acevedocrisologopablo48-lgtm/planta-briquetadora/README.md

# PLANTA BRIQUETADORA · R17

Configurador industrial SESUVECA. R17 incorpora refuerzos geométricos, despieces, BOM conciliada, transmisiones auxiliares, dosificación de diseño y esquema eléctrico funcional.

Emisión desarrollada para revisión de taller. No hay aprobación resistente, eléctrica o de fabricación emitida. Los componentes OEM se conservan; la alternativa15HP/i25 no sustituye la prensa original45kW/8rpm.

Base de diseño:15t/h de carbón seco; agua3–5% y aglomerante2–4%. Son consignas adoptadas, no capacidad comprobada.

Los borradores y revisiones R4–R16 se conservan. Descargas de referencia en r17/: BOM_R17.csv, DOSSIER_R17.pdf, TALLER_R17.dxf y UNIFILAR_R17.svg.

Los datos de usuario se guardan en el navegador; descargarJSON sirve como respaldo.
