acevedocrisologopablo48-lgtm/planta-briquetadora/r32/PLANTA_R32.pdf

## SESUVECA / PLANTA BRIQUETADORA

### DISPOSICION Y ALTURAS

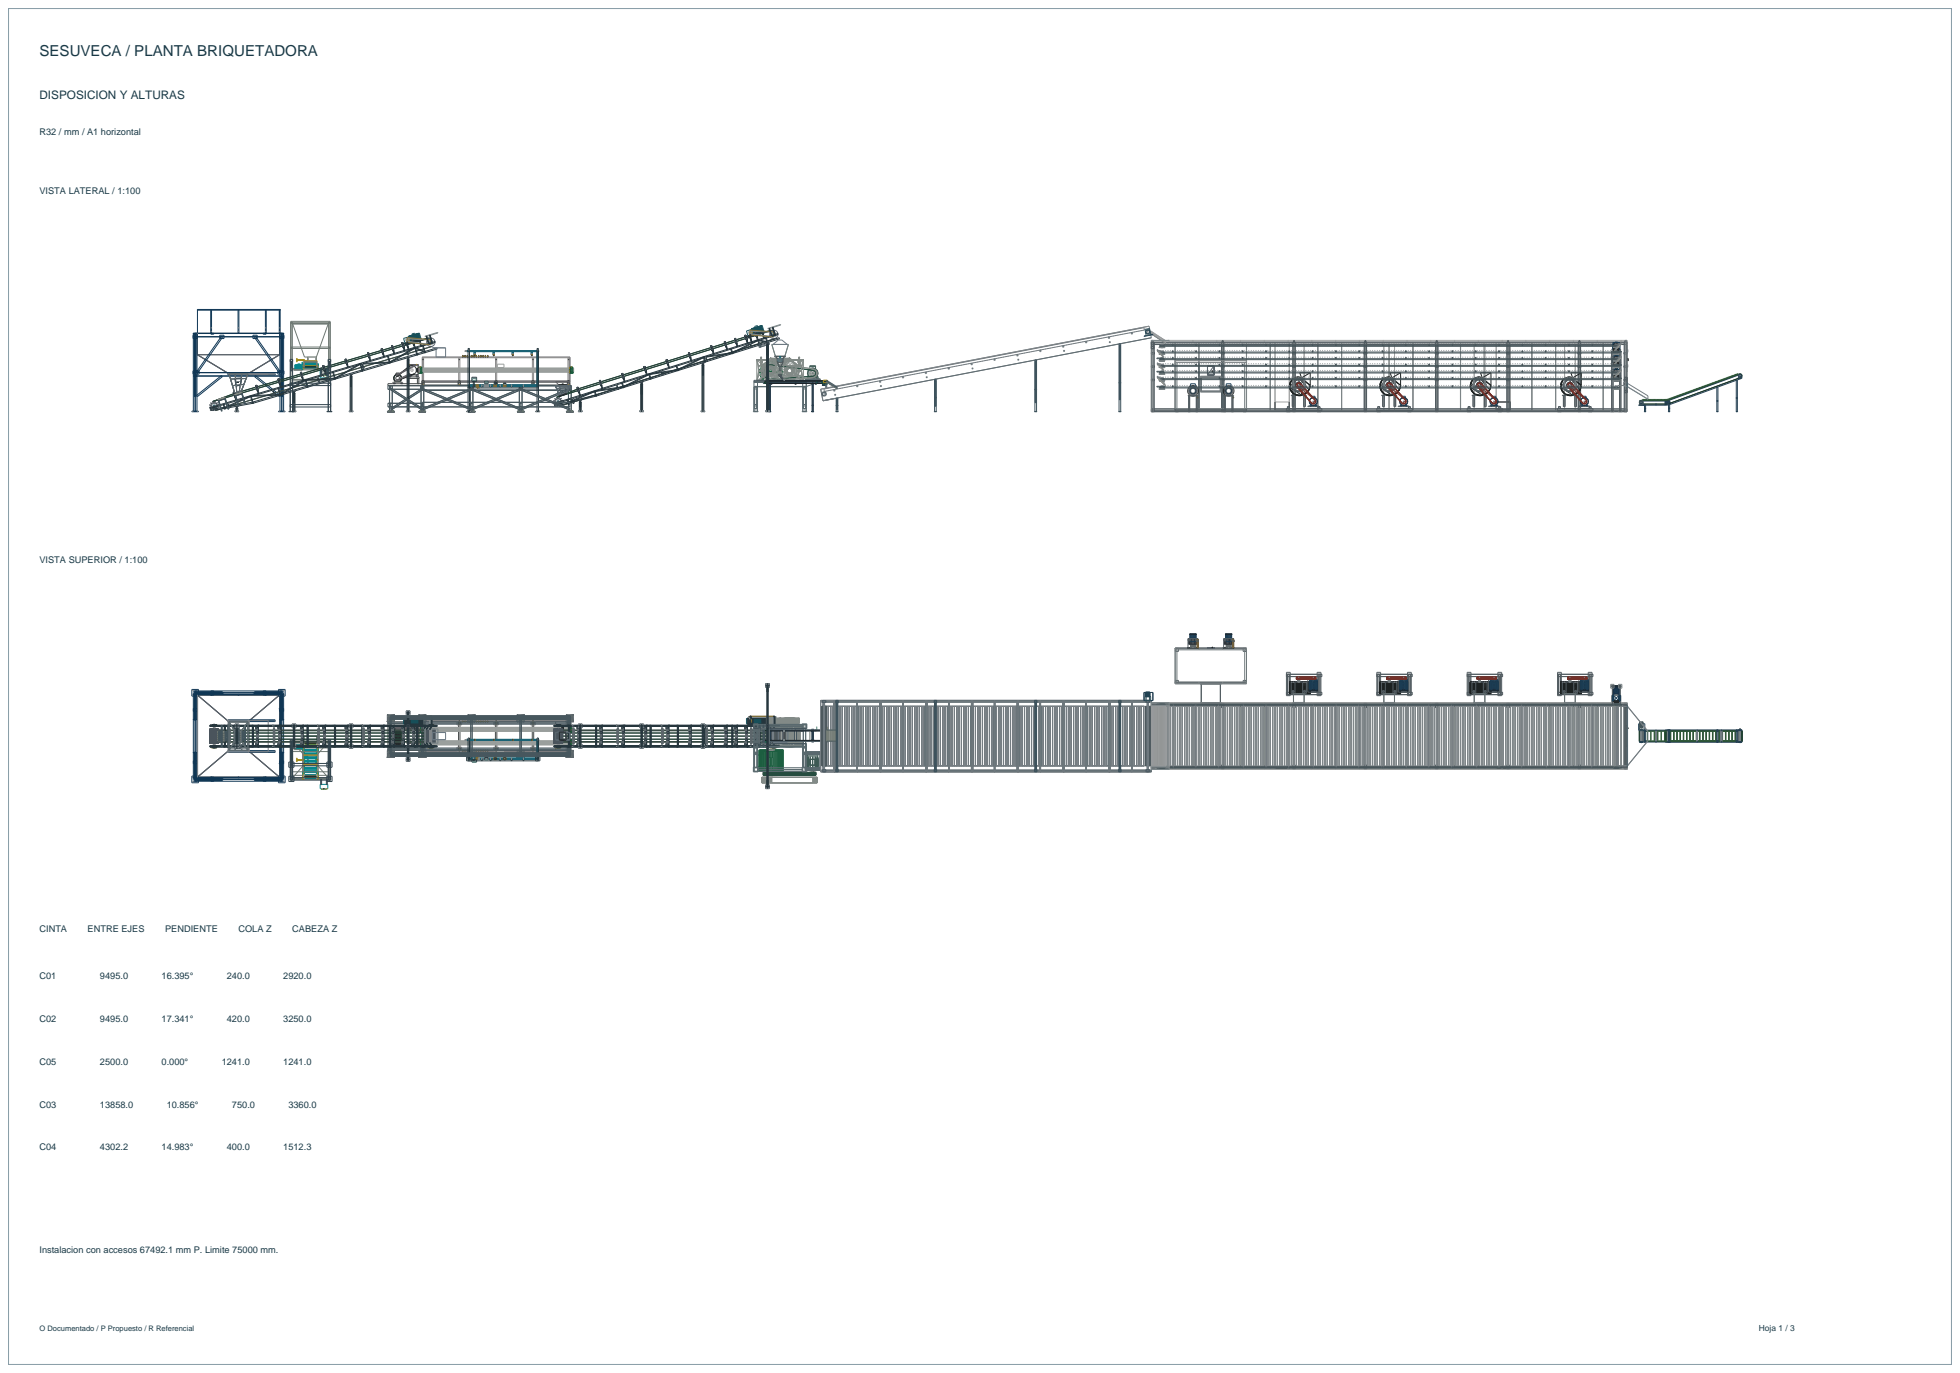
[picture p1: page 1]

Instalacion con accesos 67492.1 mm P. Limite 75000 mm.

### TRANSFERENCIAS DE MATERIAL

R32 / mm / A1 horizontal

ENTRADA DE MEZCLADORA / 1:35 | COLECTORA C05 / C03 / 1:10

C01-mix / origen +2685.0 / receptor +2300.0 / desnivel 385.0 mm P

mix-C02 / origen +1085.0 / receptor +691.2 / desnivel 393.8 mm P

C02-briq / origen +3015.0 / receptor +2830.0 / desnivel 185.0 mm P

C05-C03 / origen +1267.5 / receptor +957.3 / desnivel 310.2 mm P

C03-dry / origen +3368.7 / receptor +2850.0 / desnivel 518.7 mm P

dry-C04 / origen +529.0 / receptor +481.0 / desnivel 48.0 mm P

C05-C03 / captura a 14.5 mm del desprendimiento / labio 12.0 mm sobre banda P.

### APOYOS VERTICALES

R32 / mm / A1 horizontal

C01 / APOYO TRANSVERSAL / 1:20 | C02 / APOYO TRANSVERSAL / 1:20
C03 / APOYO TRANSVERSAL / 1:20 | C04 / APOYO TRANSVERSAL / 1:20

Columnas paralelas a Z global. Placas apoyadas en Z=0. Cuatro caballetes arriostrados en C03.
