acevedocrisologopablo48-lgtm/planta-briquetadora/r30/PLANTA_R30.pdf

SESUVECA | PLANTA BRIQUETADORA

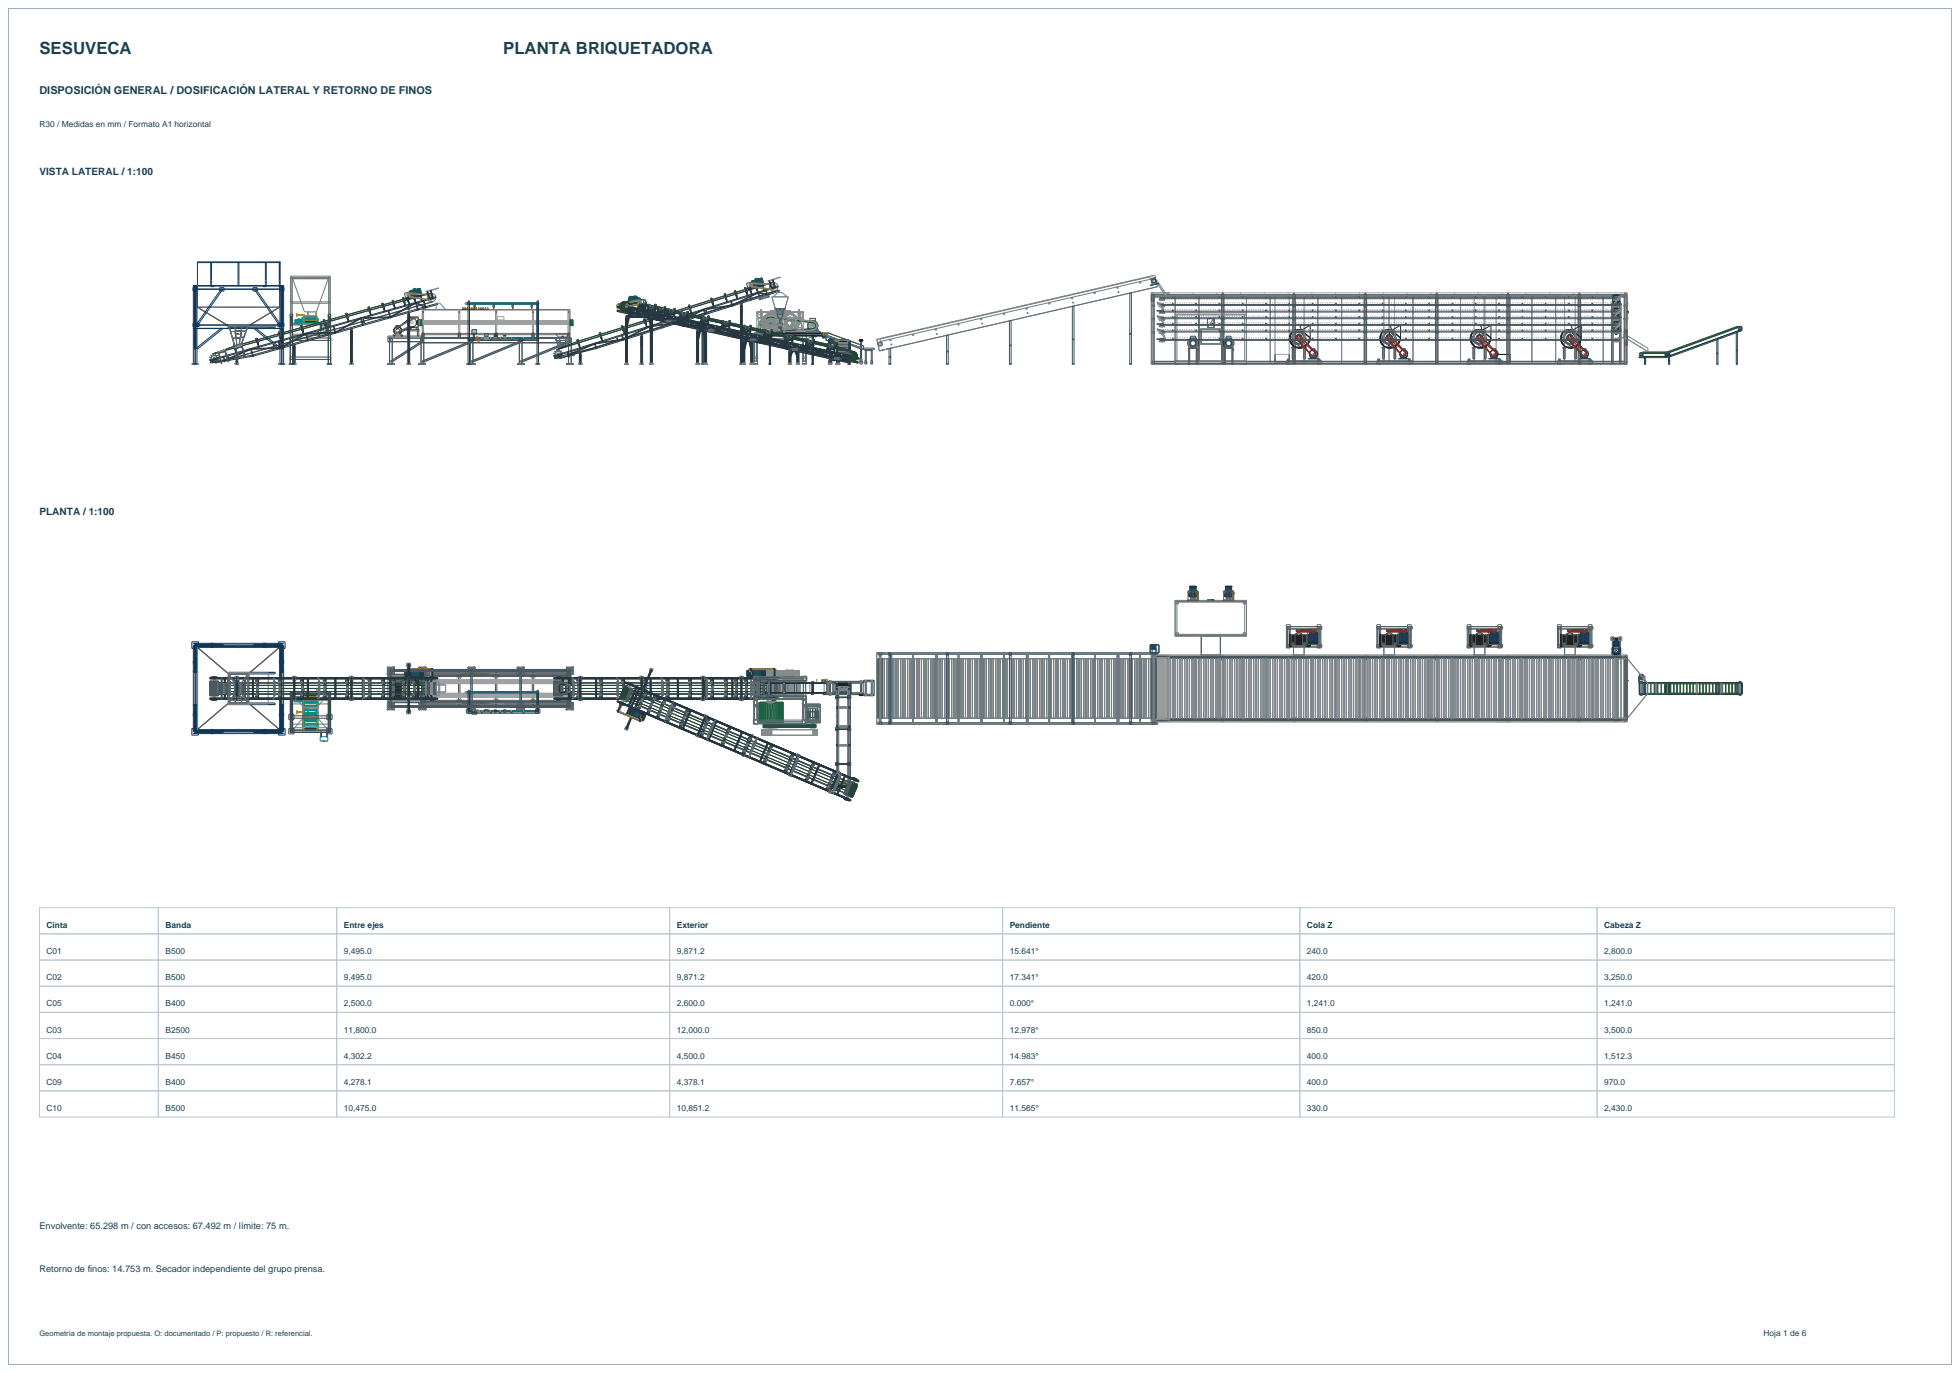
[picture p9: page 1]

DISPOSICIÓN GENERAL / DOSIFICACIÓN LATERAL Y RETORNO DE FINOS

R30 / Medidas en mm / Formato A1 horizontal

Envolvente: 65.298 m / con accesos: 67.492 m / límite: 75 m.

Retorno de finos: 14.753 m. Secador independiente del grupo prensa.

### TOLVA ABIERTA Y DOSIFICADOR LATERAL / DESCARGA DIRECTA

R30 / Medidas en mm / Formato A1 horizontal

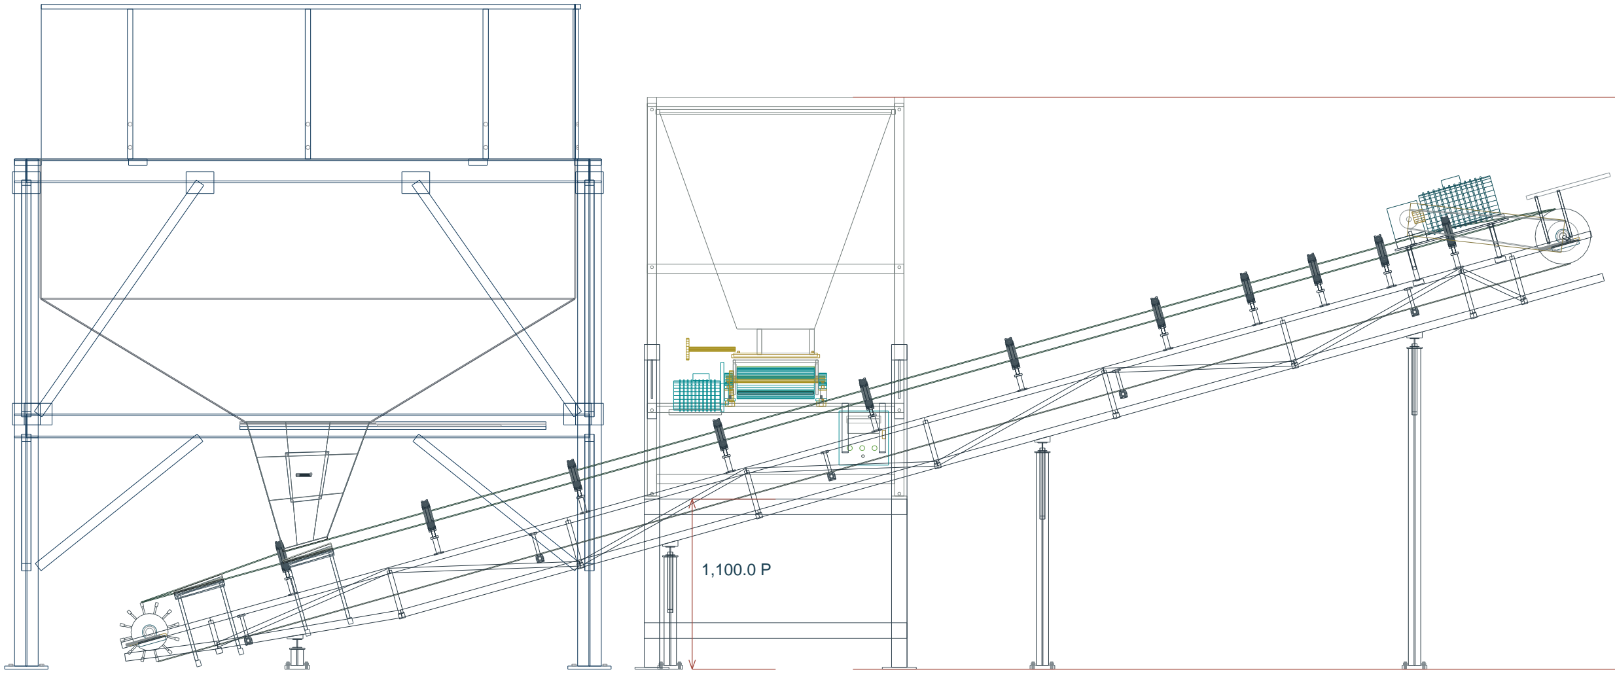
[picture p10: figure]

Geometría de montaje propuesta. O: documentado / P: propuesto / R: referencial. | Hoja 2 de 6

ALZADO LONGITUDINAL / 1:30

3,700.0 P

ALZADO TRANSVERSAL / 1:20

3450 O

Dosificador: X = 5,100.0 / Y = -1,000.0 / giro 180°.
Bancada lateral con ménsulas y cartelas. Los apoyos delanteros inferiores se adaptan para liberar C01.
Se conservan tolva, banda, accionamiento y células de pesaje. Tablero completo reubicado hacia el exterior. Salida propia: +1,775.0 / superficie C01: +1,576.4 / desnivel: 198.6 mm.
Descarga transversal directa. No se añade otra cinta ni una transición rígida entre equipos.

Tolva: boca 3450 x 3450 mm; salida y estructura de R26 conservadas.
Apertura superior de 1000 mm en el lado -X, contrario al avance de C01.
Remate de borde abierto: +3300 mm. Las otras tres paredes superiores llegan a +4300 mm. Retirar panel, rigidizadores y tornillería asociados únicamente al lado abierto.
Mantener acceso exterior al tablero y a la regulación del dosificador.

### PANEL RANURADO DESMONTABLE / CAPTACIÓN BAJO EL BAJANTE

R30 / Medidas en mm / Formato A1 horizontal


Geometría de montaje propuesta. O: documentado / P: propuesto / R: referencial. | Hoja 3 de 6

VISTA NORMAL AL PANEL / 1:2

BAJANTE Y CAPTACIÓN / LATERAL / 1:5

1. Panel de acero inoxidable 304, espesor 6 mm.
2. 96 ranuras longitudinales de 5 x 150 mm; extremos R2,5.
3. 24 columnas, separación libre de 10 mm; cuatro tramos con puentes de 30 mm.
4. Márgenes: 25 mm laterales y 55 mm en los extremos.
5. Bordes desbarbados y superficie enrasada. Fijación desmontable fuera del paso de producto.

El panel ocupa los tramos 250 a 1050 mm del bajante, medidos sobre el plano de 20°. La nariz curva y los tramos lisos de entrada y salida permanecen.
Captación abierta bajo las ranuras: retirar chapa y revestimiento ciegos en esa zona. Salida inferior: 300 x 200 mm, a +540 mm. Acople desmontable hacia C09.
Panel pasivo, sin vibrador. Abertura propuesta; no implica separación completa garantizada.

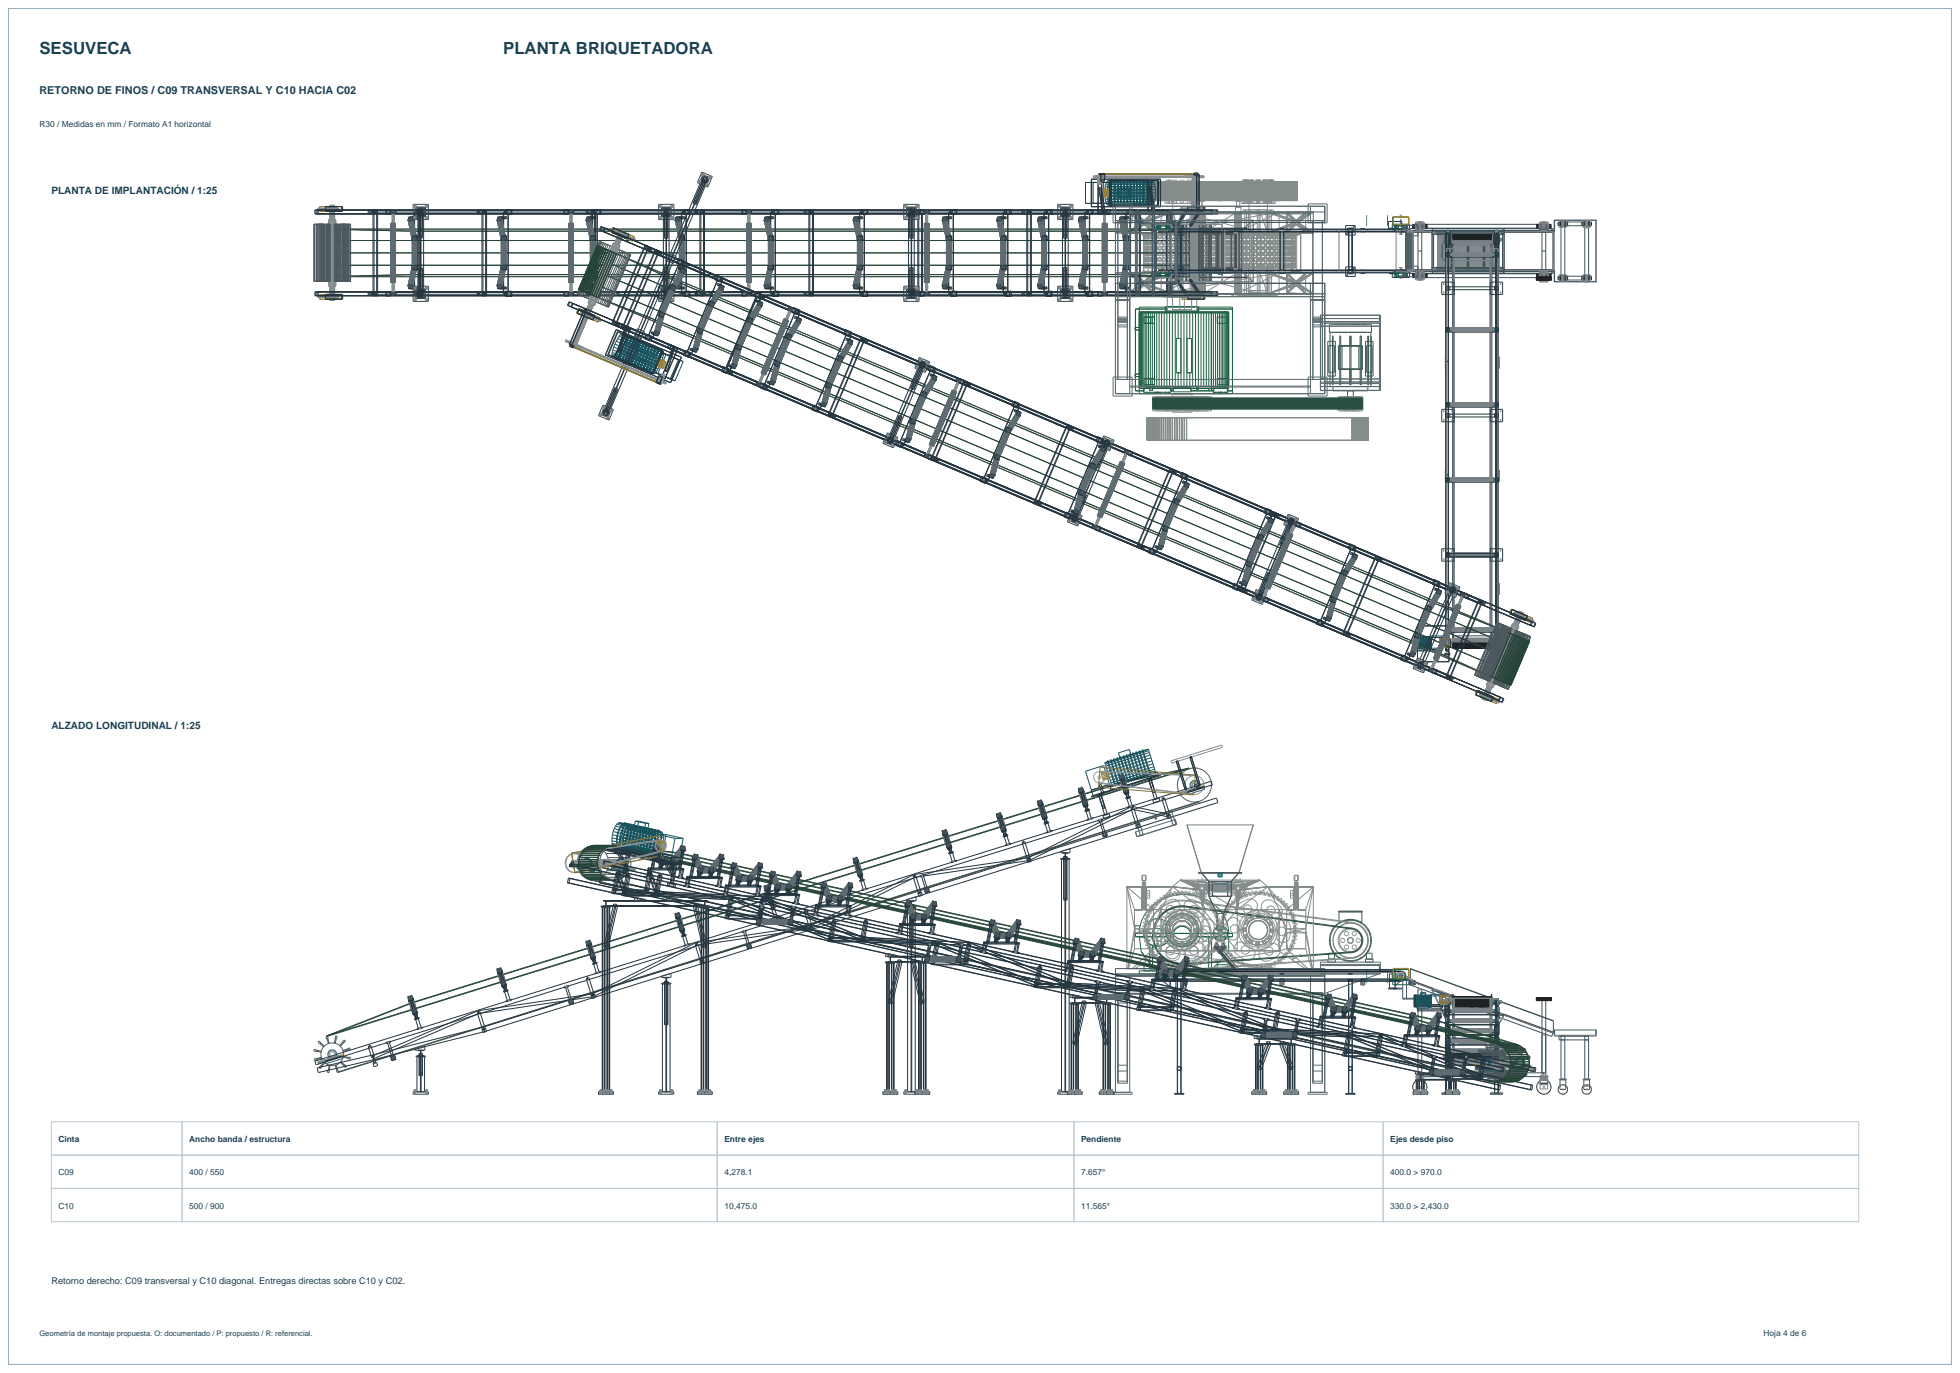
[picture p11: page 4]

RETORNO DE FINOS / C09 TRANSVERSAL Y C10 HACIA C02

R30 / Medidas en mm / Formato A1 horizontal

Retorno derecho: C09 transversal y C10 diagonal. Entregas directas sobre C10 y C02.

### TRANSFERENCIAS Y OPERACIÓN / REFERENCIAS DE MONTAJE

R30 / Medidas en mm / Formato A1 horizontal

Geometría de montaje propuesta. O: documentado / P: propuesto / R: referencial. | Hoja 5 de 6
Encuentro | Referencia geométrica
Salida dosificador / C01 | 1,775.0 > 1,576.4 / descenso 198.6 mm
Captación / C09 | 70.4 mm de descenso
C09 / C10 | 404.8 mm de descenso
C10 / C02 | 1,111.4 mm de descenso
Bajante | 20° / recorrido 1600 mm / panel 800 x 400 x 6 mm
C01 y C02 | 9495 mm entre ejes, longitudes conservadas

RECETA SOBRE CARBÓN NUEVO

Carbón de referencia: 15.000 t/h. Aglomerante: 450.0 kg/h. Agua: 10.0 L/min.

Los finos recuperados vuelven a C02 sin dosificación automática adicional de agua ni aglomerante.

ARRANQUE DEL RETORNO

Con C02 disponible: arrancar C10 y después C09. Una parada del retorno bloquea la alimentación que genera nuevos finos.

La simulación muestra una fracción ilustrativa de finos cruzando las ranuras y regresando a la prensa. No representa un rendimiento de separación ni una capacidad de producción medida.

Se conservan las alternativas anteriores; los valores de esta carpeta corresponden a la geometría R30.

### SECADOR / TRANSPORTADORES PROPIOS

R30 / Medidas en mm / Formato A1 horizontal

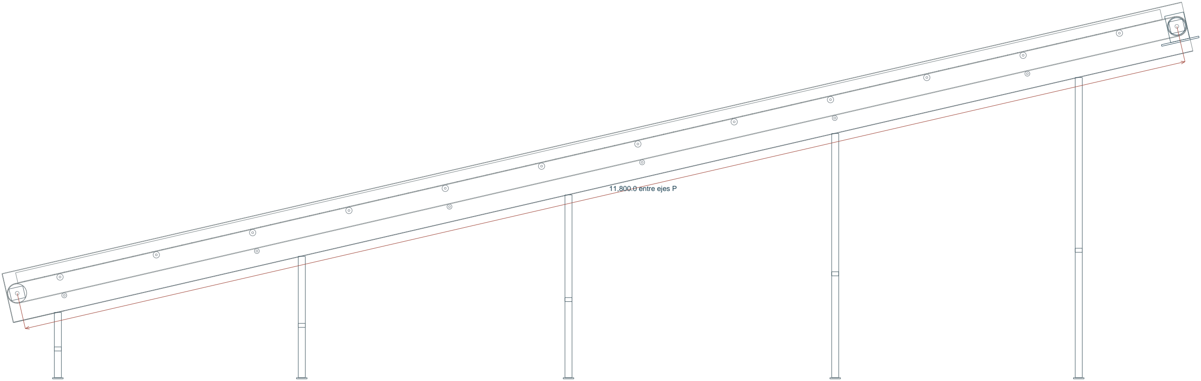
[picture p12: figure]
11,800.0 entre ejes P
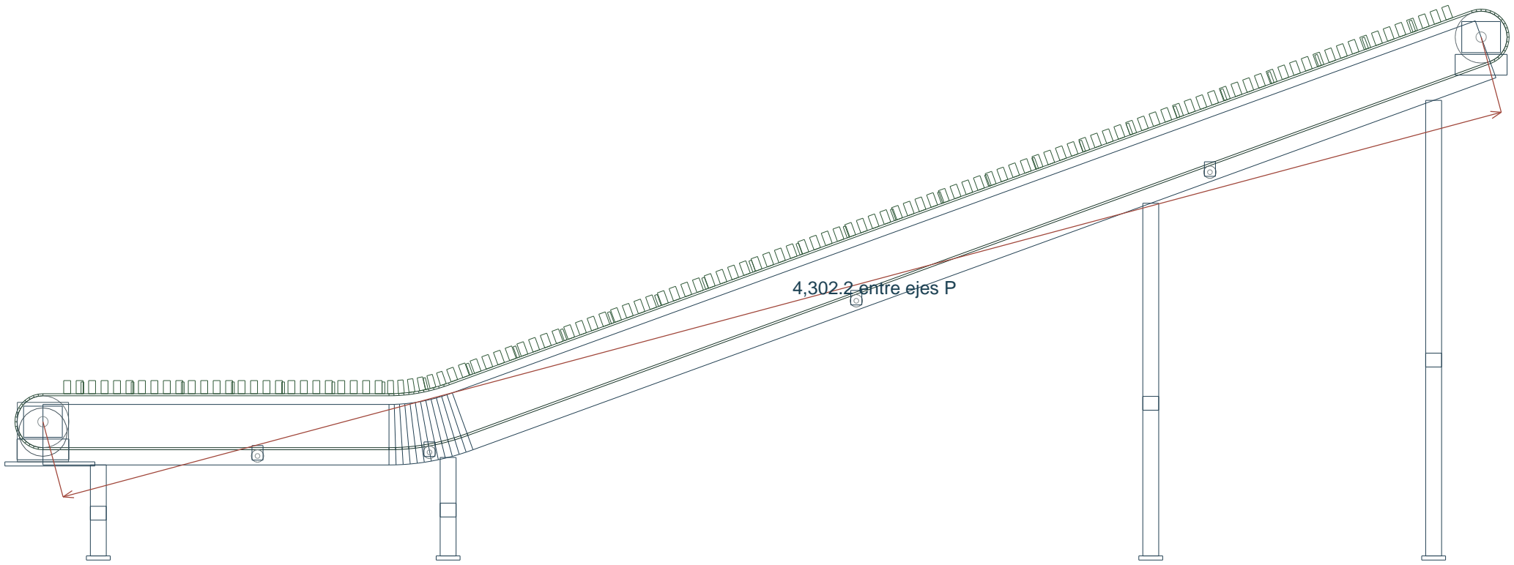
[picture p13: figure]
4,302.2 entre ejes P

Geometría de montaje propuesta. O: documentado / P: propuesto / R: referencial. | Hoja 6 de 6

### C03 · CARGA DE MALLA INOXIDABLE / ALZADO 1:20

Envolvente nominal de ficha: 12 000 × 3 000 × 500 mm. Malla útil de 2 500 mm.

### C04 · DESCARGA LONGITUDINAL / ALZADO 1:15

Envolvente nominal de ficha: 4 500 × 500 × 400 mm.

Desarrollo entre ejes: 4,350.0 mm. Banda útil: 450 mm.

Recepción horizontal y tramo inclinado a 20.0° P.

Caída del labio a la banda: 48.0 mm. Holgura a perfiles: 6.0 mm P.

Canal convergente para la salida del secador. Abertura de paso por comprobar.
