acevedocrisologopablo48-lgtm/planta-briquetadora/r29/PLANTA_R29.pdf

SESUVECA | PLANTA BRIQUETADORA

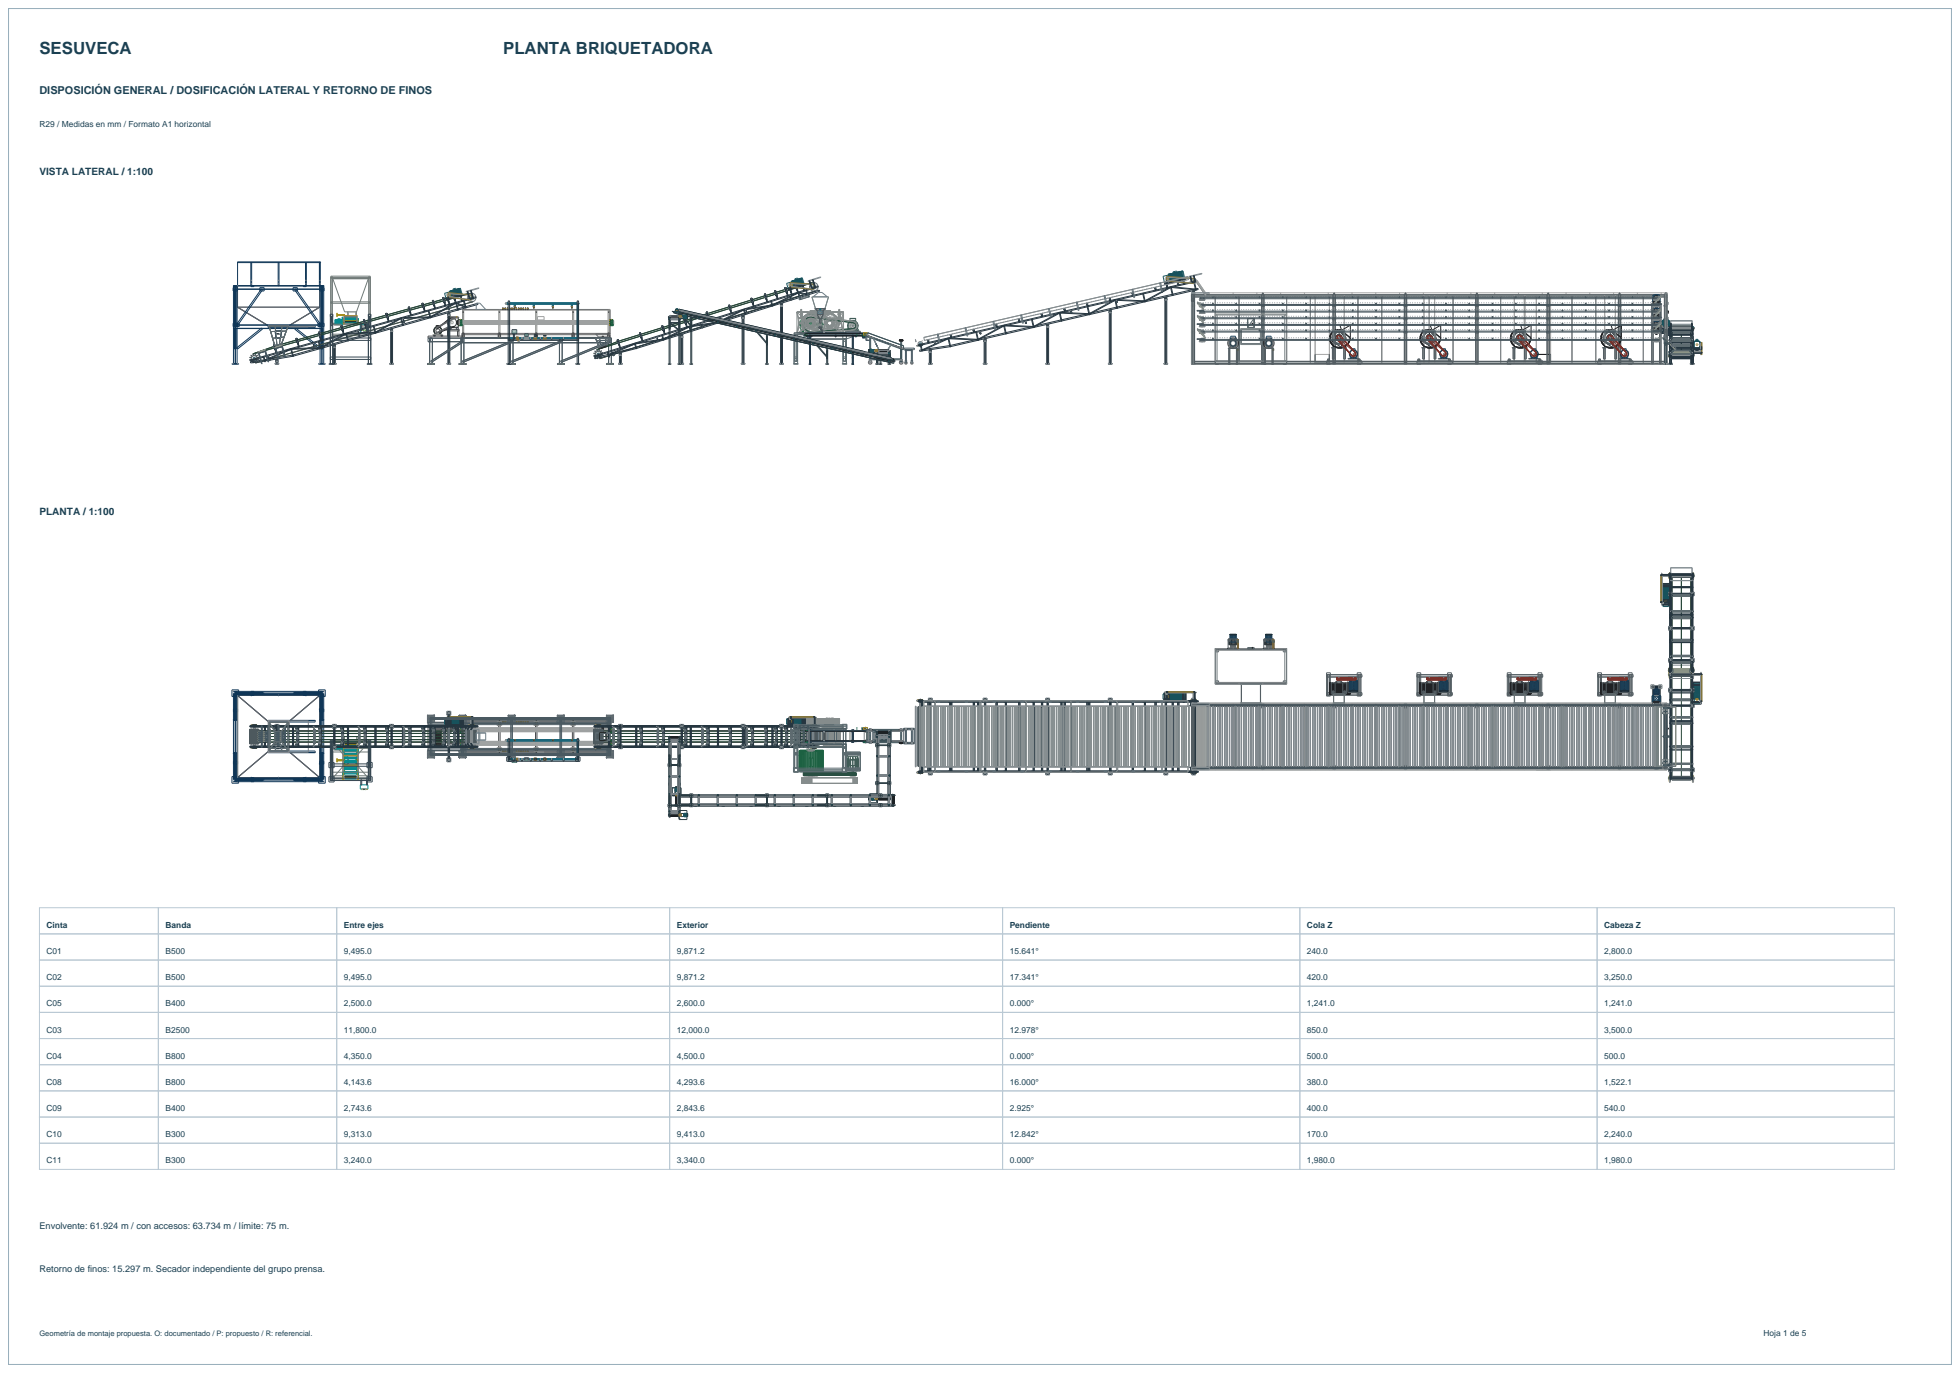
[picture p14: page 1]

DISPOSICIÓN GENERAL / DOSIFICACIÓN LATERAL Y RETORNO DE FINOS

R29 / Medidas en mm / Formato A1 horizontal

Envolvente: 61.924 m / con accesos: 63.734 m / límite: 75 m.

Retorno de finos: 15.297 m. Secador independiente del grupo prensa.

### TOLVA ABIERTA Y DOSIFICADOR LATERAL / DESCARGA DIRECTA

R29 / Medidas en mm / Formato A1 horizontal

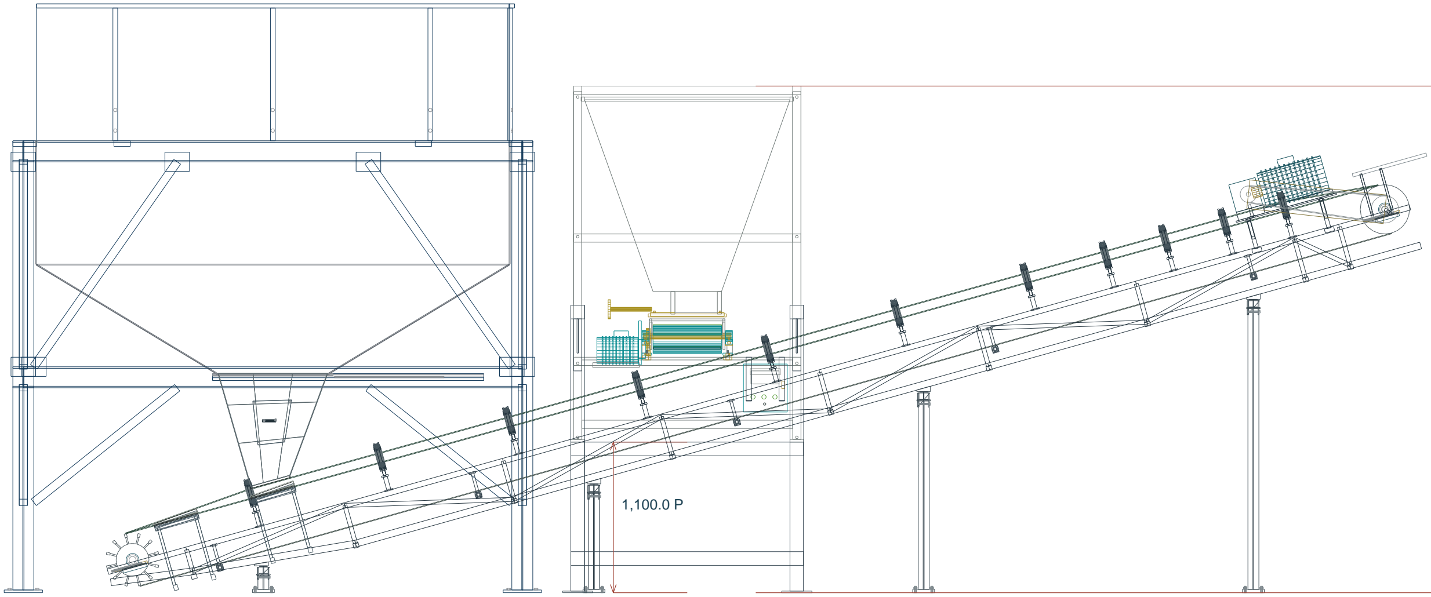
[picture p15: figure]

Geometría de montaje propuesta. O: documentado / P: propuesto / R: referencial. | Hoja 2 de 5

ALZADO LONGITUDINAL / 1:30

3,700.0 P

ALZADO TRANSVERSAL / 1:20

3450 O

Dosificador: X = 5,100.0 / Y = -1,000.0 / giro 180°.
Bancada lateral con ménsulas y cartelas. Los apoyos delanteros inferiores se adaptan para liberar C01.
Se conservan tolva, banda, accionamiento y células de pesaje. Tablero completo reubicado hacia el exterior. Salida propia: +1,775.0 / superficie C01: +1,576.4 / desnivel: 198.6 mm.
Descarga transversal directa. No se añade otra cinta ni una transición rígida entre equipos.

Tolva: boca 3450 x 3450 mm; salida y estructura de R26 conservadas.
Apertura superior de 1000 mm en el lado -X, contrario al avance de C01.
Remate de borde abierto: +3300 mm. Las otras tres paredes superiores llegan a +4300 mm. Retirar panel, rigidizadores y tornillería asociados únicamente al lado abierto.
Mantener acceso exterior al tablero y a la regulación del dosificador.

### PANEL RANURADO DESMONTABLE / CAPTACIÓN BAJO EL BAJANTE

R29 / Medidas en mm / Formato A1 horizontal


Geometría de montaje propuesta. O: documentado / P: propuesto / R: referencial. | Hoja 3 de 5

VISTA NORMAL AL PANEL / 1:2

BAJANTE Y CAPTACIÓN / LATERAL / 1:5

1. Panel de acero inoxidable 304, espesor 6 mm.
2. 96 ranuras longitudinales de 5 x 150 mm; extremos R2,5.
3. 24 columnas, separación libre de 10 mm; cuatro tramos con puentes de 30 mm.
4. Márgenes: 25 mm laterales y 55 mm en los extremos.
5. Bordes desbarbados y superficie enrasada. Fijación desmontable fuera del paso de producto.

El panel ocupa los tramos 250 a 1050 mm del bajante, medidos sobre el plano de 20°. La nariz curva y los tramos lisos de entrada y salida permanecen.
Captación abierta bajo las ranuras: retirar chapa y revestimiento ciegos en esa zona. Salida inferior: 300 x 200 mm, a +540 mm. Acople desmontable hacia C09.
Panel pasivo, sin vibrador. Abertura propuesta; no implica separación completa garantizada.

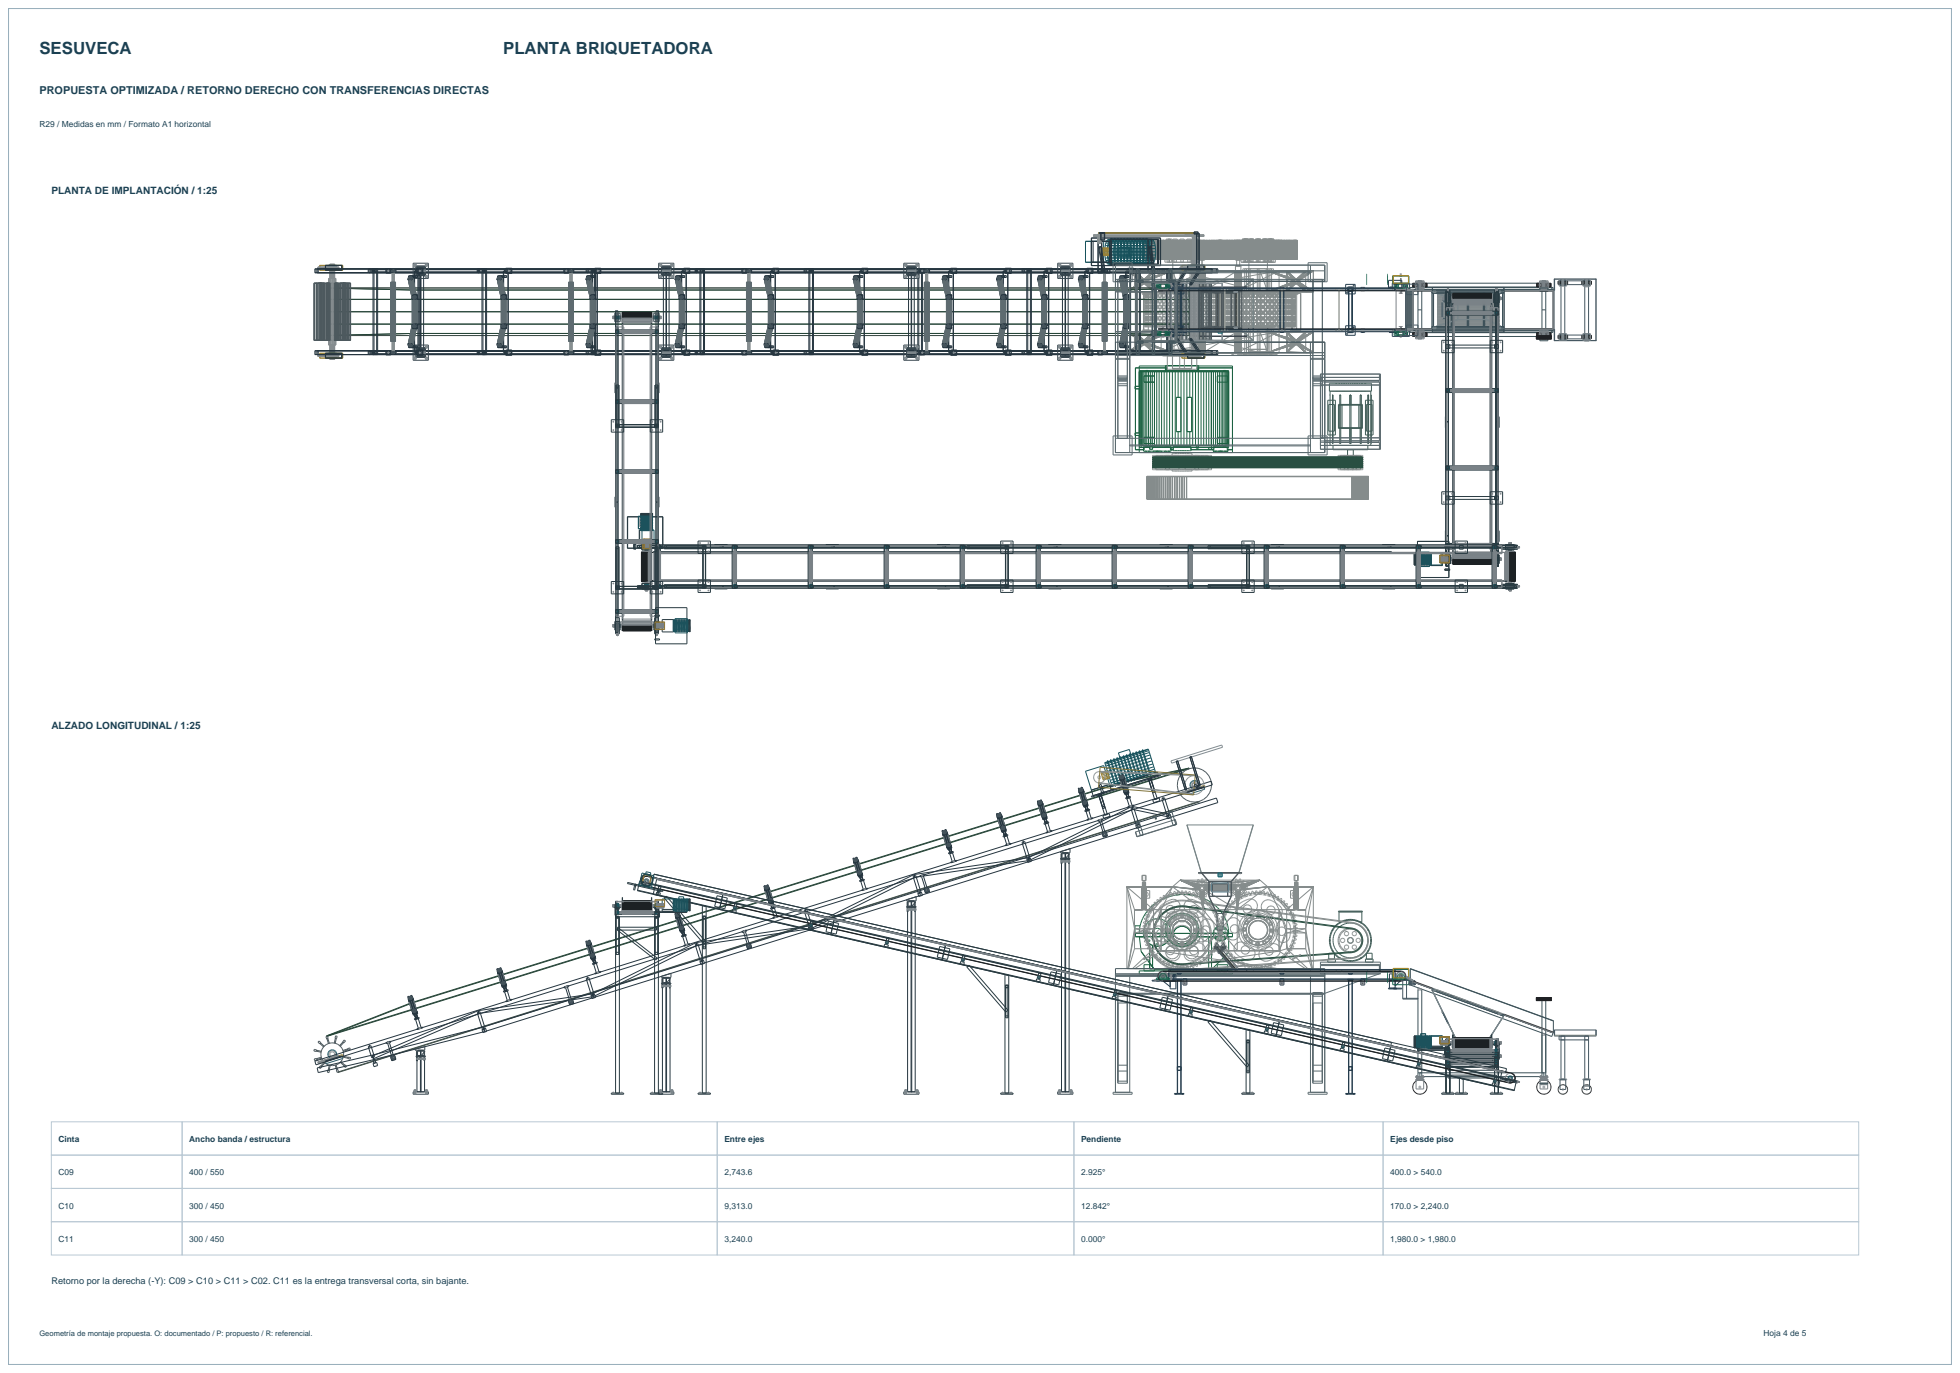
[picture p16: page 4]

PROPUESTA OPTIMIZADA / RETORNO DERECHO CON TRANSFERENCIAS DIRECTAS

R29 / Medidas en mm / Formato A1 horizontal

Retorno por la derecha (-Y): C09 > C10 > C11 > C02. C11 es la entrega transversal corta, sin bajante.

### TRANSFERENCIAS Y OPERACIÓN / REFERENCIAS DE MONTAJE

R29 / Medidas en mm / Formato A1 horizontal

Geometría de montaje propuesta. O: documentado / P: propuesto / R: referencial. | Hoja 5 de 5
Encuentro | Referencia geométrica
Salida dosificador / C01 | 1,775.0 > 1,576.4 / descenso 198.6 mm
Captación / C09 | 80.8 mm de descenso
C09 / C10 | 253.3 mm de descenso
C10 / C11 | 243.0 mm / directa
C11 / C02 | 380.5 mm / directa
Bajante | 20° / recorrido 1600 mm / panel 800 x 400 x 6 mm
C01 y C02 | 9495 mm entre ejes, longitudes conservadas

RECETA SOBRE CARBÓN NUEVO

Carbón de referencia: 15.000 t/h. Aglomerante: 450.0 kg/h. Agua: 10.0 L/min.

Los finos recuperados vuelven a C02 sin dosificación automática adicional de agua ni aglomerante.

ARRANQUE DEL RETORNO

Con C02 disponible: C11 > C10 > C09. Si el retorno se detiene, se bloquea la alimentación nueva.

La simulación muestra una fracción ilustrativa de finos cruzando las ranuras y regresando a la prensa. No representa un rendimiento de separación ni una capacidad de producción medida.

Se conservan las alternativas anteriores; los valores de esta carpeta corresponden a la geometría R29.
