acevedocrisologopablo48-lgtm/planta-briquetadora/r27/PLANTA_R27.pdf

SESUVECA | PLANTA BRIQUETADORA

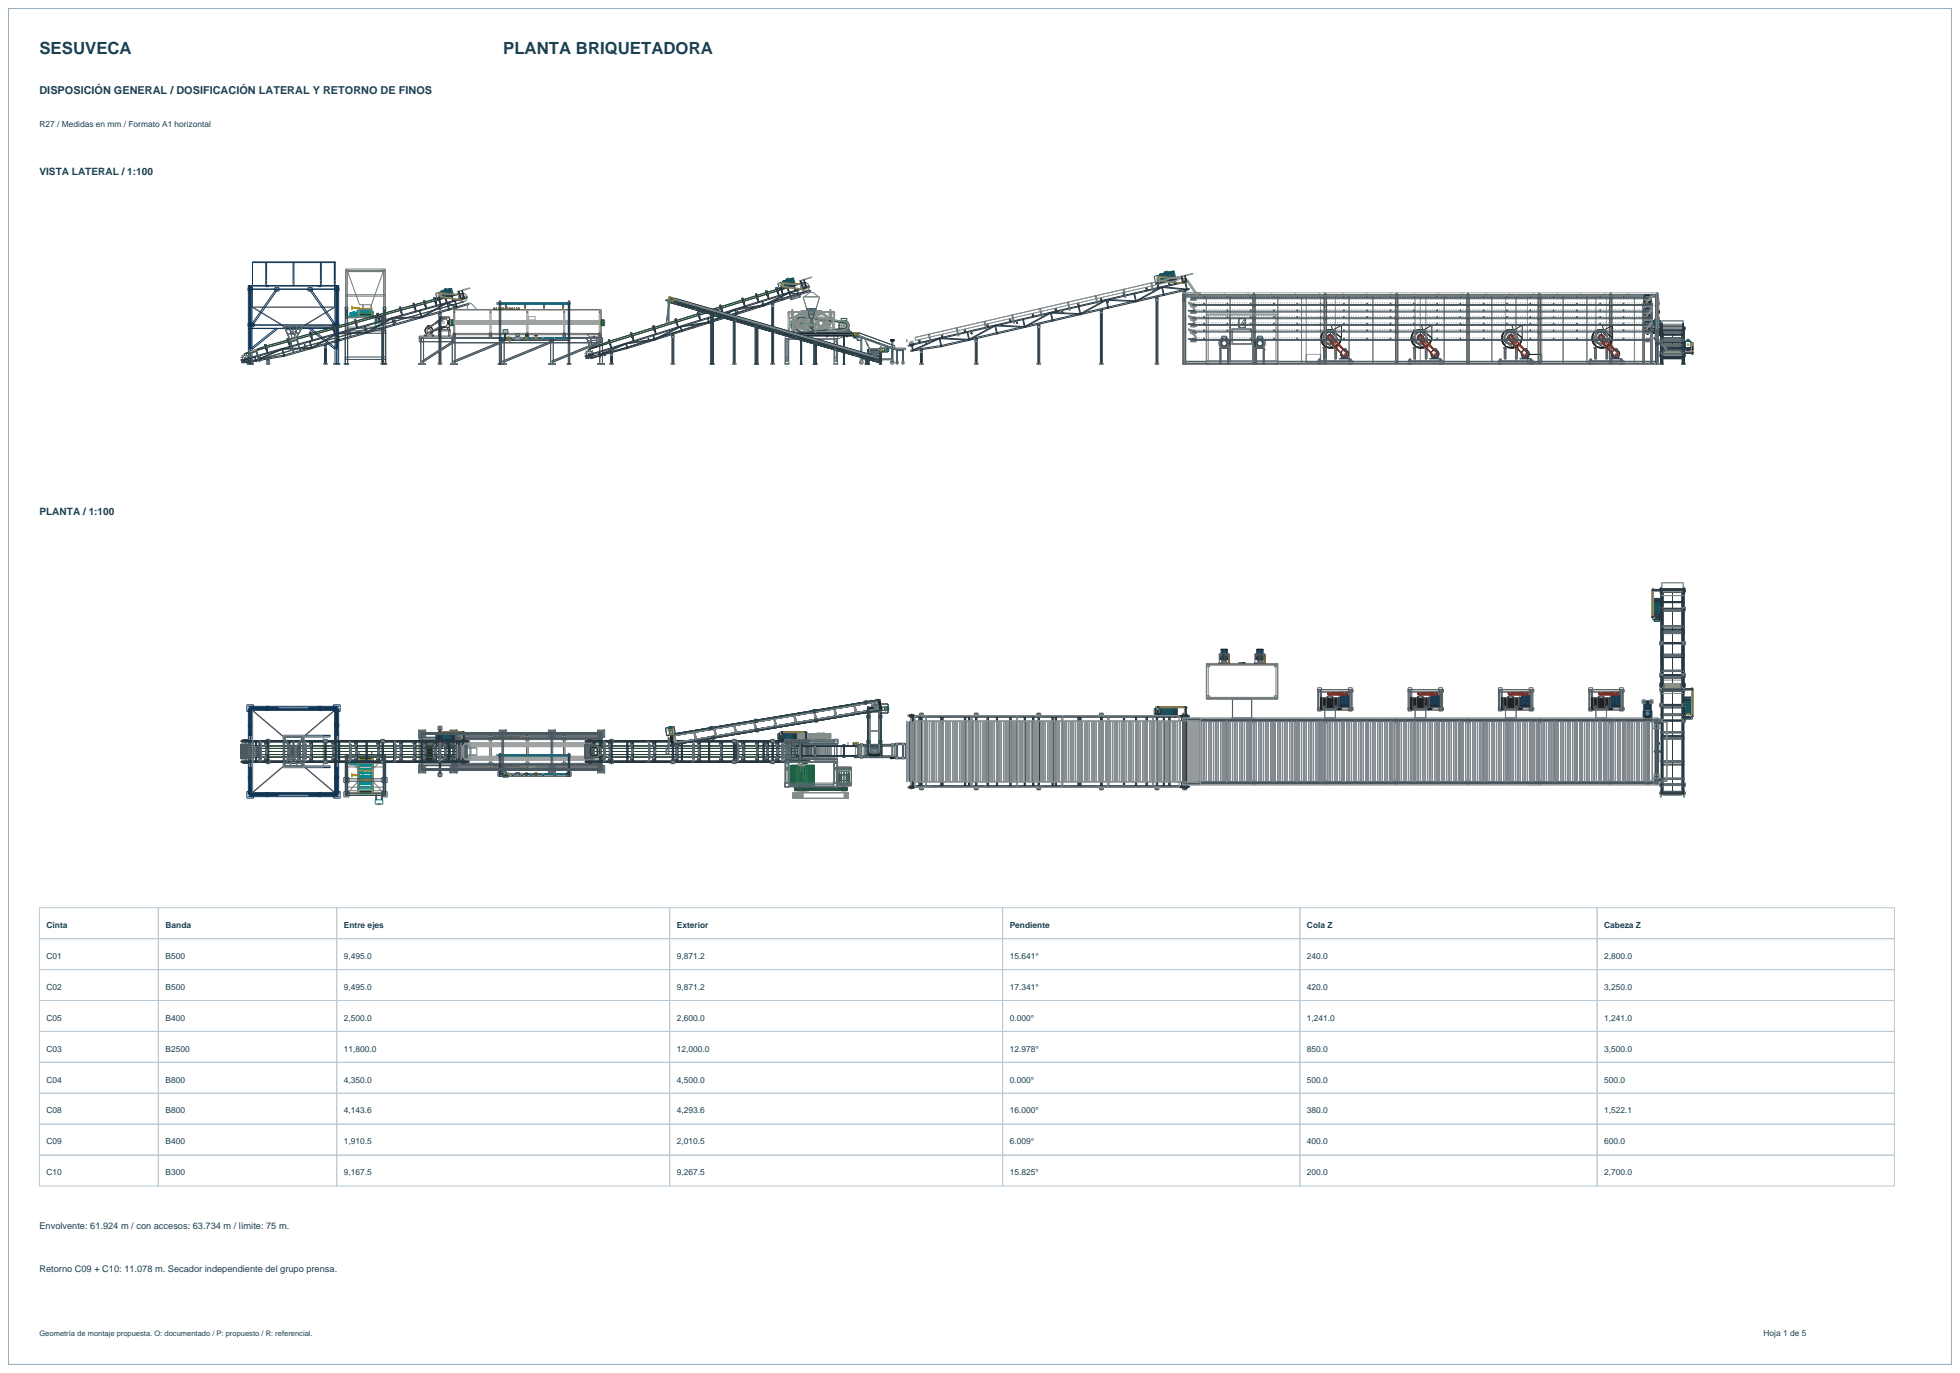
[picture p20: page 1]

DISPOSICIÓN GENERAL / DOSIFICACIÓN LATERAL Y RETORNO DE FINOS

R27 / Medidas en mm / Formato A1 horizontal

Envolvente: 61.924 m / con accesos: 63.734 m / límite: 75 m.

Retorno C09 + C10: 11.078 m. Secador independiente del grupo prensa.

### TOLVA ABIERTA Y DOSIFICADOR LATERAL / DESCARGA DIRECTA

R27 / Medidas en mm / Formato A1 horizontal

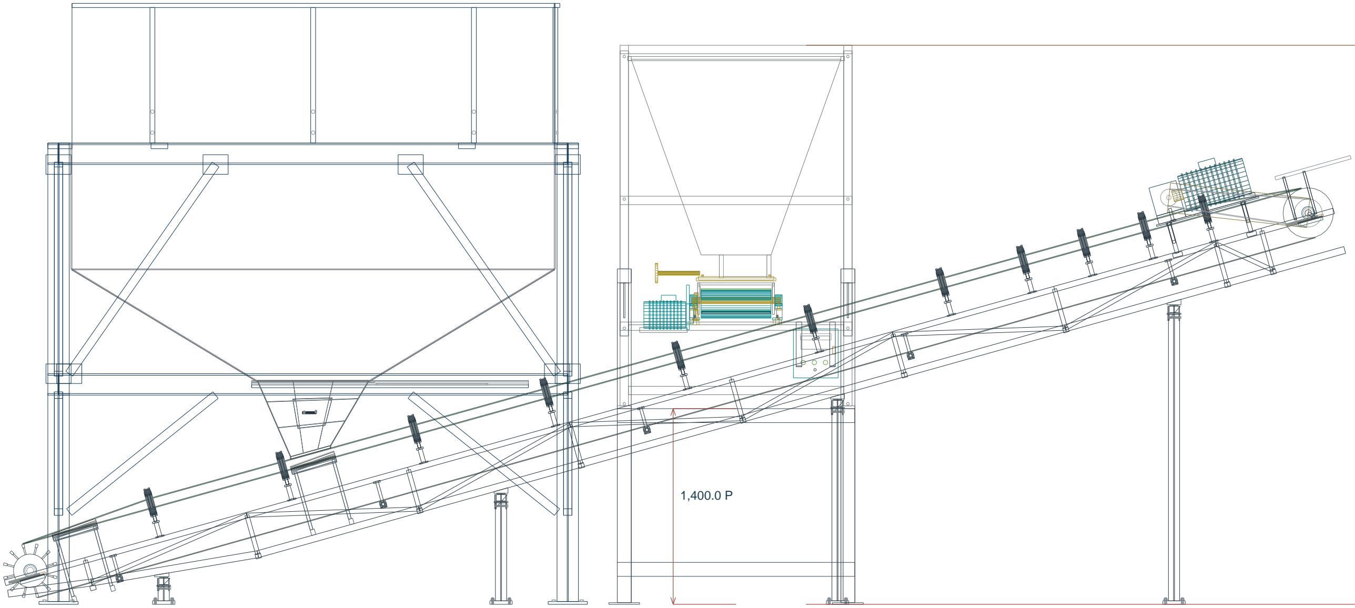
[picture p21: figure]

Geometría de montaje propuesta. O: documentado / P: propuesto / R: referencial. | Hoja 2 de 5

ALZADO LONGITUDINAL / 1:25

4,000.0 P

ALZADO TRANSVERSAL / 1:20

3450 O

Dosificador: X = 6,100.0 / Y = -1,000.0 / giro 180°.
Bancada lateral con ménsulas y cartelas. Los apoyos delanteros inferiores se adaptan para liberar C01.
Se conservan tolva, banda, accionamiento y células de pesaje. Tablero completo reubicado hacia el exterior. Salida propia: +2,075.0 / superficie C01: +1,854.5 / desnivel: 220.5 mm.
Descarga transversal directa. No se añade otra cinta ni una transición rígida entre equipos.

Tolva: boca 3450 x 3450 mm; salida y estructura de R26 conservadas.
Apertura superior de 1000 mm en el lado -X, contrario al avance de C01.
Remate de borde abierto: +3300 mm. Las otras tres paredes superiores llegan a +4300 mm. Retirar panel, rigidizadores y tornillería asociados únicamente al lado abierto.
Mantener acceso exterior al tablero y a la regulación del dosificador.

### PANEL RANURADO DESMONTABLE / CAPTACIÓN BAJO EL BAJANTE

R27 / Medidas en mm / Formato A1 horizontal


Geometría de montaje propuesta. O: documentado / P: propuesto / R: referencial. | Hoja 3 de 5

VISTA NORMAL AL PANEL / 1:2

BAJANTE Y CAPTACIÓN / LATERAL / 1:5

1. Panel de acero inoxidable 304, espesor 6 mm.
2. 96 ranuras longitudinales de 5 x 150 mm; extremos R2,5.
3. 24 columnas, separación libre de 10 mm; cuatro tramos con puentes de 30 mm.
4. Márgenes: 25 mm laterales y 55 mm en los extremos.
5. Bordes desbarbados y superficie enrasada. Fijación desmontable fuera del paso de producto.

El panel ocupa los tramos 250 a 1050 mm del bajante, medidos sobre el plano de 20°. La nariz curva y los tramos lisos de entrada y salida permanecen.
Captación abierta bajo las ranuras: retirar chapa y revestimiento ciegos en esa zona. Salida inferior: 300 x 200 mm, a +540 mm. Acople desmontable hacia C09.
Panel pasivo, sin vibrador. Abertura propuesta; no implica separación completa garantizada.

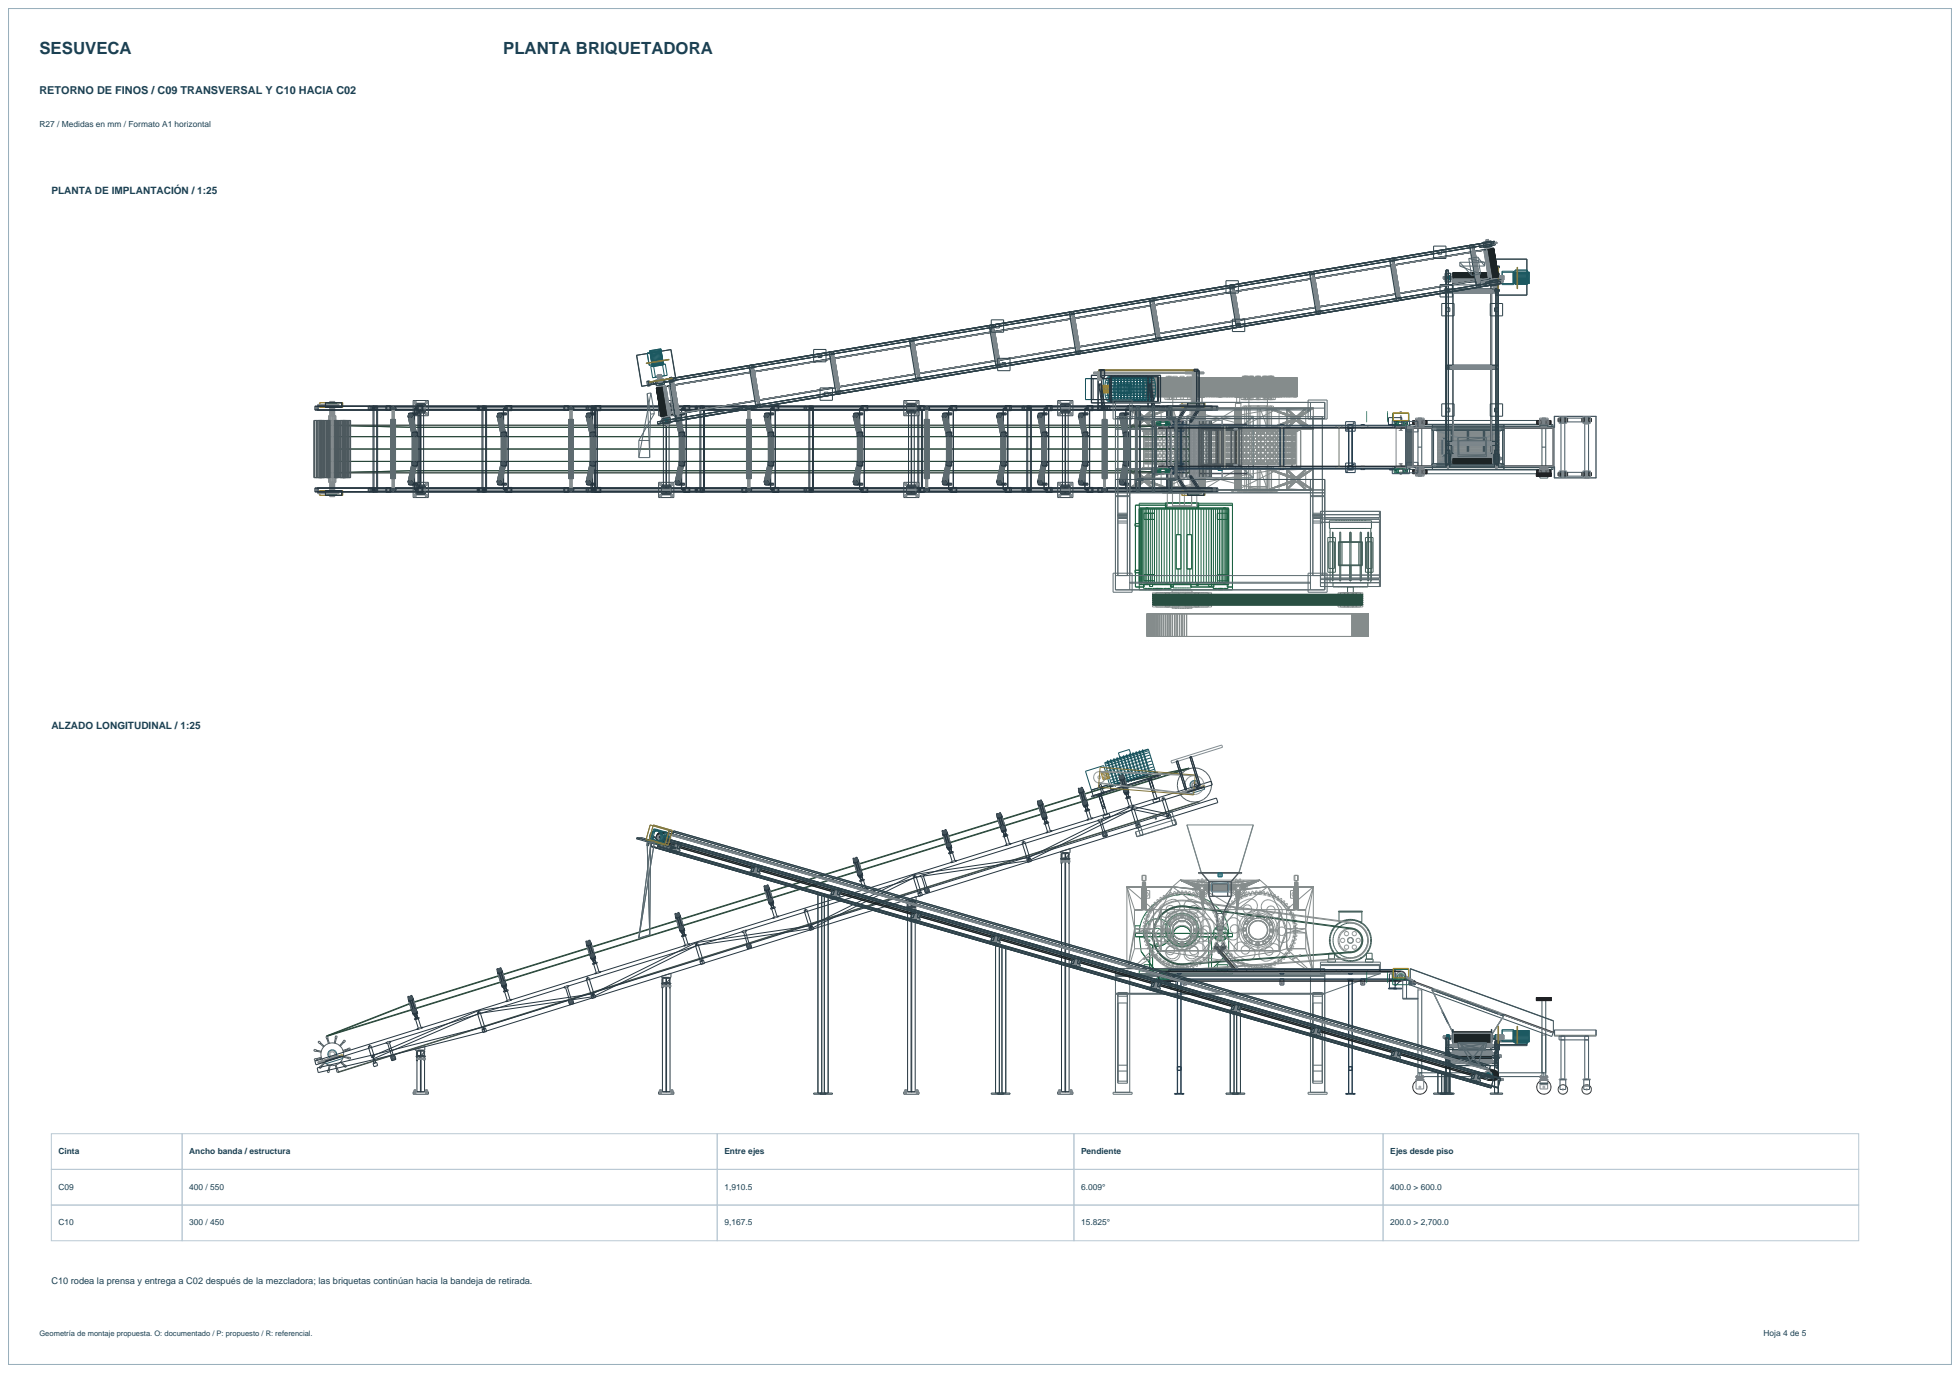
[picture p22: page 4]

RETORNO DE FINOS / C09 TRANSVERSAL Y C10 HACIA C02

R27 / Medidas en mm / Formato A1 horizontal

C10 rodea la prensa y entrega a C02 después de la mezcladora; las briquetas continúan hacia la bandeja de retirada.

### TRANSFERENCIAS Y OPERACIÓN / REFERENCIAS DE MONTAJE

R27 / Medidas en mm / Formato A1 horizontal

Geometría de montaje propuesta. O: documentado / P: propuesto / R: referencial. | Hoja 5 de 5
Encuentro | Referencia geométrica
Salida dosificador / C01 | 2,075.0 > 1,854.5 / descenso 220.5 mm
Captación / C09 | 74.7 mm de descenso
C09 / C10 | 325.6 mm de descenso
C10 / C02 | 1,087.5 mm de descenso
Bajante | 20° / recorrido 1600 mm / panel 800 x 400 x 6 mm
C01 y C02 | 9495 mm entre ejes, longitudes conservadas

RECETA SOBRE CARBÓN NUEVO

Carbón de referencia: 15.000 t/h. Aglomerante: 450.0 kg/h. Agua: 10.0 L/min.

Los finos recuperados vuelven a C02 sin dosificación automática adicional de agua ni aglomerante.

ARRANQUE DEL RETORNO

Con C02 disponible: arrancar C10 y después C09. Una parada del retorno bloquea la alimentación que genera nuevos finos.

La simulación muestra una fracción ilustrativa de finos cruzando las ranuras y regresando a la prensa. No representa un rendimiento de separación ni una capacidad de producción medida.

Se conserva R26 como alternativa independiente; los valores de esta carpeta corresponden a la geometría R27.
