acevedocrisologopablo48-lgtm/planta-briquetadora/r26/PLANTA_R26.pdf

SESUVECA | PLANTA BRIQUETADORA

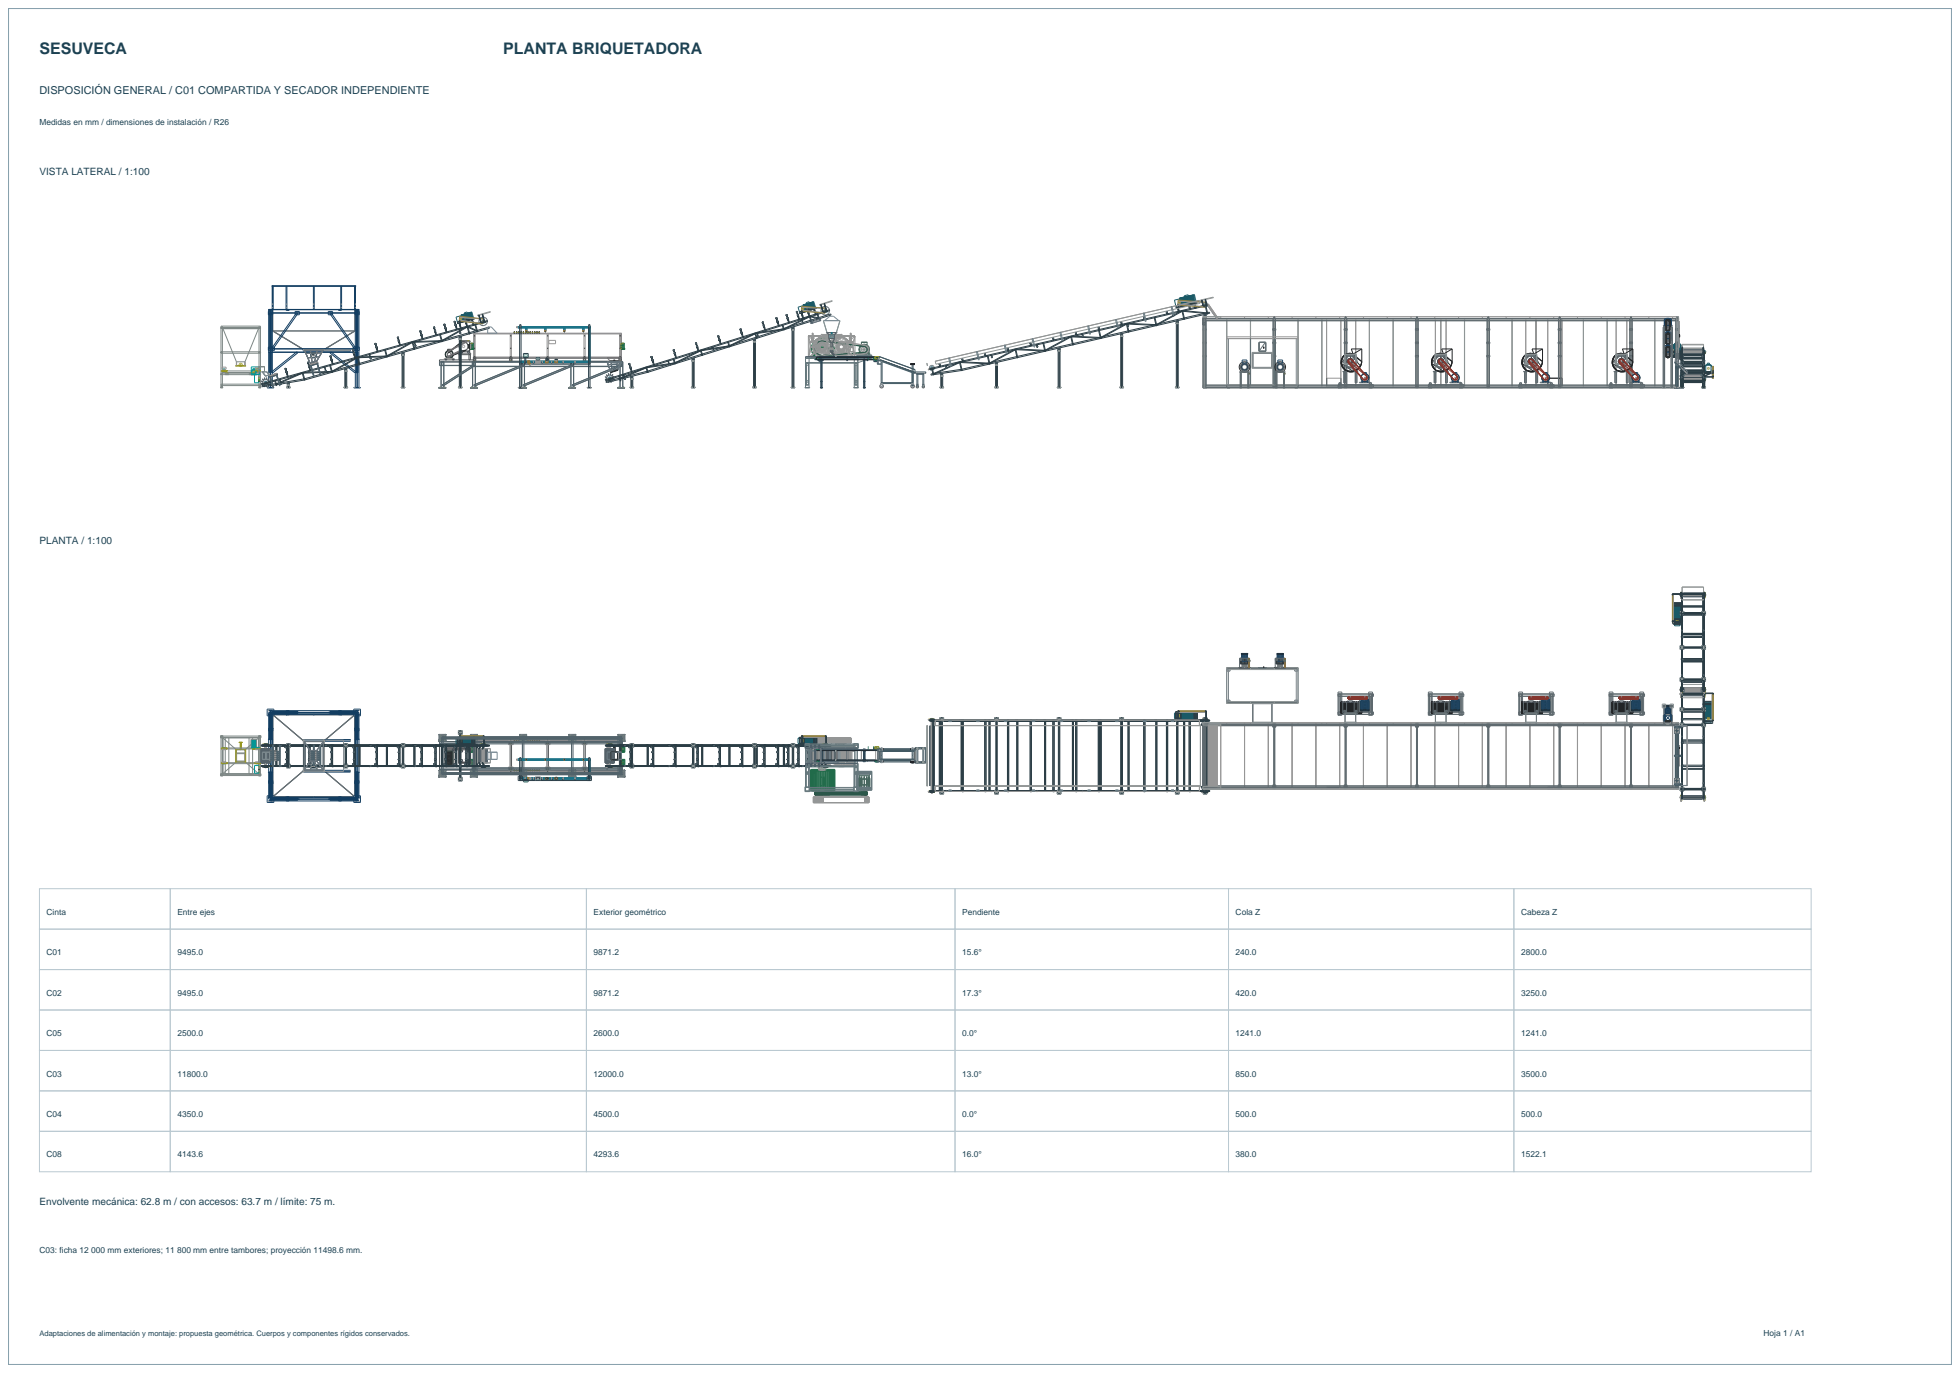
[picture p23: page 1]

DISPOSICIÓN GENERAL / C01 COMPARTIDA Y SECADOR INDEPENDIENTE

Medidas en mm / dimensiones de instalación / R26

Envolvente mecánica: 62.8 m / con accesos: 63.7 m / límite: 75 m.

C03: ficha 12 000 mm exteriores; 11 800 mm entre tambores; proyección 11498.6 mm.

CONJUNTOS MODIFICADOS / ALTURAS DESDE EL PISO

Medidas en mm / dimensiones de instalación / R26

Adaptaciones de alimentación y montaje: propuesta geométrica. Cuerpos y componentes rígidos conservados. | Hoja 2 / A1

BRIQUETADORA Y COLECTORA / LATERAL / 1:20

2330

2830

2500

COLECTORA PLANA / PLANTA / 1:10

B400

Tambores Ø100 / banda plana de 3 mm.

Superficie de carga: 1294.0 mm.

Labio de recepción: 1302.0 mm / separación: 8 mm.

Sólidos del conjunto de taller; soportes independientes.

MEZCLADORA / FRENTE / 1:20

Mezcladora: cuerpo 6200 × 1300 × 1200 mm.

Bancada mezcladora: 1100 mm; entrada directa.

Se retiran la tolva añadida y sus apoyos.

Dosificador: bancada 0 mm / altura total 2600 mm.

Aglomerante sobre C01 antes del carbón.

Agua conectada al cuerpo de mezcla.

BAJANTE MÓVIL / SECADOR INDEPENDIENTE

Medidas en mm / dimensiones de instalación / R26

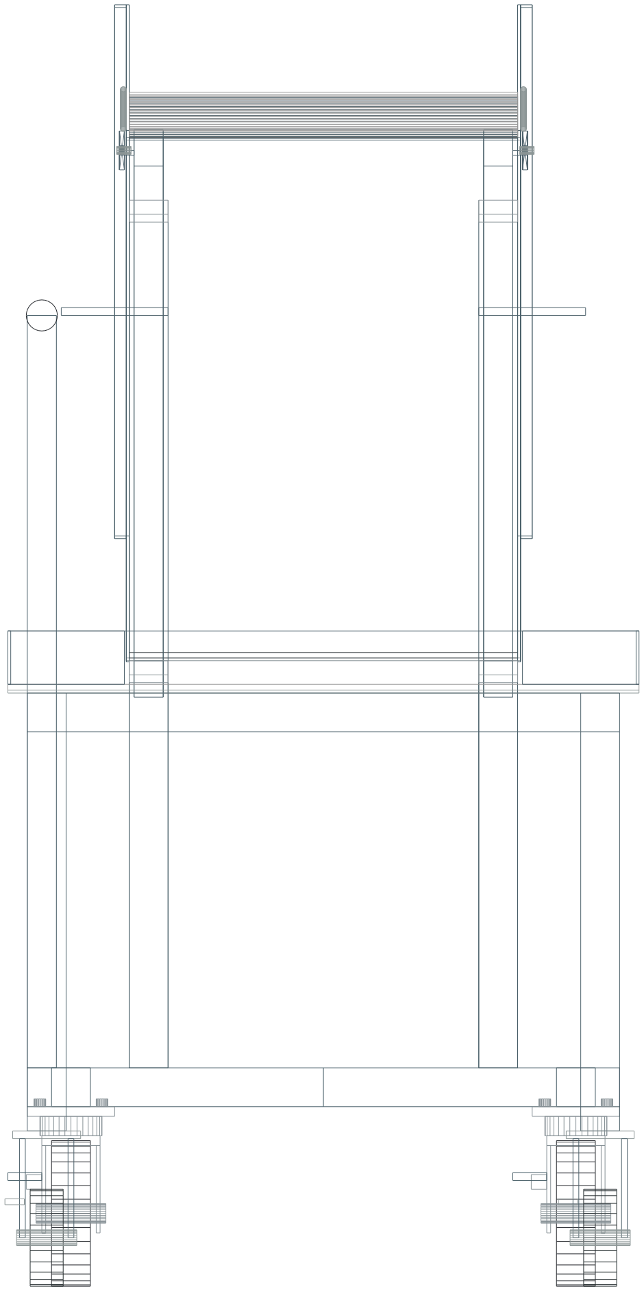
[picture p24: figure]
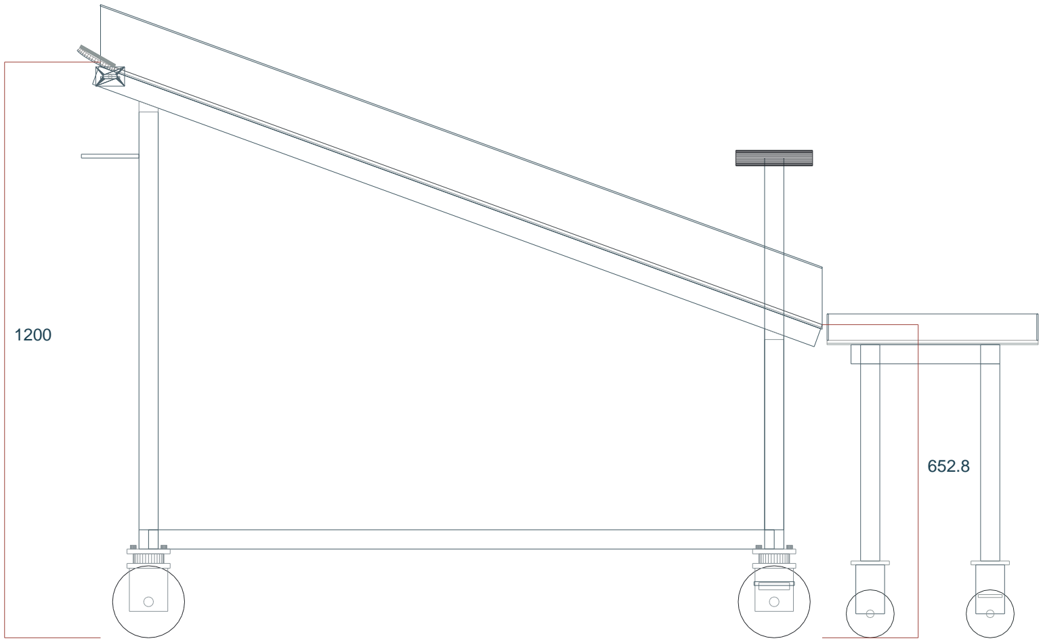
[picture p25: figure]

Adaptaciones de alimentación y montaje: propuesta geométrica. Cuerpos y componentes rígidos conservados. | Hoja 3 / A1

LATERAL / 1:10

FRENTE / 1:5

Canal útil:400 mm / longitud1600 mm / plano20 grados.

Chapa 3 mm + revestimiento UHMW 6 mm.

Cuatro ruedas de 150 mm; dos con freno.

El conjunto se retira o desplaza independientemente.

No existe unión directa entre C05 y el alimentador del secador.

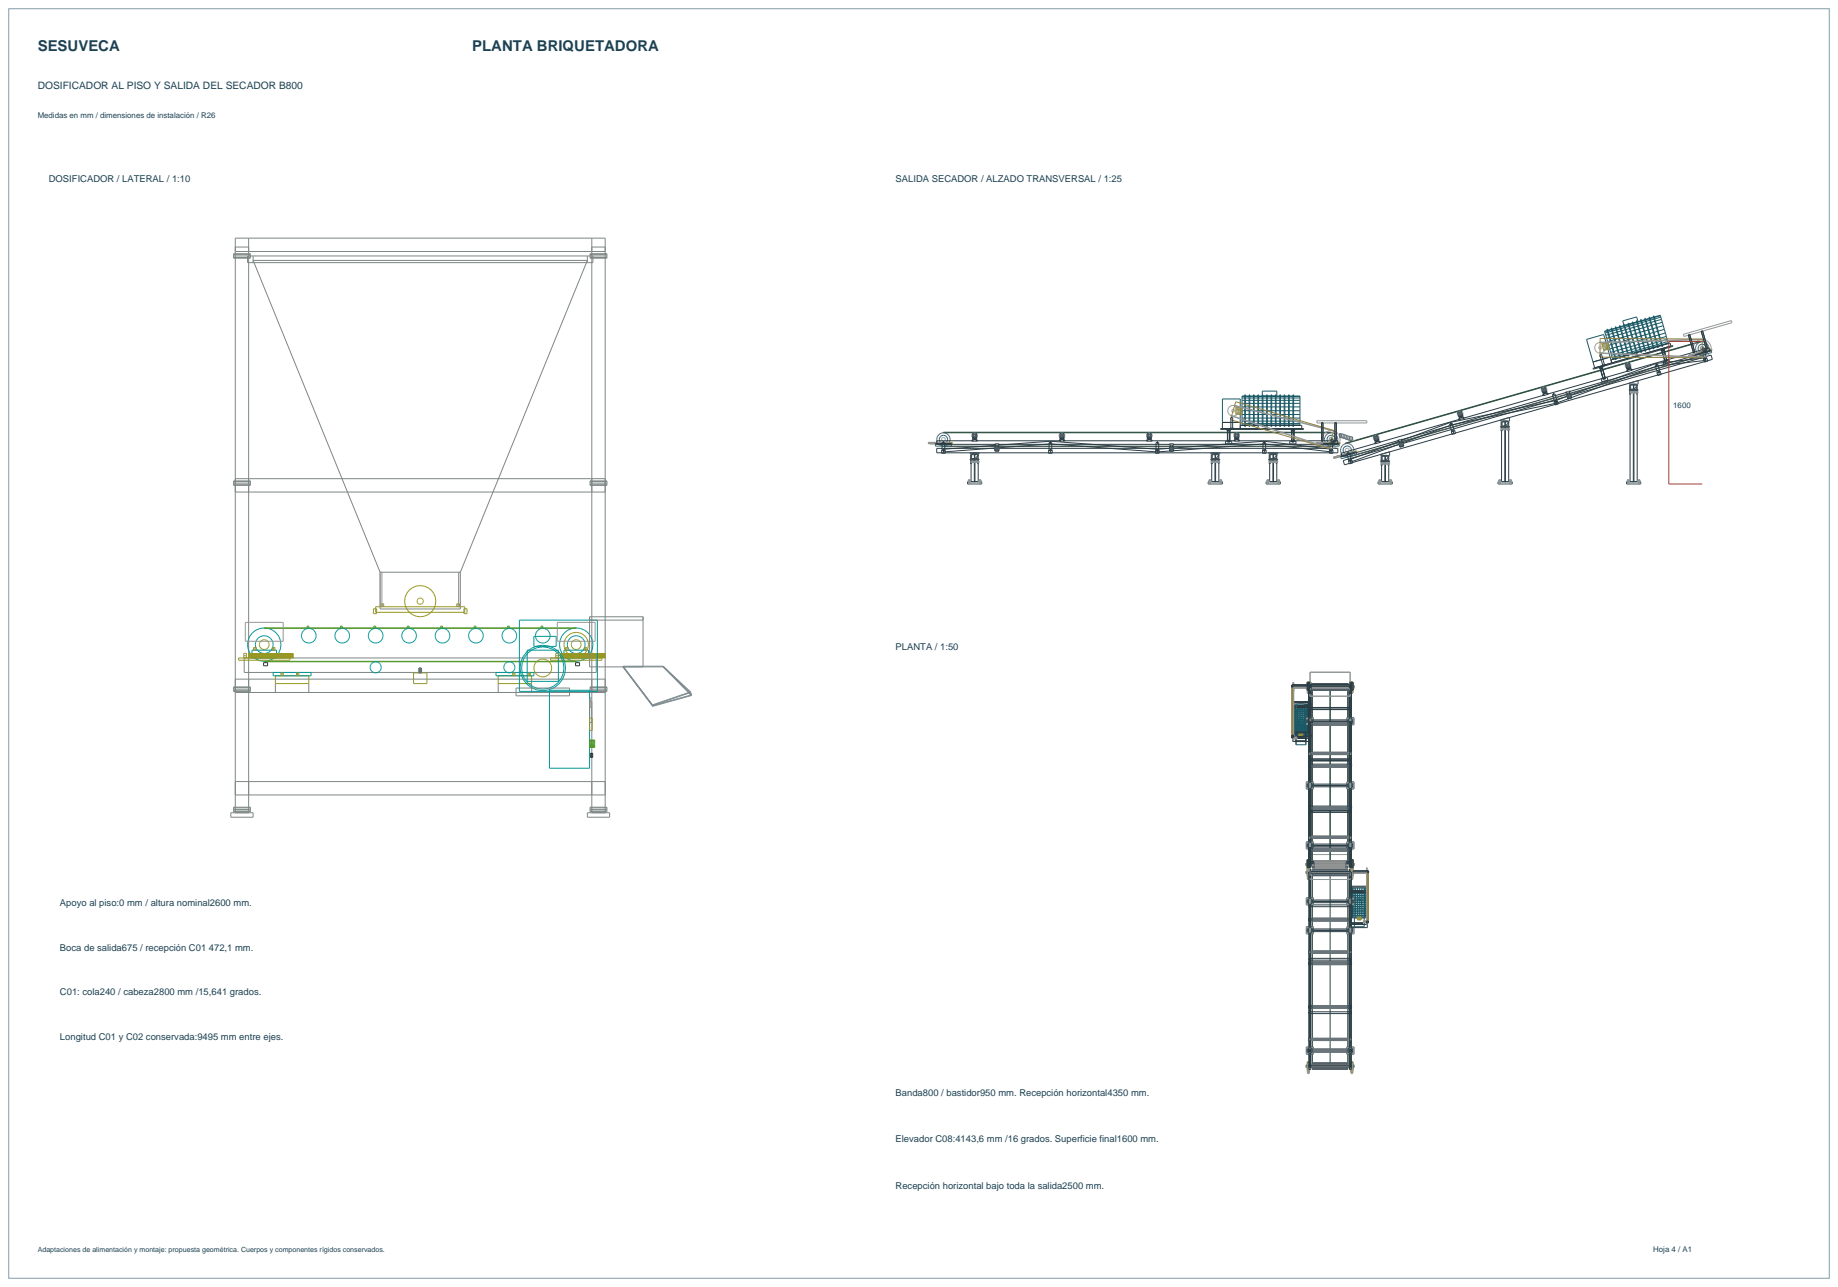
[picture p26: page 4]

DOSIFICADOR AL PISO Y SALIDA DEL SECADOR B800

Medidas en mm / dimensiones de instalación / R26

SALIDA SECADOR / ALZADO TRANSVERSAL / 1:25

Apoyo al piso:0 mm / altura nominal2600 mm.

Boca de salida675 / recepción C01 472,1 mm.

Longitud C01 y C02 conservada:9495 mm entre ejes.

Elevador C08:4143,6 mm /16 grados. Superficie final1600 mm.

Recepción horizontal bajo toda la salida2500 mm.

RECEPCIÓN PRÓXIMA Y OPERACIÓN COORDINADA / PROPUESTA INDEPENDIENTE

Medidas en mm / dimensiones de instalación / R26

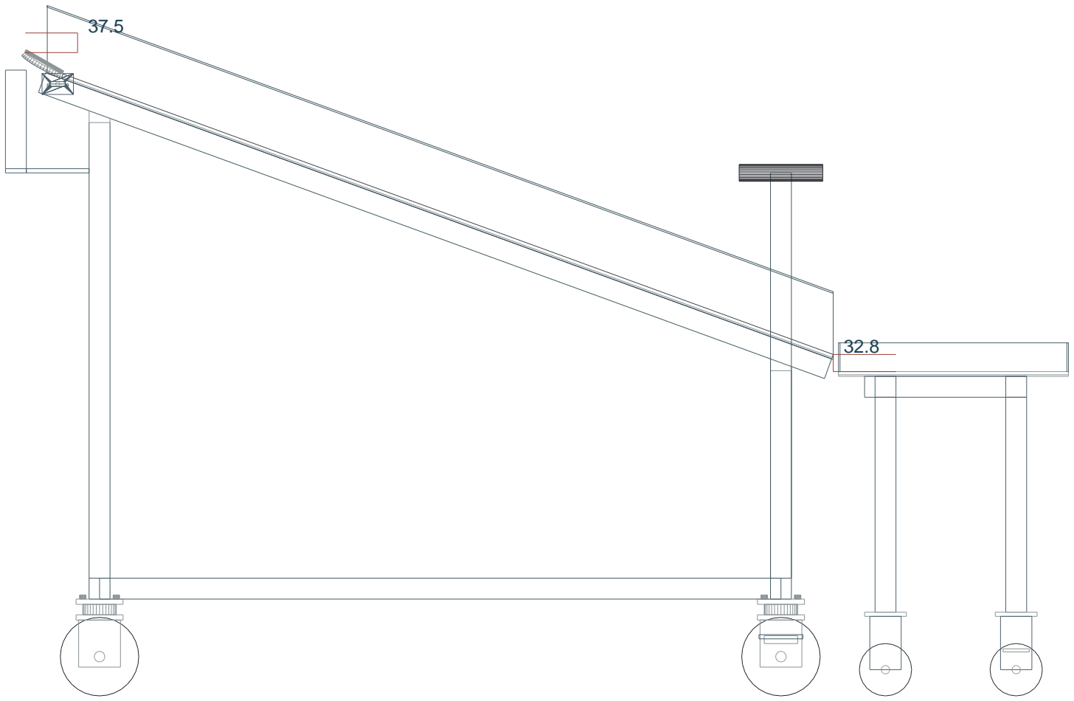
[picture p27: figure]

Adaptaciones de alimentación y montaje: propuesta geométrica. Cuerpos y componentes rígidos conservados. | Hoja 5 / A1

CARRO, NARIZ Y BANDEJA / LATERAL / 1:10

Nariz curva UHMW6 / acero3; ranuras20 mm y topes.

Bajante1600 mm a20 grados. Retirada en bandeja440 x650.

Superficie de bandeja620 mm / paredes55 mm / ruedas100.

La bandeja requiere retirada continua; no es un almacén.

El secador conserva su independencia de la prensa.

RECETA Y TEMPORIZACIÓN / P

Referencia carbón seco

15.000 t/h

Referencia limitada por retirada

15.000 t/h

Aglomerante

450.000 kg/h

Agua proporcional

10.000 L/min

Mezcla fresca calculada

267.500 kg/min

Retirada disponible

Sin definir

C01: separación puntos de carga

2018.002 mm

Adelanto de aglomerante respecto al carbón

4.036 s

Carbón desde carga hasta cabeza C01

14.675 s

Arranque prensa | C05 > prensa > C02 > mezcladora > C01; aglomerante antes de carbón; agua al llegar carbón
Arranque secador independiente | C08 > C04 > secador con permiso térmico > C03
Enclavamientos propuestos | Sin carbón: cerrar aditivos/agua. Nivel alto: parar alimentación. Sin retirada: detener grupo prensa.
Alcance | Consignas y temporización geométrica propuestas; no control de hardware, cálculo de capacidad ni validación de receta.

REGISTROS, LIMPIEZA Y BASTIDOR COMÚN DE AGUA

Medidas en mm / dimensiones de instalación / R26

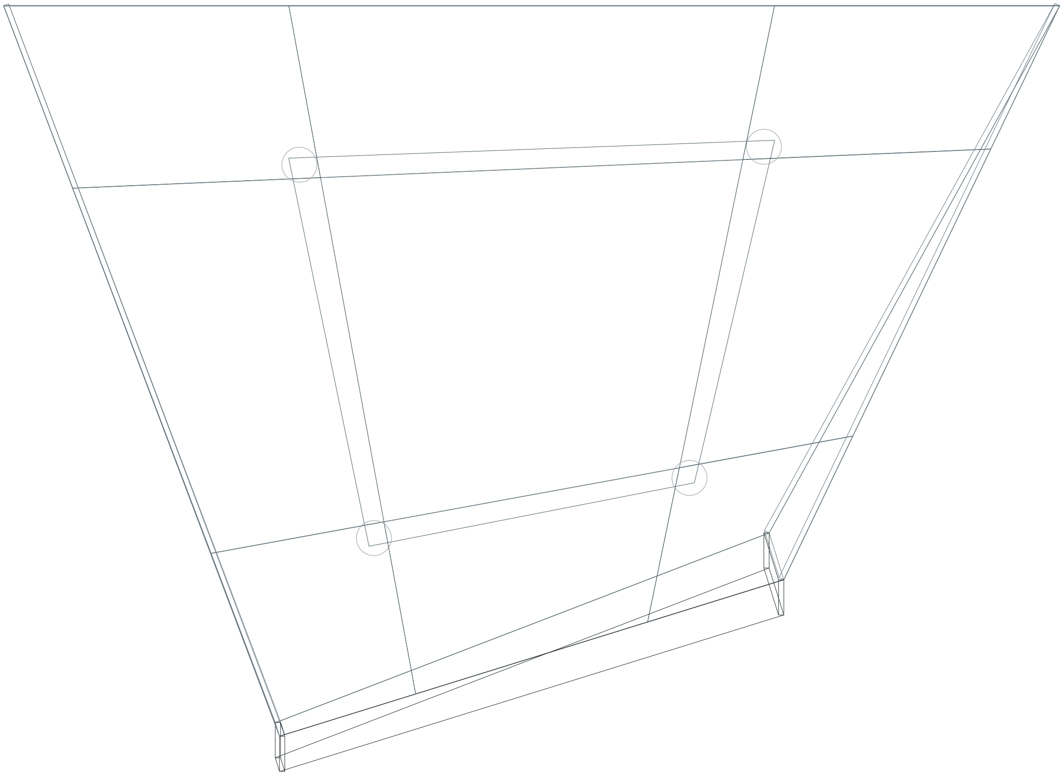
[picture p28: figure]

Adaptaciones de alimentación y montaje: propuesta geométrica. Cuerpos y componentes rígidos conservados. | Hoja 6 / A1
CAMPANA / REGISTRO / LATERAL / 1:5 | MEZCLADORA A C02 / LATERAL / 1:2

Registro lateral desmontable / luz media 205.8 × 216.3 mm P

Pared mínima51.1 grados: criterio60 no alcanzado con caras fijas.

LIMPIADOR Y BANDEJA C02 / PLANTA / 1:5

Limpiador450 mm / bandeja desmontable440 x620 x50.

AGUA / LATERAL / 1:25

Un bastidor común / dos apoyos al piso; instrumentos conservados.
