acevedocrisologopablo48-lgtm/planta-briquetadora/r24/PLANTA_R24.pdf

SESUVECA | PLANTA BRIQUETADORA

## DISPOSICIÓN GENERAL / C01 COMPARTIDA Y SECADOR INDEPENDIENTE

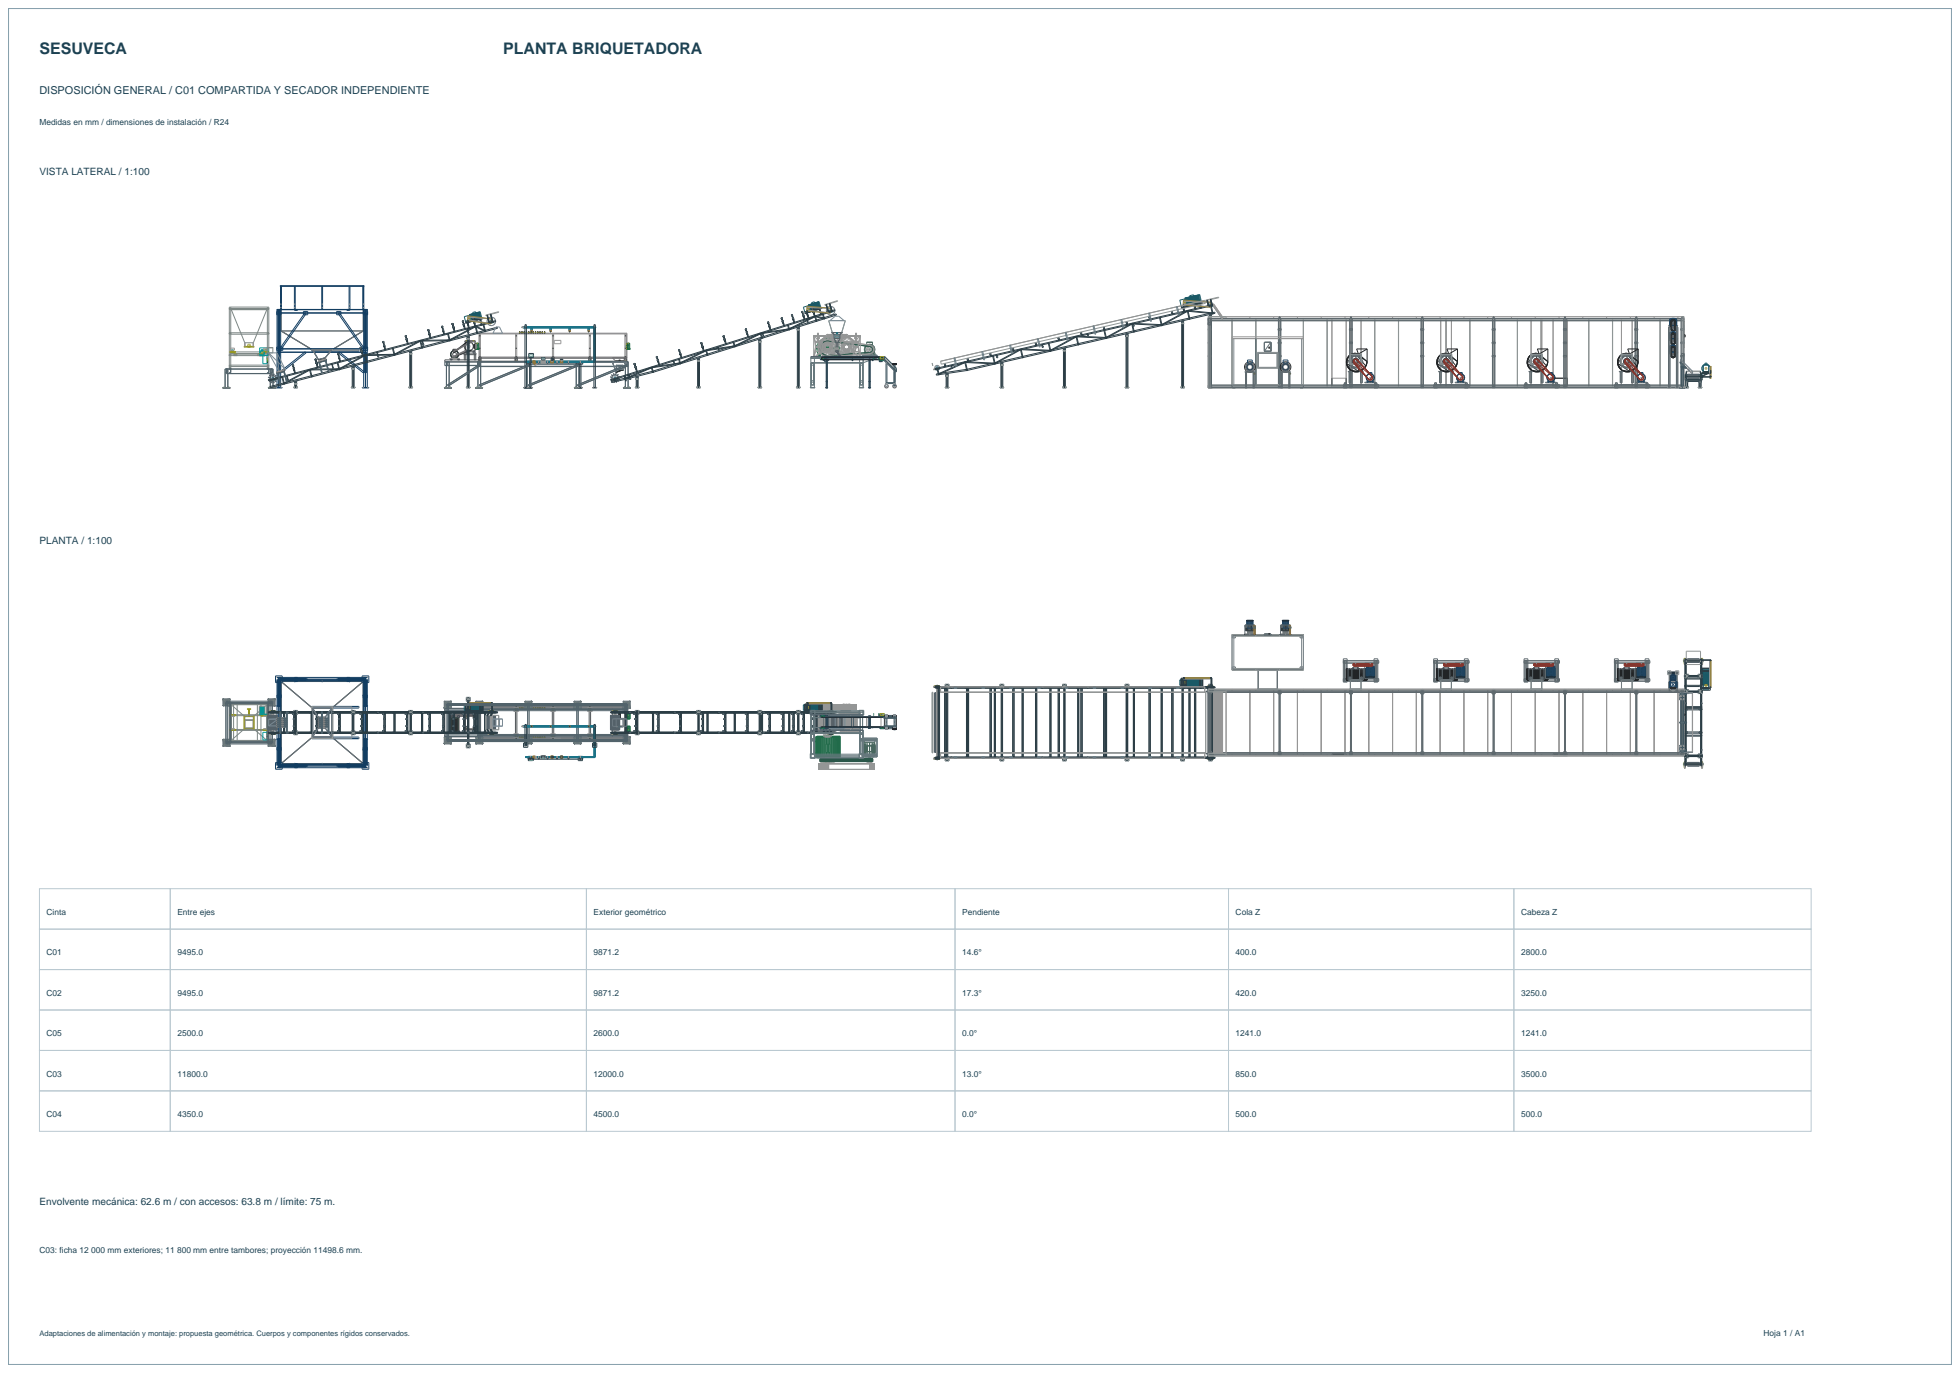
[picture p29: page 1]

Medidas en mm / dimensiones de instalación / R24

Envolvente mecánica: 62.6 m / con accesos: 63.8 m / límite: 75 m.

C03: ficha 12 000 mm exteriores; 11 800 mm entre tambores; proyección 11498.6 mm.

## CONJUNTOS MODIFICADOS / ALTURAS DESDE EL PISO

Medidas en mm / dimensiones de instalación / R24

Adaptaciones de alimentación y montaje: propuesta geométrica. Cuerpos y componentes rígidos conservados. | Hoja 2 / A1

### BRIQUETADORA Y COLECTORA / LATERAL / 1:20

2330

2830

2500

### COLECTORA PLANA / PLANTA / 1:10

B400

Tambores Ø100 / banda plana de 3 mm.

Superficie de carga: 1294.0 mm.

Labio de recepción: 1302.0 mm / separación: 8 mm.

Sólidos del conjunto de taller; soportes independientes.

### MEZCLADORA / FRENTE / 1:20

Mezcladora: cuerpo 6200 × 1300 × 1200 mm.

Bancada mezcladora: 1100 mm; entrada directa.

Se retiran la tolva añadida y sus apoyos.

Dosificador: bancada 800 mm / altura total 3400 mm.

Aglomerante sobre C01 antes del carbón.

Agua conectada al cuerpo de mezcla.

## BAJANTE MÓVIL / SECADOR INDEPENDIENTE

Medidas en mm / dimensiones de instalación / R24

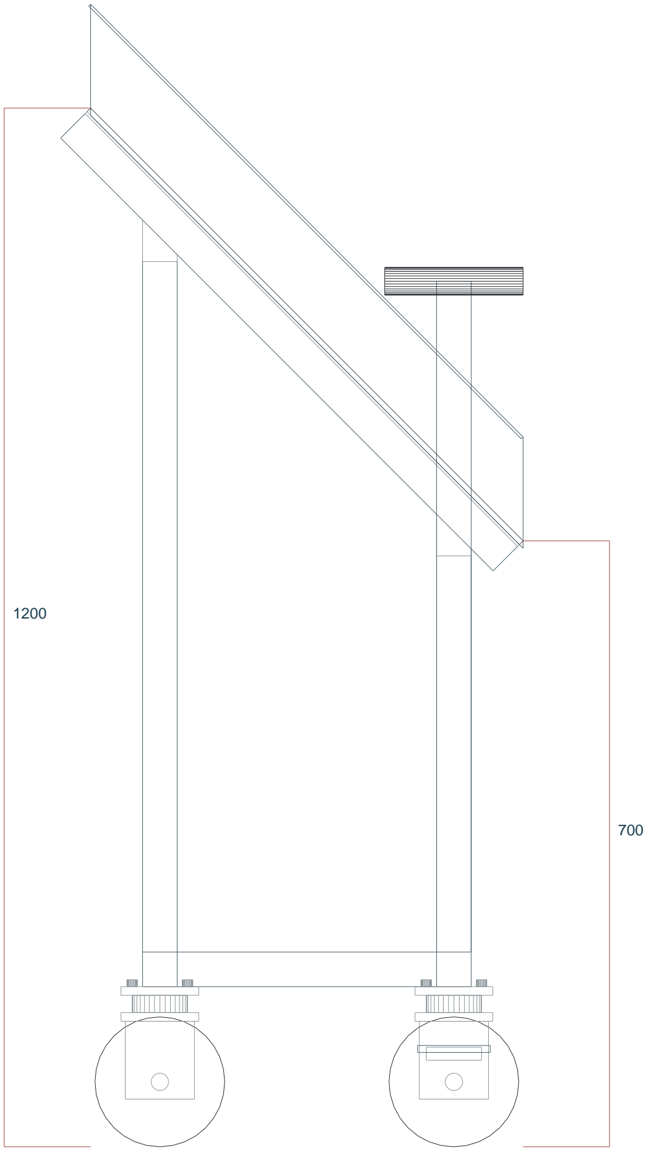
[picture p30: figure]
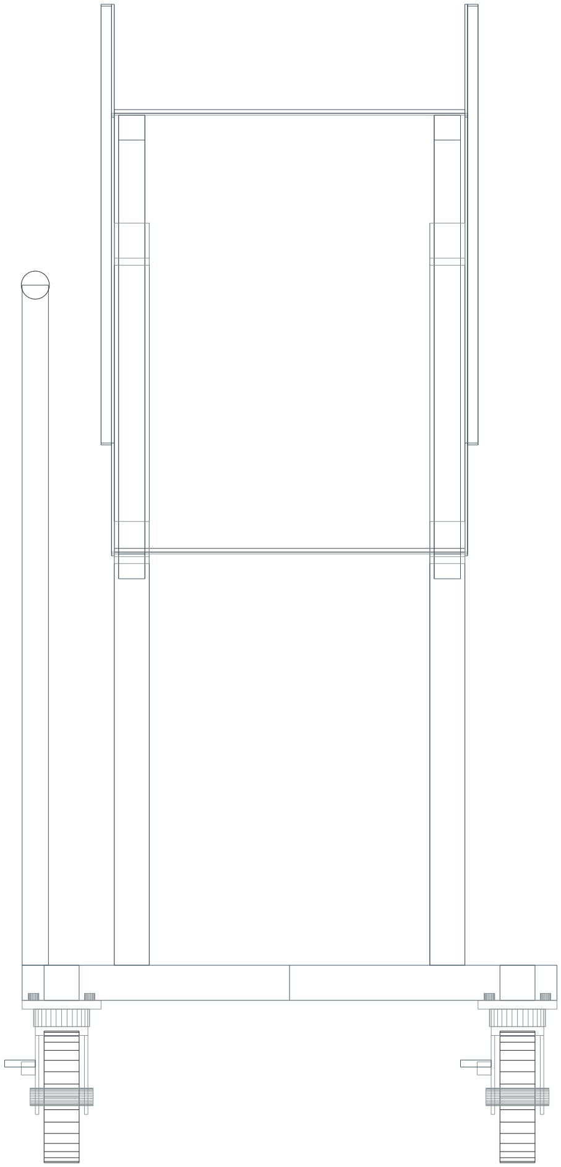
[picture p31: figure]

Adaptaciones de alimentación y montaje: propuesta geométrica. Cuerpos y componentes rígidos conservados. | Hoja 3 / A1

### LATERAL / 1:5

### FRENTE / 1:5

Canal útil: 400 mm / plano de deslizamiento: 45 grados.

Chapa 3 mm + revestimiento UHMW 6 mm.

Cuatro ruedas de 150 mm; dos con freno.

El conjunto se retira o desplaza independientemente.

No existe unión directa entre C05 y el alimentador del secador.
