acevedocrisologopablo48-lgtm/planta-briquetadora/r22/DOSSIER_R22.pdf

# PLANTA BRIQUETADORA / R22

## 01 / BASE ORIGINAL Y ADAPTACIÓN LOCAL PARA C05

Milímetros. O: original documentado / P: adaptación propuesta / R: interpretación. Alturas desde NPT.

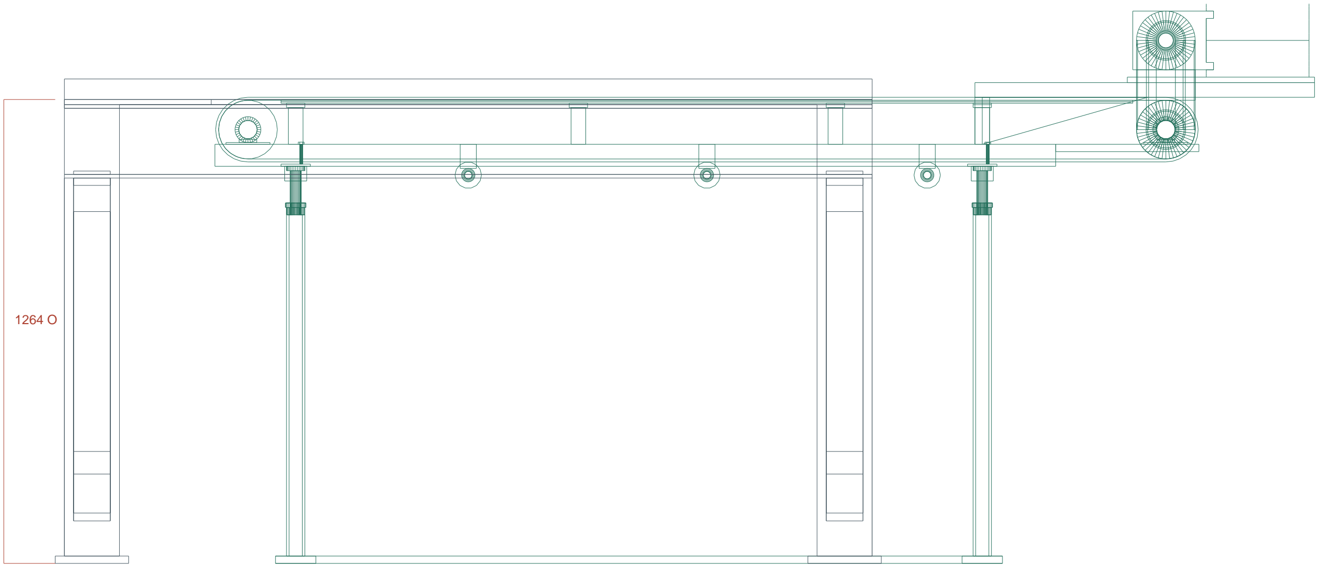
[picture p32: figure]

Base y recepción: definición geométrica. La adaptación local no constituye comprobación de resistencia. | Hoja 1
BASE ORIGINAL R03 / LATERAL / 1:10 | BASE ADAPTADA Y C05 / LATERAL / 1:10

### PASO DE C05 / FRONTAL / 1:10

640 P

### COTAS Y CAMBIOS LOCALES

Envolvente original conservada: 2250 × 2020 × 1264 mm O.

Cuatro pies y montantes originales; arriostres conservados.

Ventana P: X400..2250 / Y175..815 / Z1000..1350 locales.

Paso de 640 mm para cassette de 600 mm: 20 mm por lado.

Dos asientos P de 2200 × 110 × 56 mm: Z1264..1320.

C05: eje1182 / banda1270 / 2500 mm entre ejes.

Chute: salida1278 / holgura a banda8 mm P.

Se conserva el rebaje local inferior del cuerpo de56 mm P.

# PLANTA BRIQUETADORA / R22

## 02 / CONJUNTO Y RECEPCIÓN DE PRENSA

Milímetros. O: original documentado / P: adaptación propuesta / R: interpretación. Alturas desde NPT.

Base y recepción: definición geométrica. La adaptación local no constituye comprobación de resistencia. | Hoja 2

### PLANTA COMPLETA / LATERAL / 1:100

PRENSA Y C05 / LATERAL / 1:10 | PRENSA Y C05 / FRONTAL / 1:10

Envolvente 59.977 m / con accesos 62.239 m / límite75 m.

R21 permanece disponible. Posiciones de equipos, rodillos, transmisión, alturas de C05 y demás cintas conservadas.
