acevedocrisologopablo48-lgtm/planta-briquetadora/r18/DOSSIER_R18.pdf

# PLANTA BRIQUETADORA / CONFIGURADOR 3D

## R18 / RECORRIDO Y TRANSFERENCIAS / DISPOSICION 1:100

PLANTA BRIQUETADORA · R18 | 2026-10-19 | A1 horizontal - milímetros
O: documentado P: propuesto R: referencial / pendiente de fabricante. Geometría de implantación; no apta para fabricación sin validación. | Hoja 1

LATERAL / NPT +0

C01 9495.0 P | C02 9495.0 P

C05 2500.0 P

C03 9840.0 P

tolva 3450.0 O

2700.0 O

Montaje tolva 4300.0 R

dosificador 1700.0 O

2600.0 O

mezcladora 6200.0 O
1200.0 O

briquetadora 2200.0 O

2300.0 O
secador 20000.0 O

3000.0 O

Eje final 58117.1 P

SUPERIOR

TRANSPORTADORES / ENTRE EJES Y ALTURAS DESDE NPT

ID | Servicio | Entre ejes mm | Pendiente | Cola Z | Cabeza Z | Banda mm
C01 | Carbon / mezcladora | 9495.0 | 18.67° | 450.0 | 3490.1 | 500.0 P
C02 | Mezcla / prensa | 9495.0 | 16.99° | 420.0 | 3195.1 | 500.0 P
C05 | Colectora briquetas | 2500.0 | 0.00° | 1182.0 | 1182.0 | 500.0 P
C03 | Elevacion / repartidor | 9840.0 | 15.62° | 850.0 | 3500.0 | 500.0 P
C04 | Salida secador | 4350.0 | 0.00° | 500.0 | 500.0 | 500.0 R

Envolvente mecanica 58855.1 mm / con accesos 61117.1 mm / reserva 72000.0 / limite 75000.0 mm. Fajas principales: 35680.0 mm entre ejes.

Criterios adoptados para geometria P: carbon fino humedo 0,85 t/m3; reposo 45-50 grados; paredes de chutes de carbon minimo 60 grados. Los cuerpos documentados se conservan; nuevos mecanismos, bancadas y conexiones son propuestas P.

R18 / 1 de 19

## R18 / TOLVA DE CARBÓN / VISTAS 1:25

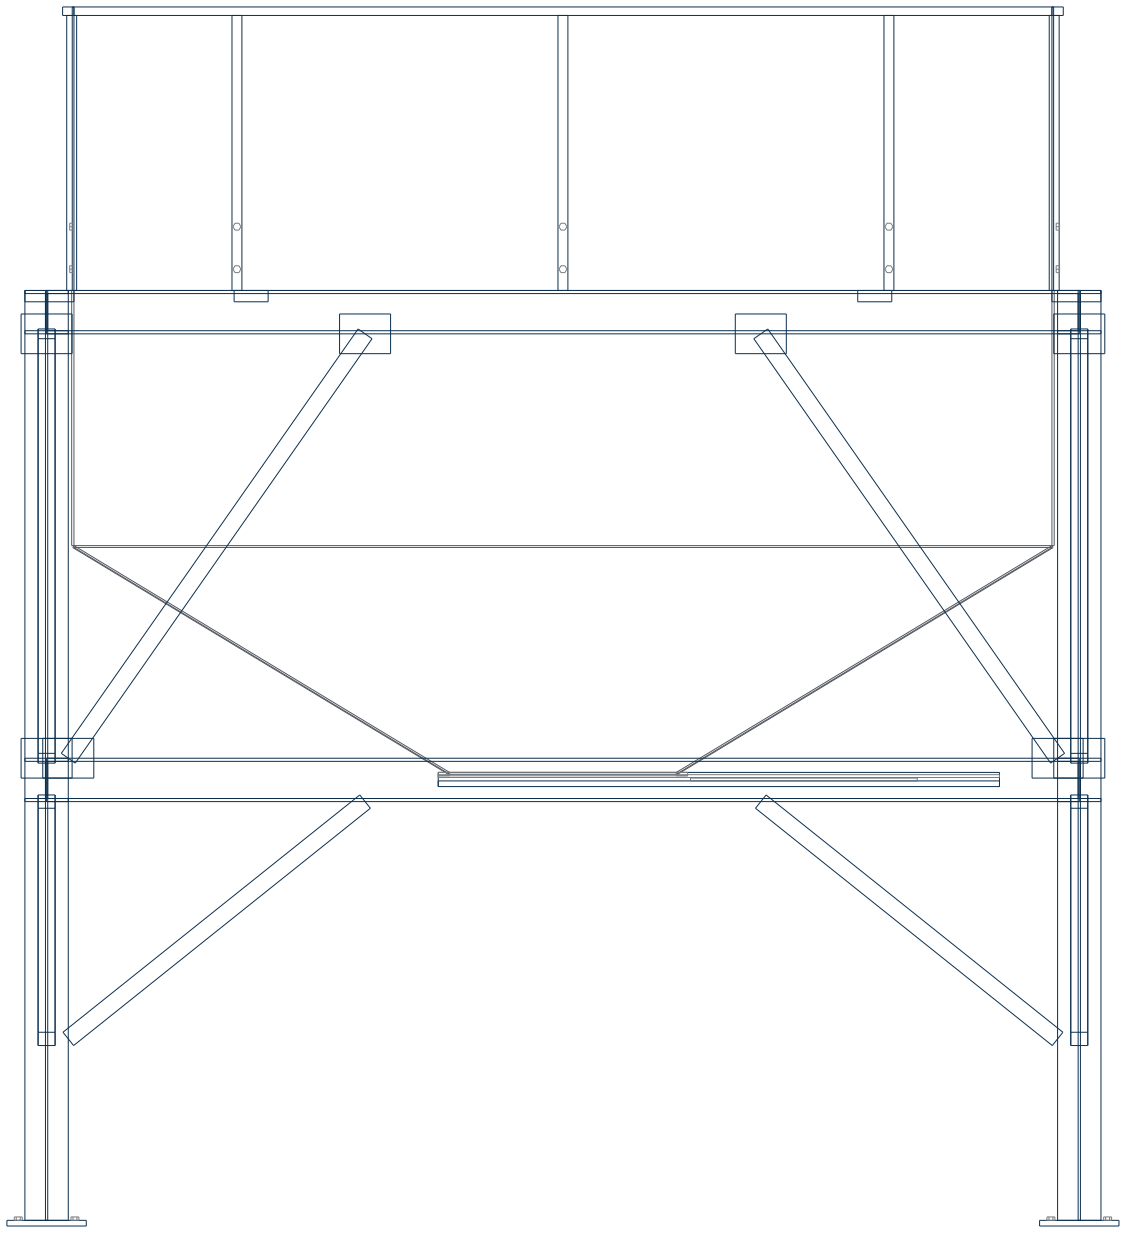
[picture p33: figure]
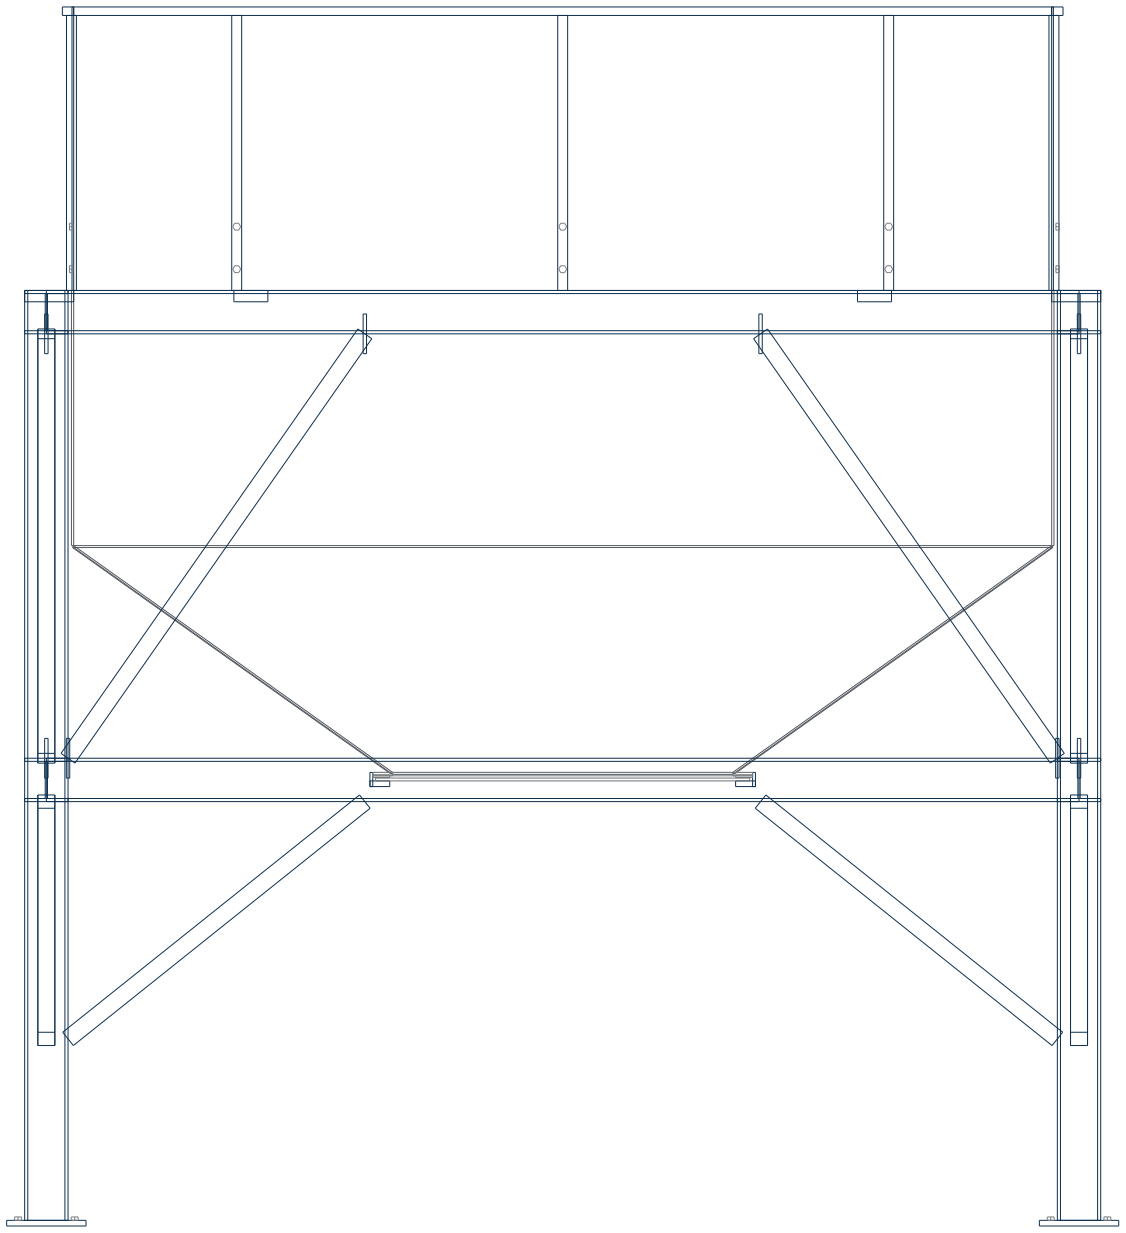
[picture p34: figure]
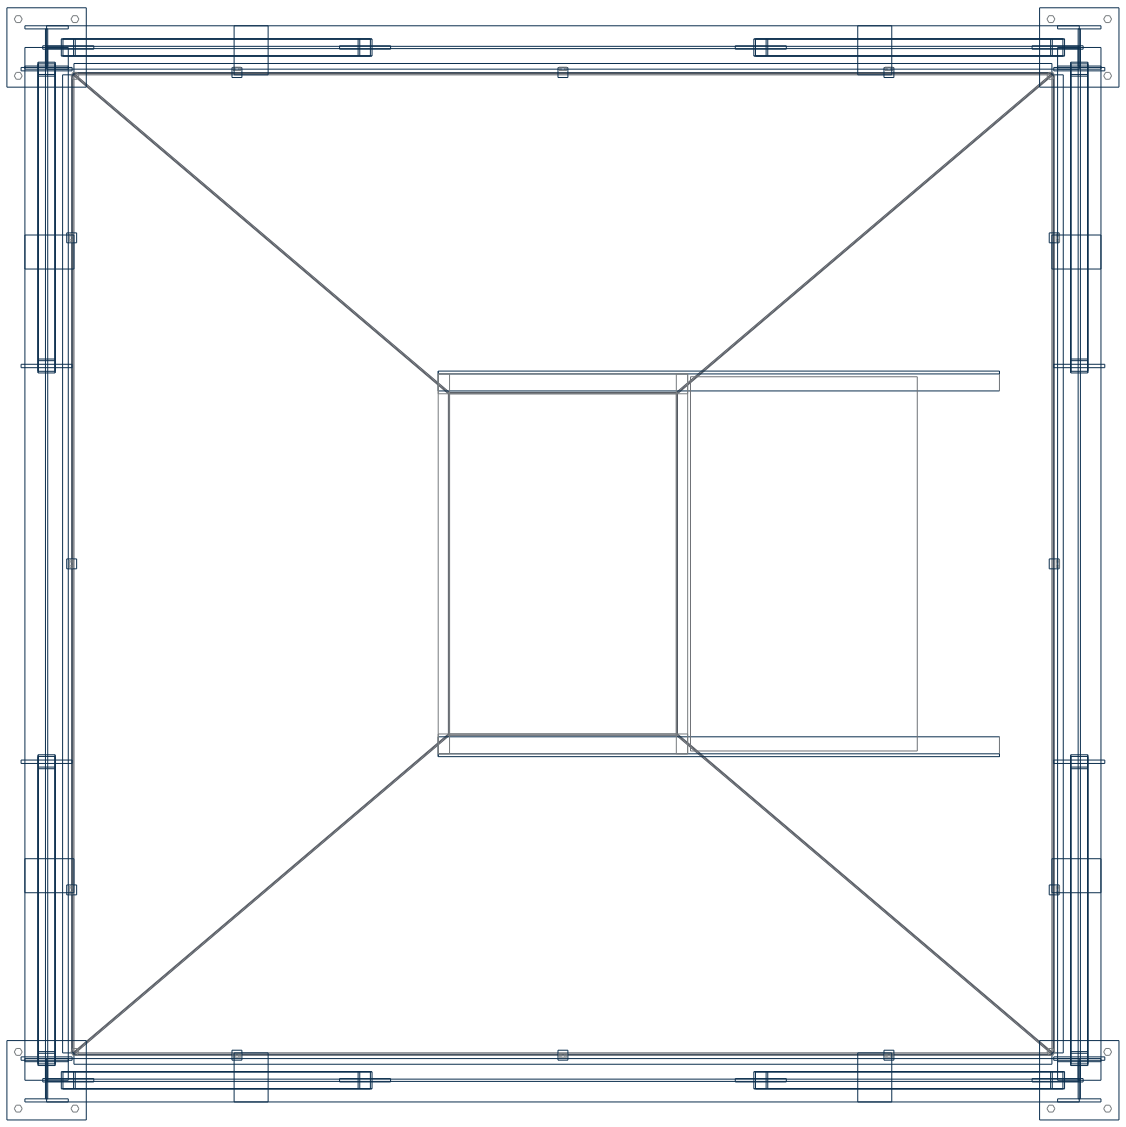
[picture p35: figure]

O: documentado P: propuesto R: referencial / pendiente de fabricante. Geometría de implantación; no apta para fabricación sin validación. | Hoja 2

LATERAL / 1:25

3923.0 envolvente P/R

FRONTAL / 1:25

3923.0 envolvente P/R

SUPERIOR / 1:25

Cuerpo nominal 3450.0 x 3450.0 x 2700.0 mm O. Apoyo de equipo +0.0 mm P. Posicion X/Y: 0.0 / 0.0 mm.

Tolva fabricada sin pedestal. Boca3450x3450 y salida1200x800 conservadas. C01 bajo compuerta sustituye solo el alimentador P04 adaptado.

## R18 / DOSIFICADOR DE AGLOMERANTE / VISTAS 1:20

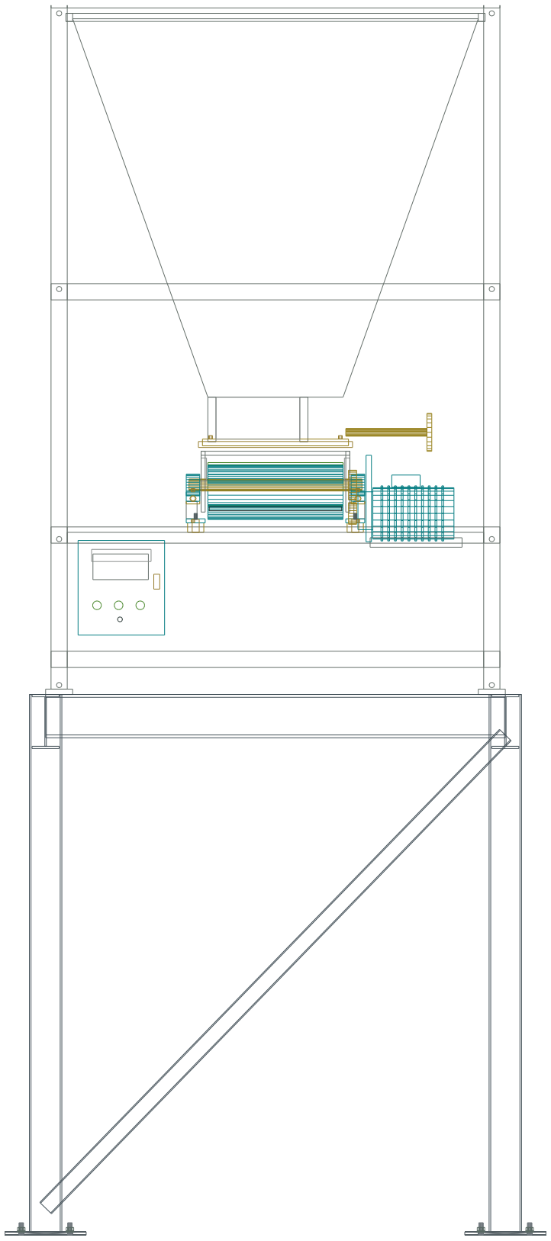
[picture p36: figure]

O: documentado P: propuesto R: referencial / pendiente de fabricante. Geometría de implantación; no apta para fabricación sin validación. | Hoja 3

LATERAL / 1:20

2000.0 envolvente P/R

FRONTAL / 1:20

2200.0 envolvente P/R

SUPERIOR / 1:20

Cuerpo nominal 1700.0 x 1700.0 x 2600.0 mm O. Apoyo de equipo +2000.0 mm P. Posicion X/Y: 12419.5 / 2900.0 mm.

Aglomerante directo a mezcladora por transferencia solida o sistema liquido independiente. Conexiones separadas del pesaje.

## R18 / MEZCLADORA DE DOBLE EJE / VISTAS 1:20

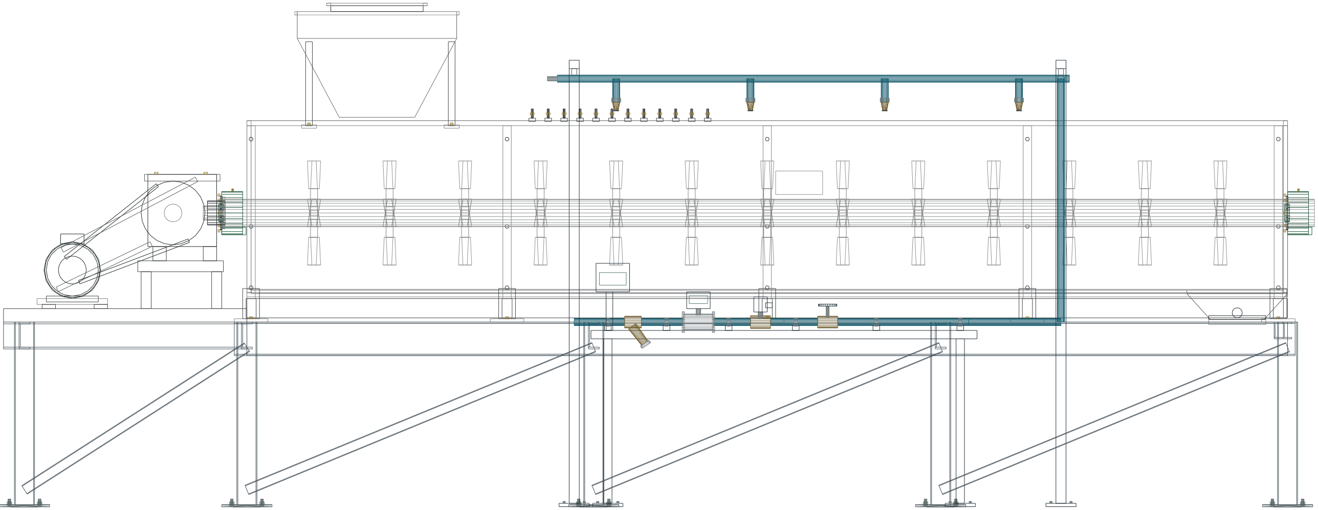
[picture p37: figure]

O: documentado P: propuesto R: referencial / pendiente de fabricante. Geometría de implantación; no apta para fabricación sin validación. | Hoja 4

LATERAL / 1:20

7835.0 envolvente P/R

FRONTAL / 1:20

2500.0 envolvente P/R

SUPERIOR / 1:20

Cuerpo nominal 6200.0 x 1300.0 x 1200.0 mm O. Apoyo de equipo +1100.0 mm P. Posicion X/Y: 10569.5 / 0.0 mm.

Entrada de agua y aglomerante directa al cuerpo. Filtro Y, medicion, solenoide NC y regulacion manual. Descarga con registro y faldones a C02.

## R18 / BRIQUETADORA / VISTAS 1:20

O: documentado P: propuesto R: referencial / pendiente de fabricante. Geometría de implantación; no apta para fabricación sin validación. | Hoja 5

LATERAL / 1:20

2860.0 envolvente P/R

FRONTAL / 1:20

2734.0 envolvente P/R

SUPERIOR / 1:20

Cuerpo nominal 2200.0 x 1970.0 x 2300.0 mm O. Apoyo de equipo +0.0 mm P. Posicion X/Y: 24628.2 / -495.0 mm.

Cuello repartidor entre adaptador y rodillos, sensor de nivel y registro. Recepcion revestida y cassette B500 conservan componentes rigidos; adaptaciones inferiores P.

## R18 / SECADOR DE SEIS NIVELES / VISTAS 1:50

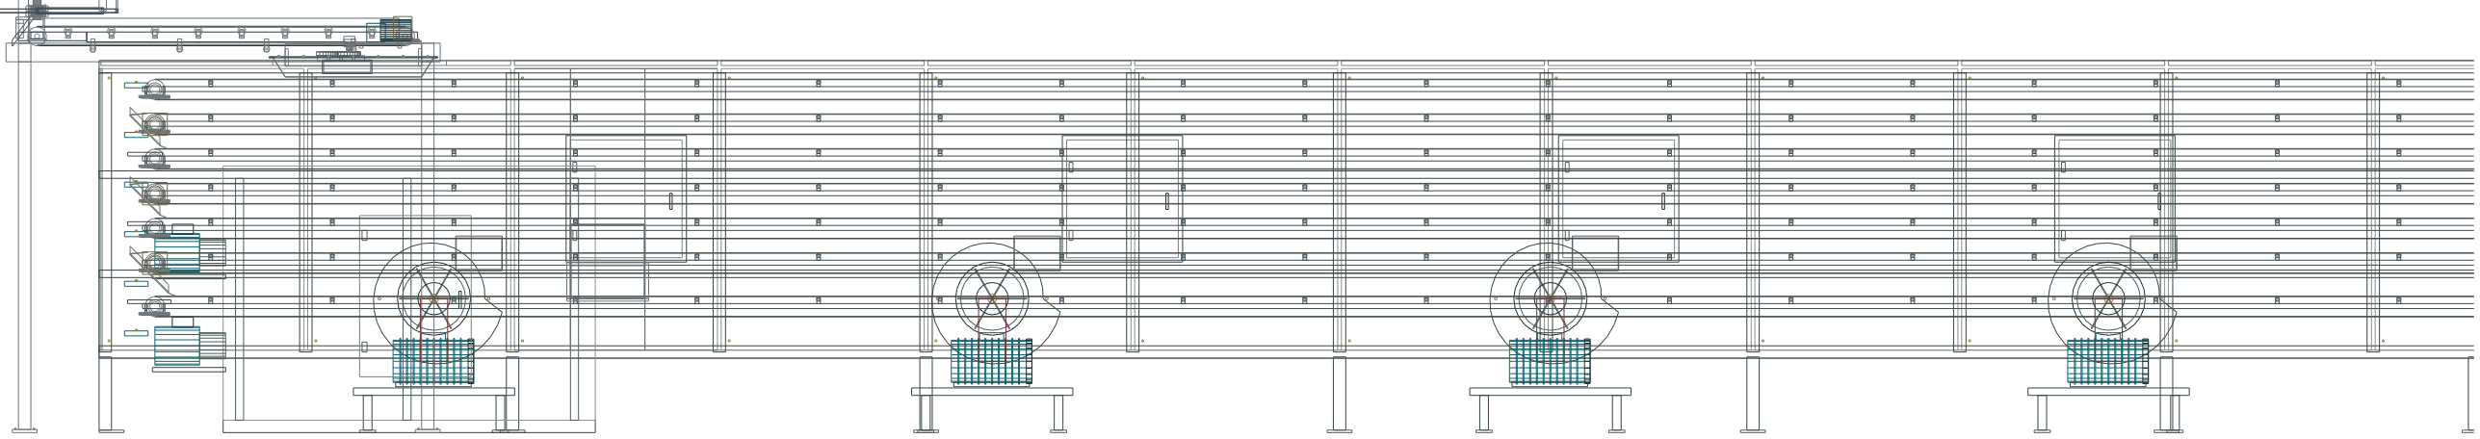
[picture p38: figure]

O: documentado P: propuesto R: referencial / pendiente de fabricante. Geometría de implantación; no apta para fabricación sin validación. | Hoja 6

LATERAL / 1:50

21934.7 envolvente P/R

FRONTAL / 1:50

5850.0 envolvente P/R

SUPERIOR / 1:50

Cuerpo nominal 20000.0 x 2800.0 x 3000.0 mm O. Apoyo de equipo +0.0 mm P. Posicion X/Y: 37717.1 / 0.0 mm.

Cuerpo20000x2800x3000 apoyado al piso. Repartidor y ventiladores acotados aparte. Chuta ancha2500 hacia C04 transversal; sin embudo profundo.

## R18 / CARBÓN · COMPUERTA / ALIMENTADOR C01 / DETALLE 1:20

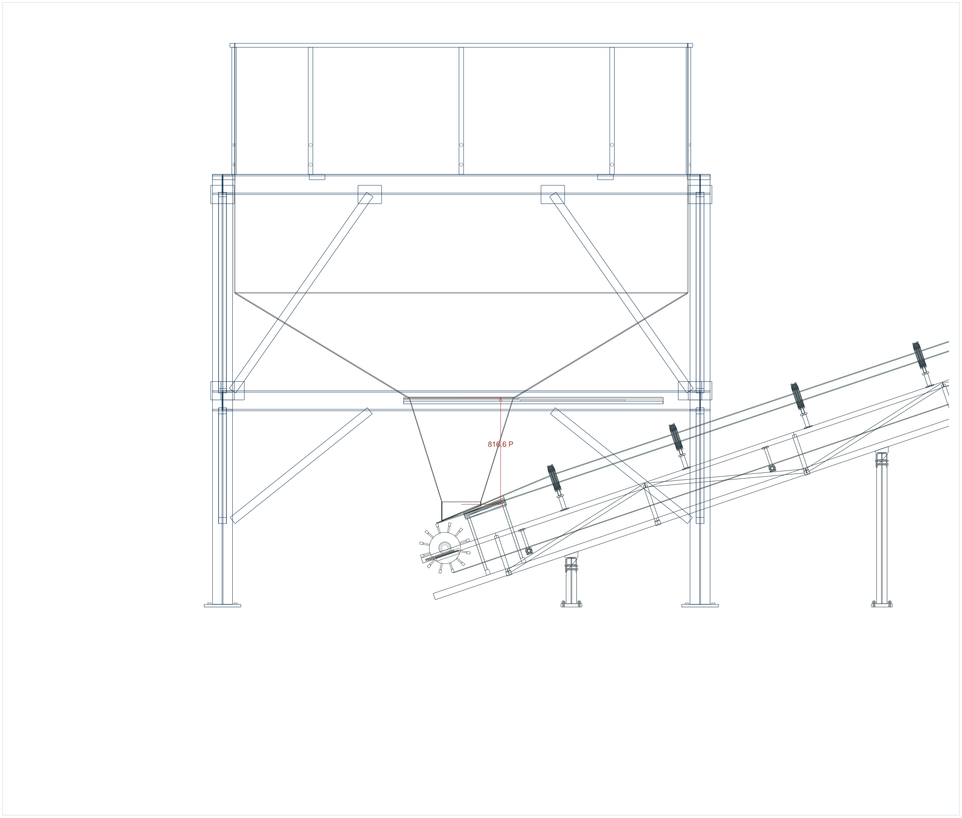
[picture p39: figure]

O: documentado P: propuesto R: referencial / pendiente de fabricante. Geometría de implantación; no apta para fabricación sin validación. | Hoja 7

LATERAL / 1:20

SUPERIOR / 1:20

450.0 P | 1200.0 P

Origen desde NPT +1600.0 mm / recepcion +783.4 mm. Desnivel entre referencias 816.6 mm. Desplazamiento horizontal 0.0 mm.

Abertura de origen 800.0 x 1200.0 mm / receptora 300.0 x 450.0 mm P. Centros, caras de banda y bocas se acotan de manera independiente.

Tolva fabricada sin pedestal. C01 alimenta bajo compuerta; campana 1200 a 450 mm, cama de impacto y faldones. Accionamiento sujeto a carga bajo tolva; no equivale automáticamente al servicio anterior.

## R18 / AGLOMERANTE DIRECTO A MEZCLADORA / DETALLE 1:20

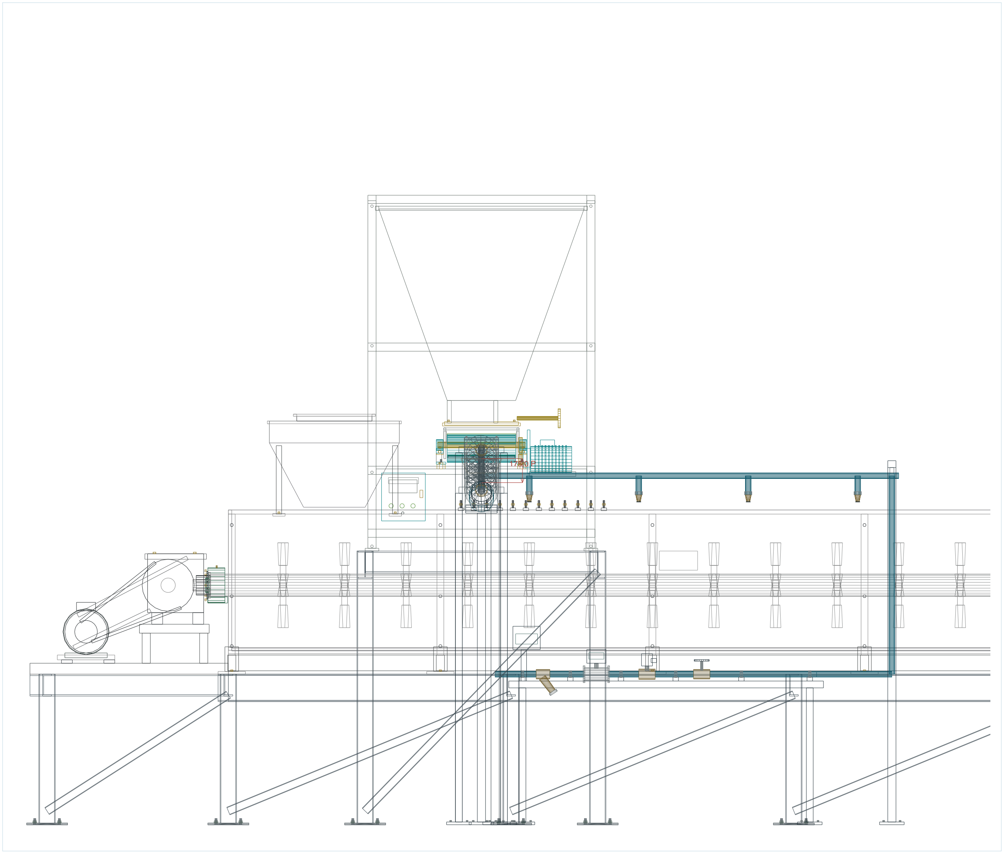
[picture p40: figure]

O: documentado P: propuesto R: referencial / pendiente de fabricante. Geometría de implantación; no apta para fabricación sin validación. | Hoja 8

LATERAL / 1:20

SUPERIOR / 1:20

250.0 P

250.0 P

Origen desde NPT +2675.0 mm / recepcion +2500.0 mm. Desnivel entre referencias 175.0 mm. Desplazamiento horizontal 1650.0 mm.

Abertura de origen 250.0 x 250.0 mm / receptora 250.0 x 250.0 mm P. Centros, caras de banda y bocas se acotan de manera independiente.

Solucion mecanica propuesta P; medidas generadas de la geometria compartida del visor.

## R18 / MEZCLADORA / C02 / DETALLE 1:20

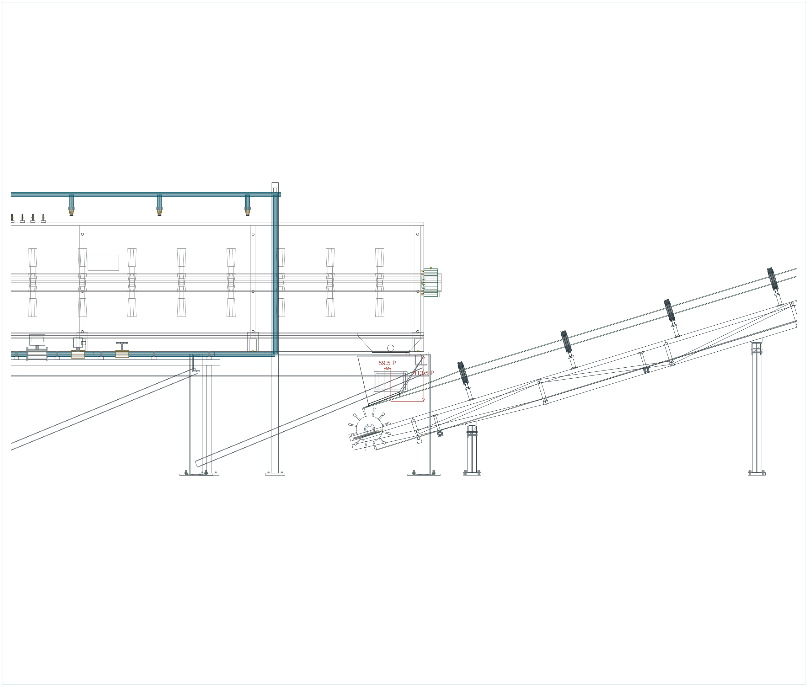
[picture p41: figure]

O: documentado P: propuesto R: referencial / pendiente de fabricante. Geometría de implantación; no apta para fabricación sin validación. | Hoja 9

LATERAL / 1:20

SUPERIOR / 1:20

340.0 P | 300.0 P

Origen desde NPT +1085.0 mm / recepcion +671.5 mm. Desnivel entre referencias 413.5 mm. Desplazamiento horizontal 59.5 mm.

Abertura de origen 600.0 x 300.0 mm / receptora 300.0 x 340.0 mm P. Centros, caras de banda y bocas se acotan de manera independiente.

Chute P con registro y faldones; altura libre mayor de300mm.

## R18 / C02 / BRIQUETADORA / DETALLE 1:20

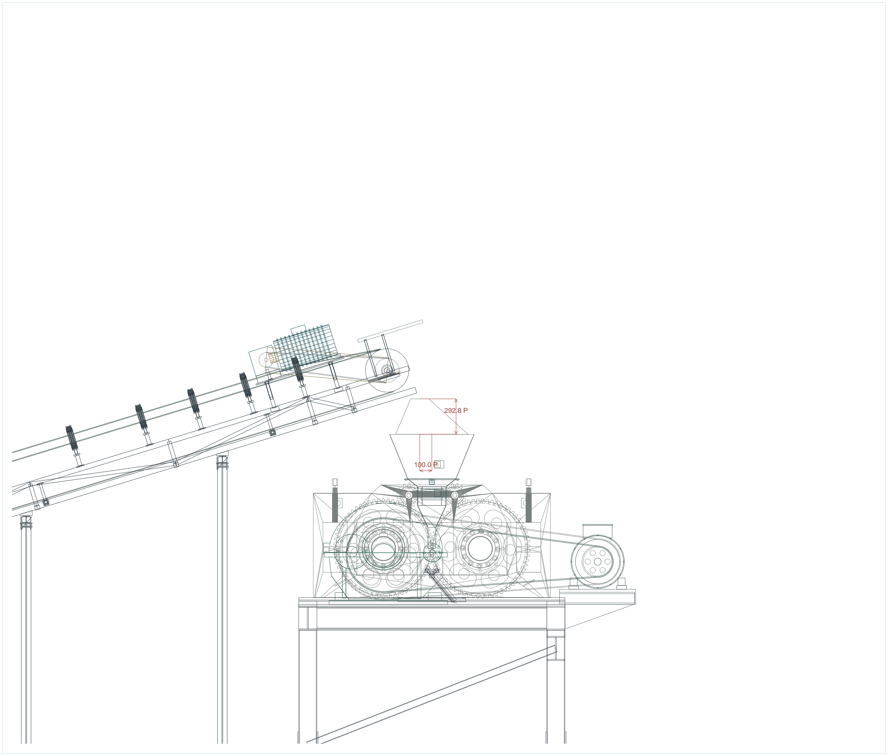
[picture p42: figure]

O: documentado P: propuesto R: referencial / pendiente de fabricante. Geometría de implantación; no apta para fabricación sin validación. | Hoja 10

LATERAL / 1:20

SUPERIOR / 1:20

600.0 P

600.0 P

Origen desde NPT +2960.1 mm / recepcion +2667.3 mm. Desnivel entre referencias 292.8 mm. Desplazamiento horizontal 102.0 mm.

Abertura de origen 150.0 x 600.0 mm / receptora 600.0 x 600.0 mm P. Centros, caras de banda y bocas se acotan de manera independiente.

Cuello575mm P con transición conformada400mm y aproximación abierta175mm, sensor y registro.

## R18 / BRIQUETADORA / C05 · CASSETTE PRÓXIMO P / DETALLE 1:20

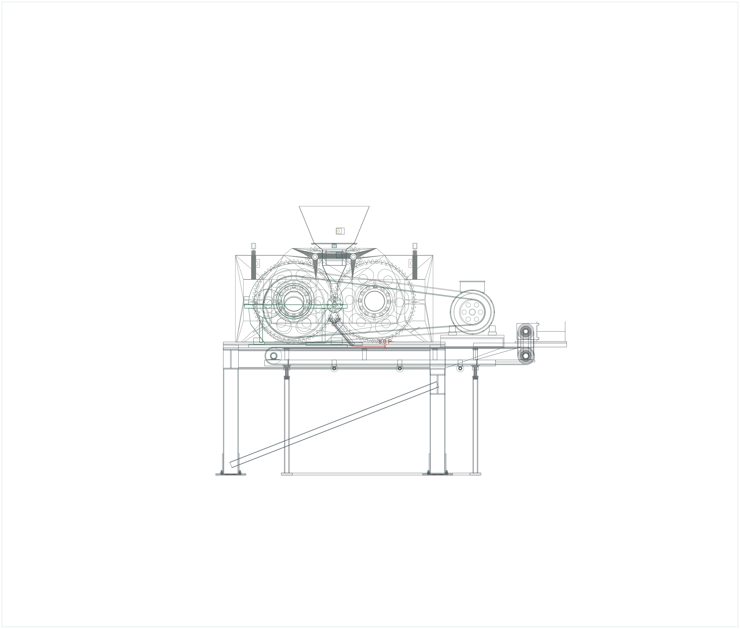
[picture p43: figure]

O: documentado P: propuesto R: referencial / pendiente de fabricante. Geometría de implantación; no apta para fabricación sin validación. | Hoja 11

LATERAL / 1:20

SUPERIOR / 1:20

360.0 P | 360.0 P

Origen desde NPT +1278.0 mm / recepcion +1270.0 mm. Desnivel entre referencias 8.0 mm. Desplazamiento horizontal 0.0 mm.

Abertura de origen 80.0 x 360.0 mm / receptora 80.0 x 360.0 mm P. Centros, caras de banda y bocas se acotan de manera independiente.

P: tangente de desprendimiento15° adoptada; dos labios50° y canal común50°, goma10/UHMW8, salida8sobrebanda.

## R18 / C05 / C03 · TRANSFERENCIA TRANSVERSAL PROPUESTA 500 MM / DETALLE 1:20

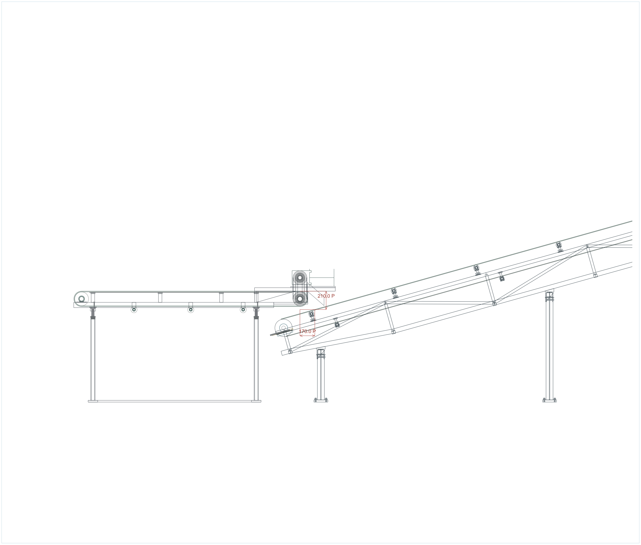
[picture p44: figure]

O: documentado P: propuesto R: referencial / pendiente de fabricante. Geometría de implantación; no apta para fabricación sin validación. | Hoja 12

LATERAL / 1:20

SUPERIOR / 1:20

500.0 P | 500.0 P

Origen desde NPT +1270.0 mm / recepcion +1060.0 mm. Desnivel entre referencias 210.0 mm. Desplazamiento horizontal 170.0 mm.

Abertura de origen 220.0 x 500.0 mm / receptora 220.0 x 500.0 mm P. Centros, caras de banda y bocas se acotan de manera independiente.

Cola C03 a +850 mm P y recepción 170 mm después de la cabeza C05; longitud y cabeza conservadas. Guías laterales abiertas, sin fondo ni placas transversales. Trayectoria, tamaño y resistencia de briqueta pendientes de ensayo.

## R18 / C03 / COLA FIJA REPARTIDOR / DETALLE 1:20

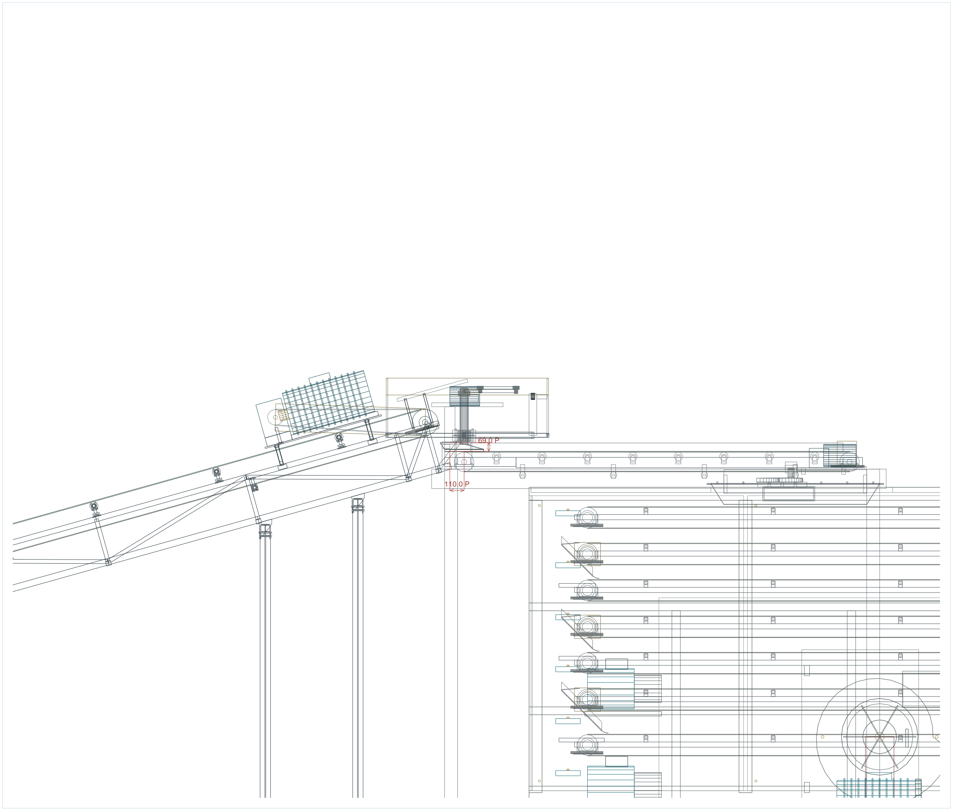
[picture p45: figure]

O: documentado P: propuesto R: referencial / pendiente de fabricante. Geometría de implantación; no apta para fabricación sin validación. | Hoja 13

LATERAL / 1:20

SUPERIOR / 1:20

500.0 P | 500.0 P

Origen desde NPT +3345.0 mm / recepcion +3276.0 mm. Desnivel entre referencias 69.0 mm. Desplazamiento horizontal 110.0 mm.

Abertura de origen 150.0 x 500.0 mm / receptora 300.0 x 500.0 mm P. Centros, caras de banda y bocas se acotan de manera independiente.

Solucion mecanica propuesta P; medidas generadas de la geometria compartida del visor.

## R18 / REPARTIDOR OSCILANTE / SECADOR / DETALLE 1:20

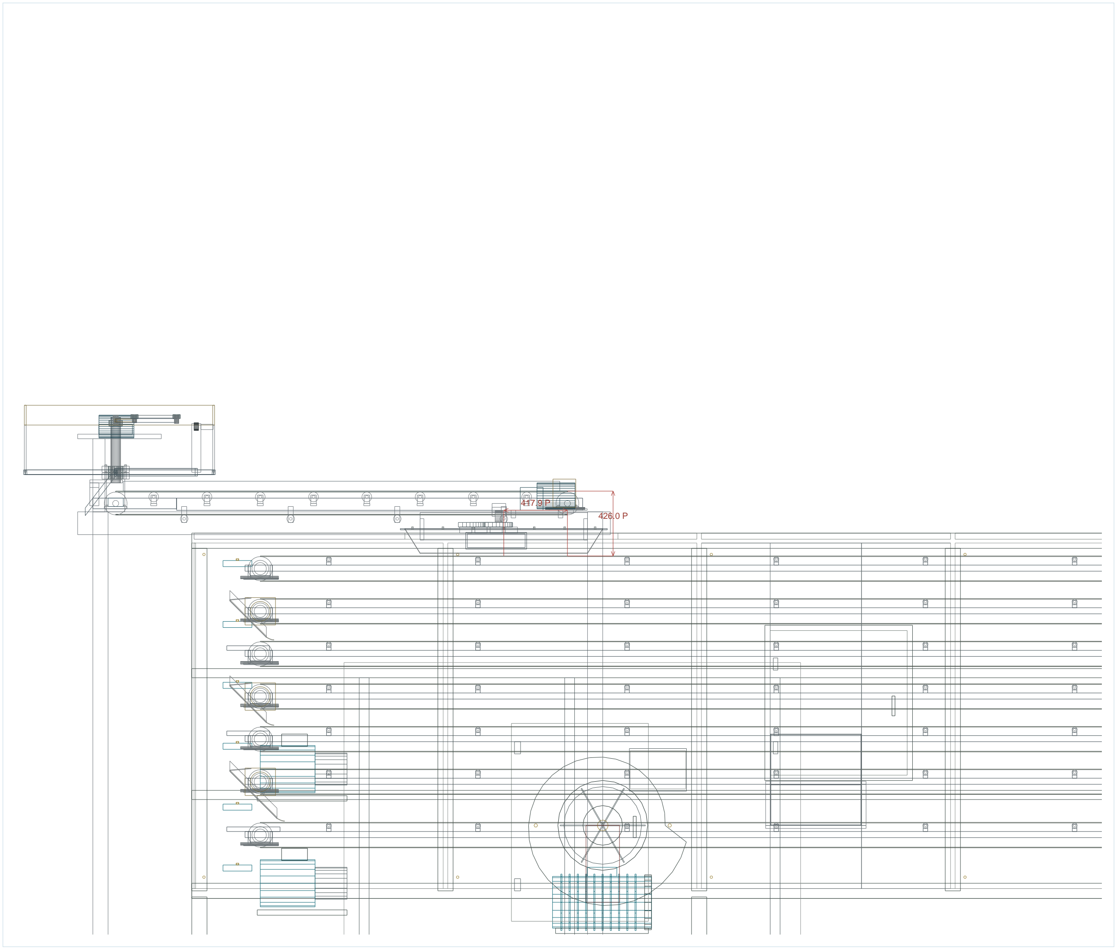
[picture p46: figure]

O: documentado P: propuesto R: referencial / pendiente de fabricante. Geometría de implantación; no apta para fabricación sin validación. | Hoja 14

LATERAL / 1:20

SUPERIOR / 1:20

500.0 P | 500.0 P

Origen desde NPT +3276.0 mm / recepcion +2850.0 mm. Desnivel entre referencias 426.0 mm. Desplazamiento horizontal 417.9 mm.

Abertura de origen 300.0 x 500.0 mm / receptora 300.0 x 500.0 mm P. Centros, caras de banda y bocas se acotan de manera independiente.

P: cuello de acople con brida y registro al nivel1; repartidor±20°.

## R18 / C06 / CHUTA2500 / COLECTORA TRANSVERSAL C04 / DETALLE 1:20

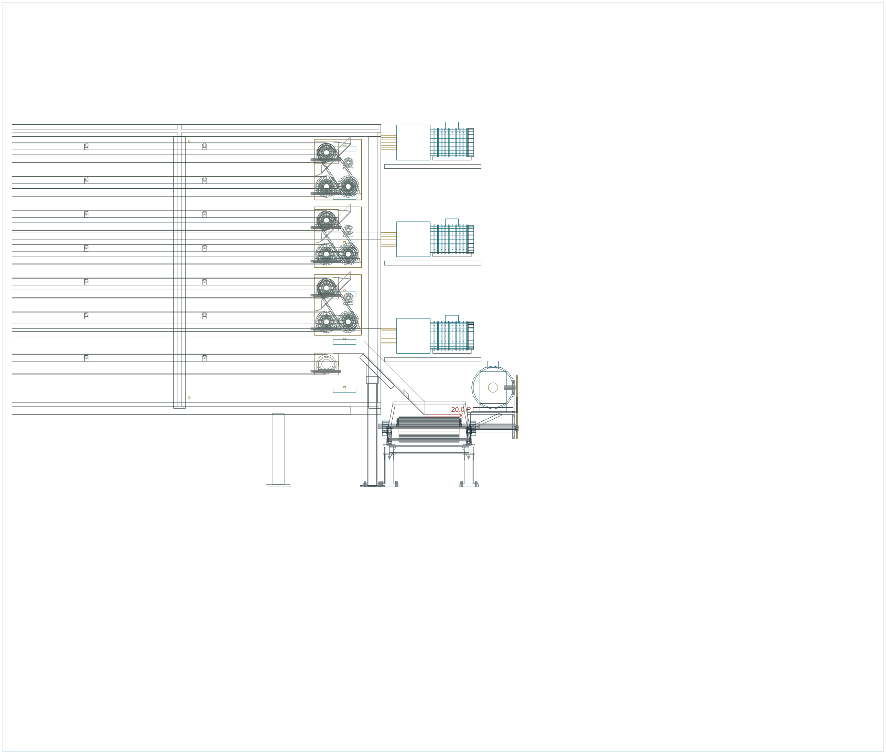
[picture p47: figure]

O: documentado P: propuesto R: referencial / pendiente de fabricante. Geometría de implantación; no apta para fabricación sin validación. | Hoja 15

LATERAL / 1:20

SUPERIOR / 1:20

2500.0 P | 2500.0 P

Origen desde NPT +601.0 mm / recepcion +581.0 mm. Desnivel entre referencias 20.0 mm. Desplazamiento horizontal 0.0 mm.

Abertura de origen 120.0 x 2500.0 mm / receptora 120.0 x 2500.0 mm P. Centros, caras de banda y bocas se acotan de manera independiente.

Chuta45° ancha; material conserva posición transversal. C04 recibe u500–3000; no reducción a garganta200 ni foso.

## R18 / AGUA, AGLOMERANTE Y CONTROL DE RECORRIDO

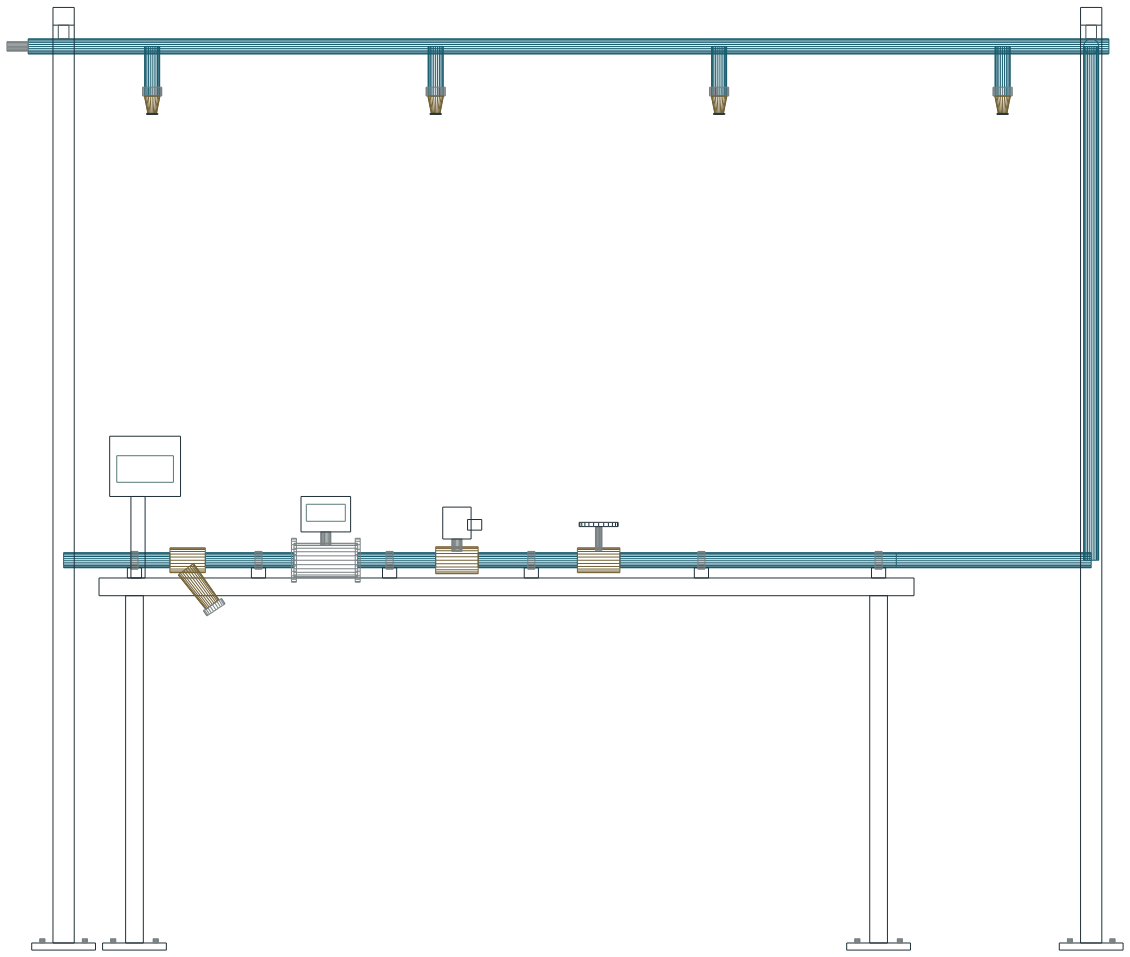
[picture p48: figure]

O: documentado P: propuesto R: referencial / pendiente de fabricante. Geometría de implantación; no apta para fabricación sin validación. | Hoja 16

SUMINISTRO DIRECTO A MEZCLADORA / DOS CIRCUITOS INDEPENDIENTES

Agua: filtro Y / caudalimetro totalizador / solenoide normalmente cerrada / valvula reguladora manual / manifold con boquillas en abanico.

Aglomerante: alimentacion directa por boca propia para solido o colector independiente para liquido. El agua de proceso y el aglomerante no se mezclan dentro de las tuberias.

Por cargas: volumen acumulado en litros y cierre al alcanzar consigna. En continuo: caudal en L/min medido y ajuste manual. La aplicacion conserva consignas; no acciona valvulas reales.

Recepcion de briquetas: recorrido continuo C05-C03 en el sentido del transporte, sin retroceso ni elevacion artificial. Repartidor transversal representado como mecanismo P.

Adaptaciones mecanicas P. Perfiles, espesores y revestimientos son decisiones geometricas; el modelo no incorpora calculo de resistencia ni certificacion de fabricante.

## R15 / SECADOR / SEIS PISOS UTILES Y TRANSFERENCIAS ALTERNADAS P

O: documentado P: propuesto R: referencial / pendiente de fabricante. Geometría de implantación; no apta para fabricación sin validación. | Hoja 17

LATERAL INTERIOR / 1:50 / CARCASA EXCLUIDA PARA MOSTRAR EL RECORRIDO

N1 / Z local +2850.0 280.0 P N2 / Z local +2570.0 280.0 P N3 / Z local +2290.0 280.0 P N4 / Z local +2010.0 280.0 P N5 / Z local +1730.0 280.0 P N6 / Z local +1450.0

EXTREMO DE TRANSFERENCIA / 1:10 | CONVERGENCIA Y COLECTORA C06 / 1:20

Seis pisos de secado: paso vertical de 280 mm entre superficies utiles. Cinco chutas de cambio a 45 grados y pestañas deflectoras revestidas. El cuello superior registrado acopla la recepcion exterior al primer piso.

C06 evacua el sexto piso hacia chuta ancha2500 a45 grados. C04B500 recibe transversalmente sin garganta200 ni foso. Secador apoyado al piso; C06 no es un septimo piso de secado.

## R15 / PRENSA A C05 / DESPRENDIMIENTO ADOPTADO Y ZAPATAS REVESTIDAS P

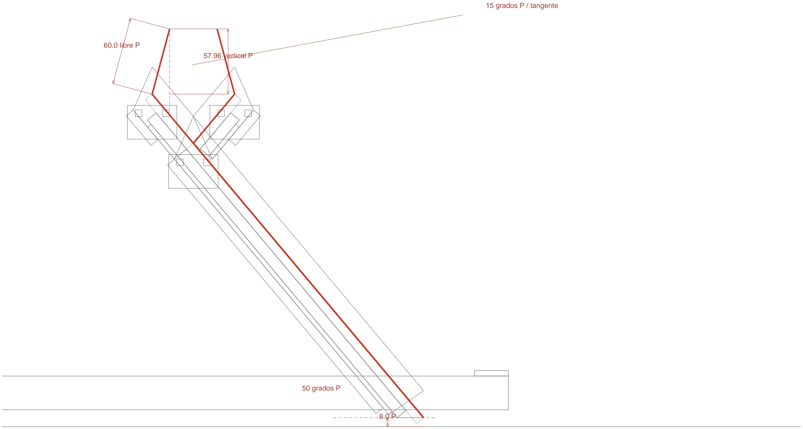
[picture p49: figure]
60.0 libre P; 57.96 vertical P; 15 grados P / tangente; 50 grados P
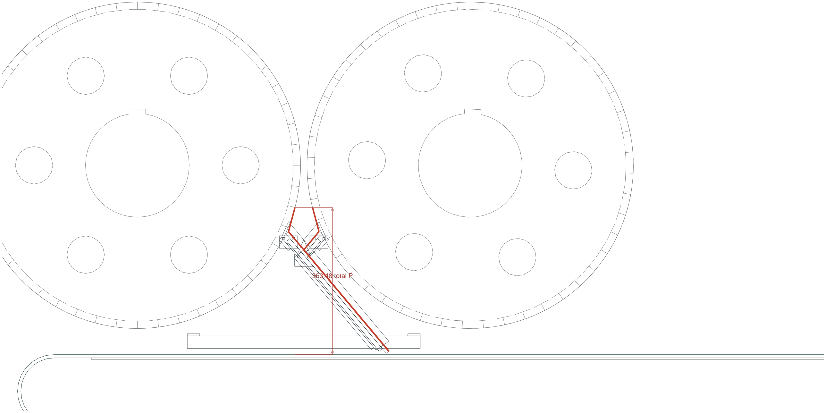
[picture p50: figure]
353.48 total P

O: documentado P: propuesto R: referencial / pendiente de fabricante. Geometría de implantación; no apta para fabricación sin validación. | Hoja 18
RODILLOS Y RECEPCION / LATERAL 1:5 | CAPTURA Y CANAL COMUN / LATERAL 1:2

Recorrido adoptado P

Tangente descendente adoptada P: 15 grados de la vertical; posicion radial a 75 grados. Tramo libre sobre la tangente 60.0 mm / descenso vertical 57.96 mm. Desnivel TOTAL hasta C05 353.48 mm: incluye el recorrido guiado, no es caida libre.

Dos labios de captura a 50.0 grados confluyen en un canal comun a 50.0 grados. UHMWPE 8 mm / goma 10 mm / acero 4 mm. Salida 8.0 mm sobre C05; placas, soportes y tornillos independientes.

C05 conserva tambores, motor, ancho y longitud. El angulo de desprendimiento es un criterio geometrico P adoptado para esta revision; no es una medicion del producto.

## R15 / REPARTIDOR OSCILANTE B500 / PIVOTE Y BIELA-MANIVELA P

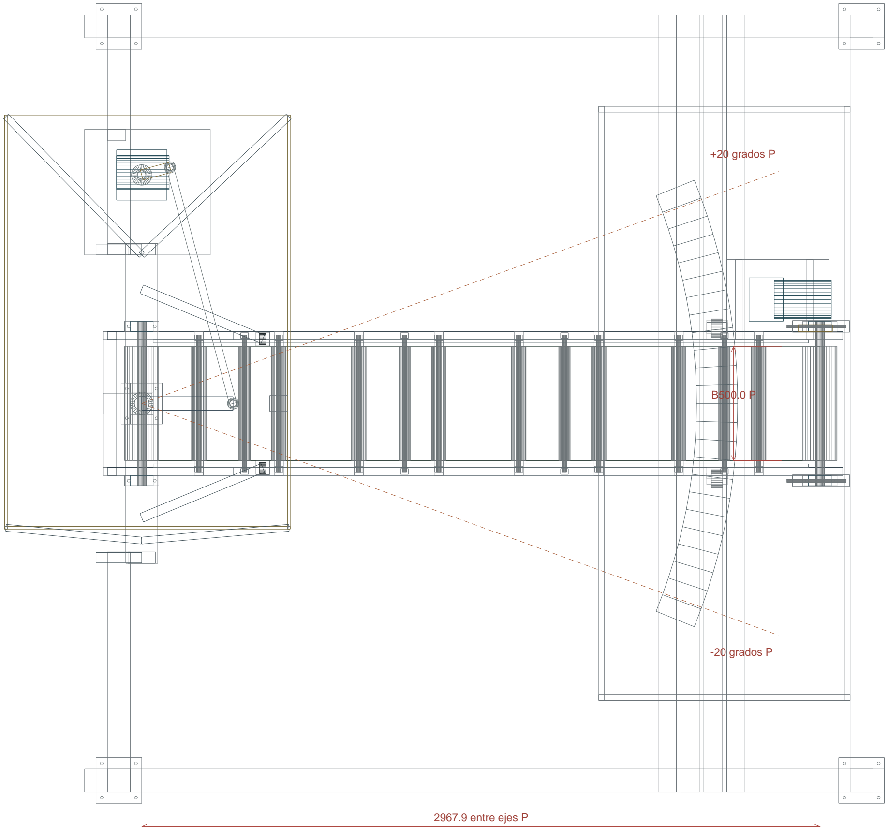
[picture p51: figure]
-20 grados P; +20 grados P; 2967.9 entre ejes P

O: documentado P: propuesto R: referencial / pendiente de fabricante. Geometría de implantación; no apta para fabricación sin validación. | Hoja 19
PLANTA DEL MECANISMO / 1:15 | LATERAL Y APOYOS / 1:20

Banda 500 mm; entre ejes 2967.9 mm; barrido angular simetrico +/-20 grados. El pivote superior se apoya en dos alojamientos y un pasador vertical. Tensores, rodamientos, guardas laterales y topes se conservan como piezas rigidas.

Biela-manivela: radio 127.93 mm / biela 1069.41 mm / balancin 400.0 mm / distancia entre pivotes 1000.0 mm. Motorreductor ilustrativo 3.75 rpm. La animacion resuelve el mecanismo cerrado, no deforma las bielas.

Barrido del borde de banda sobre ancho util de 2500 mm. Posicion central representada en CAD; los extremos de carrera se identifican con topes mecanicos. Geometria y mecanismos nuevos clase P.

# SESUVECA | PLANTA BRIQUETADORA | R18

## 01 | Comparacion R17 / R18 y restricciones de altura

GEOMETRIA PROPUESTA P / alturas desde NPT / cotas mm / sin aprobacion de fabricacion. | R18 D01
Equipo | Base R17 | Base R18 | Posicion X R18 | Criterio
tolva | 900.0 | 0.0 | 0.000 | Altura fija / datum bloqueado
dosificador | 2000.0 | 2000.0 | 12419.529 | Bancada ajustable
mezcladora | 1100.0 | 1100.0 | 10569.529 | Bancada ajustable
briquetadora | 0.0 | 0.0 | 24628.187 | Altura fija / datum bloqueado
secador | 2200.0 | 0.0 | 37717.116 | Altura fija / datum bloqueado
Cinta | L entre ejes | Pendiente | Giro planta | Cola Z | Cabeza Z | Clase
C01 | 9495.0 | 18.673470 | 0.0 | 450.000 | 3490.056 | P
C02 | 9495.0 | 16.993636 | 0.0 | 420.000 | 3195.061 | P
C05 | 2500.0 | 0.000000 | 0.0 | 1182.000 | 1182.000 | P
C03 | 9840.0 | 15.623149 | 0.0 | 850.000 | 3500.000 | P
C04 | 4350.0 | 0.000000 | 90.0 | 500.000 | 500.000 | R

Suma de cinco cintas externas: 40.580 -> 35.680 m. Envolvente mecanica: 58.855 m. Envolvente con accesos: 61.117 x 7.850 m. Limite longitudinal: 75 m.

Las cotas geometricas y cantidades proceden de un mismo modelo R18. Las piezas fabricadas de tolva/prensa y el cuerpo del secador no se elevan para acomodar transportadores. C01 cambia de servicio: seleccion de carga y par pendiente antes de compra.

# SESUVECA | PLANTA BRIQUETADORA | R18

## 02 | Tolva fabricada al piso y alimentador C01 directo

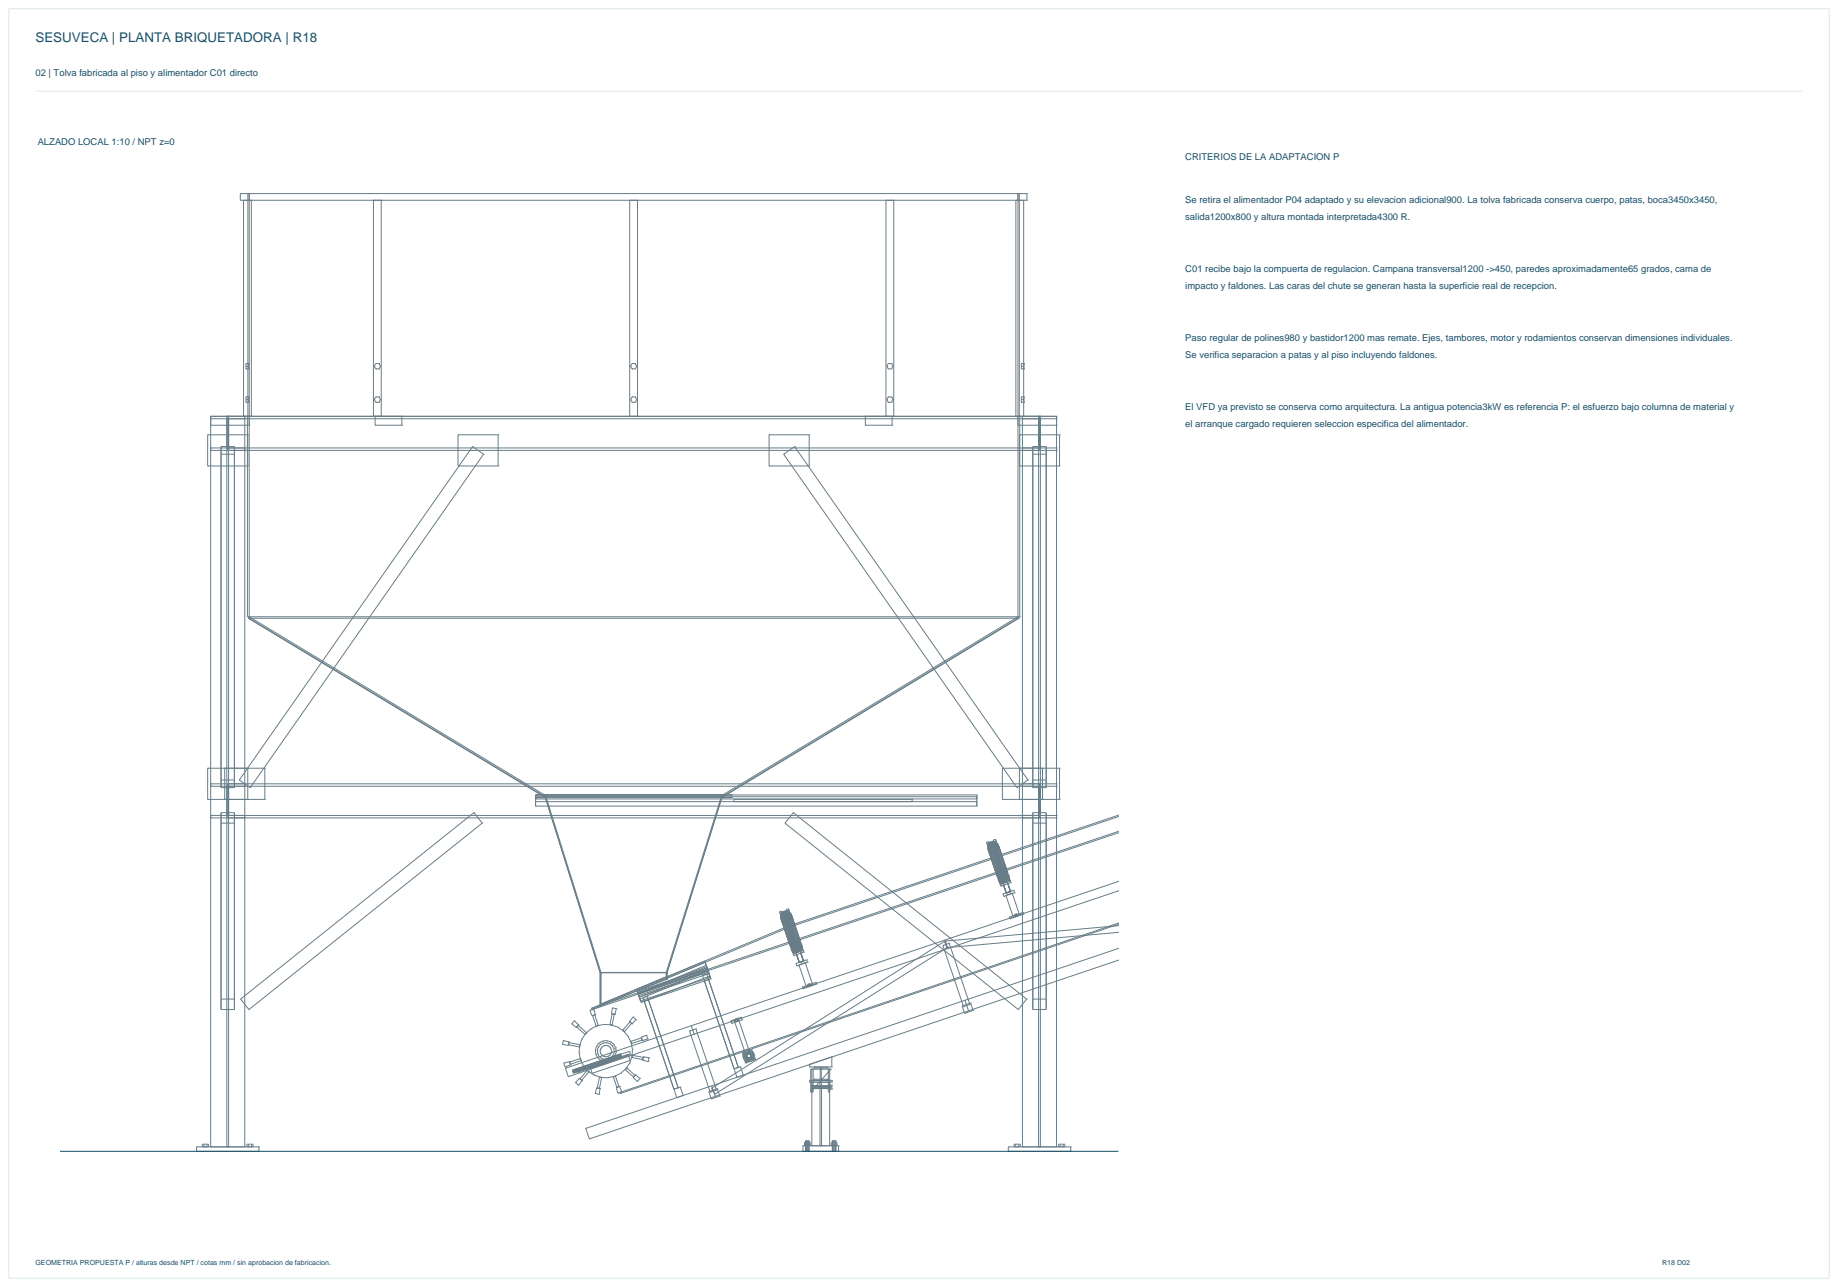
[picture p52: page 21]

CRITERIOS DE LA ADAPTACION P

Se retira el alimentador P04 adaptado y su elevacion adicional900. La tolva fabricada conserva cuerpo, patas, boca3450x3450,
salida1200x800 y altura montada interpretada4300 R.

C01 recibe bajo la compuerta de regulacion. Campana transversal1200 ->450, paredes aproximadamente65 grados, cama de
impacto y faldones. Las caras del chute se generan hasta la superficie real de recepcion.

Paso regular de polines980 y bastidor1200 mas remate. Ejes, tambores, motor y rodamientos conservan dimensiones individuales.
Se verifica separacion a patas y al piso incluyendo faldones.

El VFD ya previsto se conserva como arquitectura. La antigua potencia3kW es referencia P: el esfuerzo bajo columna de material y
el arranque cargado requieren seleccion especifica del alimentador.

# SESUVECA | PLANTA BRIQUETADORA | R18

## 03 | Prensa fija, recepcion proxima C05 y encuentro con C03

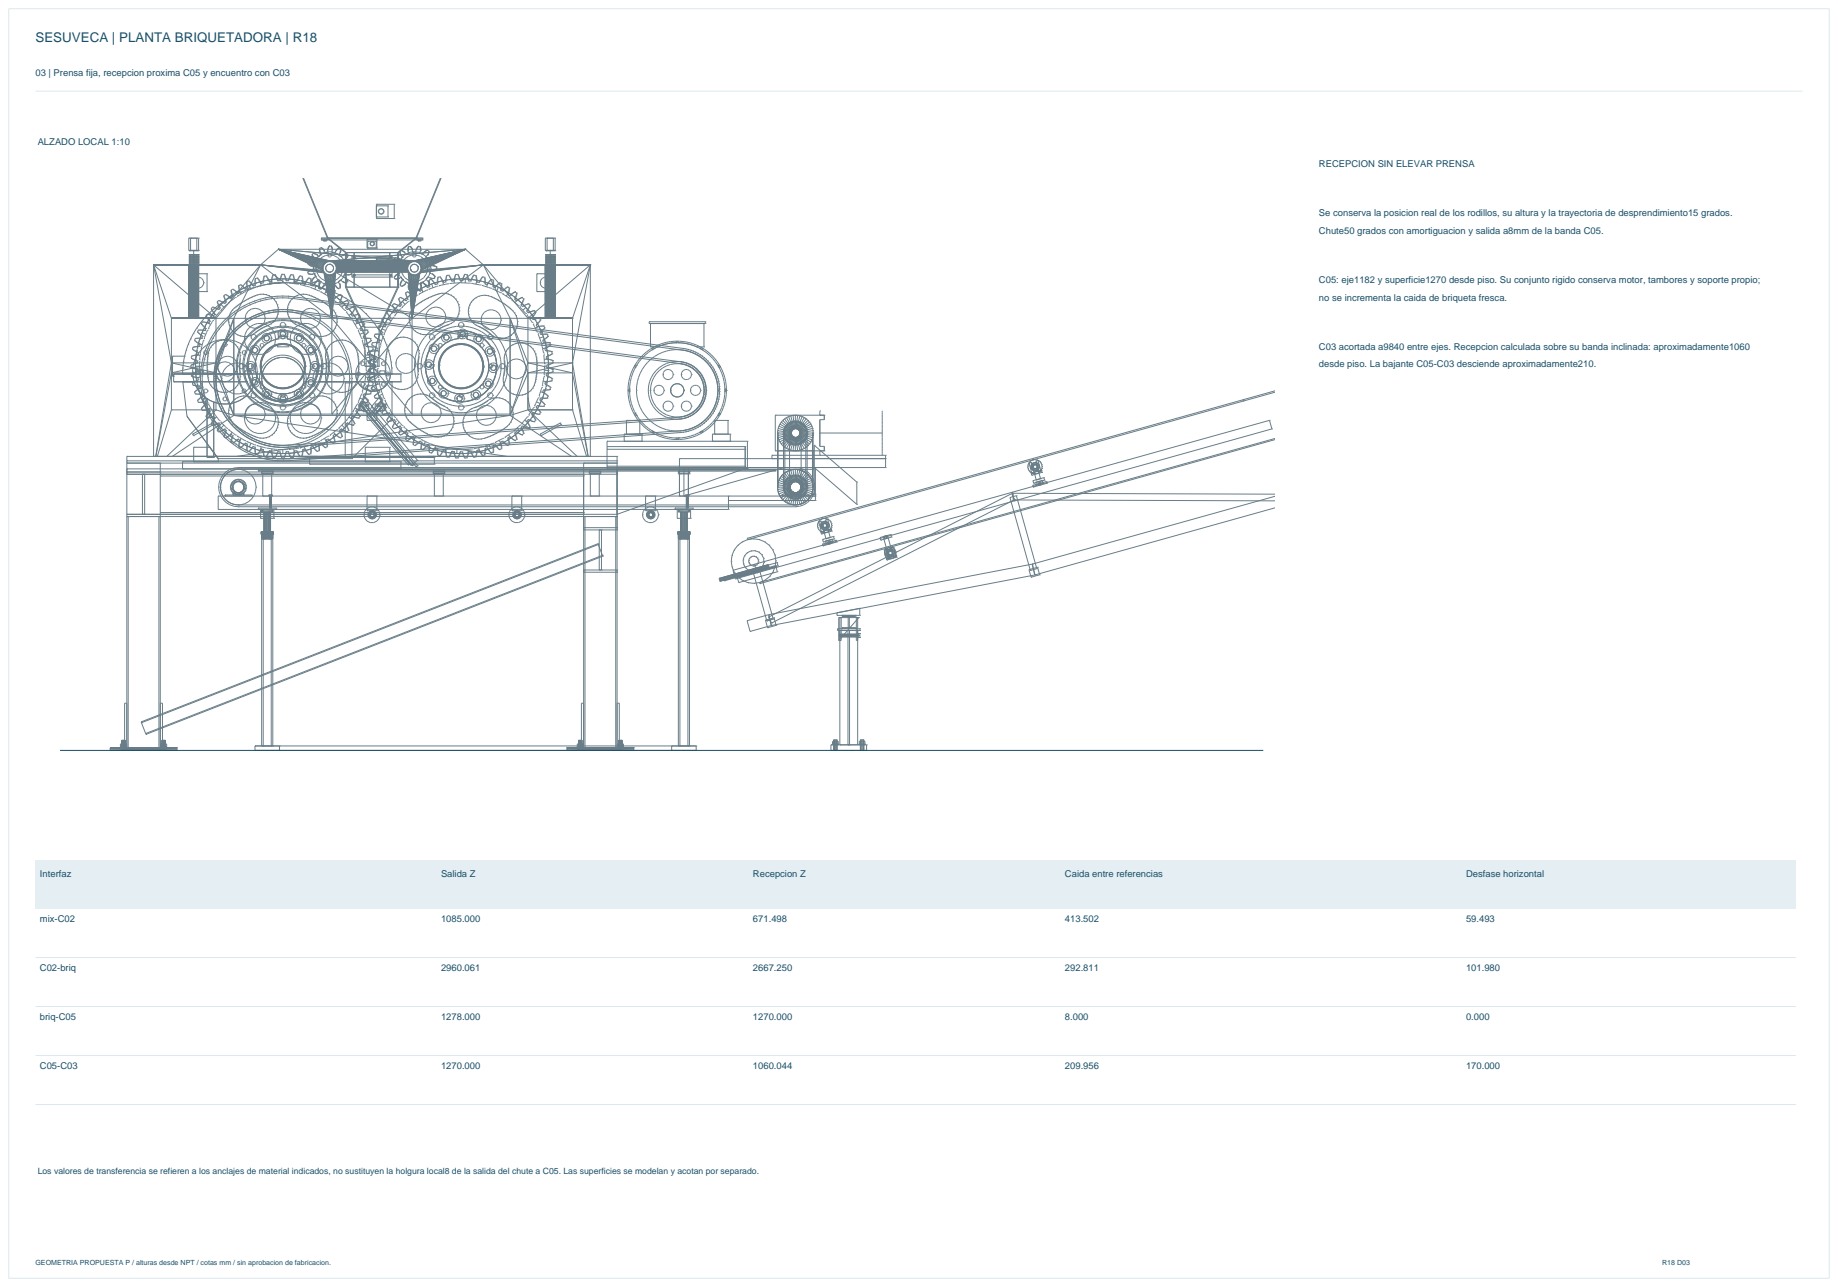
[picture p53: page 22]

RECEPCION SIN ELEVAR PRENSA

Se conserva la posicion real de los rodillos, su altura y la trayectoria de desprendimiento15 grados.
Chute50 grados con amortiguacion y salida a8mm de la banda C05.

C05: eje1182 y superficie1270 desde piso. Su conjunto rigido conserva motor, tambores y soporte propio;
no se incrementa la caida de briqueta fresca.

C03 acortada a9840 entre ejes. Recepcion calculada sobre su banda inclinada: aproximadamente1060
desde piso. La bajante C05-C03 desciende aproximadamente210.

Los valores de transferencia se refieren a los anclajes de material indicados, no sustituyen la holgura local8 de la salida del chute a C05. Las superficies se modelan y acotan por separado.

# SESUVECA | PLANTA BRIQUETADORA | R18

## 04 | Secador al piso, seis niveles y salida transversal C04

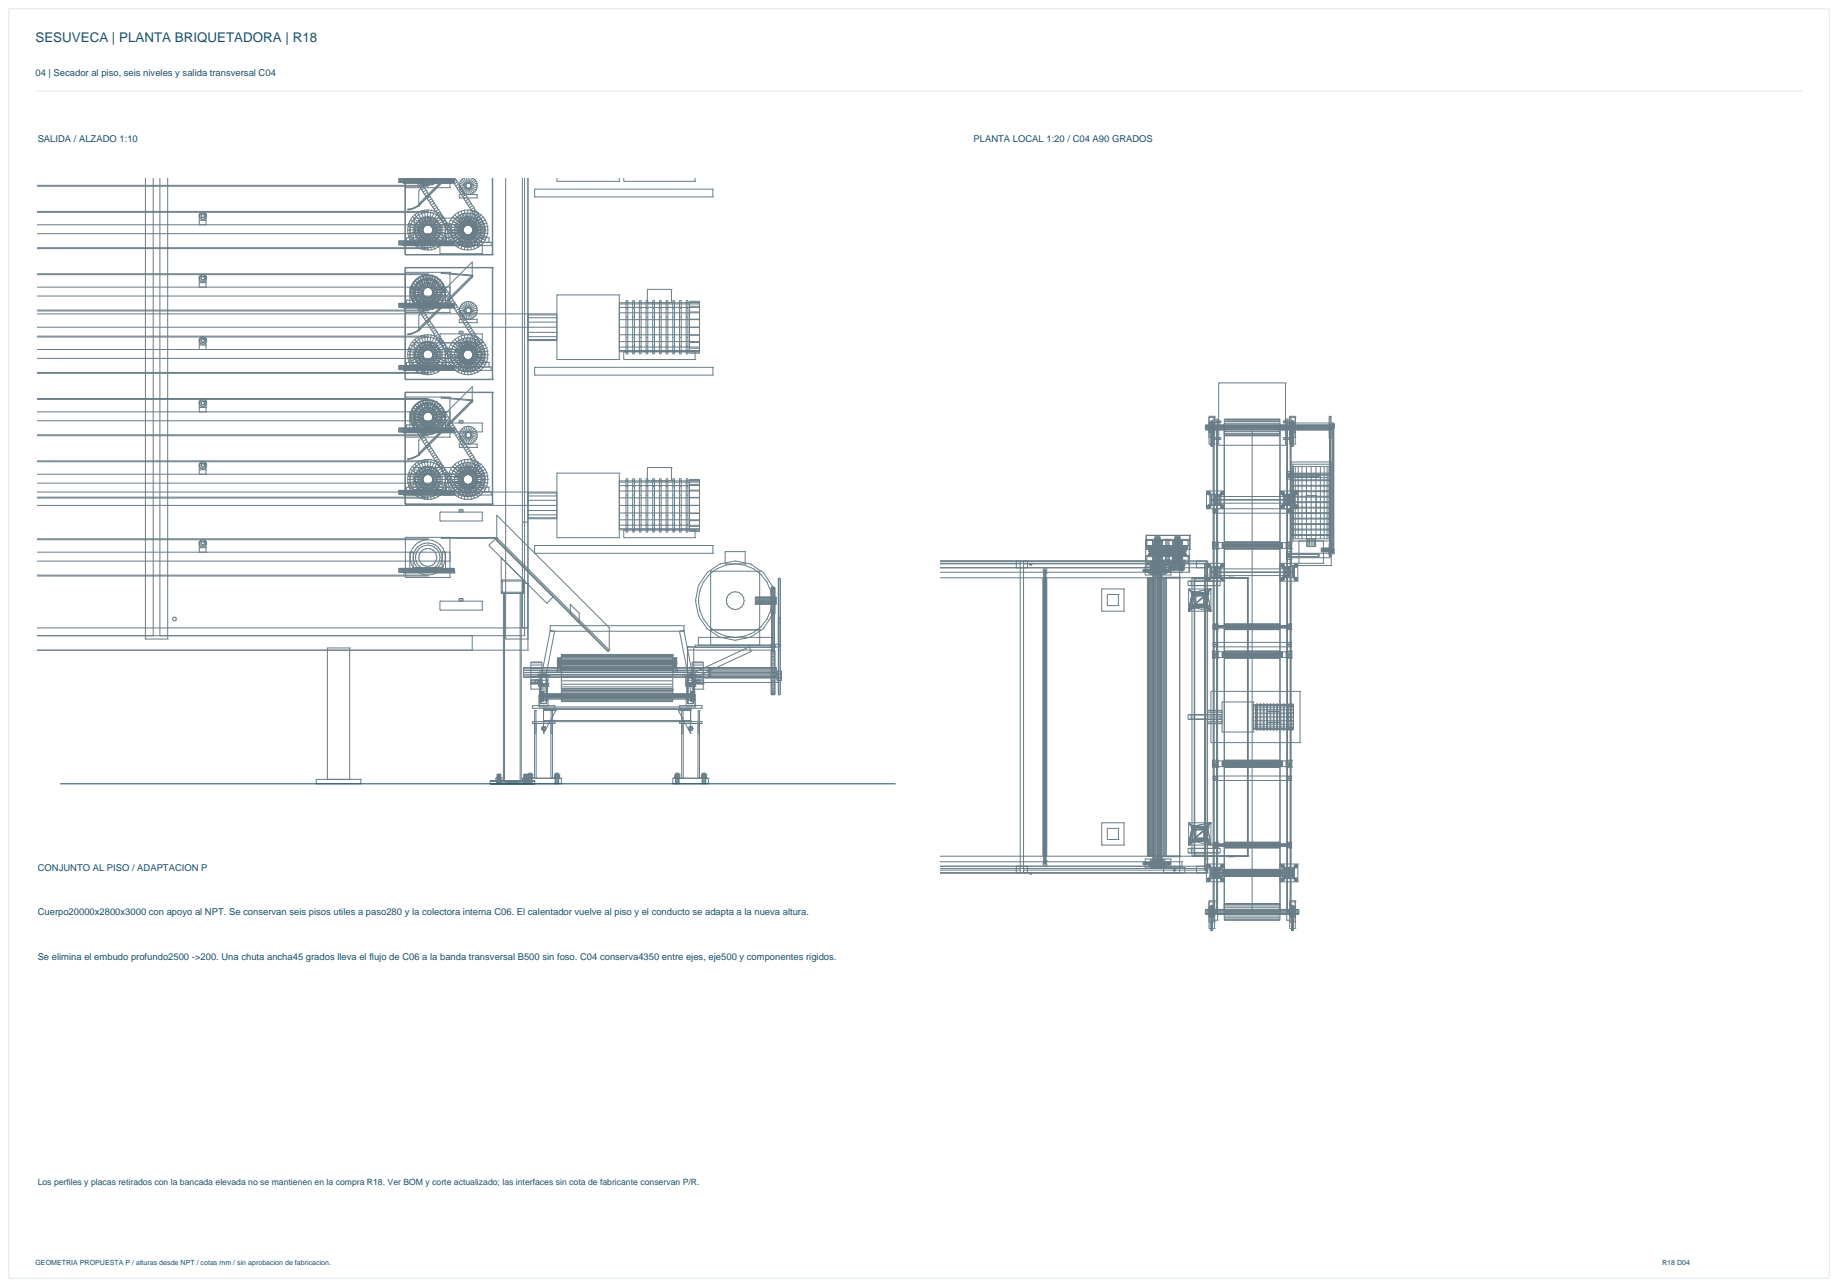
[picture p54: page 23]

CONJUNTO AL PISO / ADAPTACION P

Cuerpo20000x2800x3000 con apoyo al NPT. Se conservan seis pisos utiles a paso280 y la colectora interna C06. El calentador vuelve al piso y el conducto se adapta a la nueva altura.

Se elimina el embudo profundo2500 ->200. Una chuta ancha45 grados lleva el flujo de C06 a la banda transversal B500 sin foso. C04 conserva4350 entre ejes, eje500 y componentes rigidos.

Los perfiles y placas retirados con la bancada elevada no se mantienen en la compra R18. Ver BOM y corte actualizado; las interfaces sin cota de fabricante conservan P/R.
