acevedocrisologopablo48-lgtm/planta-briquetadora/r21/DOSSIER_R21.pdf

# PLANTA BRIQUETADORA / R21

## 01 / CONJUNTO Y ALTURAS DE TRANSPORTADORES

Milímetros / alturas desde NPT. O: documentado; P: propuesto; R: reconstruido. Equipos a sus alturas originales.

A1 horizontal / geometría de implantación y flujo. Sin cálculo de capacidad ni validación dinámica del producto. | Hoja 1

## DISPOSICIÓN LATERAL / 1:100

## PLANTA / 1:100

Cinta | L entre ejes | Pendiente ° | Cola Z | Cabeza Z | Ancho útil
C01 | 9495.00 | 17.72 | 600.00 | 3490.06 | 500.00
C02 | 9495.00 | 16.99 | 420.00 | 3195.06 | 500.00
C05 | 2500.00 | 0.00 | 1182.00 | 1182.00 | 500.00
C03 | 11800.00 | 12.98 | 850.00 | 3500.00 | 2500.00
C04 | 4350.00 | 0.00 | 500.00 | 500.00 | 500.00

Envolvente 59.98 m / con accesos 62.24 m / suma de cintas 37.64 m / límite75 m.

Tolva +0 / prensa +0 / secador +0 mm: sin elevar cuerpos ni modificar patas. Mezcladora y dosificador conservan sus bases.

## 02 / TOLVA A C01 Y RECEPCIÓN DE MEZCLADORA

Milímetros / alturas desde NPT. O: documentado; P: propuesto; R: reconstruido. Equipos a sus alturas originales.

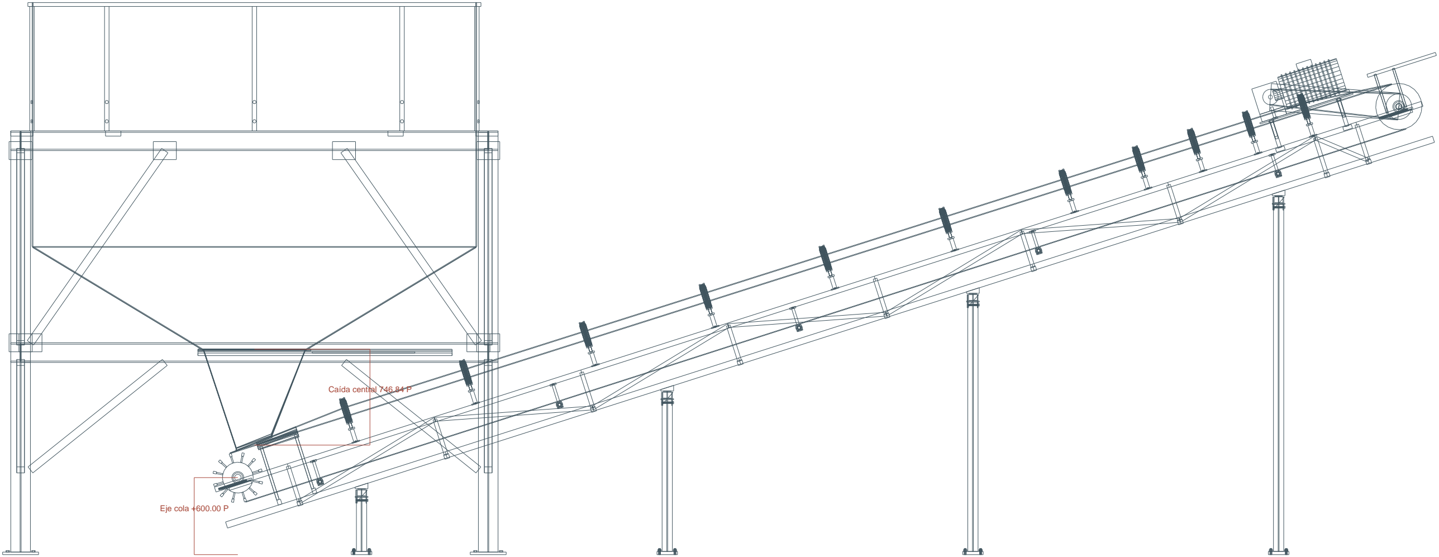
[picture p80: figure]
Eje cola +600.00 P; Caída central 746.84 P

A1 horizontal / geometría de implantación y flujo. Sin cálculo de capacidad ni validación dinámica del producto. | Hoja 2

## TOLVA Y ALIMENTACIÓN / 1:20 / DETALLE DE LA COLA

Parámetro | R20 | R21
Cola C01 / eje | 450.00 | 600.00
Pendiente C01 | 18.67347 | 17.72066
Entre ejes | 9495.00 | 9495.00
Cabeza C01 Z | 3490.06 | 3490.06
Recepción centrada X | 2074.20 | 2074.20

## CAMPANA / PLANTA 1:10

Salida tolva1200 ×800 O / recepción450 ×300 P en banda B500.

Pared lateral mínima 60.38° / acero18 mm sobre banda; faldón flexible a2 mm.

Al subir más la cola se aplanan las paredes; se adopta600 mm.

## 03 / RECORRIDO Y TRANSFERENCIAS CALCULADAS

Milímetros / alturas desde NPT. O: documentado; P: propuesto; R: reconstruido. Equipos a sus alturas originales.

A1 horizontal / geometría de implantación y flujo. Sin cálculo de capacidad ni validación dinámica del producto. | Hoja 3
Conexión | Origen Z | Banda / boca Z | Desnivel | Delta X | Ángulo central
tolva-C01 | 1600.00 | 853.16 | 746.84 | 0.00 | 90.00°
C01-mix | 3255.06 | 3000.00 | 255.06 | 84.92 | 71.59°
adapter-mix | 3000.00 | 2950.00 | 50.00 | 0.00 | 90.00°
mix-C02 | 1085.00 | 689.57 | 395.43 | 0.00 | 90.00°
C02-briq | 2960.06 | 2667.25 | 292.81 | 100.00 | 70.80°
briq-C05 | 1278.00 | 1270.00 | 8.00 | 0.00 | 90.00°
C05-C03 | 1270.00 | 1055.00 | 215.00 | 230.00 | 43.07°
dry-C04 | 601.00 | 581.00 | 20.00 | 0.00 | 90.00°
dos-mix | 2675.00 | 2500.00 | 175.00 | 0.00 | 6.05°
C03-dry | 3603.29 | 2850.00 | 753.29 | 523.81 | 55.19°

El desnivel total de una conexión no equivale al vuelo libre ni al ángulo de cada pared.

Punto del recorrido | Resultado geométrico
Tolva / C01 | Centro bajo compuerta; paredes laterales >=60°; paso de polines980mm conservado
C01 / mezcladora | Cabeza mantiene Z; cuello más vertical, sin mover cuerpo de mezcladora
Mezcladora / C02 | DeltaX 0.00 / caída 395.43 / mínimo entre bordes 325.05mm
Rodillos / C05 | Se conserva recepción próxima; labio / banda 8.00mm P
C05 / C03 | Banda a banda 215.00mm; guía revestida conservada
C03 / secador | Guía directa desde banda, sin torre ficticia; vuelos69,24 /40mm P
Secador / C04 | Salida transversal a45°; labio20mm sobre banda; cuerpo del secador al piso

Agua y aglomerante permanecen conectados al mezclador. Giros, superficies receptoras y simulación usan el mismo proyecto.
