acevedocrisologopablo48-lgtm/planta-briquetadora/entregas/R44/bigbag/BIG_BAG_1t_ISOMETRICA.png

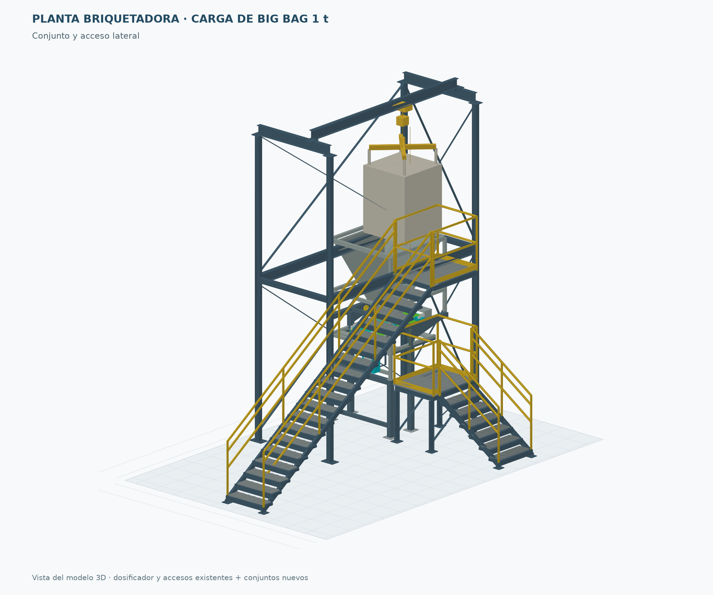
entregas/R44/bigbag/BIG_BAG_1t_ISOMETRICA.png
