acevedocrisologopablo48-lgtm/planta-briquetadora/entregas/R44/mixer-motor/ACCESO_MOTOR_MEZCLADORA.png

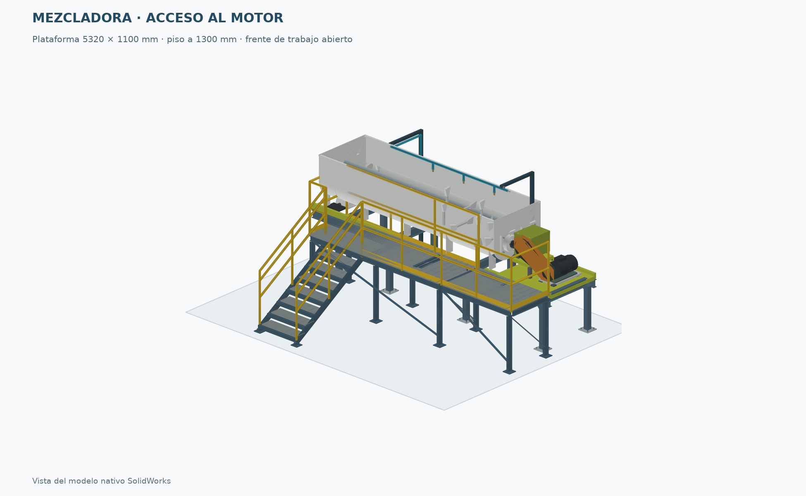
entregas/R44/mixer-motor/ACCESO_MOTOR_MEZCLADORA.png
