acevedocrisologopablo48-lgtm/planta-briquetadora/entregas/R45/BIGBAG_MANITOU_ISOMETRICA.png

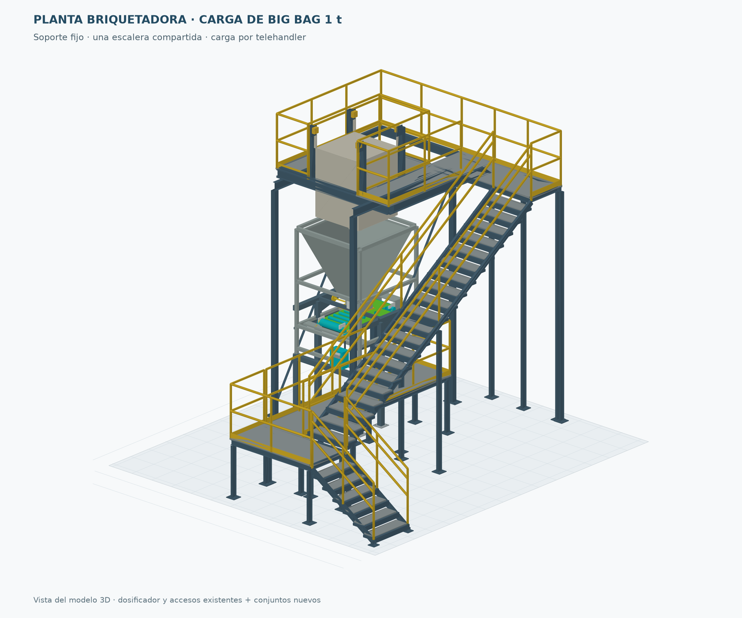
entregas/R45/BIGBAG_MANITOU_ISOMETRICA.png
