acevedocrisologopablo48-lgtm/planta-briquetadora/entregas/R46/ACCESO_COMPACTO_ISOMETRICA.png

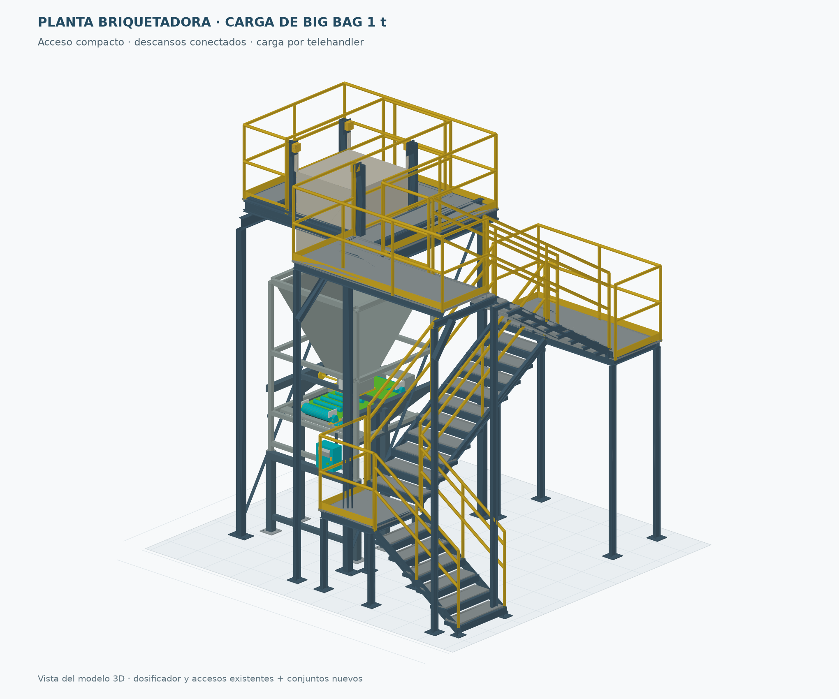
entregas/R46/ACCESO_COMPACTO_ISOMETRICA.png
