acevedocrisologopablo48-lgtm/planta-briquetadora/entregas/R47/ACCESO_LONGITUDINAL_ISOMETRICA.png

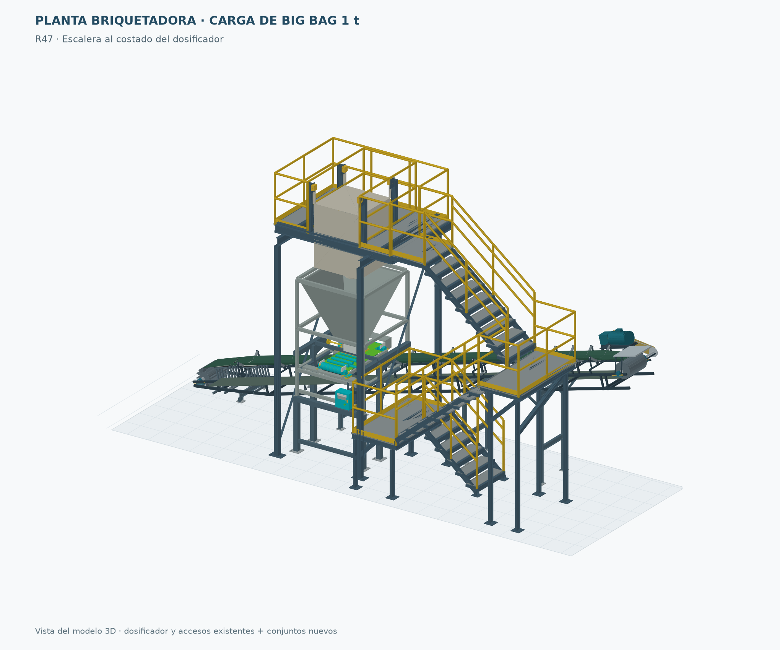
entregas/R47/ACCESO_LONGITUDINAL_ISOMETRICA.png
