acevedocrisologopablo48-lgtm/planta-briquetadora/entregas/R47/ACCESO_LONGITUDINAL_PLANTA.png

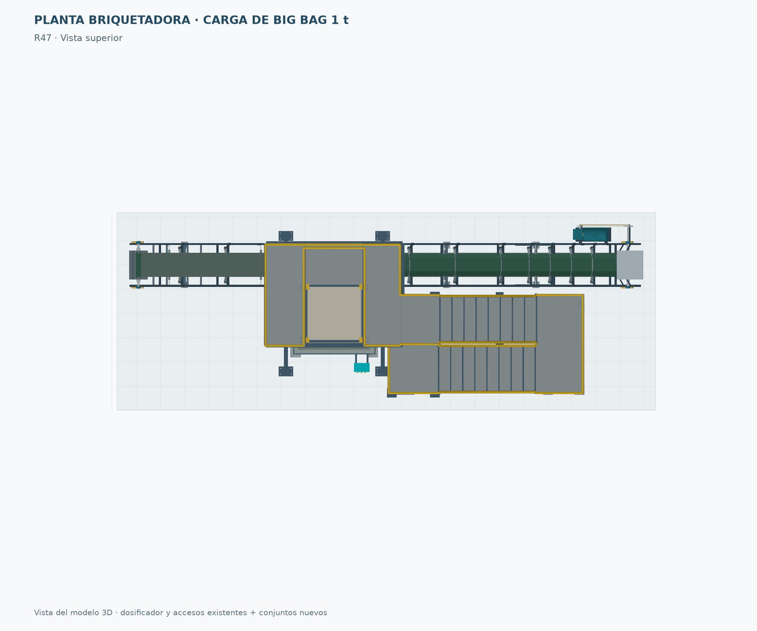
entregas/R47/ACCESO_LONGITUDINAL_PLANTA.png
