acevedocrisologopablo48-lgtm/planta-briquetadora/entregas/R48/ACCESO_PERPENDICULAR_PLANTA.png

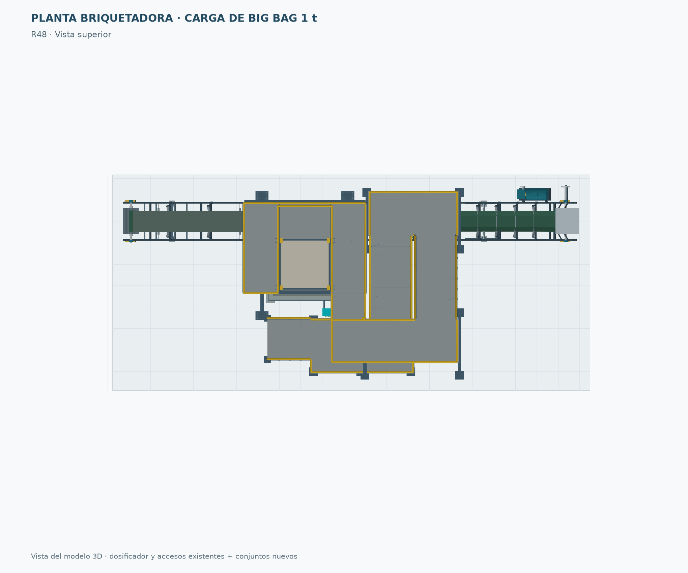
entregas/R48/ACCESO_PERPENDICULAR_PLANTA.png
