acevedocrisologopablo48-lgtm/planta-briquetadora/r22/BOM_R22.csv

ID | Cantidad | Descripcion | Clase | Material | Volumen_mm3
briquetadora:R22-native-frame-local-passage | 1 | Bastidor R03 original con ventana local640mm | P | Acero original | 210886920.74886665
briquetadora:R22-local-bearing-rail-65 | 1 | Asiento local2200x110x56 | P | A36 | 13552000
briquetadora:R22-local-bearing-rail-815 | 1 | Asiento local2200x110x56 | P | A36 | 13552000
