acevedocrisologopablo48-lgtm/planta-briquetadora/r18/TRANSFERENCIAS_R18.csv

id | label | from | to | horizontalMm | fallMm | centerAngleDeg | class | kind | note
tolva-C01 | Carbón · compuerta / alimentador C01 | [2074.2,0,1600] | [2074.199999611361,0,783.4264167239605] | 3.886389094986953e-7 | 816.5735832760395 | 89.99999997273073 | P | chute | Tolva fabricada sin pedestal. C01 alimenta bajo compuerta; campana 1200 a 450 mm, cama de impacto y faldones. Accionamiento sujeto a carga bajo tolva; no equivale automáticamente al servicio anterior.
C01-mix | C01 / mezcladora | [11214.52856466806,0,3255.0556223440576] | [11344.52856466806,0,3000] | 130 | 255.0556223440576 | 62.99239084499839 | R | chute
adapter-mix | Adaptador / boca de mezcladora | [11344.52856466806,0,3000] | [11344.52856466806,0,2950] | 0 | 50 | 90 | R | chute
mix-C02 | Mezcladora / C02 | [16469.52856466806,0,1085] | [16410.035627216133,0,671.4984309710867] | 59.49293745192699 | 413.5015690289133 | 81.81269907440267 | P | chute | Chute P con registro y faldones; altura libre mayor de300mm.
C02-briq | C02 / briquetadora | [25628.186574452142,0,2960.0607357735903] | [25728.186574452146,20,2667.25] | 101.98039027185926 | 292.8107357735903 | 70.7977481685204 | P | chute | Cuello575mm P con transición conformada400mm y aproximación abierta175mm, sensor y registro.
briq-C05 | Briquetadora / C05 · cassette próximo P | [25932.802011835203,20,1278] | [25932.802011835203,20,1270] | 0 | 8 | 90 | P | chute | P: tangente de desprendimiento15° adoptada; dos labios50° y canal común50°, goma10/UHMW8, salida8sobrebanda.
C05-C03 | C05 / C03 · transferencia transversal propuesta 500 mm | [27628.186474452144,0,1270] | [27798.186574452146,0,1060.04377474937] | 170.0001000000011 | 209.95622525063004 | 51.00314793849059 | P | chute | Cola C03 a +850 mm P y recepción 170 mm después de la cabeza C05; longitud y cabeza conservadas. Guías laterales abiertas, sin fondo ni placas transversales. Trayectoria, tamaño y resistencia de briqueta pendientes de ensayo.
dry-C04 | C06 / chuta2500 / colectora transversal C04 | [58082.11584926732,0,601] | [58082.11584926732,0,581] | 0 | 20 | 90 | P | chute | Chuta45° ancha; material conserva posición transversal. C04 recibe u500–3000; no reducción a garganta200 ni foso.
dos-mix | Aglomerante directo a mezcladora | [12419.52856466806,1900,2675] | [12419.52856466806,250,2500] | 1650 | 175 | 6.054191894114834 | P | chute
C03-traverse | C03 / cola fija repartidor | [37107.11584926732,0,3345] | [37217.11584926732,0,3276] | 110 | 69 | 32.0989272547852 | P | chute
traverse-dry | Repartidor oscilante / secador | [40185.001994607526,0,3276] | [39767.11584926732,0,2850] | 417.886145340206 | 426 | 45.550874434030334 | P | chute | P: cuello de acople con brida y registro al nivel1; repartidor±20°.
