acevedocrisologopablo48-lgtm/planta-briquetadora/r29/MATERIALES_R29.csv

pos | conjunto | cantidad | descripcion | material | medidas_mm | nota
01 | Dosificador / bancada | 4 | Placa base | ASTM A36 | 220.00 x 220.00 x 12.00 | Cotas tomadas de la pieza representada; P.
02 | Dosificador / bancada | 2 | Columna SHS 100 x 100 x 5 | S275JRH | L 2088.00 | Cotas tomadas de la pieza representada; P.
03 | Dosificador / bancada | 2 | Columna SHS 100 x 100 x 5 | S275JRH | L 1088.00 | Cotas tomadas de la pieza representada; P.
04 | Dosificador / bancada | 4 | Viga SHS 100 x 100 x 5 | S275JRH | L 1700.00 | Cotas tomadas de la pieza representada; P.
05 | Dosificador / bancada | 2 | Cartela triangular, chapa 10 | ASTM A36 | 250 x 1000 x 10 | Triángulo según geometría: borde vertical250 y proyección1000. No usar envolvente como rectángulo de corte.
06 | Dosificador / bancada | 2 | Asiento RHS 60 x 40 x 4 | S275JRH | L 1350.00 | Cotas tomadas de la pieza representada; P.
07 | Dosificador / bancada | 2 | Montante SHS 60 x 60 x 4 | S275JRH | L 340.00 | Cotas tomadas de la pieza representada; P.
08 | Dosificador / bancada | 2 | Soporte de tablero, chapa 6 | ASTM A36 | 320.00 x 40.00 x 6.00 | Cotas tomadas de la pieza representada; P.
09 | Dosificador / bancada | 2 | Soporte de tablero, chapa 6 | ASTM A36 | 210.00 x 40.00 x 6.00 | Cotas tomadas de la pieza representada; P.
10 | Tolva / remate | 1 | Remate de borde abierto, pletina | ASTM A36 | 3450.00 x 16.00 x 12.00 | Cotas tomadas de la pieza representada; P.
11 | Dosificador / modificación | 1 | Adaptación de dos columnas delanteras y travesaños inferiores | Estructura existente | Conservar partes superiores y pesaje | Retirar segmentos inferiores indicados en el conjunto. Reutilizar equipos rígidos; no comprar dosificador completo.
12 | Dosificador / tablero | 1 | Reubicación completa de tablero, pantalla y mandos | Equipo existente | Dimensiones originales | Giro rígido y nueva posición exterior; no duplicar en compra.
13 | Bajante / separación | 1 | Panel ranurado desmontable | Acero inoxidable 304 | 800 x 400 x 6 | 96 ranuras5 x150, extremosR2.5;24 columnas x4 tramos. Desbarbar y enrasar.
14 | Bajante / captación | 1 | Paño de captación inferior, chapa3 | ASTM A36 | Lados 800.00 / 346.86 / 300.00 / 625.58 / e3 | Paño trapezoidal según coordenadas del modelo; no tomar su caja envolvente como desarrollo.
15 | Bajante / captación | 1 | Paño de captación inferior, chapa3 | ASTM A36 | Lados 376.00 / 346.86 / 200.00 / 346.86 / e3 | Paño trapezoidal según coordenadas del modelo; no tomar su caja envolvente como desarrollo.
16 | Bajante / captación | 1 | Paño de captación inferior, chapa3 | ASTM A36 | Lados 800.00 / 625.58 / 300.00 / 346.86 / e3 | Paño trapezoidal según coordenadas del modelo; no tomar su caja envolvente como desarrollo.
17 | Bajante / captación | 1 | Paño extremo con registro de limpieza | ASTM A36 | Anchos376 /200, altura inclinada 619.36 / e3 | Registro útil160 x120 según corte real; no utilizar triangulación como contorno.
18 | Bajante / captación | 1 | Tapa desmontable del registro | ASTM A36 | 184.00 x 144.00 x 3.00 | Incluye cuatro fijaciones desmontables y junta perimetral.
19 | Bajante / soporte panel | 1 | Pletina de apoyo perimetral | ASTM A36 | 800.00 x 12.00 x 12.00 | Longitudes de arista y espesor desde la pieza. Ajustar ingletes al plano20°.
20 | Bajante / soporte panel | 1 | Pletina de apoyo perimetral | ASTM A36 | 800.00 x 12.00 x 12.00 | Longitudes de arista y espesor desde la pieza. Ajustar ingletes al plano20°.
21 | Bajante / soporte panel | 1 | Pletina de apoyo perimetral | ASTM A36 | 376.00 x 12.00 x 12.00 | Longitudes de arista y espesor desde la pieza. Ajustar ingletes al plano20°.
22 | Bajante / soporte panel | 1 | Pletina de apoyo perimetral | ASTM A36 | 376.00 x 12.00 x 12.00 | Longitudes de arista y espesor desde la pieza. Ajustar ingletes al plano20°.
23 | Bajante / soporte panel | 1 | Pletina de apoyo perimetral | ASTM A36 | 376.00 x 12.00 x 12.00 | Longitudes de arista y espesor desde la pieza. Ajustar ingletes al plano20°.
24 | Bajante / soporte panel | 1 | Pletina de apoyo perimetral | ASTM A36 | 376.00 x 12.00 x 12.00 | Longitudes de arista y espesor desde la pieza. Ajustar ingletes al plano20°.
25 | Bajante / soporte panel | 1 | Pletina de apoyo perimetral | ASTM A36 | 376.00 x 12.00 x 12.00 | Longitudes de arista y espesor desde la pieza. Ajustar ingletes al plano20°.
26 | Bajante / soporte panel | 1 | Pletina de apoyo perimetral | ASTM A36 | 800.00 x 35.00 x 6.00 | Longitudes de arista y espesor desde la pieza. Ajustar ingletes al plano20°.
27 | Bajante / soporte panel | 1 | Pletina de apoyo perimetral | ASTM A36 | 800.00 x 35.00 x 6.00 | Longitudes de arista y espesor desde la pieza. Ajustar ingletes al plano20°.
28 | Bajante / soporte panel | 1 | Pletina de apoyo perimetral | ASTM A36 | 800.00 x 12.00 x 3.00 | Longitudes de arista y espesor desde la pieza. Ajustar ingletes al plano20°.
29 | Bajante / soporte panel | 1 | Pletina de apoyo perimetral | ASTM A36 | 800.00 x 12.00 x 3.00 | Longitudes de arista y espesor desde la pieza. Ajustar ingletes al plano20°.
30 | Bajante / soporte panel | 1 | Presilla desmontable | ASTM A36 | 30.00 x 16.00 x 8.00 | Longitudes de arista y espesor desde la pieza. Ajustar ingletes al plano20°.
31 | Bajante / soporte panel | 1 | Presilla desmontable | ASTM A36 | 30.00 x 16.00 x 8.00 | Longitudes de arista y espesor desde la pieza. Ajustar ingletes al plano20°.
32 | Bajante / soporte panel | 1 | Presilla desmontable | ASTM A36 | 30.00 x 16.00 x 8.00 | Longitudes de arista y espesor desde la pieza. Ajustar ingletes al plano20°.
33 | Bajante / soporte panel | 1 | Presilla desmontable | ASTM A36 | 30.00 x 16.00 x 8.00 | Longitudes de arista y espesor desde la pieza. Ajustar ingletes al plano20°.
34 | C09 | 1 | Banda continua plana, ancho 400 | Caucho / tejido | B400 x e3 / entre ejes 2743.57 | Longitud geométrica neutra 5810.73; empalme y margen de tensado se definirán con proveedor.
35 | C09 | 2 | Tambor Ø100 | Acero | Ø100 x 420 | Dos componentes rígidos de dimensiones iguales.
36 | C09 | 2 | Eje de tambor Ø25 | SAE1045 | Ø25 x 610 | Ajustes, chaveteros y extremos según accionamiento seleccionado.
37 | C09 | 4 | Chumacera para eje Ø25 | Serie comercial UCP205 | D25 | Familia de compra propuesta; concordar perforaciones antes de mecanizar.
38 | C09 | 2 | Tensor de husillo de cola | Acero | M10 / longitud120 | Carrera representada en conjunto; tuerca y soporte incluidos.
39 | C09 | 1 | Paño de larguero plegado | Chapa de acero | 2883.57 x 97.00 x 4.00 | Posición R28-terminal-web--1.
40 | C09 | 1 | Paño de larguero plegado | Chapa de acero | 1198.00 x 167.00 x 4.00 | Posición R28-side-web--1-0.
41 | C09 | 1 | Paño de larguero plegado | Chapa de acero | 1198.00 x 25.00 x 6.00 | Posición R28-side-cap--1-0.
42 | C09 | 1 | Paño de larguero plegado | Chapa de acero | 1198.00 x 167.00 x 4.00 | Posición R28-side-web--1-1.
43 | C09 | 1 | Paño de larguero plegado | Chapa de acero | 1198.00 x 25.00 x 6.00 | Posición R28-side-cap--1-1.
44 | C09 | 1 | Paño de larguero plegado | Chapa de acero | 115.00 x 110.00 x 6.00 | Posición R28-splice--1-1.
45 | C09 | 1 | Paño de larguero plegado | Chapa de acero | 167.00 x 143.57 x 4.00 | Posición R28-side-web--1-2.
46 | C09 | 1 | Paño de larguero plegado | Chapa de acero | 143.57 x 25.00 x 6.00 | Posición R28-side-cap--1-2.
47 | C09 | 1 | Paño de larguero plegado | Chapa de acero | 115.00 x 110.00 x 6.00 | Posición R28-splice--1-2.
48 | C09 | 1 | Paño de larguero plegado | Chapa de acero | 2883.57 x 25.00 x 6.00 | Posición R28-side-top-fold--1.
49 | C09 | 1 | Paño de larguero plegado | Chapa de acero | 2883.57 x 25.00 x 6.00 | Posición R28-side-bottom-fold--1.
50 | C09 | 1 | Paño de larguero plegado | Chapa de acero | 2883.57 x 97.00 x 4.00 | Posición R28-terminal-web-1.
51 | C09 | 1 | Paño de larguero plegado | Chapa de acero | 1198.00 x 167.00 x 4.00 | Posición R28-side-web-1-0.
52 | C09 | 1 | Paño de larguero plegado | Chapa de acero | 1198.00 x 25.00 x 6.00 | Posición R28-side-cap-1-0.
53 | C09 | 1 | Paño de larguero plegado | Chapa de acero | 1198.00 x 167.00 x 4.00 | Posición R28-side-web-1-1.
54 | C09 | 1 | Paño de larguero plegado | Chapa de acero | 1198.00 x 25.00 x 6.00 | Posición R28-side-cap-1-1.
55 | C09 | 1 | Paño de larguero plegado | Chapa de acero | 115.00 x 110.00 x 6.00 | Posición R28-splice-1-1.
56 | C09 | 1 | Paño de larguero plegado | Chapa de acero | 167.00 x 143.57 x 4.00 | Posición R28-side-web-1-2.
57 | C09 | 1 | Paño de larguero plegado | Chapa de acero | 143.57 x 25.00 x 6.00 | Posición R28-side-cap-1-2.
58 | C09 | 1 | Paño de larguero plegado | Chapa de acero | 115.00 x 110.00 x 6.00 | Posición R28-splice-1-2.
59 | C09 | 1 | Paño de larguero plegado | Chapa de acero | 2883.57 x 25.00 x 6.00 | Posición R28-side-top-fold-1.
60 | C09 | 1 | Paño de larguero plegado | Chapa de acero | 2883.57 x 25.00 x 6.00 | Posición R28-side-bottom-fold-1.
61 | C09 | 1 | Travesaño o diagonal del pórtico | SHS propuesto | L 510.00 / 30.00 x 30.00 | Cortes de encuentro según modelo.
62 | C09 | 1 | Travesaño o diagonal del pórtico | SHS propuesto | L 510.00 / 30.00 x 30.00 | Cortes de encuentro según modelo.
63 | C09 | 16 | Anclaje representado | Acero | Tuerca de envolvente Ø12 | Selección según apoyo y piso.
64 | C09 | 1 | Cama deslizante | Chapa galvanizada | L 2603.57 x 400 x3 | Soporte continuo bajo la rama portante.
65 | C09 | 1 | Pata vertical SHS40 x40 x3 | S275JRH | L máx 294.69 | Corte superior inclinado según bastidor.
66 | C09 | 1 | Pata vertical SHS40 x40 x3 | S275JRH | L máx 294.69 | Corte superior inclinado según bastidor.
67 | C09 | 1 | Pata vertical SHS40 x40 x3 | S275JRH | L máx 376.01 | Corte superior inclinado según bastidor.
68 | C09 | 1 | Pata vertical SHS40 x40 x3 | S275JRH | L máx 376.01 | Corte superior inclinado según bastidor.
69 | C09 | 4 | Placa base | ASTM A36 | 130 x130 x12 | Perforaciones y anclajes por definir según piso.
70 | C09 | 4 | Rodillo de retorno Ø34 | Acero | Ø34 x 415 | EjeØ12, colgantes y alojamientos en conjunto.
71 | C09 | 1 | Motorreductor de cabeza con acoplamiento | Conjunto comercial | Envolvente geométrica original | Potencia, relación y referencia comercial pendientes; no atribuir potencia a la malla ilustrativa.
72 | C09 | 1 | Plataforma de accionamiento y guardas | Acero | Según conjunto | Incluye ménsulas, base de motor y resguardos laterales.
73 | C10 | 1 | Banda continua plana, ancho 300 | Caucho / tejido | B300 x e3 / entre ejes 9312.96 | Longitud geométrica neutra 18949.51; empalme y margen de tensado se definirán con proveedor.
74 | C10 | 2 | Tambor Ø100 | Acero | Ø100 x 320 | Dos componentes rígidos de dimensiones iguales.
75 | C10 | 2 | Eje de tambor Ø25 | SAE1045 | Ø25 x 510 | Ajustes, chaveteros y extremos según accionamiento seleccionado.
76 | C10 | 4 | Chumacera para eje Ø25 | Serie comercial UCP205 | D25 | Familia de compra propuesta; concordar perforaciones antes de mecanizar.
77 | C10 | 2 | Tensor de husillo de cola | Acero | M10 / longitud120 | Carrera representada en conjunto; tuerca y soporte incluidos.
78 | C10 | 1 | Paño de larguero plegado | Chapa de acero | 9452.96 x 97.00 x 4.00 | Posición R28-terminal-web--1.
79 | C10 | 1 | Paño de larguero plegado | Chapa de acero | 1198.00 x 167.00 x 4.00 | Posición R28-side-web--1-0.
80 | C10 | 1 | Paño de larguero plegado | Chapa de acero | 1198.00 x 25.00 x 6.00 | Posición R28-side-cap--1-0.
81 | C10 | 1 | Paño de larguero plegado | Chapa de acero | 1198.00 x 167.00 x 4.00 | Posición R28-side-web--1-1.
82 | C10 | 1 | Paño de larguero plegado | Chapa de acero | 1198.00 x 25.00 x 6.00 | Posición R28-side-cap--1-1.
83 | C10 | 1 | Paño de larguero plegado | Chapa de acero | 115.00 x 110.00 x 6.00 | Posición R28-splice--1-1.
84 | C10 | 1 | Paño de larguero plegado | Chapa de acero | 1198.00 x 167.00 x 4.00 | Posición R28-side-web--1-2.
85 | C10 | 1 | Paño de larguero plegado | Chapa de acero | 1198.00 x 25.00 x 6.00 | Posición R28-side-cap--1-2.
86 | C10 | 1 | Paño de larguero plegado | Chapa de acero | 115.00 x 110.00 x 6.00 | Posición R28-splice--1-2.
87 | C10 | 1 | Paño de larguero plegado | Chapa de acero | 1198.00 x 167.00 x 4.00 | Posición R28-side-web--1-3.
88 | C10 | 1 | Paño de larguero plegado | Chapa de acero | 1198.00 x 25.00 x 6.00 | Posición R28-side-cap--1-3.
89 | C10 | 1 | Paño de larguero plegado | Chapa de acero | 115.00 x 110.00 x 6.00 | Posición R28-splice--1-3.
90 | C10 | 1 | Paño de larguero plegado | Chapa de acero | 1198.00 x 167.00 x 4.00 | Posición R28-side-web--1-4.
91 | C10 | 1 | Paño de larguero plegado | Chapa de acero | 1198.00 x 25.00 x 6.00 | Posición R28-side-cap--1-4.
92 | C10 | 1 | Paño de larguero plegado | Chapa de acero | 115.00 x 110.00 x 6.00 | Posición R28-splice--1-4.
93 | C10 | 1 | Paño de larguero plegado | Chapa de acero | 1198.00 x 167.00 x 4.00 | Posición R28-side-web--1-5.
94 | C10 | 1 | Paño de larguero plegado | Chapa de acero | 1198.00 x 25.00 x 6.00 | Posición R28-side-cap--1-5.
95 | C10 | 1 | Paño de larguero plegado | Chapa de acero | 115.00 x 110.00 x 6.00 | Posición R28-splice--1-5.
96 | C10 | 1 | Paño de larguero plegado | Chapa de acero | 1198.00 x 167.00 x 4.00 | Posición R28-side-web--1-6.
97 | C10 | 1 | Paño de larguero plegado | Chapa de acero | 1198.00 x 25.00 x 6.00 | Posición R28-side-cap--1-6.
98 | C10 | 1 | Paño de larguero plegado | Chapa de acero | 115.00 x 110.00 x 6.00 | Posición R28-splice--1-6.
99 | C10 | 1 | Paño de larguero plegado | Chapa de acero | 712.96 x 167.00 x 4.00 | Posición R28-side-web--1-7.
100 | C10 | 1 | Paño de larguero plegado | Chapa de acero | 712.96 x 25.00 x 6.00 | Posición R28-side-cap--1-7.
101 | C10 | 1 | Paño de larguero plegado | Chapa de acero | 115.00 x 110.00 x 6.00 | Posición R28-splice--1-7.
102 | C10 | 1 | Paño de larguero plegado | Chapa de acero | 9452.96 x 25.00 x 6.00 | Posición R28-side-top-fold--1.
103 | C10 | 1 | Paño de larguero plegado | Chapa de acero | 9452.96 x 25.00 x 6.00 | Posición R28-side-bottom-fold--1.
104 | C10 | 1 | Paño de larguero plegado | Chapa de acero | 9452.96 x 97.00 x 4.00 | Posición R28-terminal-web-1.
105 | C10 | 1 | Paño de larguero plegado | Chapa de acero | 1198.00 x 167.00 x 4.00 | Posición R28-side-web-1-0.
106 | C10 | 1 | Paño de larguero plegado | Chapa de acero | 1198.00 x 25.00 x 6.00 | Posición R28-side-cap-1-0.
107 | C10 | 1 | Paño de larguero plegado | Chapa de acero | 1198.00 x 167.00 x 4.00 | Posición R28-side-web-1-1.
108 | C10 | 1 | Paño de larguero plegado | Chapa de acero | 1198.00 x 25.00 x 6.00 | Posición R28-side-cap-1-1.
109 | C10 | 1 | Paño de larguero plegado | Chapa de acero | 115.00 x 110.00 x 6.00 | Posición R28-splice-1-1.
110 | C10 | 1 | Paño de larguero plegado | Chapa de acero | 1198.00 x 167.00 x 4.00 | Posición R28-side-web-1-2.
111 | C10 | 1 | Paño de larguero plegado | Chapa de acero | 1198.00 x 25.00 x 6.00 | Posición R28-side-cap-1-2.
112 | C10 | 1 | Paño de larguero plegado | Chapa de acero | 115.00 x 110.00 x 6.00 | Posición R28-splice-1-2.
113 | C10 | 1 | Paño de larguero plegado | Chapa de acero | 1198.00 x 167.00 x 4.00 | Posición R28-side-web-1-3.
114 | C10 | 1 | Paño de larguero plegado | Chapa de acero | 1198.00 x 25.00 x 6.00 | Posición R28-side-cap-1-3.
115 | C10 | 1 | Paño de larguero plegado | Chapa de acero | 115.00 x 110.00 x 6.00 | Posición R28-splice-1-3.
116 | C10 | 1 | Paño de larguero plegado | Chapa de acero | 1198.00 x 167.00 x 4.00 | Posición R28-side-web-1-4.
117 | C10 | 1 | Paño de larguero plegado | Chapa de acero | 1198.00 x 25.00 x 6.00 | Posición R28-side-cap-1-4.
118 | C10 | 1 | Paño de larguero plegado | Chapa de acero | 115.00 x 110.00 x 6.00 | Posición R28-splice-1-4.
119 | C10 | 1 | Paño de larguero plegado | Chapa de acero | 1198.00 x 167.00 x 4.00 | Posición R28-side-web-1-5.
120 | C10 | 1 | Paño de larguero plegado | Chapa de acero | 1198.00 x 25.00 x 6.00 | Posición R28-side-cap-1-5.
121 | C10 | 1 | Paño de larguero plegado | Chapa de acero | 115.00 x 110.00 x 6.00 | Posición R28-splice-1-5.
122 | C10 | 1 | Paño de larguero plegado | Chapa de acero | 1198.00 x 167.00 x 4.00 | Posición R28-side-web-1-6.
123 | C10 | 1 | Paño de larguero plegado | Chapa de acero | 1198.00 x 25.00 x 6.00 | Posición R28-side-cap-1-6.
124 | C10 | 1 | Paño de larguero plegado | Chapa de acero | 115.00 x 110.00 x 6.00 | Posición R28-splice-1-6.
125 | C10 | 1 | Paño de larguero plegado | Chapa de acero | 712.96 x 167.00 x 4.00 | Posición R28-side-web-1-7.
126 | C10 | 1 | Paño de larguero plegado | Chapa de acero | 712.96 x 25.00 x 6.00 | Posición R28-side-cap-1-7.
127 | C10 | 1 | Paño de larguero plegado | Chapa de acero | 115.00 x 110.00 x 6.00 | Posición R28-splice-1-7.
128 | C10 | 1 | Paño de larguero plegado | Chapa de acero | 9452.96 x 25.00 x 6.00 | Posición R28-side-top-fold-1.
129 | C10 | 1 | Paño de larguero plegado | Chapa de acero | 9452.96 x 25.00 x 6.00 | Posición R28-side-bottom-fold-1.
130 | C10 | 1 | Travesaño o diagonal del pórtico | SHS propuesto | L 410.00 / 30.00 x 30.00 | Cortes de encuentro según modelo.
131 | C10 | 1 | Travesaño o diagonal del pórtico | SHS propuesto | L 520.10 / 25.00 x 25.00 | Cortes de encuentro según modelo.
132 | C10 | 1 | Travesaño o diagonal del pórtico | SHS propuesto | L 625.90 / 30.00 x 30.00 | Cortes de encuentro según modelo.
133 | C10 | 1 | Travesaño o diagonal del pórtico | SHS propuesto | L 625.90 / 30.00 x 30.00 | Cortes de encuentro según modelo.
134 | C10 | 1 | Travesaño o diagonal del pórtico | SHS propuesto | L 410.00 / 30.00 x 30.00 | Cortes de encuentro según modelo.
135 | C10 | 1 | Travesaño o diagonal del pórtico | SHS propuesto | L 520.10 / 25.00 x 25.00 | Cortes de encuentro según modelo.
136 | C10 | 1 | Travesaño o diagonal del pórtico | SHS propuesto | L 625.90 / 30.00 x 30.00 | Cortes de encuentro según modelo.
137 | C10 | 1 | Travesaño o diagonal del pórtico | SHS propuesto | L 625.90 / 30.00 x 30.00 | Cortes de encuentro según modelo.
138 | C10 | 1 | Travesaño o diagonal del pórtico | SHS propuesto | L 410.00 / 30.00 x 30.00 | Cortes de encuentro según modelo.
139 | C10 | 1 | Travesaño o diagonal del pórtico | SHS propuesto | L 520.10 / 25.00 x 25.00 | Cortes de encuentro según modelo.
140 | C10 | 1 | Travesaño o diagonal del pórtico | SHS propuesto | L 625.90 / 30.00 x 30.00 | Cortes de encuentro según modelo.
141 | C10 | 1 | Travesaño o diagonal del pórtico | SHS propuesto | L 625.90 / 30.00 x 30.00 | Cortes de encuentro según modelo.
142 | C10 | 32 | Anclaje representado | Acero | Tuerca de envolvente Ø12 | Selección según apoyo y piso.
143 | C10 | 1 | Cama deslizante | Chapa galvanizada | L 9172.96 x 300 x3 | Soporte continuo bajo la rama portante.
144 | C10 | 1 | Pata vertical SHS40 x40 x3 | S275JRH | L máx 156.70 | Corte superior inclinado según bastidor.
145 | C10 | 1 | Pata vertical SHS40 x40 x3 | S275JRH | L máx 156.70 | Corte superior inclinado según bastidor.
146 | C10 | 1 | Pata vertical SHS40 x40 x3 | S275JRH | L máx 667.92 | Corte superior inclinado según bastidor.
147 | C10 | 1 | Pata vertical SHS40 x40 x3 | S275JRH | L máx 667.92 | Corte superior inclinado según bastidor.
148 | C10 | 1 | Pata vertical SHS40 x40 x3 | S275JRH | L máx 1245.82 | Corte superior inclinado según bastidor.
149 | C10 | 1 | Pata vertical SHS40 x40 x3 | S275JRH | L máx 1245.82 | Corte superior inclinado según bastidor.
150 | C10 | 1 | Pata vertical SHS40 x40 x3 | S275JRH | L máx 1971.09 | Corte superior inclinado según bastidor.
151 | C10 | 1 | Pata vertical SHS40 x40 x3 | S275JRH | L máx 1971.09 | Corte superior inclinado según bastidor.
152 | C10 | 8 | Placa base | ASTM A36 | 130 x130 x12 | Perforaciones y anclajes por definir según piso.
153 | C10 | 12 | Rodillo de retorno Ø34 | Acero | Ø34 x 315 | EjeØ12, colgantes y alojamientos en conjunto.
154 | C10 | 1 | Motorreductor de cabeza con acoplamiento | Conjunto comercial | Envolvente geométrica original | Potencia, relación y referencia comercial pendientes; no atribuir potencia a la malla ilustrativa.
155 | C10 | 1 | Plataforma de accionamiento y guardas | Acero | Según conjunto | Incluye ménsulas, base de motor y resguardos laterales.
156 | C11 | 1 | Banda continua plana, ancho 300 | Caucho / tejido | B300 x e3 / entre ejes 3240.00 | Longitud geométrica neutra 6803.58; empalme y margen de tensado se definirán con proveedor.
157 | C11 | 2 | Tambor Ø100 | Acero | Ø100 x 320 | Dos componentes rígidos de dimensiones iguales.
158 | C11 | 2 | Eje de tambor Ø25 | SAE1045 | Ø25 x 510 | Ajustes, chaveteros y extremos según accionamiento seleccionado.
159 | C11 | 4 | Chumacera para eje Ø25 | Serie comercial UCP205 | D25 | Familia de compra propuesta; concordar perforaciones antes de mecanizar.
160 | C11 | 2 | Tensor de husillo de cola | Acero | M10 / longitud120 | Carrera representada en conjunto; tuerca y soporte incluidos.
161 | C11 | 1 | Paño de larguero plegado | Chapa de acero | 3380.00 x 97.00 x 4.00 | Posición R28-terminal-web--1.
162 | C11 | 1 | Paño de larguero plegado | Chapa de acero | 1198.00 x 167.00 x 4.00 | Posición R28-side-web--1-0.
163 | C11 | 1 | Paño de larguero plegado | Chapa de acero | 1198.00 x 25.00 x 6.00 | Posición R28-side-cap--1-0.
164 | C11 | 1 | Paño de larguero plegado | Chapa de acero | 1198.00 x 167.00 x 4.00 | Posición R28-side-web--1-1.
165 | C11 | 1 | Paño de larguero plegado | Chapa de acero | 1198.00 x 25.00 x 6.00 | Posición R28-side-cap--1-1.
166 | C11 | 1 | Paño de larguero plegado | Chapa de acero | 115.00 x 110.00 x 6.00 | Posición R28-splice--1-1.
167 | C11 | 1 | Paño de larguero plegado | Chapa de acero | 640.00 x 167.00 x 4.00 | Posición R28-side-web--1-2.
168 | C11 | 1 | Paño de larguero plegado | Chapa de acero | 640.00 x 25.00 x 6.00 | Posición R28-side-cap--1-2.
169 | C11 | 1 | Paño de larguero plegado | Chapa de acero | 115.00 x 110.00 x 6.00 | Posición R28-splice--1-2.
170 | C11 | 1 | Paño de larguero plegado | Chapa de acero | 3380.00 x 25.00 x 6.00 | Posición R28-side-top-fold--1.
171 | C11 | 1 | Paño de larguero plegado | Chapa de acero | 3380.00 x 25.00 x 6.00 | Posición R28-side-bottom-fold--1.
172 | C11 | 1 | Paño de larguero plegado | Chapa de acero | 3380.00 x 97.00 x 4.00 | Posición R28-terminal-web-1.
173 | C11 | 1 | Paño de larguero plegado | Chapa de acero | 1198.00 x 167.00 x 4.00 | Posición R28-side-web-1-0.
174 | C11 | 1 | Paño de larguero plegado | Chapa de acero | 1198.00 x 25.00 x 6.00 | Posición R28-side-cap-1-0.
175 | C11 | 1 | Paño de larguero plegado | Chapa de acero | 1198.00 x 167.00 x 4.00 | Posición R28-side-web-1-1.
176 | C11 | 1 | Paño de larguero plegado | Chapa de acero | 1198.00 x 25.00 x 6.00 | Posición R28-side-cap-1-1.
177 | C11 | 1 | Paño de larguero plegado | Chapa de acero | 115.00 x 110.00 x 6.00 | Posición R28-splice-1-1.
178 | C11 | 1 | Paño de larguero plegado | Chapa de acero | 640.00 x 167.00 x 4.00 | Posición R28-side-web-1-2.
179 | C11 | 1 | Paño de larguero plegado | Chapa de acero | 640.00 x 25.00 x 6.00 | Posición R28-side-cap-1-2.
180 | C11 | 1 | Paño de larguero plegado | Chapa de acero | 115.00 x 110.00 x 6.00 | Posición R28-splice-1-2.
181 | C11 | 1 | Paño de larguero plegado | Chapa de acero | 3380.00 x 25.00 x 6.00 | Posición R28-side-top-fold-1.
182 | C11 | 1 | Paño de larguero plegado | Chapa de acero | 3380.00 x 25.00 x 6.00 | Posición R28-side-bottom-fold-1.
183 | C11 | 1 | Travesaño o diagonal del pórtico | SHS propuesto | L 410.00 / 30.00 x 30.00 | Cortes de encuentro según modelo.
184 | C11 | 1 | Travesaño o diagonal del pórtico | SHS propuesto | L 520.10 / 25.00 x 25.00 | Cortes de encuentro según modelo.
185 | C11 | 1 | Travesaño o diagonal del pórtico | SHS propuesto | L 566.39 / 30.00 x 30.00 | Cortes de encuentro según modelo.
186 | C11 | 1 | Travesaño o diagonal del pórtico | SHS propuesto | L 566.39 / 30.00 x 30.00 | Cortes de encuentro según modelo.
187 | C11 | 1 | Travesaño o diagonal del pórtico | SHS propuesto | L 410.00 / 30.00 x 30.00 | Cortes de encuentro según modelo.
188 | C11 | 1 | Travesaño o diagonal del pórtico | SHS propuesto | L 520.10 / 25.00 x 25.00 | Cortes de encuentro según modelo.
189 | C11 | 1 | Travesaño o diagonal del pórtico | SHS propuesto | L 566.39 / 30.00 x 30.00 | Cortes de encuentro según modelo.
190 | C11 | 1 | Travesaño o diagonal del pórtico | SHS propuesto | L 566.39 / 30.00 x 30.00 | Cortes de encuentro según modelo.
191 | C11 | 16 | Anclaje representado | Acero | Tuerca de envolvente Ø12 | Selección según apoyo y piso.
192 | C11 | 1 | Cama deslizante | Chapa galvanizada | L 3100.00 x 300 x3 | Soporte continuo bajo la rama portante.
193 | C11 | 1 | Pata vertical SHS40 x40 x3 | S275JRH | L máx 1848.00 | Corte superior inclinado según bastidor.
194 | C11 | 1 | Pata vertical SHS40 x40 x3 | S275JRH | L máx 1848.00 | Corte superior inclinado según bastidor.
195 | C11 | 1 | Pata vertical SHS40 x40 x3 | S275JRH | L máx 1848.00 | Corte superior inclinado según bastidor.
196 | C11 | 1 | Pata vertical SHS40 x40 x3 | S275JRH | L máx 1848.00 | Corte superior inclinado según bastidor.
197 | C11 | 4 | Placa base | ASTM A36 | 130 x130 x12 | Perforaciones y anclajes por definir según piso.
198 | C11 | 5 | Rodillo de retorno Ø34 | Acero | Ø34 x 315 | EjeØ12, colgantes y alojamientos en conjunto.
199 | C11 | 1 | Motorreductor de cola con acoplamiento | Conjunto comercial | Envolvente geométrica original | Potencia, relación y referencia comercial pendientes; no atribuir potencia a la malla ilustrativa.
200 | C11 | 1 | Plataforma de accionamiento y guardas | Acero | Según conjunto | Incluye ménsulas, base de motor y resguardos laterales.
