acevedocrisologopablo48-lgtm/planta-briquetadora/r27/MATERIALES_R27.csv

pos | conjunto | cantidad | descripcion | material | medidas_mm | nota
01 | Dosificador / bancada | 4 | Placa base | ASTM A36 | 220.00 x 220.00 x 12.00 | Cotas tomadas de la pieza representada; P.
02 | Dosificador / bancada | 2 | Columna SHS 100 x 100 x 5 | S275JRH | L 2388.00 | Cotas tomadas de la pieza representada; P.
03 | Dosificador / bancada | 2 | Columna SHS 100 x 100 x 5 | S275JRH | L 1388.00 | Cotas tomadas de la pieza representada; P.
04 | Dosificador / bancada | 4 | Viga SHS 100 x 100 x 5 | S275JRH | L 1700.00 | Cotas tomadas de la pieza representada; P.
05 | Dosificador / bancada | 2 | Cartela triangular, chapa 10 | ASTM A36 | 250 x 1000 x 10 | Triángulo según geometría: borde vertical250 y proyección1000. No usar envolvente como rectángulo de corte.
06 | Dosificador / bancada | 2 | Asiento RHS 60 x 40 x 4 | S275JRH | L 1350.00 | Cotas tomadas de la pieza representada; P.
07 | Dosificador / bancada | 2 | Montante SHS 60 x 60 x 4 | S275JRH | L 340.00 | Cotas tomadas de la pieza representada; P.
08 | Dosificador / bancada | 2 | Soporte de tablero, chapa 6 | ASTM A36 | 320.00 x 40.00 x 6.00 | Cotas tomadas de la pieza representada; P.
09 | Dosificador / bancada | 2 | Soporte de tablero, chapa 6 | ASTM A36 | 210.00 x 40.00 x 6.00 | Cotas tomadas de la pieza representada; P.
10 | Tolva / remate | 1 | Remate de borde abierto, pletina | ASTM A36 | 3450.00 x 16.00 x 12.00 | Cotas tomadas de la pieza representada; P.
11 | Dosificador / modificación | 1 | Adaptación de dos columnas delanteras y travesaños inferiores | Estructura existente | Conservar partes superiores y pesaje | Retirar segmentos inferiores indicados en el conjunto. Reutilizar equipos rígidos; no comprar dosificador completo.
12 | Dosificador / tablero | 1 | Reubicación completa de tablero, pantalla y mandos | Equipo existente | Dimensiones originales | Giro rígido y nueva posición exterior; no duplicar en compra.
13 | Bajante / separación | 1 | Panel ranurado desmontable | Acero inoxidable 304 | 800 x 400 x 6 | 96 ranuras5 x150, extremosR2.5;24 columnas x4 tramos. Desbarbar y enrasar.
14 | Bajante / captación | 1 | Paño de captación inferior, chapa3 | ASTM A36 | Lados 800.00 / 346.86 / 300.00 / 625.58 / e3 | Paño trapezoidal según coordenadas del modelo; no tomar su caja envolvente como desarrollo.
15 | Bajante / captación | 1 | Paño de captación inferior, chapa3 | ASTM A36 | Lados 376.00 / 346.86 / 200.00 / 346.86 / e3 | Paño trapezoidal según coordenadas del modelo; no tomar su caja envolvente como desarrollo.
16 | Bajante / captación | 1 | Paño de captación inferior, chapa3 | ASTM A36 | Lados 800.00 / 625.58 / 300.00 / 346.86 / e3 | Paño trapezoidal según coordenadas del modelo; no tomar su caja envolvente como desarrollo.
17 | Bajante / captación | 1 | Paño extremo con registro de limpieza | ASTM A36 | Anchos376 /200, altura inclinada 619.36 / e3 | Registro útil160 x120 según corte real; no utilizar triangulación como contorno.
18 | Bajante / captación | 1 | Tapa desmontable del registro | ASTM A36 | 184.00 x 144.00 x 3.00 | Incluye cuatro fijaciones desmontables y junta perimetral.
19 | Bajante / soporte panel | 1 | Pletina de apoyo perimetral | ASTM A36 | 800.00 x 12.00 x 12.00 | Longitudes de arista y espesor desde la pieza. Ajustar ingletes al plano20°.
20 | Bajante / soporte panel | 1 | Pletina de apoyo perimetral | ASTM A36 | 800.00 x 12.00 x 12.00 | Longitudes de arista y espesor desde la pieza. Ajustar ingletes al plano20°.
21 | Bajante / soporte panel | 1 | Pletina de apoyo perimetral | ASTM A36 | 376.00 x 12.00 x 12.00 | Longitudes de arista y espesor desde la pieza. Ajustar ingletes al plano20°.
22 | Bajante / soporte panel | 1 | Pletina de apoyo perimetral | ASTM A36 | 376.00 x 12.00 x 12.00 | Longitudes de arista y espesor desde la pieza. Ajustar ingletes al plano20°.
23 | Bajante / soporte panel | 1 | Pletina de apoyo perimetral | ASTM A36 | 376.00 x 12.00 x 12.00 | Longitudes de arista y espesor desde la pieza. Ajustar ingletes al plano20°.
24 | Bajante / soporte panel | 1 | Pletina de apoyo perimetral | ASTM A36 | 376.00 x 12.00 x 12.00 | Longitudes de arista y espesor desde la pieza. Ajustar ingletes al plano20°.
25 | Bajante / soporte panel | 1 | Pletina de apoyo perimetral | ASTM A36 | 376.00 x 12.00 x 12.00 | Longitudes de arista y espesor desde la pieza. Ajustar ingletes al plano20°.
26 | Bajante / soporte panel | 1 | Pletina de apoyo perimetral | ASTM A36 | 800.00 x 35.00 x 6.00 | Longitudes de arista y espesor desde la pieza. Ajustar ingletes al plano20°.
27 | Bajante / soporte panel | 1 | Pletina de apoyo perimetral | ASTM A36 | 800.00 x 35.00 x 6.00 | Longitudes de arista y espesor desde la pieza. Ajustar ingletes al plano20°.
28 | Bajante / soporte panel | 1 | Pletina de apoyo perimetral | ASTM A36 | 800.00 x 12.00 x 3.00 | Longitudes de arista y espesor desde la pieza. Ajustar ingletes al plano20°.
29 | Bajante / soporte panel | 1 | Pletina de apoyo perimetral | ASTM A36 | 800.00 x 12.00 x 3.00 | Longitudes de arista y espesor desde la pieza. Ajustar ingletes al plano20°.
30 | Bajante / soporte panel | 1 | Presilla desmontable | ASTM A36 | 30.00 x 16.00 x 8.00 | Longitudes de arista y espesor desde la pieza. Ajustar ingletes al plano20°.
31 | Bajante / soporte panel | 1 | Presilla desmontable | ASTM A36 | 30.00 x 16.00 x 8.00 | Longitudes de arista y espesor desde la pieza. Ajustar ingletes al plano20°.
32 | Bajante / soporte panel | 1 | Presilla desmontable | ASTM A36 | 30.00 x 16.00 x 8.00 | Longitudes de arista y espesor desde la pieza. Ajustar ingletes al plano20°.
33 | Bajante / soporte panel | 1 | Presilla desmontable | ASTM A36 | 30.00 x 16.00 x 8.00 | Longitudes de arista y espesor desde la pieza. Ajustar ingletes al plano20°.
34 | C09 | 1 | Banda continua plana, ancho 400 | Caucho / tejido | B400 x e3 / entre ejes 1910.50 | Longitud geométrica neutra 4144.58; empalme y margen de tensado se definirán con proveedor.
35 | C09 | 2 | Tambor Ø100 | Acero | Ø100 x 420 | Dos componentes rígidos de dimensiones iguales.
36 | C09 | 2 | Eje de tambor Ø25 | SAE1045 | Ø25 x 610 | Ajustes, chaveteros y extremos según accionamiento seleccionado.
37 | C09 | 4 | Chumacera para eje Ø25 | Serie comercial UCP205 | D25 | Familia de compra propuesta; concordar perforaciones antes de mecanizar.
38 | C09 | 2 | Tensor de husillo de cola | Acero | M10 / longitud120 | Carrera representada en conjunto; tuerca y soporte incluidos.
39 | C09 | 1 | Larguero plegado, alma y alas | Chapa de acero | L 2050.50 / alma4 x106 / alas25 x6 | Secciones representadas por paños independientes. Unificar a perfil plegado antes de fabricar.
40 | C09 | 1 | Larguero plegado, alma y alas | Chapa de acero | L 2050.50 / alma4 x106 / alas25 x6 | Secciones representadas por paños independientes. Unificar a perfil plegado antes de fabricar.
41 | C09 | 1 | Cama deslizante | Chapa galvanizada | L 1770.50 x 400 x3 | Soporte continuo bajo la rama portante.
42 | C09 | 1 | Pata vertical SHS40 x40 x3 | S275JRH | L máx 323.11 | Corte superior inclinado según bastidor.
43 | C09 | 1 | Pata vertical SHS40 x40 x3 | S275JRH | L máx 323.11 | Corte superior inclinado según bastidor.
44 | C09 | 1 | Pata vertical SHS40 x40 x3 | S275JRH | L máx 434.12 | Corte superior inclinado según bastidor.
45 | C09 | 1 | Pata vertical SHS40 x40 x3 | S275JRH | L máx 434.12 | Corte superior inclinado según bastidor.
46 | C09 | 4 | Placa base | ASTM A36 | 130 x130 x12 | Perforaciones y anclajes por definir según piso.
47 | C09 | 3 | Rodillo de retorno Ø34 | Acero | Ø34 x 415 | EjeØ12, colgantes y alojamientos en conjunto.
48 | C09 | 1 | Motorreductor de cabeza con acoplamiento | Conjunto comercial | Envolvente geométrica original | Potencia, relación y referencia comercial pendientes; no atribuir potencia a la malla ilustrativa.
49 | C09 | 1 | Plataforma de accionamiento y guardas | Acero | Según conjunto | Incluye ménsulas, base de motor y resguardos laterales.
50 | C10 | 1 | Banda continua plana, ancho 300 | Caucho / tejido | B300 x e3 / entre ejes 9167.47 | Longitud geométrica neutra 18658.52; empalme y margen de tensado se definirán con proveedor.
51 | C10 | 2 | Tambor Ø100 | Acero | Ø100 x 320 | Dos componentes rígidos de dimensiones iguales.
52 | C10 | 2 | Eje de tambor Ø25 | SAE1045 | Ø25 x 510 | Ajustes, chaveteros y extremos según accionamiento seleccionado.
53 | C10 | 4 | Chumacera para eje Ø25 | Serie comercial UCP205 | D25 | Familia de compra propuesta; concordar perforaciones antes de mecanizar.
54 | C10 | 2 | Tensor de husillo de cola | Acero | M10 / longitud120 | Carrera representada en conjunto; tuerca y soporte incluidos.
55 | C10 | 1 | Larguero plegado, alma y alas | Chapa de acero | L 9307.47 / alma4 x106 / alas25 x6 | Secciones representadas por paños independientes. Unificar a perfil plegado antes de fabricar.
56 | C10 | 1 | Larguero plegado, alma y alas | Chapa de acero | L 9307.47 / alma4 x106 / alas25 x6 | Secciones representadas por paños independientes. Unificar a perfil plegado antes de fabricar.
57 | C10 | 1 | Cama deslizante | Chapa galvanizada | L 9027.47 x 300 x3 | Soporte continuo bajo la rama portante.
58 | C10 | 1 | Pata vertical SHS40 x40 x3 | S275JRH | L máx 215.42 | Corte superior inclinado según bastidor.
59 | C10 | 1 | Pata vertical SHS40 x40 x3 | S275JRH | L máx 215.42 | Corte superior inclinado según bastidor.
60 | C10 | 1 | Pata vertical SHS40 x40 x3 | S275JRH | L máx 842.64 | Corte superior inclinado según bastidor.
61 | C10 | 1 | Pata vertical SHS40 x40 x3 | S275JRH | L máx 842.64 | Corte superior inclinado según bastidor.
62 | C10 | 1 | Pata vertical SHS40 x40 x3 | S275JRH | L máx 1551.67 | Corte superior inclinado según bastidor.
63 | C10 | 1 | Pata vertical SHS40 x40 x3 | S275JRH | L máx 1551.67 | Corte superior inclinado según bastidor.
64 | C10 | 1 | Pata vertical SHS40 x40 x3 | S275JRH | L máx 2088.21 | Corte superior inclinado según bastidor.
65 | C10 | 1 | Pata vertical SHS40 x40 x3 | S275JRH | L máx 2088.21 | Corte superior inclinado según bastidor.
66 | C10 | 8 | Placa base | ASTM A36 | 130 x130 x12 | Perforaciones y anclajes por definir según piso.
67 | C10 | 11 | Rodillo de retorno Ø34 | Acero | Ø34 x 315 | EjeØ12, colgantes y alojamientos en conjunto.
68 | C10 | 1 | Motorreductor de cabeza con acoplamiento | Conjunto comercial | Envolvente geométrica original | Potencia, relación y referencia comercial pendientes; no atribuir potencia a la malla ilustrativa.
69 | C10 | 1 | Plataforma de accionamiento y guardas | Acero | Según conjunto | Incluye ménsulas, base de motor y resguardos laterales.
70 | screen-C09 | 4 | Paños de chuta cerrada, chapa2 | Chapa galvanizada | Aristas tomadas del modelo | Cada paño según geometría; remate inferior separado8mm de la banda.
71 | C09-C10 | 4 | Paños de chuta cerrada, chapa2 | Chapa galvanizada | Aristas tomadas del modelo | Cada paño según geometría; remate inferior separado8mm de la banda.
72 | C10-C02 | 4 | Paños de chuta cerrada, chapa2 | Chapa galvanizada | Aristas tomadas del modelo | Cada paño según geometría; remate inferior separado8mm de la banda.
