acevedocrisologopablo48-lgtm/planta-briquetadora/r21/BOM_R21.csv

id | owner | component | quantity | sourceClass | material | envelopeX | envelopeY | envelopeZ
C01:banda_ida | C01 |  | 1 | R | rubber | 9051.200243026045 | 500 | 2880.3343112888006
C01:banda_retorno | C01 |  | 1 | P | rubber | 9041.051957342741 | 500 | 2910.2386812467894
C01:tambor_cola | C01 |  | 1 | O | paintedSteel | 239.72947752066352 | 600 | 239.72947752066375
C01:eje_cola_centro | C01 |  | 1 | O | machinedSteel | 75.73574567780543 | 700 | 75.73574567780497
C01:eje_cola_extremo_-500 | C01 |  | 1 | O | machinedSteel | 50.82267144168509 | 150 | 50.82267144168486
C01:eje_cola_extremo_350 | C01 |  | 1 | O | machinedSteel | 50.82267144168509 | 150 | 50.82267144168486
C01:autolimpiante_barra_0 | C01 |  | 1 | O | paintedSteel | 30.04177930709602 | 600 | 23.961788844658145
C01:autolimpiante_radio_0 | C01 |  | 1 | R | paintedSteel | 50.67135490709143 | 600 | 24.744346797375783
C01:autolimpiante_barra_1 | C01 |  | 1 | O | paintedSteel | 30.03156076960886 | 600 | 30.661232395927527
C01:autolimpiante_radio_1 | C01 |  | 1 | R | paintedSteel | 41.03602501745104 | 600 | 43.72114458513386
C01:autolimpiante_barra_2 | C01 |  | 1 | O | paintedSteel | 21.974409776458515 | 600 | 29.145023487765002
C01:autolimpiante_radio_2 | C01 |  | 1 | R | paintedSteel | 20.405125363800607 | 600 | 50.98289698914141
C01:autolimpiante_barra_3 | C01 |  | 1 | O | paintedSteel | 23.96178884465826 | 600 | 30.041779307096476
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
C01:aleta_motor_8 | C01 |  | 1 | R | paintedSteel | 93.08935778128762 | 280.79999999999995 | 269.91155308954785
C01:aleta_motor_9 | C01 |  | 1 | R | paintedSteel | 93.0893577812858 | 280.79999999999995 | 269.91155308954785
C01:aleta_motor_10 | C01 |  | 1 | R | paintedSteel | 93.0893577812858 | 280.79999999999995 | 269.91155308954785
C01:aleta_motor_11 | C01 |  | 1 | R | paintedSteel | 93.0893577812858 | 280.79999999999995 | 269.9115530895483
C01:caja_bornes | C01 |  | 1 | R | paintedSteel | 131.04692574148976 | 90 | 88.91553756320354
C01:base_motor | C01 |  | 1 | R | paintedSteel | 505.98010704831177 | 260 | 191.61513371800766
C01:reductor | C01 |  | 1 | R | paintedSteel | 253.82068498421722 | 220 | 259.00608660615944
C01:acoplamiento | C01 |  | 1 | R | paintedSteel | 91.0287511168699 | 80 | 97.51050314429858
C01:capota_techo | C01 |  | 1 | R | paintedSteel | 541.038412543001 | 600 | 194.26467907555207
C01:viga_portico_900_ala_-1 | C01 | support-crossbeam | 1 | P | paintedSteel | 60 | 860 | 5
C01:viga_portico_900_ala_1 | C01 | support-crossbeam | 1 | P | paintedSteel | 60 | 860 | 5
C01:viga_portico_900_alma | C01 | support-crossbeam | 1 | P | paintedSteel | 5 | 860 | 50
C01:pie_900_-1 | C01 | support-baseplate | 1 | P | paintedSteel | 160 | 160 | 25
C01:pata_900_-1_ala_-1 | C01 | support-column | 1 | P | paintedSteel | 80 | 7 | 420.52144492205343
C01:pata_900_-1_ala_1 | C01 | support-column | 1 | P | paintedSteel | 80 | 7 | 420.52144492205343
C01:pata_900_-1_alma | C01 | support-column | 1 | P | paintedSteel | 7 | 66 | 420.52144492205343
C01:capitel_900_-1 | C01 | support-capital | 1 | P | paintedSteel | 100 | 100 | 8
C01:asiento_900_-1 | C01 | support-seat | 1 | P | paintedSteel | 100 | 100 | 43.95380924937285
C01:anclaje_900_-1_0_vastago | C01 | support-anchor | 1 | P | machinedSteel | 16 | 16 | 48
C01:anclaje_900_-1_0_arandela | C01 | support-washer | 1 | P | machinedSteel | 28 | 28 | 3
C01:anclaje_900_-1_0_tuerca | C01 | support-nut | 1 | P | machinedSteel | 25.600000000000364 | 22.170250336881622 | 12.799999999999997
C01:anclaje_900_-1_1_vastago | C01 | support-anchor | 1 | P | machinedSteel | 16 | 16 | 48
C01:anclaje_900_-1_1_arandela | C01 | support-washer | 1 | P | machinedSteel | 28 | 28 | 3
C01:anclaje_900_-1_1_tuerca | C01 | support-nut | 1 | P | machinedSteel | 25.600000000000364 | 22.170250336881622 | 12.799999999999997
C01:anclaje_900_-1_2_vastago | C01 | support-anchor | 1 | P | machinedSteel | 16 | 16 | 48
C01:anclaje_900_-1_2_arandela | C01 | support-washer | 1 | P | machinedSteel | 28 | 28 | 3
C01:anclaje_900_-1_2_tuerca | C01 | support-nut | 1 | P | machinedSteel | 25.600000000000364 | 22.170250336881622 | 12.799999999999997
C01:anclaje_900_-1_3_vastago | C01 | support-anchor | 1 | P | machinedSteel | 16 | 16 | 48
C01:anclaje_900_-1_3_arandela | C01 | support-washer | 1 | P | machinedSteel | 28 | 28 | 3
C01:anclaje_900_-1_3_tuerca | C01 | support-nut | 1 | P | machinedSteel | 25.600000000000364 | 22.170250336881622 | 12.799999999999997
C01:cartela_900_-1_-1 | C01 | support-gusset | 1 | P | paintedSteel | 6 | 55 | 103
C01:cartela_longitudinal_900_-1_-1 | C01 | support-gusset | 1 | P | paintedSteel | 90 | 6 | 103
C01:cartela_900_-1_1 | C01 | support-gusset | 1 | P | paintedSteel | 6 | 55 | 103
C01:cartela_longitudinal_900_-1_1 | C01 | support-gusset | 1 | P | paintedSteel | 90 | 6 | 103
C01:union_900_-1 | C01 | support-joint | 1 | P | paintedSteel | 84 | 12.799999999999955 | 12.799999999999955
C01:union_tuerca_900_-1 | C01 | support-joint-nut | 1 | P | machinedSteel | 8 | 20.799999999999955 | 18.01332839871634
C01:pie_900_1 | C01 | support-baseplate | 1 | P | paintedSteel | 160 | 160 | 25
C01:pata_900_1_ala_-1 | C01 | support-column | 1 | P | paintedSteel | 80 | 7 | 420.52144492205343
C01:pata_900_1_ala_1 | C01 | support-column | 1 | P | paintedSteel | 80 | 7 | 420.52144492205343
C01:pata_900_1_alma | C01 | support-column | 1 | P | paintedSteel | 7 | 66 | 420.52144492205343
C01:capitel_900_1 | C01 | support-capital | 1 | P | paintedSteel | 100 | 100 | 8
C01:asiento_900_1 | C01 | support-seat | 1 | P | paintedSteel | 100 | 100 | 43.95380924937285
C01:anclaje_900_1_0_vastago | C01 | support-anchor | 1 | P | machinedSteel | 16 | 16 | 48
C01:anclaje_900_1_0_arandela | C01 | support-washer | 1 | P | machinedSteel | 28 | 28 | 3
C01:anclaje_900_1_0_tuerca | C01 | support-nut | 1 | P | machinedSteel | 25.600000000000364 | 22.170250336881622 | 12.799999999999997
C01:anclaje_900_1_1_vastago | C01 | support-anchor | 1 | P | machinedSteel | 16 | 16 | 48
C01:anclaje_900_1_1_arandela | C01 | support-washer | 1 | P | machinedSteel | 28 | 28 | 3
C01:anclaje_900_1_1_tuerca | C01 | support-nut | 1 | P | machinedSteel | 25.600000000000364 | 22.170250336881622 | 12.799999999999997
C01:anclaje_900_1_2_vastago | C01 | support-anchor | 1 | P | machinedSteel | 16 | 16 | 48
C01:anclaje_900_1_2_arandela | C01 | support-washer | 1 | P | machinedSteel | 28 | 28 | 3
C01:anclaje_900_1_2_tuerca | C01 | support-nut | 1 | P | machinedSteel | 25.600000000000364 | 22.170250336881622 | 12.799999999999997
C01:anclaje_900_1_3_vastago | C01 | support-anchor | 1 | P | machinedSteel | 16 | 16 | 48
C01:anclaje_900_1_3_arandela | C01 | support-washer | 1 | P | machinedSteel | 28 | 28 | 3
C01:anclaje_900_1_3_tuerca | C01 | support-nut | 1 | P | machinedSteel | 25.600000000000364 | 22.170250336881622 | 12.799999999999997
C01:cartela_900_1_-1 | C01 | support-gusset | 1 | P | paintedSteel | 6 | 55 | 103
C01:cartela_longitudinal_900_1_-1 | C01 | support-gusset | 1 | P | paintedSteel | 90 | 6 | 103
C01:cartela_900_1_1 | C01 | support-gusset | 1 | P | paintedSteel | 6 | 55 | 103
C01:cartela_longitudinal_900_1_1 | C01 | support-gusset | 1 | P | paintedSteel | 90 | 6 | 103
C01:union_900_1 | C01 | support-joint | 1 | P | paintedSteel | 84 | 12.799999999999955 | 12.799999999999955
C01:union_tuerca_900_1 | C01 | support-joint-nut | 1 | P | machinedSteel | 8 | 20.799999999999955 | 18.01332839871634
C01:viga_portico_3400_ala_-1 | C01 | support-crossbeam | 1 | P | paintedSteel | 60 | 860 | 5
C01:viga_portico_3400_ala_1 | C01 | support-crossbeam | 1 | P | paintedSteel | 60 | 860 | 5
C01:viga_portico_3400_alma | C01 | support-crossbeam | 1 | P | paintedSteel | 5 | 860 | 50
C01:pie_3400_-1 | C01 | support-baseplate | 1 | P | paintedSteel | 160 | 160 | 25
C01:pata_3400_-1_ala_-1 | C01 | support-column | 1 | P | paintedSteel | 80 | 7 | 1181.4628936698307
C01:pata_3400_-1_ala_1 | C01 | support-column | 1 | P | paintedSteel | 80 | 7 | 1181.4628936698307
C01:pata_3400_-1_alma | C01 | support-column | 1 | P | paintedSteel | 7 | 66 | 1181.4628936698307
C01:capitel_3400_-1 | C01 | support-capital | 1 | P | paintedSteel | 100 | 100 | 8
C01:asiento_3400_-1 | C01 | support-seat | 1 | P | paintedSteel | 100 | 100 | 43.953809249372625
C01:anclaje_3400_-1_0_vastago | C01 | support-anchor | 1 | P | machinedSteel | 16 | 16 | 48
C01:anclaje_3400_-1_0_arandela | C01 | support-washer | 1 | P | machinedSteel | 28 | 28 | 3
C01:anclaje_3400_-1_0_tuerca | C01 | support-nut | 1 | P | machinedSteel | 25.600000000000364 | 22.170250336881622 | 12.799999999999997
C01:anclaje_3400_-1_1_vastago | C01 | support-anchor | 1 | P | machinedSteel | 16 | 16 | 48
C01:anclaje_3400_-1_1_arandela | C01 | support-washer | 1 | P | machinedSteel | 28 | 28 | 3
C01:anclaje_3400_-1_1_tuerca | C01 | support-nut | 1 | P | machinedSteel | 25.600000000000364 | 22.170250336881622 | 12.799999999999997
C01:anclaje_3400_-1_2_vastago | C01 | support-anchor | 1 | P | machinedSteel | 16 | 16 | 48
C01:anclaje_3400_-1_2_arandela | C01 | support-washer | 1 | P | machinedSteel | 28 | 28 | 3
C01:anclaje_3400_-1_2_tuerca | C01 | support-nut | 1 | P | machinedSteel | 25.600000000000364 | 22.170250336881622 | 12.799999999999997
C01:anclaje_3400_-1_3_vastago | C01 | support-anchor | 1 | P | machinedSteel | 16 | 16 | 48
C01:anclaje_3400_-1_3_arandela | C01 | support-washer | 1 | P | machinedSteel | 28 | 28 | 3
C01:anclaje_3400_-1_3_tuerca | C01 | support-nut | 1 | P | machinedSteel | 25.600000000000364 | 22.170250336881622 | 12.799999999999997
C01:cartela_3400_-1_-1 | C01 | support-gusset | 1 | P | paintedSteel | 6 | 55 | 103
C01:cartela_longitudinal_3400_-1_-1 | C01 | support-gusset | 1 | P | paintedSteel | 90 | 6 | 103
C01:cartela_3400_-1_1 | C01 | support-gusset | 1 | P | paintedSteel | 6 | 55 | 103
C01:cartela_longitudinal_3400_-1_1 | C01 | support-gusset | 1 | P | paintedSteel | 90 | 6 | 103
C01:union_3400_-1 | C01 | support-joint | 1 | P | paintedSteel | 84 | 12.799999999999955 | 12.800000000000182
C01:union_tuerca_3400_-1 | C01 | support-joint-nut | 1 | P | machinedSteel | 8 | 20.799999999999955 | 18.013328398716112
C01:pie_3400_1 | C01 | support-baseplate | 1 | P | paintedSteel | 160 | 160 | 25
C01:pata_3400_1_ala_-1 | C01 | support-column | 1 | P | paintedSteel | 80 | 7 | 1181.4628936698307
C01:pata_3400_1_ala_1 | C01 | support-column | 1 | P | paintedSteel | 80 | 7 | 1181.4628936698307
C01:pata_3400_1_alma | C01 | support-column | 1 | P | paintedSteel | 7 | 66 | 1181.4628936698307
C01:capitel_3400_1 | C01 | support-capital | 1 | P | paintedSteel | 100 | 100 | 8
C01:asiento_3400_1 | C01 | support-seat | 1 | P | paintedSteel | 100 | 100 | 43.953809249372625
C01:anclaje_3400_1_0_vastago | C01 | support-anchor | 1 | P | machinedSteel | 16 | 16 | 48
C01:anclaje_3400_1_0_arandela | C01 | support-washer | 1 | P | machinedSteel | 28 | 28 | 3
C01:anclaje_3400_1_0_tuerca | C01 | support-nut | 1 | P | machinedSteel | 25.600000000000364 | 22.170250336881622 | 12.799999999999997
C01:anclaje_3400_1_1_vastago | C01 | support-anchor | 1 | P | machinedSteel | 16 | 16 | 48
C01:anclaje_3400_1_1_arandela | C01 | support-washer | 1 | P | machinedSteel | 28 | 28 | 3
C01:anclaje_3400_1_1_tuerca | C01 | support-nut | 1 | P | machinedSteel | 25.600000000000364 | 22.170250336881622 | 12.799999999999997
C01:anclaje_3400_1_2_vastago | C01 | support-anchor | 1 | P | machinedSteel | 16 | 16 | 48
C01:anclaje_3400_1_2_arandela | C01 | support-washer | 1 | P | machinedSteel | 28 | 28 | 3
C01:anclaje_3400_1_2_tuerca | C01 | support-nut | 1 | P | machinedSteel | 25.600000000000364 | 22.170250336881622 | 12.799999999999997
C01:anclaje_3400_1_3_vastago | C01 | support-anchor | 1 | P | machinedSteel | 16 | 16 | 48
C01:anclaje_3400_1_3_arandela | C01 | support-washer | 1 | P | machinedSteel | 28 | 28 | 3
C01:anclaje_3400_1_3_tuerca | C01 | support-nut | 1 | P | machinedSteel | 25.600000000000364 | 22.170250336881622 | 12.799999999999997
C01:cartela_3400_1_-1 | C01 | support-gusset | 1 | P | paintedSteel | 6 | 55 | 103
C01:cartela_longitudinal_3400_1_-1 | C01 | support-gusset | 1 | P | paintedSteel | 90 | 6 | 103
C01:cartela_3400_1_1 | C01 | support-gusset | 1 | P | paintedSteel | 6 | 55 | 103
C01:cartela_longitudinal_3400_1_1 | C01 | support-gusset | 1 | P | paintedSteel | 90 | 6 | 103
C01:union_3400_1 | C01 | support-joint | 1 | P | paintedSteel | 84 | 12.799999999999955 | 12.800000000000182
C01:union_tuerca_3400_1 | C01 | support-joint-nut | 1 | P | machinedSteel | 8 | 20.799999999999955 | 18.013328398716112
C01:viga_portico_5900_ala_-1 | C01 | support-crossbeam | 1 | P | paintedSteel | 60 | 860 | 5
C01:viga_portico_5900_ala_1 | C01 | support-crossbeam | 1 | P | paintedSteel | 60 | 860 | 5
C01:viga_portico_5900_alma | C01 | support-crossbeam | 1 | P | paintedSteel | 5 | 860 | 50
C01:pie_5900_-1 | C01 | support-baseplate | 1 | P | paintedSteel | 160 | 160 | 25
C01:pata_5900_-1_ala_-1 | C01 | support-column | 1 | P | paintedSteel | 80 | 7 | 1942.4043424176077
C01:pata_5900_-1_ala_1 | C01 | support-column | 1 | P | paintedSteel | 80 | 7 | 1942.4043424176077
C01:pata_5900_-1_alma | C01 | support-column | 1 | P | paintedSteel | 7 | 66 | 1942.4043424176077
C01:capitel_5900_-1 | C01 | support-capital | 1 | P | paintedSteel | 100 | 100 | 8
C01:asiento_5900_-1 | C01 | support-seat | 1 | P | paintedSteel | 100 | 100 | 43.9538092493724
C01:anclaje_5900_-1_0_vastago | C01 | support-anchor | 1 | P | machinedSteel | 16 | 16 | 48
C01:anclaje_5900_-1_0_arandela | C01 | support-washer | 1 | P | machinedSteel | 28 | 28 | 3
C01:anclaje_5900_-1_0_tuerca | C01 | support-nut | 1 | P | machinedSteel | 25.600000000000364 | 22.170250336881622 | 12.799999999999997
C01:anclaje_5900_-1_1_vastago | C01 | support-anchor | 1 | P | machinedSteel | 16 | 16 | 48
C01:anclaje_5900_-1_1_arandela | C01 | support-washer | 1 | P | machinedSteel | 28 | 28 | 3
C01:anclaje_5900_-1_1_tuerca | C01 | support-nut | 1 | P | machinedSteel | 25.600000000000364 | 22.170250336881622 | 12.799999999999997
C01:anclaje_5900_-1_2_vastago | C01 | support-anchor | 1 | P | machinedSteel | 16 | 16 | 48
C01:anclaje_5900_-1_2_arandela | C01 | support-washer | 1 | P | machinedSteel | 28 | 28 | 3
C01:anclaje_5900_-1_2_tuerca | C01 | support-nut | 1 | P | machinedSteel | 25.600000000000364 | 22.170250336881622 | 12.799999999999997
C01:anclaje_5900_-1_3_vastago | C01 | support-anchor | 1 | P | machinedSteel | 16 | 16 | 48
C01:anclaje_5900_-1_3_arandela | C01 | support-washer | 1 | P | machinedSteel | 28 | 28 | 3
C01:anclaje_5900_-1_3_tuerca | C01 | support-nut | 1 | P | machinedSteel | 25.600000000000364 | 22.170250336881622 | 12.799999999999997
C01:cartela_5900_-1_-1 | C01 | support-gusset | 1 | P | paintedSteel | 6 | 55 | 103
C01:cartela_longitudinal_5900_-1_-1 | C01 | support-gusset | 1 | P | paintedSteel | 90 | 6 | 103
C01:cartela_5900_-1_1 | C01 | support-gusset | 1 | P | paintedSteel | 6 | 55 | 103
C01:cartela_longitudinal_5900_-1_1 | C01 | support-gusset | 1 | P | paintedSteel | 90 | 6 | 103
C01:union_5900_-1 | C01 | support-joint | 1 | P | paintedSteel | 84 | 12.799999999999955 | 12.800000000000182
C01:union_tuerca_5900_-1 | C01 | support-joint-nut | 1 | P | machinedSteel | 8 | 20.799999999999955 | 18.013328398716112
C01:pie_5900_1 | C01 | support-baseplate | 1 | P | paintedSteel | 160 | 160 | 25
C01:pata_5900_1_ala_-1 | C01 | support-column | 1 | P | paintedSteel | 80 | 7 | 1942.4043424176077
C01:pata_5900_1_ala_1 | C01 | support-column | 1 | P | paintedSteel | 80 | 7 | 1942.4043424176077
C01:pata_5900_1_alma | C01 | support-column | 1 | P | paintedSteel | 7 | 66 | 1942.4043424176077
C01:capitel_5900_1 | C01 | support-capital | 1 | P | paintedSteel | 100 | 100 | 8
C01:asiento_5900_1 | C01 | support-seat | 1 | P | paintedSteel | 100 | 100 | 43.9538092493724
C01:anclaje_5900_1_0_vastago | C01 | support-anchor | 1 | P | machinedSteel | 16 | 16 | 48
C01:anclaje_5900_1_0_arandela | C01 | support-washer | 1 | P | machinedSteel | 28 | 28 | 3
C01:anclaje_5900_1_0_tuerca | C01 | support-nut | 1 | P | machinedSteel | 25.600000000000364 | 22.170250336881622 | 12.799999999999997
C01:anclaje_5900_1_1_vastago | C01 | support-anchor | 1 | P | machinedSteel | 16 | 16 | 48
C01:anclaje_5900_1_1_arandela | C01 | support-washer | 1 | P | machinedSteel | 28 | 28 | 3
C01:anclaje_5900_1_1_tuerca | C01 | support-nut | 1 | P | machinedSteel | 25.600000000000364 | 22.170250336881622 | 12.799999999999997
C01:anclaje_5900_1_2_vastago | C01 | support-anchor | 1 | P | machinedSteel | 16 | 16 | 48
C01:anclaje_5900_1_2_arandela | C01 | support-washer | 1 | P | machinedSteel | 28 | 28 | 3
C01:anclaje_5900_1_2_tuerca | C01 | support-nut | 1 | P | machinedSteel | 25.600000000000364 | 22.170250336881622 | 12.799999999999997
C01:anclaje_5900_1_3_vastago | C01 | support-anchor | 1 | P | machinedSteel | 16 | 16 | 48
C01:anclaje_5900_1_3_arandela | C01 | support-washer | 1 | P | machinedSteel | 28 | 28 | 3
C01:anclaje_5900_1_3_tuerca | C01 | support-nut | 1 | P | machinedSteel | 25.600000000000364 | 22.170250336881622 | 12.799999999999997
C01:cartela_5900_1_-1 | C01 | support-gusset | 1 | P | paintedSteel | 6 | 55 | 103
C01:cartela_longitudinal_5900_1_-1 | C01 | support-gusset | 1 | P | paintedSteel | 90 | 6 | 103
C01:cartela_5900_1_1 | C01 | support-gusset | 1 | P | paintedSteel | 6 | 55 | 103
C01:cartela_longitudinal_5900_1_1 | C01 | support-gusset | 1 | P | paintedSteel | 90 | 6 | 103
C01:union_5900_1 | C01 | support-joint | 1 | P | paintedSteel | 84 | 12.799999999999955 | 12.800000000000182
C01:union_tuerca_5900_1 | C01 | support-joint-nut | 1 | P | machinedSteel | 8 | 20.799999999999955 | 18.013328398716112
C01:viga_portico_8400_ala_-1 | C01 | support-crossbeam | 1 | P | paintedSteel | 60 | 1960 | 5
C01:viga_portico_8400_ala_1 | C01 | support-crossbeam | 1 | P | paintedSteel | 60 | 1960 | 5
C01:viga_portico_8400_alma | C01 | support-crossbeam | 1 | P | paintedSteel | 5 | 1960 | 50
C01:pie_8400_-1 | C01 | support-baseplate | 1 | P | paintedSteel | 160 | 160 | 25
C01:pata_8400_-1_ala_-1 | C01 | support-column | 1 | P | paintedSteel | 80 | 7 | 2703.345791165385
C01:pata_8400_-1_ala_1 | C01 | support-column | 1 | P | paintedSteel | 80 | 7 | 2703.345791165385
C01:pata_8400_-1_alma | C01 | support-column | 1 | P | paintedSteel | 7 | 66 | 2703.345791165385
C01:capitel_8400_-1 | C01 | support-capital | 1 | P | paintedSteel | 100 | 100 | 8
C01:asiento_8400_-1 | C01 | support-seat | 1 | P | paintedSteel | 99.99999999999818 | 100 | 43.95380924937217
C01:anclaje_8400_-1_0_vastago | C01 | support-anchor | 1 | P | machinedSteel | 16 | 16 | 48
C01:anclaje_8400_-1_0_arandela | C01 | support-washer | 1 | P | machinedSteel | 28 | 28 | 3
C01:anclaje_8400_-1_0_tuerca | C01 | support-nut | 1 | P | machinedSteel | 25.599999999998545 | 22.17025033688151 | 12.799999999999997
C01:anclaje_8400_-1_1_vastago | C01 | support-anchor | 1 | P | machinedSteel | 16 | 16 | 48
C01:anclaje_8400_-1_1_arandela | C01 | support-washer | 1 | P | machinedSteel | 28 | 28 | 3
C01:anclaje_8400_-1_1_tuerca | C01 | support-nut | 1 | P | machinedSteel | 25.599999999998545 | 22.17025033688151 | 12.799999999999997
C01:anclaje_8400_-1_2_vastago | C01 | support-anchor | 1 | P | machinedSteel | 16 | 16 | 48
C01:anclaje_8400_-1_2_arandela | C01 | support-washer | 1 | P | machinedSteel | 28 | 28 | 3
C01:anclaje_8400_-1_2_tuerca | C01 | support-nut | 1 | P | machinedSteel | 25.599999999998545 | 22.17025033688151 | 12.799999999999997
C01:anclaje_8400_-1_3_vastago | C01 | support-anchor | 1 | P | machinedSteel | 16 | 16 | 48
C01:anclaje_8400_-1_3_arandela | C01 | support-washer | 1 | P | machinedSteel | 28 | 28 | 3
C01:anclaje_8400_-1_3_tuerca | C01 | support-nut | 1 | P | machinedSteel | 25.599999999998545 | 22.17025033688151 | 12.799999999999997
C01:cartela_8400_-1_-1 | C01 | support-gusset | 1 | P | paintedSteel | 6 | 55 | 103
C01:cartela_longitudinal_8400_-1_-1 | C01 | support-gusset | 1 | P | paintedSteel | 90 | 6 | 103
C01:cartela_8400_-1_1 | C01 | support-gusset | 1 | P | paintedSteel | 6 | 55 | 103
C01:cartela_longitudinal_8400_-1_1 | C01 | support-gusset | 1 | P | paintedSteel | 90 | 6 | 103
C01:union_8400_-1 | C01 | support-joint | 1 | P | paintedSteel | 84 | 12.799999999999955 | 12.800000000000182
C01:union_tuerca_8400_-1 | C01 | support-joint-nut | 1 | P | machinedSteel | 8 | 20.799999999999955 | 18.013328398716112
C01:pie_8400_1 | C01 | support-baseplate | 1 | P | paintedSteel | 160 | 160 | 25
C01:pata_8400_1_ala_-1 | C01 | support-column | 1 | P | paintedSteel | 80 | 7 | 2703.345791165385
C01:pata_8400_1_ala_1 | C01 | support-column | 1 | P | paintedSteel | 80 | 7 | 2703.345791165385
C01:pata_8400_1_alma | C01 | support-column | 1 | P | paintedSteel | 7 | 66 | 2703.345791165385
C01:capitel_8400_1 | C01 | support-capital | 1 | P | paintedSteel | 100 | 100 | 8
C01:asiento_8400_1 | C01 | support-seat | 1 | P | paintedSteel | 99.99999999999818 | 100 | 43.95380924937217
C01:anclaje_8400_1_0_vastago | C01 | support-anchor | 1 | P | machinedSteel | 16 | 16 | 48
C01:anclaje_8400_1_0_arandela | C01 | support-washer | 1 | P | machinedSteel | 28 | 28 | 3
C01:anclaje_8400_1_0_tuerca | C01 | support-nut | 1 | P | machinedSteel | 25.599999999998545 | 22.170250336881622 | 12.799999999999997
C01:anclaje_8400_1_1_vastago | C01 | support-anchor | 1 | P | machinedSteel | 16 | 16 | 48
C01:anclaje_8400_1_1_arandela | C01 | support-washer | 1 | P | machinedSteel | 28 | 28 | 3
C01:anclaje_8400_1_1_tuerca | C01 | support-nut | 1 | P | machinedSteel | 25.599999999998545 | 22.170250336881622 | 12.799999999999997
C01:anclaje_8400_1_2_vastago | C01 | support-anchor | 1 | P | machinedSteel | 16 | 16 | 48
C01:anclaje_8400_1_2_arandela | C01 | support-washer | 1 | P | machinedSteel | 28 | 28 | 3
C01:anclaje_8400_1_2_tuerca | C01 | support-nut | 1 | P | machinedSteel | 25.599999999998545 | 22.17025033688151 | 12.799999999999997
C01:anclaje_8400_1_3_vastago | C01 | support-anchor | 1 | P | machinedSteel | 16 | 16 | 48
C01:anclaje_8400_1_3_arandela | C01 | support-washer | 1 | P | machinedSteel | 28 | 28 | 3
C01:anclaje_8400_1_3_tuerca | C01 | support-nut | 1 | P | machinedSteel | 25.599999999998545 | 22.17025033688151 | 12.799999999999997
C01:cartela_8400_1_-1 | C01 | support-gusset | 1 | P | paintedSteel | 6 | 55 | 103
C01:cartela_longitudinal_8400_1_-1 | C01 | support-gusset | 1 | P | paintedSteel | 90 | 6 | 103
C01:cartela_8400_1_1 | C01 | support-gusset | 1 | P | paintedSteel | 6 | 55 | 103
C01:cartela_longitudinal_8400_1_1 | C01 | support-gusset | 1 | P | paintedSteel | 90 | 6 | 103
C01:union_8400_1 | C01 | support-joint | 1 | P | paintedSteel | 84 | 12.799999999999955 | 12.800000000000182
C01:union_tuerca_8400_1 | C01 | support-joint-nut | 1 | P | machinedSteel | 8 | 20.799999999999955 | 18.013328398716112
C01:base_artesa_960 | C01 |  | 1 | O | paintedSteel | 52.042149491883265 | 850 | 26.892951625458863
C01:base_artesa_960_placa_-1 | C01 |  | 1 | P | paintedSteel | 63.39832669948146 | 52 | 27.100515345879103
C01:base_artesa_960_ménsula_-1 | C01 |  | 1 | P | paintedSteel | 59.48975979480838 | 28 | 105.87471250113913
C01:base_artesa_960_perno_-1 | C01 |  | 1 | R | galvanizedSteel | 15.083140340893351 | 10.392304845413264 | 15.083140340893465
C01:base_artesa_960_placa_1 | C01 |  | 1 | P | paintedSteel | 63.39832669948146 | 52 | 27.100515345879103
C01:base_artesa_960_ménsula_1 | C01 |  | 1 | P | paintedSteel | 59.48975979480838 | 28 | 105.87471250113913
C01:base_artesa_960_perno_1 | C01 |  | 1 | R | galvanizedSteel | 15.083140340893351 | 10.392304845413264 | 15.083140340893465
C01:eje_polin_carga_central_960 | C01 |  | 1 | R | machinedSteel | 17.979710814049668 | 296 | 17.979710814049668
C01:polin_carga_central_960 | C01 |  | 1 | O | machinedSteel | 50.74273940854073 | 260 | 50.7427394085405
C01:polin_carga_central_960_horquilla_-1_ménsula | C01 |  | 1 | R | paintedSteel | 33.53934957631736 | 18 | 51.42896120924263
C01:polin_carga_central_960_horquilla_-1_pie_horquilla | C01 |  | 1 | R | paintedSteel | 48.766251342607575 | 14 | 24.135593638377372
C01:polin_carga_central_960_horquilla_-1_oreja_-1 | C01 |  | 1 | R | paintedSteel | 24.13559363837703 | 14 | 48.76625134260746
C01:polin_carga_central_960_horquilla_-1_oreja_1 | C01 |  | 1 | R | paintedSteel | 24.135593638377486 | 14 | 48.76625134260735
C01:polin_carga_central_960_horquilla_-1_alojamiento | C01 |  | 1 | R | machinedSteel | 37.95716727410536 | 12 | 37.957167274104904
C01:polin_carga_central_960_horquilla_1_ménsula | C01 |  | 1 | R | paintedSteel | 33.53934957631736 | 18 | 51.42896120924263
C01:polin_carga_central_960_horquilla_1_pie_horquilla | C01 |  | 1 | R | paintedSteel | 48.766251342607575 | 14 | 24.135593638377372
C01:polin_carga_central_960_horquilla_1_oreja_-1 | C01 |  | 1 | R | paintedSteel | 24.13559363837703 | 14 | 48.76625134260746
C01:polin_carga_central_960_horquilla_1_oreja_1 | C01 |  | 1 | R | paintedSteel | 24.135593638377486 | 14 | 48.76625134260735
C01:polin_carga_central_960_horquilla_1_alojamiento | C01 |  | 1 | R | machinedSteel | 37.95716727410536 | 12 | 37.957167274104904
C01:eje_polin_carga_lateral_-1_960 | C01 |  | 1 | R | machinedSteel | 63.04915468813624 | 224.12303701907325 | 157.6587676031495
C01:polin_carga_lateral_-1_960 | C01 |  | 1 | O | machinedSteel | 89.09897651606252 | 213.4468297289141 | 165.27767654529498
C01:polin_carga_lateral_-1_960_horquilla_-1_ménsula | C01 |  | 1 | R | paintedSteel | 80.80295185751265 | 20.86607312800828 | 199.33059775600668
C01:polin_carga_lateral_-1_960_horquilla_-1_pie_horquilla | C01 |  | 1 | R | paintedSteel | 50.653400045478065 | 17.261224511862338 | 30.064049272230932
C01:polin_carga_lateral_-1_960_horquilla_-1_oreja_-1 | C01 |  | 1 | R | paintedSteel | 23.955834705598136 | 39.01168450614273 | 48.140663175999634
C01:polin_carga_lateral_-1_960_horquilla_-1_oreja_1 | C01 |  | 1 | R | paintedSteel | 23.95583470559768 | 39.01168450614273 | 48.140663175999634
C01:polin_carga_lateral_-1_960_horquilla_-1_alojamiento | C01 |  | 1 | R | machinedSteel | 39.50599016952856 | 31.625681835165892 | 38.18633693493234
C01:polin_carga_lateral_-1_960_horquilla_1_ménsula | C01 |  | 1 | R | paintedSteel | 38.20518243503875 | 20.848705071716495 | 66.02146176237125
C01:polin_carga_lateral_-1_960_horquilla_1_pie_horquilla | C01 |  | 1 | R | paintedSteel | 50.653400045478065 | 17.261224511862338 | 30.064049272230704
C01:polin_carga_lateral_-1_960_horquilla_1_oreja_-1 | C01 |  | 1 | R | paintedSteel | 23.955834705598136 | 39.01168450614273 | 48.140663175999634
C01:polin_carga_lateral_-1_960_horquilla_1_oreja_1 | C01 |  | 1 | R | paintedSteel | 23.95583470559768 | 39.01168450614273 | 48.140663175999634
C01:polin_carga_lateral_-1_960_horquilla_1_alojamiento | C01 |  | 1 | R | machinedSteel | 39.505990169529014 | 31.625681835165892 | 38.18633693493234
C01:eje_polin_carga_lateral_1_960 | C01 |  | 1 | R | machinedSteel | 63.04915468813624 | 224.12303701907325 | 157.6587676031495
C01:polin_carga_lateral_1_960 | C01 |  | 1 | O | machinedSteel | 89.09897651606252 | 213.4468297289141 | 165.27767654529498
C01:polin_carga_lateral_1_960_horquilla_-1_ménsula | C01 |  | 1 | R | paintedSteel | 38.20518243503875 | 20.848705071716495 | 66.02146176237125
C01:polin_carga_lateral_1_960_horquilla_-1_pie_horquilla | C01 |  | 1 | R | paintedSteel | 50.653400045478065 | 17.261224511862338 | 30.064049272230704
C01:polin_carga_lateral_1_960_horquilla_-1_oreja_-1 | C01 |  | 1 | R | paintedSteel | 23.955834705598136 | 39.01168450614273 | 48.140663175999634
C01:polin_carga_lateral_1_960_horquilla_-1_oreja_1 | C01 |  | 1 | R | paintedSteel | 23.95583470559768 | 39.01168450614273 | 48.140663175999634
C01:polin_carga_lateral_1_960_horquilla_-1_alojamiento | C01 |  | 1 | R | machinedSteel | 39.505990169529014 | 31.625681835165892 | 38.18633693493234
C01:polin_carga_lateral_1_960_horquilla_1_ménsula | C01 |  | 1 | R | paintedSteel | 80.80295185751265 | 20.86607312800828 | 199.33059775600668
C01:polin_carga_lateral_1_960_horquilla_1_pie_horquilla | C01 |  | 1 | R | paintedSteel | 50.653400045478065 | 17.261224511862338 | 30.064049272230932
C01:polin_carga_lateral_1_960_horquilla_1_oreja_-1 | C01 |  | 1 | R | paintedSteel | 23.955834705598136 | 39.01168450614273 | 48.140663175999634
C01:polin_carga_lateral_1_960_horquilla_1_oreja_1 | C01 |  | 1 | R | paintedSteel | 23.95583470559768 | 39.01168450614273 | 48.140663175999634
C01:polin_carga_lateral_1_960_horquilla_1_alojamiento | C01 |  | 1 | R | machinedSteel | 39.50599016952856 | 31.625681835165892 | 38.18633693493234
C01:base_artesa_1940 | C01 |  | 1 | O | paintedSteel | 52.04214949188281 | 850 | 26.892951625458863
C01:base_artesa_1940_placa_-1 | C01 |  | 1 | P | paintedSteel | 63.39832669948146 | 52 | 27.100515345878875
C01:base_artesa_1940_ménsula_-1 | C01 |  | 1 | P | paintedSteel | 58.98082987279713 | 28 | 104.28200748735071
C01:base_artesa_1940_perno_-1 | C01 |  | 1 | R | galvanizedSteel | 15.083140340893351 | 10.392304845413264 | 15.083140340893351
C01:base_artesa_1940_placa_1 | C01 |  | 1 | P | paintedSteel | 63.39832669948146 | 52 | 27.100515345878875
C01:base_artesa_1940_ménsula_1 | C01 |  | 1 | P | paintedSteel | 58.98082987279713 | 28 | 104.28200748735071
C01:base_artesa_1940_perno_1 | C01 |  | 1 | R | galvanizedSteel | 15.083140340893351 | 10.392304845413264 | 15.083140340893351
C01:eje_polin_carga_central_1940 | C01 |  | 1 | R | machinedSteel | 17.979710814049668 | 296 | 17.979710814049895
C01:polin_carga_central_1940 | C01 |  | 1 | O | machinedSteel | 50.742739408540274 | 260 | 50.7427394085405
C01:polin_carga_central_1940_horquilla_-1_ménsula | C01 |  | 1 | R | paintedSteel | 33.53934957631736 | 18 | 51.42896120924274
C01:polin_carga_central_1940_horquilla_-1_pie_horquilla | C01 |  | 1 | R | paintedSteel | 48.766251342607575 | 14 | 24.135593638377486
C01:polin_carga_central_1940_horquilla_-1_oreja_-1 | C01 |  | 1 | R | paintedSteel | 24.13559363837703 | 14 | 48.766251342607575
C01:polin_carga_central_1940_horquilla_-1_oreja_1 | C01 |  | 1 | R | paintedSteel | 24.135593638377486 | 14 | 48.76625134260735
C01:polin_carga_central_1940_horquilla_-1_alojamiento | C01 |  | 1 | R | machinedSteel | 37.957167274104904 | 12 | 37.95716727410513
C01:polin_carga_central_1940_horquilla_1_ménsula | C01 |  | 1 | R | paintedSteel | 33.53934957631736 | 18 | 51.42896120924274
C01:polin_carga_central_1940_horquilla_1_pie_horquilla | C01 |  | 1 | R | paintedSteel | 48.766251342607575 | 14 | 24.135593638377486
C01:polin_carga_central_1940_horquilla_1_oreja_-1 | C01 |  | 1 | R | paintedSteel | 24.13559363837703 | 14 | 48.766251342607575
C01:polin_carga_central_1940_horquilla_1_oreja_1 | C01 |  | 1 | R | paintedSteel | 24.135593638377486 | 14 | 48.76625134260735
C01:polin_carga_central_1940_horquilla_1_alojamiento | C01 |  | 1 | R | machinedSteel | 37.957167274104904 | 12 | 37.95716727410513
C01:eje_polin_carga_lateral_-1_1940 | C01 |  | 1 | R | machinedSteel | 63.04915468813624 | 224.12303701907325 | 157.65876760314927
C01:polin_carga_lateral_-1_1940 | C01 |  | 1 | O | machinedSteel | 89.09897651606207 | 213.4468297289141 | 165.2776765452952
C01:polin_carga_lateral_-1_1940_horquilla_-1_ménsula | C01 |  | 1 | R | paintedSteel | 80.80295185751311 | 20.86607312800828 | 199.33059775600714
C01:polin_carga_lateral_-1_1940_horquilla_-1_pie_horquilla | C01 |  | 1 | R | paintedSteel | 50.65340004547761 | 17.261224511862338 | 30.06404927223116
C01:polin_carga_lateral_-1_1940_horquilla_-1_oreja_-1 | C01 |  | 1 | R | paintedSteel | 23.95583470559768 | 39.01168450614273 | 48.14066317599941
C01:polin_carga_lateral_-1_1940_horquilla_-1_oreja_1 | C01 |  | 1 | R | paintedSteel | 23.95583470559768 | 39.01168450614273 | 48.14066317599941
C01:polin_carga_lateral_-1_1940_horquilla_-1_alojamiento | C01 |  | 1 | R | machinedSteel | 39.50599016952856 | 31.625681835165892 | 38.186336934932115
C01:polin_carga_lateral_-1_1940_horquilla_1_ménsula | C01 |  | 1 | R | paintedSteel | 38.20518243503875 | 20.848705071716495 | 66.02146176237125
C01:polin_carga_lateral_-1_1940_horquilla_1_pie_horquilla | C01 |  | 1 | R | paintedSteel | 50.653400045478065 | 17.261224511862338 | 30.064049272230932
C01:polin_carga_lateral_-1_1940_horquilla_1_oreja_-1 | C01 |  | 1 | R | paintedSteel | 23.95583470559768 | 39.01168450614273 | 48.140663175999634
C01:polin_carga_lateral_-1_1940_horquilla_1_oreja_1 | C01 |  | 1 | R | paintedSteel | 23.95583470559768 | 39.01168450614273 | 48.140663175999634
C01:polin_carga_lateral_-1_1940_horquilla_1_alojamiento | C01 |  | 1 | R | machinedSteel | 39.505990169529014 | 31.625681835165892 | 38.18633693493234
C01:eje_polin_carga_lateral_1_1940 | C01 |  | 1 | R | machinedSteel | 63.04915468813624 | 224.12303701907325 | 157.65876760314927
C01:polin_carga_lateral_1_1940 | C01 |  | 1 | O | machinedSteel | 89.09897651606207 | 213.4468297289141 | 165.2776765452952
C01:polin_carga_lateral_1_1940_horquilla_-1_ménsula | C01 |  | 1 | R | paintedSteel | 38.20518243503875 | 20.848705071716495 | 66.02146176237125
C01:polin_carga_lateral_1_1940_horquilla_-1_pie_horquilla | C01 |  | 1 | R | paintedSteel | 50.653400045478065 | 17.261224511862338 | 30.064049272230932
C01:polin_carga_lateral_1_1940_horquilla_-1_oreja_-1 | C01 |  | 1 | R | paintedSteel | 23.95583470559768 | 39.01168450614273 | 48.140663175999634
C01:polin_carga_lateral_1_1940_horquilla_-1_oreja_1 | C01 |  | 1 | R | paintedSteel | 23.95583470559768 | 39.01168450614273 | 48.140663175999634
C01:polin_carga_lateral_1_1940_horquilla_-1_alojamiento | C01 |  | 1 | R | machinedSteel | 39.505990169529014 | 31.625681835165892 | 38.18633693493234
C01:polin_carga_lateral_1_1940_horquilla_1_ménsula | C01 |  | 1 | R | paintedSteel | 80.80295185751311 | 20.86607312800828 | 199.33059775600714
C01:polin_carga_lateral_1_1940_horquilla_1_pie_horquilla | C01 |  | 1 | R | paintedSteel | 50.65340004547761 | 17.261224511862338 | 30.06404927223116
C01:polin_carga_lateral_1_1940_horquilla_1_oreja_-1 | C01 |  | 1 | R | paintedSteel | 23.95583470559768 | 39.01168450614273 | 48.14066317599941
C01:polin_carga_lateral_1_1940_horquilla_1_oreja_1 | C01 |  | 1 | R | paintedSteel | 23.95583470559768 | 39.01168450614273 | 48.14066317599941
C01:polin_carga_lateral_1_1940_horquilla_1_alojamiento | C01 |  | 1 | R | machinedSteel | 39.50599016952856 | 31.625681835165892 | 38.186336934932115
C01:base_artesa_2920 | C01 |  | 1 | O | paintedSteel | 52.04214949188281 | 850 | 26.892951625458863
C01:base_artesa_2920_placa_-1 | C01 |  | 1 | P | paintedSteel | 63.398326699481004 | 52 | 27.100515345878875
C01:base_artesa_2920_ménsula_-1 | C01 |  | 1 | P | paintedSteel | 58.47189995078679 | 28 | 102.68930247356207
C01:base_artesa_2920_perno_-1 | C01 |  | 1 | R | galvanizedSteel | 15.083140340892896 | 10.392304845413264 | 15.083140340893351
C01:base_artesa_2920_placa_1 | C01 |  | 1 | P | paintedSteel | 63.398326699481004 | 52 | 27.100515345878875
C01:base_artesa_2920_ménsula_1 | C01 |  | 1 | P | paintedSteel | 58.47189995078679 | 28 | 102.68930247356207
C01:base_artesa_2920_perno_1 | C01 |  | 1 | R | galvanizedSteel | 15.083140340892896 | 10.392304845413264 | 15.083140340893351
C01:eje_polin_carga_central_2920 | C01 |  | 1 | R | machinedSteel | 17.979710814050122 | 296 | 17.979710814049895
C01:polin_carga_central_2920 | C01 |  | 1 | O | machinedSteel | 50.74273940853982 | 260 | 50.7427394085405
C01:polin_carga_central_2920_horquilla_-1_ménsula | C01 |  | 1 | R | paintedSteel | 33.53934957631736 | 18 | 51.42896120924274
C01:polin_carga_central_2920_horquilla_-1_pie_horquilla | C01 |  | 1 | R | paintedSteel | 48.766251342606665 | 14 | 24.135593638377486
C01:polin_carga_central_2920_horquilla_-1_oreja_-1 | C01 |  | 1 | R | paintedSteel | 24.13559363837703 | 14 | 48.76625134260735
C01:polin_carga_central_2920_horquilla_-1_oreja_1 | C01 |  | 1 | R | paintedSteel | 24.13559363837794 | 14 | 48.766251342607575
C01:polin_carga_central_2920_horquilla_-1_alojamiento | C01 |  | 1 | R | machinedSteel | 37.957167274105814 | 12 | 37.95716727410513
C01:polin_carga_central_2920_horquilla_1_ménsula | C01 |  | 1 | R | paintedSteel | 33.53934957631736 | 18 | 51.42896120924274
C01:polin_carga_central_2920_horquilla_1_pie_horquilla | C01 |  | 1 | R | paintedSteel | 48.766251342606665 | 14 | 24.135593638377486
C01:polin_carga_central_2920_horquilla_1_oreja_-1 | C01 |  | 1 | R | paintedSteel | 24.13559363837703 | 14 | 48.76625134260735
C01:polin_carga_central_2920_horquilla_1_oreja_1 | C01 |  | 1 | R | paintedSteel | 24.13559363837794 | 14 | 48.766251342607575
C01:polin_carga_central_2920_horquilla_1_alojamiento | C01 |  | 1 | R | machinedSteel | 37.957167274105814 | 12 | 37.95716727410513
C01:eje_polin_carga_lateral_-1_2920 | C01 |  | 1 | R | machinedSteel | 63.049154688136696 | 224.12303701907325 | 157.6587676031495
C01:polin_carga_lateral_-1_2920 | C01 |  | 1 | O | machinedSteel | 89.09897651606298 | 213.4468297289141 | 165.27767654529498
C01:polin_carga_lateral_-1_2920_horquilla_-1_ménsula | C01 |  | 1 | R | paintedSteel | 80.8029518575122 | 20.86607312800828 | 199.33059775600668
C01:polin_carga_lateral_-1_2920_horquilla_-1_pie_horquilla | C01 |  | 1 | R | paintedSteel | 50.65340004547852 | 17.261224511862338 | 30.064049272231387
C01:polin_carga_lateral_-1_2920_horquilla_-1_oreja_-1 | C01 |  | 1 | R | paintedSteel | 23.955834705597226 | 39.01168450614273 | 48.14066317599941
C01:polin_carga_lateral_-1_2920_horquilla_-1_oreja_1 | C01 |  | 1 | R | paintedSteel | 23.955834705597226 | 39.01168450614273 | 48.14066317599918
C01:polin_carga_lateral_-1_2920_horquilla_-1_alojamiento | C01 |  | 1 | R | machinedSteel | 39.50599016952856 | 31.625681835165892 | 38.186336934932115
C01:polin_carga_lateral_-1_2920_horquilla_1_ménsula | C01 |  | 1 | R | paintedSteel | 38.205182435039205 | 20.848705071716495 | 66.02146176237147
C01:polin_carga_lateral_-1_2920_horquilla_1_pie_horquilla | C01 |  | 1 | R | paintedSteel | 50.65340004547852 | 17.261224511862338 | 30.06404927223116
C01:polin_carga_lateral_-1_2920_horquilla_1_oreja_-1 | C01 |  | 1 | R | paintedSteel | 23.955834705597226 | 39.01168450614273 | 48.140663175999634
C01:polin_carga_lateral_-1_2920_horquilla_1_oreja_1 | C01 |  | 1 | R | paintedSteel | 23.955834705597226 | 39.01168450614273 | 48.140663175999634
C01:polin_carga_lateral_-1_2920_horquilla_1_alojamiento | C01 |  | 1 | R | machinedSteel | 39.50599016952856 | 31.625681835165892 | 38.18633693493234
C01:eje_polin_carga_lateral_1_2920 | C01 |  | 1 | R | machinedSteel | 63.049154688136696 | 224.12303701907325 | 157.6587676031495
C01:polin_carga_lateral_1_2920 | C01 |  | 1 | O | machinedSteel | 89.09897651606298 | 213.4468297289141 | 165.27767654529498
C01:polin_carga_lateral_1_2920_horquilla_-1_ménsula | C01 |  | 1 | R | paintedSteel | 38.205182435039205 | 20.848705071716495 | 66.02146176237147
C01:polin_carga_lateral_1_2920_horquilla_-1_pie_horquilla | C01 |  | 1 | R | paintedSteel | 50.65340004547852 | 17.261224511862338 | 30.06404927223116
C01:polin_carga_lateral_1_2920_horquilla_-1_oreja_-1 | C01 |  | 1 | R | paintedSteel | 23.955834705597226 | 39.01168450614273 | 48.140663175999634
C01:polin_carga_lateral_1_2920_horquilla_-1_oreja_1 | C01 |  | 1 | R | paintedSteel | 23.955834705597226 | 39.01168450614273 | 48.140663175999634
C01:polin_carga_lateral_1_2920_horquilla_-1_alojamiento | C01 |  | 1 | R | machinedSteel | 39.50599016952856 | 31.625681835165892 | 38.18633693493234
C01:polin_carga_lateral_1_2920_horquilla_1_ménsula | C01 |  | 1 | R | paintedSteel | 80.8029518575122 | 20.86607312800828 | 199.33059775600668
C01:polin_carga_lateral_1_2920_horquilla_1_pie_horquilla | C01 |  | 1 | R | paintedSteel | 50.65340004547852 | 17.261224511862338 | 30.064049272231387
C01:polin_carga_lateral_1_2920_horquilla_1_oreja_-1 | C01 |  | 1 | R | paintedSteel | 23.955834705597226 | 39.01168450614273 | 48.14066317599941
C01:polin_carga_lateral_1_2920_horquilla_1_oreja_1 | C01 |  | 1 | R | paintedSteel | 23.955834705597226 | 39.01168450614273 | 48.14066317599918
C01:polin_carga_lateral_1_2920_horquilla_1_alojamiento | C01 |  | 1 | R | machinedSteel | 39.50599016952856 | 31.625681835165892 | 38.186336934932115
C01:base_artesa_3900 | C01 |  | 1 | O | paintedSteel | 52.04214949188463 | 850 | 26.89295162545909
C01:base_artesa_3900_placa_-1 | C01 |  | 1 | P | paintedSteel | 63.398326699481004 | 52 | 27.100515345878875
C01:base_artesa_3900_ménsula_-1 | C01 |  | 1 | P | paintedSteel | 57.96297002877509 | 28 | 101.09659745977342
C01:base_artesa_3900_perno_-1 | C01 |  | 1 | R | galvanizedSteel | 15.083140340892896 | 10.392304845413264 | 15.083140340893351
C01:base_artesa_3900_placa_1 | C01 |  | 1 | P | paintedSteel | 63.398326699481004 | 52 | 27.100515345878875
C01:base_artesa_3900_ménsula_1 | C01 |  | 1 | P | paintedSteel | 57.96297002877509 | 28 | 101.09659745977342
C01:base_artesa_3900_perno_1 | C01 |  | 1 | R | galvanizedSteel | 15.083140340892896 | 10.392304845413264 | 15.083140340893351
C01:eje_polin_carga_central_3900 | C01 |  | 1 | R | machinedSteel | 17.979710814048303 | 296 | 17.979710814049895
C01:polin_carga_central_3900 | C01 |  | 1 | O | machinedSteel | 50.74273940854073 | 260 | 50.7427394085405
C01:polin_carga_central_3900_horquilla_-1_ménsula | C01 |  | 1 | R | paintedSteel | 33.539349576316454 | 18 | 51.42896120924274
C01:polin_carga_central_3900_horquilla_-1_pie_horquilla | C01 |  | 1 | R | paintedSteel | 48.766251342607575 | 14 | 24.13559363837726
C01:polin_carga_central_3900_horquilla_-1_oreja_-1 | C01 |  | 1 | R | paintedSteel | 24.13559363837794 | 14 | 48.76625134260712
C01:polin_carga_central_3900_horquilla_-1_oreja_1 | C01 |  | 1 | R | paintedSteel | 24.13559363837794 | 14 | 48.76625134260735
C01:polin_carga_central_3900_horquilla_-1_alojamiento | C01 |  | 1 | R | machinedSteel | 37.957167274104904 | 12 | 37.957167274104904
C01:polin_carga_central_3900_horquilla_1_ménsula | C01 |  | 1 | R | paintedSteel | 33.539349576316454 | 18 | 51.42896120924274
C01:polin_carga_central_3900_horquilla_1_pie_horquilla | C01 |  | 1 | R | paintedSteel | 48.766251342607575 | 14 | 24.13559363837726
C01:polin_carga_central_3900_horquilla_1_oreja_-1 | C01 |  | 1 | R | paintedSteel | 24.13559363837794 | 14 | 48.76625134260712
C01:polin_carga_central_3900_horquilla_1_oreja_1 | C01 |  | 1 | R | paintedSteel | 24.13559363837794 | 14 | 48.76625134260735
C01:polin_carga_central_3900_horquilla_1_alojamiento | C01 |  | 1 | R | machinedSteel | 37.957167274104904 | 12 | 37.957167274104904
C01:eje_polin_carga_lateral_-1_3900 | C01 |  | 1 | R | machinedSteel | 63.049154688135786 | 224.12303701907325 | 157.6587676031495
C01:polin_carga_lateral_-1_3900 | C01 |  | 1 | O | machinedSteel | 89.09897651606207 | 213.4468297289141 | 165.27767654529475
C01:polin_carga_lateral_-1_3900_horquilla_-1_ménsula | C01 |  | 1 | R | paintedSteel | 80.8029518575122 | 20.86607312800828 | 199.33059775600668
C01:polin_carga_lateral_-1_3900_horquilla_-1_pie_horquilla | C01 |  | 1 | R | paintedSteel | 50.65340004547852 | 17.261224511862338 | 30.064049272230932
C01:polin_carga_lateral_-1_3900_horquilla_-1_oreja_-1 | C01 |  | 1 | R | paintedSteel | 23.955834705597226 | 39.01168450614273 | 48.140663175999634
C01:polin_carga_lateral_-1_3900_horquilla_-1_oreja_1 | C01 |  | 1 | R | paintedSteel | 23.955834705597226 | 39.01168450614273 | 48.140663175999634
C01:polin_carga_lateral_-1_3900_horquilla_-1_alojamiento | C01 |  | 1 | R | machinedSteel | 39.50599016952856 | 31.625681835165892 | 38.186336934932115
C01:polin_carga_lateral_-1_3900_horquilla_1_ménsula | C01 |  | 1 | R | paintedSteel | 38.205182435038296 | 20.848705071716495 | 66.02146176237125
C01:polin_carga_lateral_-1_3900_horquilla_1_pie_horquilla | C01 |  | 1 | R | paintedSteel | 50.65340004547761 | 17.261224511862338 | 30.064049272230932
C01:polin_carga_lateral_-1_3900_horquilla_1_oreja_-1 | C01 |  | 1 | R | paintedSteel | 23.955834705598136 | 39.01168450614273 | 48.140663175999634
C01:polin_carga_lateral_-1_3900_horquilla_1_oreja_1 | C01 |  | 1 | R | paintedSteel | 23.955834705597226 | 39.01168450614273 | 48.140663175999634
C01:polin_carga_lateral_-1_3900_horquilla_1_alojamiento | C01 |  | 1 | R | machinedSteel | 39.50599016952856 | 31.625681835165892 | 38.18633693493234
C01:eje_polin_carga_lateral_1_3900 | C01 |  | 1 | R | machinedSteel | 63.049154688135786 | 224.12303701907325 | 157.6587676031495
C01:polin_carga_lateral_1_3900 | C01 |  | 1 | O | machinedSteel | 89.09897651606207 | 213.4468297289141 | 165.27767654529475
C01:polin_carga_lateral_1_3900_horquilla_-1_ménsula | C01 |  | 1 | R | paintedSteel | 38.205182435038296 | 20.848705071716495 | 66.02146176237125
C01:polin_carga_lateral_1_3900_horquilla_-1_pie_horquilla | C01 |  | 1 | R | paintedSteel | 50.65340004547761 | 17.261224511862338 | 30.064049272230932
C01:polin_carga_lateral_1_3900_horquilla_-1_oreja_-1 | C01 |  | 1 | R | paintedSteel | 23.955834705598136 | 39.01168450614273 | 48.140663175999634
C01:polin_carga_lateral_1_3900_horquilla_-1_oreja_1 | C01 |  | 1 | R | paintedSteel | 23.955834705597226 | 39.01168450614273 | 48.140663175999634
C01:polin_carga_lateral_1_3900_horquilla_-1_alojamiento | C01 |  | 1 | R | machinedSteel | 39.50599016952856 | 31.625681835165892 | 38.18633693493234
C01:polin_carga_lateral_1_3900_horquilla_1_ménsula | C01 |  | 1 | R | paintedSteel | 80.8029518575122 | 20.86607312800828 | 199.33059775600668
C01:polin_carga_lateral_1_3900_horquilla_1_pie_horquilla | C01 |  | 1 | R | paintedSteel | 50.65340004547852 | 17.261224511862338 | 30.064049272230932
C01:polin_carga_lateral_1_3900_horquilla_1_oreja_-1 | C01 |  | 1 | R | paintedSteel | 23.955834705597226 | 39.01168450614273 | 48.140663175999634
C01:polin_carga_lateral_1_3900_horquilla_1_oreja_1 | C01 |  | 1 | R | paintedSteel | 23.955834705597226 | 39.01168450614273 | 48.140663175999634
C01:polin_carga_lateral_1_3900_horquilla_1_alojamiento | C01 |  | 1 | R | machinedSteel | 39.50599016952856 | 31.625681835165892 | 38.186336934932115
C01:base_artesa_4880 | C01 |  | 1 | O | paintedSteel | 52.04214949188281 | 850 | 26.892951625458863
C01:base_artesa_4880_placa_-1 | C01 |  | 1 | P | paintedSteel | 63.398326699481004 | 52 | 27.100515345879103
C01:base_artesa_4880_ménsula_-1 | C01 |  | 1 | P | paintedSteel | 57.454040106764296 | 28 | 99.50389244598455
C01:base_artesa_4880_perno_-1 | C01 |  | 1 | R | galvanizedSteel | 15.083140340892896 | 10.392304845413264 | 15.083140340893351
C01:base_artesa_4880_placa_1 | C01 |  | 1 | P | paintedSteel | 63.398326699481004 | 52 | 27.100515345879103
C01:base_artesa_4880_ménsula_1 | C01 |  | 1 | P | paintedSteel | 57.454040106764296 | 28 | 99.50389244598455
C01:base_artesa_4880_perno_1 | C01 |  | 1 | R | galvanizedSteel | 15.083140340892896 | 10.392304845413264 | 15.083140340893351
C01:eje_polin_carga_central_4880 | C01 |  | 1 | R | machinedSteel | 17.97971081405103 | 296 | 17.979710814049668
C01:polin_carga_central_4880 | C01 |  | 1 | O | machinedSteel | 50.74273940854073 | 260 | 50.74273940854073
C01:polin_carga_central_4880_horquilla_-1_ménsula | C01 |  | 1 | R | paintedSteel | 33.53934957631736 | 18 | 51.42896120924297
C01:polin_carga_central_4880_horquilla_-1_pie_horquilla | C01 |  | 1 | R | paintedSteel | 48.766251342607575 | 14 | 24.13559363837703
C01:polin_carga_central_4880_horquilla_-1_oreja_-1 | C01 |  | 1 | R | paintedSteel | 24.13559363837794 | 14 | 48.76625134260712
C01:polin_carga_central_4880_horquilla_-1_oreja_1 | C01 |  | 1 | R | paintedSteel | 24.13559363837703 | 14 | 48.766251342606665
C01:polin_carga_central_4880_horquilla_-1_alojamiento | C01 |  | 1 | R | machinedSteel | 37.957167274104904 | 12 | 37.957167274104904
C01:polin_carga_central_4880_horquilla_1_ménsula | C01 |  | 1 | R | paintedSteel | 33.53934957631736 | 18 | 51.42896120924297
C01:polin_carga_central_4880_horquilla_1_pie_horquilla | C01 |  | 1 | R | paintedSteel | 48.766251342607575 | 14 | 24.13559363837703
C01:polin_carga_central_4880_horquilla_1_oreja_-1 | C01 |  | 1 | R | paintedSteel | 24.13559363837794 | 14 | 48.76625134260712
C01:polin_carga_central_4880_horquilla_1_oreja_1 | C01 |  | 1 | R | paintedSteel | 24.13559363837703 | 14 | 48.766251342606665
C01:polin_carga_central_4880_horquilla_1_alojamiento | C01 |  | 1 | R | machinedSteel | 37.957167274104904 | 12 | 37.957167274104904
C01:eje_polin_carga_lateral_-1_4880 | C01 |  | 1 | R | machinedSteel | 63.049154688137605 | 224.12303701907325 | 157.65876760314904
C01:polin_carga_lateral_-1_4880 | C01 |  | 1 | O | machinedSteel | 89.09897651606207 | 213.4468297289141 | 165.27767654529498
C01:polin_carga_lateral_-1_4880_horquilla_-1_ménsula | C01 |  | 1 | R | paintedSteel | 80.8029518575122 | 20.86607312800828 | 199.33059775600714
C01:polin_carga_lateral_-1_4880_horquilla_-1_pie_horquilla | C01 |  | 1 | R | paintedSteel | 50.65340004547761 | 17.261224511862338 | 30.06404927223184
C01:polin_carga_lateral_-1_4880_horquilla_-1_oreja_-1 | C01 |  | 1 | R | paintedSteel | 23.955834705598136 | 39.01168450614273 | 48.140663175998725
C01:polin_carga_lateral_-1_4880_horquilla_-1_oreja_1 | C01 |  | 1 | R | paintedSteel | 23.955834705599045 | 39.01168450614273 | 48.140663175998725
C01:polin_carga_lateral_-1_4880_horquilla_-1_alojamiento | C01 |  | 1 | R | machinedSteel | 39.50599016952856 | 31.625681835165892 | 38.186336934932115
C01:polin_carga_lateral_-1_4880_horquilla_1_ménsula | C01 |  | 1 | R | paintedSteel | 38.205182435039205 | 20.848705071716495 | 66.02146176237193
C01:polin_carga_lateral_-1_4880_horquilla_1_pie_horquilla | C01 |  | 1 | R | paintedSteel | 50.65340004547761 | 17.261224511862338 | 30.06404927223184
C01:polin_carga_lateral_-1_4880_horquilla_1_oreja_-1 | C01 |  | 1 | R | paintedSteel | 23.955834705598136 | 39.01168450614273 | 48.14066317599918
C01:polin_carga_lateral_-1_4880_horquilla_1_oreja_1 | C01 |  | 1 | R | paintedSteel | 23.955834705598136 | 39.01168450614273 | 48.14066317599918
C01:polin_carga_lateral_-1_4880_horquilla_1_alojamiento | C01 |  | 1 | R | machinedSteel | 39.50599016952947 | 31.625681835165892 | 38.18633693493166
C01:eje_polin_carga_lateral_1_4880 | C01 |  | 1 | R | machinedSteel | 63.049154688137605 | 224.12303701907325 | 157.65876760314904
C01:polin_carga_lateral_1_4880 | C01 |  | 1 | O | machinedSteel | 89.09897651606207 | 213.4468297289141 | 165.27767654529498
C01:polin_carga_lateral_1_4880_horquilla_-1_ménsula | C01 |  | 1 | R | paintedSteel | 38.205182435039205 | 20.848705071716495 | 66.02146176237193
C01:polin_carga_lateral_1_4880_horquilla_-1_pie_horquilla | C01 |  | 1 | R | paintedSteel | 50.65340004547761 | 17.261224511862338 | 30.06404927223184
C01:polin_carga_lateral_1_4880_horquilla_-1_oreja_-1 | C01 |  | 1 | R | paintedSteel | 23.955834705598136 | 39.01168450614273 | 48.14066317599918
C01:polin_carga_lateral_1_4880_horquilla_-1_oreja_1 | C01 |  | 1 | R | paintedSteel | 23.955834705598136 | 39.01168450614273 | 48.14066317599918
C01:polin_carga_lateral_1_4880_horquilla_-1_alojamiento | C01 |  | 1 | R | machinedSteel | 39.50599016952947 | 31.625681835165892 | 38.18633693493166
C01:polin_carga_lateral_1_4880_horquilla_1_ménsula | C01 |  | 1 | R | paintedSteel | 80.8029518575122 | 20.86607312800828 | 199.33059775600714
C01:polin_carga_lateral_1_4880_horquilla_1_pie_horquilla | C01 |  | 1 | R | paintedSteel | 50.65340004547761 | 17.261224511862338 | 30.06404927223184
C01:polin_carga_lateral_1_4880_horquilla_1_oreja_-1 | C01 |  | 1 | R | paintedSteel | 23.955834705598136 | 39.01168450614273 | 48.140663175998725
C01:polin_carga_lateral_1_4880_horquilla_1_oreja_1 | C01 |  | 1 | R | paintedSteel | 23.955834705599045 | 39.01168450614273 | 48.140663175998725
C01:polin_carga_lateral_1_4880_horquilla_1_alojamiento | C01 |  | 1 | R | machinedSteel | 39.50599016952856 | 31.625681835165892 | 38.186336934932115
C01:base_artesa_5860 | C01 |  | 1 | O | paintedSteel | 52.04214949188281 | 850 | 26.89295162545841
C01:base_artesa_5860_placa_-1 | C01 |  | 1 | P | paintedSteel | 63.398326699480094 | 52 | 27.100515345878648
C01:base_artesa_5860_ménsula_-1 | C01 |  | 1 | P | paintedSteel | 56.94511018475259 | 28 | 97.91118743219658
C01:base_artesa_5860_perno_-1 | C01 |  | 1 | R | galvanizedSteel | 15.083140340892896 | 10.392304845413264 | 15.083140340892896
C01:base_artesa_5860_placa_1 | C01 |  | 1 | P | paintedSteel | 63.398326699480094 | 52 | 27.100515345878648
C01:base_artesa_5860_ménsula_1 | C01 |  | 1 | P | paintedSteel | 56.94511018475259 | 28 | 97.91118743219658
C01:base_artesa_5860_perno_1 | C01 |  | 1 | R | galvanizedSteel | 15.083140340892896 | 10.392304845413264 | 15.083140340892896
C01:eje_polin_carga_central_5860 | C01 |  | 1 | R | machinedSteel | 17.979710814049213 | 296 | 17.979710814050577
C01:polin_carga_central_5860 | C01 |  | 1 | O | machinedSteel | 50.74273940854164 | 260 | 50.74273940854073
C01:polin_carga_central_5860_horquilla_-1_ménsula | C01 |  | 1 | R | paintedSteel | 33.53934957631736 | 18 | 51.428961209242516
C01:polin_carga_central_5860_horquilla_-1_pie_horquilla | C01 |  | 1 | R | paintedSteel | 48.766251342606665 | 14 | 24.135593638377486
C01:polin_carga_central_5860_horquilla_-1_oreja_-1 | C01 |  | 1 | R | paintedSteel | 24.13559363837703 | 14 | 48.766251342607575
C01:polin_carga_central_5860_horquilla_-1_oreja_1 | C01 |  | 1 | R | paintedSteel | 24.13559363837703 | 14 | 48.76625134260712
C01:polin_carga_central_5860_horquilla_-1_alojamiento | C01 |  | 1 | R | machinedSteel | 37.957167274103995 | 12 | 37.957167274104904
C01:polin_carga_central_5860_horquilla_1_ménsula | C01 |  | 1 | R | paintedSteel | 33.53934957631736 | 18 | 51.428961209242516
C01:polin_carga_central_5860_horquilla_1_pie_horquilla | C01 |  | 1 | R | paintedSteel | 48.766251342606665 | 14 | 24.135593638377486
C01:polin_carga_central_5860_horquilla_1_oreja_-1 | C01 |  | 1 | R | paintedSteel | 24.13559363837703 | 14 | 48.766251342607575
C01:polin_carga_central_5860_horquilla_1_oreja_1 | C01 |  | 1 | R | paintedSteel | 24.13559363837703 | 14 | 48.76625134260712
C01:polin_carga_central_5860_horquilla_1_alojamiento | C01 |  | 1 | R | machinedSteel | 37.957167274103995 | 12 | 37.957167274104904
C01:eje_polin_carga_lateral_-1_5860 | C01 |  | 1 | R | machinedSteel | 63.049154688136696 | 224.12303701907325 | 157.6587676031495
C01:polin_carga_lateral_-1_5860 | C01 |  | 1 | O | machinedSteel | 89.09897651606116 | 213.4468297289141 | 165.27767654529498
C01:polin_carga_lateral_-1_5860_horquilla_-1_ménsula | C01 |  | 1 | R | paintedSteel | 80.80295185751311 | 20.86607312800828 | 199.33059775600668
C01:polin_carga_lateral_-1_5860_horquilla_-1_pie_horquilla | C01 |  | 1 | R | paintedSteel | 50.65340004547761 | 17.261224511862338 | 30.064049272230932
C01:polin_carga_lateral_-1_5860_horquilla_-1_oreja_-1 | C01 |  | 1 | R | paintedSteel | 23.955834705597226 | 39.01168450614273 | 48.14066317599918
C01:polin_carga_lateral_-1_5860_horquilla_-1_oreja_1 | C01 |  | 1 | R | paintedSteel | 23.955834705597226 | 39.01168450614273 | 48.14066317599918
C01:polin_carga_lateral_-1_5860_horquilla_-1_alojamiento | C01 |  | 1 | R | machinedSteel | 39.50599016952947 | 31.625681835165892 | 38.18633693493257
C01:polin_carga_lateral_-1_5860_horquilla_1_ménsula | C01 |  | 1 | R | paintedSteel | 38.205182435037386 | 20.848705071716495 | 66.02146176237102
C01:polin_carga_lateral_-1_5860_horquilla_1_pie_horquilla | C01 |  | 1 | R | paintedSteel | 50.65340004547761 | 17.261224511862338 | 30.064049272230932
C01:polin_carga_lateral_-1_5860_horquilla_1_oreja_-1 | C01 |  | 1 | R | paintedSteel | 23.955834705598136 | 39.01168450614273 | 48.140663175998725
C01:polin_carga_lateral_-1_5860_horquilla_1_oreja_1 | C01 |  | 1 | R | paintedSteel | 23.955834705598136 | 39.01168450614273 | 48.140663175998725
C01:polin_carga_lateral_-1_5860_horquilla_1_alojamiento | C01 |  | 1 | R | machinedSteel | 39.50599016952947 | 31.625681835165892 | 38.186336934932115
C01:eje_polin_carga_lateral_1_5860 | C01 |  | 1 | R | machinedSteel | 63.049154688136696 | 224.12303701907325 | 157.6587676031495
C01:polin_carga_lateral_1_5860 | C01 |  | 1 | O | machinedSteel | 89.09897651606116 | 213.4468297289141 | 165.27767654529498
C01:polin_carga_lateral_1_5860_horquilla_-1_ménsula | C01 |  | 1 | R | paintedSteel | 38.205182435037386 | 20.848705071716495 | 66.02146176237102
C01:polin_carga_lateral_1_5860_horquilla_-1_pie_horquilla | C01 |  | 1 | R | paintedSteel | 50.65340004547761 | 17.261224511862338 | 30.064049272230932
C01:polin_carga_lateral_1_5860_horquilla_-1_oreja_-1 | C01 |  | 1 | R | paintedSteel | 23.955834705598136 | 39.01168450614273 | 48.140663175998725
C01:polin_carga_lateral_1_5860_horquilla_-1_oreja_1 | C01 |  | 1 | R | paintedSteel | 23.955834705598136 | 39.01168450614273 | 48.140663175998725
C01:polin_carga_lateral_1_5860_horquilla_-1_alojamiento | C01 |  | 1 | R | machinedSteel | 39.50599016952947 | 31.625681835165892 | 38.186336934932115
C01:polin_carga_lateral_1_5860_horquilla_1_ménsula | C01 |  | 1 | R | paintedSteel | 80.80295185751311 | 20.86607312800828 | 199.33059775600668
C01:polin_carga_lateral_1_5860_horquilla_1_pie_horquilla | C01 |  | 1 | R | paintedSteel | 50.65340004547761 | 17.261224511862338 | 30.064049272230932
C01:polin_carga_lateral_1_5860_horquilla_1_oreja_-1 | C01 |  | 1 | R | paintedSteel | 23.955834705597226 | 39.01168450614273 | 48.14066317599918
C01:polin_carga_lateral_1_5860_horquilla_1_oreja_1 | C01 |  | 1 | R | paintedSteel | 23.955834705597226 | 39.01168450614273 | 48.14066317599918
C01:polin_carga_lateral_1_5860_horquilla_1_alojamiento | C01 |  | 1 | R | machinedSteel | 39.50599016952947 | 31.625681835165892 | 38.18633693493257
C01:base_artesa_6840 | C01 |  | 1 | O | paintedSteel | 52.04214949188463 | 850 | 26.892951625458863
C01:base_artesa_6840_placa_-1 | C01 |  | 1 | P | paintedSteel | 63.39832669948191 | 52 | 27.100515345879103
C01:base_artesa_6840_ménsula_-1 | C01 |  | 1 | P | paintedSteel | 56.43618026274089 | 28 | 96.31848241840771
C01:base_artesa_6840_perno_-1 | C01 |  | 1 | R | galvanizedSteel | 15.083140340893806 | 10.392304845413264 | 15.083140340893351
C01:base_artesa_6840_placa_1 | C01 |  | 1 | P | paintedSteel | 63.39832669948191 | 52 | 27.100515345879103
C01:base_artesa_6840_ménsula_1 | C01 |  | 1 | P | paintedSteel | 56.43618026274089 | 28 | 96.31848241840771
C01:base_artesa_6840_perno_1 | C01 |  | 1 | R | galvanizedSteel | 15.083140340893806 | 10.392304845413264 | 15.083140340893351
C01:eje_polin_carga_central_6840 | C01 |  | 1 | R | machinedSteel | 17.979710814048303 | 296 | 17.979710814049668
C01:polin_carga_central_6840 | C01 |  | 1 | O | machinedSteel | 50.74273940854073 | 260 | 50.742739408540274
C01:polin_carga_central_6840_horquilla_-1_ménsula | C01 |  | 1 | R | paintedSteel | 33.53934957631827 | 18 | 51.42896120924297
C01:polin_carga_central_6840_horquilla_-1_pie_horquilla | C01 |  | 1 | R | paintedSteel | 48.766251342609394 | 14 | 24.135593638377486
C01:polin_carga_central_6840_horquilla_-1_oreja_-1 | C01 |  | 1 | R | paintedSteel | 24.13559363837703 | 14 | 48.766251342607575
C01:polin_carga_central_6840_horquilla_-1_oreja_1 | C01 |  | 1 | R | paintedSteel | 24.13559363837703 | 14 | 48.76625134260803
C01:polin_carga_central_6840_horquilla_-1_alojamiento | C01 |  | 1 | R | machinedSteel | 37.957167274105814 | 12 | 37.95716727410536
C01:polin_carga_central_6840_horquilla_1_ménsula | C01 |  | 1 | R | paintedSteel | 33.53934957631827 | 18 | 51.42896120924297
C01:polin_carga_central_6840_horquilla_1_pie_horquilla | C01 |  | 1 | R | paintedSteel | 48.766251342609394 | 14 | 24.135593638377486
C01:polin_carga_central_6840_horquilla_1_oreja_-1 | C01 |  | 1 | R | paintedSteel | 24.13559363837703 | 14 | 48.766251342607575
C01:polin_carga_central_6840_horquilla_1_oreja_1 | C01 |  | 1 | R | paintedSteel | 24.13559363837703 | 14 | 48.76625134260803
C01:polin_carga_central_6840_horquilla_1_alojamiento | C01 |  | 1 | R | machinedSteel | 37.957167274105814 | 12 | 37.95716727410536
C01:eje_polin_carga_lateral_-1_6840 | C01 |  | 1 | R | machinedSteel | 63.049154688136696 | 224.12303701907325 | 157.65876760314904
C01:polin_carga_lateral_-1_6840 | C01 |  | 1 | O | machinedSteel | 89.09897651606116 | 213.4468297289141 | 165.27767654529498
C01:polin_carga_lateral_-1_6840_horquilla_-1_ménsula | C01 |  | 1 | R | paintedSteel | 80.80295185751311 | 20.86607312800828 | 199.33059775600623
C01:polin_carga_lateral_-1_6840_horquilla_-1_pie_horquilla | C01 |  | 1 | R | paintedSteel | 50.65340004547761 | 17.261224511862338 | 30.064049272231387
C01:polin_carga_lateral_-1_6840_horquilla_-1_oreja_-1 | C01 |  | 1 | R | paintedSteel | 23.955834705597226 | 39.01168450614273 | 48.140663175999634
C01:polin_carga_lateral_-1_6840_horquilla_-1_oreja_1 | C01 |  | 1 | R | paintedSteel | 23.955834705597226 | 39.01168450614273 | 48.140663175999634
C01:polin_carga_lateral_-1_6840_horquilla_-1_alojamiento | C01 |  | 1 | R | machinedSteel | 39.50599016952765 | 31.625681835165892 | 38.186336934932115
C01:polin_carga_lateral_-1_6840_horquilla_1_ménsula | C01 |  | 1 | R | paintedSteel | 38.205182435038296 | 20.848705071716495 | 66.02146176237056
C01:polin_carga_lateral_-1_6840_horquilla_1_pie_horquilla | C01 |  | 1 | R | paintedSteel | 50.65340004547761 | 17.261224511862338 | 30.064049272231387
C01:polin_carga_lateral_-1_6840_horquilla_1_oreja_-1 | C01 |  | 1 | R | paintedSteel | 23.955834705599045 | 39.01168450614273 | 48.14066317599918
C01:polin_carga_lateral_-1_6840_horquilla_1_oreja_1 | C01 |  | 1 | R | paintedSteel | 23.955834705599045 | 39.01168450614273 | 48.14066317599918
C01:polin_carga_lateral_-1_6840_horquilla_1_alojamiento | C01 |  | 1 | R | machinedSteel | 39.50599016952947 | 31.625681835165892 | 38.18633693493257
C01:eje_polin_carga_lateral_1_6840 | C01 |  | 1 | R | machinedSteel | 63.049154688136696 | 224.12303701907325 | 157.65876760314904
C01:polin_carga_lateral_1_6840 | C01 |  | 1 | O | machinedSteel | 89.09897651606116 | 213.4468297289141 | 165.27767654529498
C01:polin_carga_lateral_1_6840_horquilla_-1_ménsula | C01 |  | 1 | R | paintedSteel | 38.205182435038296 | 20.848705071716495 | 66.02146176237056
C01:polin_carga_lateral_1_6840_horquilla_-1_pie_horquilla | C01 |  | 1 | R | paintedSteel | 50.65340004547761 | 17.261224511862338 | 30.064049272231387
C01:polin_carga_lateral_1_6840_horquilla_-1_oreja_-1 | C01 |  | 1 | R | paintedSteel | 23.955834705599045 | 39.01168450614273 | 48.14066317599918
C01:polin_carga_lateral_1_6840_horquilla_-1_oreja_1 | C01 |  | 1 | R | paintedSteel | 23.955834705599045 | 39.01168450614273 | 48.14066317599918
C01:polin_carga_lateral_1_6840_horquilla_-1_alojamiento | C01 |  | 1 | R | machinedSteel | 39.50599016952947 | 31.625681835165892 | 38.18633693493257
C01:polin_carga_lateral_1_6840_horquilla_1_ménsula | C01 |  | 1 | R | paintedSteel | 80.80295185751311 | 20.86607312800828 | 199.33059775600623
C01:polin_carga_lateral_1_6840_horquilla_1_pie_horquilla | C01 |  | 1 | R | paintedSteel | 50.65340004547761 | 17.261224511862338 | 30.064049272231387
C01:polin_carga_lateral_1_6840_horquilla_1_oreja_-1 | C01 |  | 1 | R | paintedSteel | 23.955834705597226 | 39.01168450614273 | 48.140663175999634
C01:polin_carga_lateral_1_6840_horquilla_1_oreja_1 | C01 |  | 1 | R | paintedSteel | 23.955834705597226 | 39.01168450614273 | 48.140663175999634
C01:polin_carga_lateral_1_6840_horquilla_1_alojamiento | C01 |  | 1 | R | machinedSteel | 39.50599016952765 | 31.625681835165892 | 38.186336934932115
C01:base_artesa_7440 | C01 |  | 1 | O | paintedSteel | 52.04214949188281 | 850 | 26.892951625459318
C01:base_artesa_7440_placa_-1 | C01 |  | 1 | P | paintedSteel | 63.39832669948191 | 52 | 27.100515345879103
C01:base_artesa_7440_ménsula_-1 | C01 |  | 1 | P | paintedSteel | 56.124590514573356 | 28 | 95.3433568997616
C01:base_artesa_7440_perno_-1 | C01 |  | 1 | R | galvanizedSteel | 15.083140340893806 | 10.392304845413264 | 15.083140340893351
C01:base_artesa_7440_placa_1 | C01 |  | 1 | P | paintedSteel | 63.39832669948191 | 52 | 27.100515345879103
C01:base_artesa_7440_ménsula_1 | C01 |  | 1 | P | paintedSteel | 56.124590514573356 | 28 | 95.3433568997616
C01:base_artesa_7440_perno_1 | C01 |  | 1 | R | galvanizedSteel | 15.083140340893806 | 10.392304845413264 | 15.083140340893351
C01:eje_polin_carga_central_7440 | C01 |  | 1 | R | machinedSteel | 17.97971081405194 | 296 | 17.979710814050122
C01:polin_carga_central_7440 | C01 |  | 1 | O | machinedSteel | 50.74273940854073 | 260 | 50.74273940854073
C01:polin_carga_central_7440_horquilla_-1_ménsula | C01 |  | 1 | R | paintedSteel | 33.539349576316454 | 18 | 51.42896120924297
C01:polin_carga_central_7440_horquilla_-1_pie_horquilla | C01 |  | 1 | R | paintedSteel | 48.766251342605756 | 14 | 24.135593638377486
C01:polin_carga_central_7440_horquilla_-1_oreja_-1 | C01 |  | 1 | R | paintedSteel | 24.13559363837885 | 14 | 48.76625134260712
C01:polin_carga_central_7440_horquilla_-1_oreja_1 | C01 |  | 1 | R | paintedSteel | 24.13559363837703 | 14 | 48.76625134260712
C01:polin_carga_central_7440_horquilla_-1_alojamiento | C01 |  | 1 | R | machinedSteel | 37.957167274103995 | 12 | 37.95716727410536
C01:polin_carga_central_7440_horquilla_1_ménsula | C01 |  | 1 | R | paintedSteel | 33.539349576316454 | 18 | 51.42896120924297
C01:polin_carga_central_7440_horquilla_1_pie_horquilla | C01 |  | 1 | R | paintedSteel | 48.766251342605756 | 14 | 24.135593638377486
C01:polin_carga_central_7440_horquilla_1_oreja_-1 | C01 |  | 1 | R | paintedSteel | 24.13559363837885 | 14 | 48.76625134260712
C01:polin_carga_central_7440_horquilla_1_oreja_1 | C01 |  | 1 | R | paintedSteel | 24.13559363837703 | 14 | 48.76625134260712
C01:polin_carga_central_7440_horquilla_1_alojamiento | C01 |  | 1 | R | machinedSteel | 37.957167274103995 | 12 | 37.95716727410536
C01:eje_polin_carga_lateral_-1_7440 | C01 |  | 1 | R | machinedSteel | 63.049154688136696 | 224.12303701907325 | 157.65876760314904
C01:polin_carga_lateral_-1_7440 | C01 |  | 1 | O | machinedSteel | 89.09897651606298 | 213.4468297289141 | 165.27767654529498
C01:polin_carga_lateral_-1_7440_horquilla_-1_ménsula | C01 |  | 1 | R | paintedSteel | 80.80295185751129 | 20.86607312800828 | 199.33059775600623
C01:polin_carga_lateral_-1_7440_horquilla_-1_pie_horquilla | C01 |  | 1 | R | paintedSteel | 50.65340004547761 | 17.261224511862338 | 30.064049272230932
C01:polin_carga_lateral_-1_7440_horquilla_-1_oreja_-1 | C01 |  | 1 | R | paintedSteel | 23.955834705599045 | 39.01168450614273 | 48.140663175999634
C01:polin_carga_lateral_-1_7440_horquilla_-1_oreja_1 | C01 |  | 1 | R | paintedSteel | 23.955834705599045 | 39.01168450614273 | 48.140663175999634
C01:polin_carga_lateral_-1_7440_horquilla_-1_alojamiento | C01 |  | 1 | R | machinedSteel | 39.50599016952947 | 31.625681835165892 | 38.186336934932115
C01:polin_carga_lateral_-1_7440_horquilla_1_ménsula | C01 |  | 1 | R | paintedSteel | 38.205182435040115 | 20.848705071716495 | 66.02146176237102
C01:polin_carga_lateral_-1_7440_horquilla_1_pie_horquilla | C01 |  | 1 | R | paintedSteel | 50.65340004547761 | 17.261224511862338 | 30.064049272230932
C01:polin_carga_lateral_-1_7440_horquilla_1_oreja_-1 | C01 |  | 1 | R | paintedSteel | 23.955834705599045 | 39.01168450614273 | 48.14066317599918
C01:polin_carga_lateral_-1_7440_horquilla_1_oreja_1 | C01 |  | 1 | R | paintedSteel | 23.955834705597226 | 39.01168450614273 | 48.14066317599918
C01:polin_carga_lateral_-1_7440_horquilla_1_alojamiento | C01 |  | 1 | R | machinedSteel | 39.50599016952765 | 31.625681835165892 | 38.18633693493257
C01:eje_polin_carga_lateral_1_7440 | C01 |  | 1 | R | machinedSteel | 63.049154688136696 | 224.12303701907325 | 157.65876760314904
C01:polin_carga_lateral_1_7440 | C01 |  | 1 | O | machinedSteel | 89.09897651606298 | 213.4468297289141 | 165.27767654529498
C01:polin_carga_lateral_1_7440_horquilla_-1_ménsula | C01 |  | 1 | R | paintedSteel | 38.205182435040115 | 20.848705071716495 | 66.02146176237102
C01:polin_carga_lateral_1_7440_horquilla_-1_pie_horquilla | C01 |  | 1 | R | paintedSteel | 50.65340004547761 | 17.261224511862338 | 30.064049272230932
C01:polin_carga_lateral_1_7440_horquilla_-1_oreja_-1 | C01 |  | 1 | R | paintedSteel | 23.955834705599045 | 39.01168450614273 | 48.14066317599918
C01:polin_carga_lateral_1_7440_horquilla_-1_oreja_1 | C01 |  | 1 | R | paintedSteel | 23.955834705597226 | 39.01168450614273 | 48.14066317599918
C01:polin_carga_lateral_1_7440_horquilla_-1_alojamiento | C01 |  | 1 | R | machinedSteel | 39.50599016952765 | 31.625681835165892 | 38.18633693493257
C01:polin_carga_lateral_1_7440_horquilla_1_ménsula | C01 |  | 1 | R | paintedSteel | 80.80295185751129 | 20.86607312800828 | 199.33059775600623
C01:polin_carga_lateral_1_7440_horquilla_1_pie_horquilla | C01 |  | 1 | R | paintedSteel | 50.65340004547761 | 17.261224511862338 | 30.064049272230932
C01:polin_carga_lateral_1_7440_horquilla_1_oreja_-1 | C01 |  | 1 | R | paintedSteel | 23.955834705599045 | 39.01168450614273 | 48.140663175999634
C01:polin_carga_lateral_1_7440_horquilla_1_oreja_1 | C01 |  | 1 | R | paintedSteel | 23.955834705599045 | 39.01168450614273 | 48.140663175999634
C01:polin_carga_lateral_1_7440_horquilla_1_alojamiento | C01 |  | 1 | R | machinedSteel | 39.50599016952947 | 31.625681835165892 | 38.186336934932115
C01:base_artesa_7890 | C01 |  | 1 | O | paintedSteel | 52.04214949188281 | 850 | 26.892951625458863
C01:base_artesa_7890_placa_-1 | C01 |  | 1 | P | paintedSteel | 63.39832669948191 | 52 | 27.100515345878648
C01:base_artesa_7890_ménsula_-1 | C01 |  | 1 | P | paintedSteel | 55.89089820344452 | 28 | 94.61201276077736
C01:base_artesa_7890_perno_-1 | C01 |  | 1 | R | galvanizedSteel | 15.083140340893806 | 10.392304845413264 | 15.083140340893351
C01:base_artesa_7890_placa_1 | C01 |  | 1 | P | paintedSteel | 63.39832669948191 | 52 | 27.100515345878648
C01:base_artesa_7890_ménsula_1 | C01 |  | 1 | P | paintedSteel | 55.89089820344452 | 28 | 94.61201276077736
C01:base_artesa_7890_perno_1 | C01 |  | 1 | R | galvanizedSteel | 15.083140340893806 | 10.392304845413264 | 15.083140340893351
C01:eje_polin_carga_central_7890 | C01 |  | 1 | R | machinedSteel | 17.979710814050122 | 296 | 17.979710814050122
C01:polin_carga_central_7890 | C01 |  | 1 | O | machinedSteel | 50.74273940854073 | 260 | 50.74273940854073
C01:polin_carga_central_7890_horquilla_-1_ménsula | C01 |  | 1 | R | paintedSteel | 33.539349576316454 | 18 | 51.428961209242516
C01:polin_carga_central_7890_horquilla_-1_pie_horquilla | C01 |  | 1 | R | paintedSteel | 48.766251342607575 | 14 | 24.135593638377486
C01:polin_carga_central_7890_horquilla_-1_oreja_-1 | C01 |  | 1 | R | paintedSteel | 24.13559363837703 | 14 | 48.76625134260712
C01:polin_carga_central_7890_horquilla_-1_oreja_1 | C01 |  | 1 | R | paintedSteel | 24.13559363837885 | 14 | 48.76625134260712
C01:polin_carga_central_7890_horquilla_-1_alojamiento | C01 |  | 1 | R | machinedSteel | 37.957167274103995 | 12 | 37.957167274104904
C01:polin_carga_central_7890_horquilla_1_ménsula | C01 |  | 1 | R | paintedSteel | 33.539349576316454 | 18 | 51.428961209242516
C01:polin_carga_central_7890_horquilla_1_pie_horquilla | C01 |  | 1 | R | paintedSteel | 48.766251342607575 | 14 | 24.135593638377486
C01:polin_carga_central_7890_horquilla_1_oreja_-1 | C01 |  | 1 | R | paintedSteel | 24.13559363837703 | 14 | 48.76625134260712
C01:polin_carga_central_7890_horquilla_1_oreja_1 | C01 |  | 1 | R | paintedSteel | 24.13559363837885 | 14 | 48.76625134260712
C01:polin_carga_central_7890_horquilla_1_alojamiento | C01 |  | 1 | R | machinedSteel | 37.957167274103995 | 12 | 37.957167274104904
C01:eje_polin_carga_lateral_-1_7890 | C01 |  | 1 | R | machinedSteel | 63.049154688138515 | 224.12303701907325 | 157.6587676031495
C01:polin_carga_lateral_-1_7890 | C01 |  | 1 | O | machinedSteel | 89.09897651606116 | 213.4468297289141 | 165.27767654529544
C01:polin_carga_lateral_-1_7890_horquilla_-1_ménsula | C01 |  | 1 | R | paintedSteel | 80.80295185751311 | 20.86607312800828 | 199.33059775600714
C01:polin_carga_lateral_-1_7890_horquilla_-1_pie_horquilla | C01 |  | 1 | R | paintedSteel | 50.65340004547761 | 17.261224511862338 | 30.06404927223184
C01:polin_carga_lateral_-1_7890_horquilla_-1_oreja_-1 | C01 |  | 1 | R | paintedSteel | 23.955834705599045 | 39.01168450614273 | 48.14066317599918
C01:polin_carga_lateral_-1_7890_horquilla_-1_oreja_1 | C01 |  | 1 | R | paintedSteel | 23.955834705597226 | 39.01168450614273 | 48.14066317599918
C01:polin_carga_lateral_-1_7890_horquilla_-1_alojamiento | C01 |  | 1 | R | machinedSteel | 39.50599016952765 | 31.625681835165892 | 38.18633693493257
C01:polin_carga_lateral_-1_7890_horquilla_1_ménsula | C01 |  | 1 | R | paintedSteel | 38.205182435038296 | 20.848705071716495 | 66.02146176237147
C01:polin_carga_lateral_-1_7890_horquilla_1_pie_horquilla | C01 |  | 1 | R | paintedSteel | 50.65340004547579 | 17.261224511862338 | 30.064049272231387
C01:polin_carga_lateral_-1_7890_horquilla_1_oreja_-1 | C01 |  | 1 | R | paintedSteel | 23.955834705599045 | 39.01168450614273 | 48.140663175998725
C01:polin_carga_lateral_-1_7890_horquilla_1_oreja_1 | C01 |  | 1 | R | paintedSteel | 23.955834705599045 | 39.01168450614273 | 48.140663175998725
C01:polin_carga_lateral_-1_7890_horquilla_1_alojamiento | C01 |  | 1 | R | machinedSteel | 39.50599016952947 | 31.625681835165892 | 38.18633693493257
C01:eje_polin_carga_lateral_1_7890 | C01 |  | 1 | R | machinedSteel | 63.049154688138515 | 224.12303701907325 | 157.6587676031495
C01:polin_carga_lateral_1_7890 | C01 |  | 1 | O | machinedSteel | 89.09897651606116 | 213.4468297289141 | 165.27767654529544
C01:polin_carga_lateral_1_7890_horquilla_-1_ménsula | C01 |  | 1 | R | paintedSteel | 38.205182435038296 | 20.848705071716495 | 66.02146176237147
C01:polin_carga_lateral_1_7890_horquilla_-1_pie_horquilla | C01 |  | 1 | R | paintedSteel | 50.65340004547579 | 17.261224511862338 | 30.064049272231387
C01:polin_carga_lateral_1_7890_horquilla_-1_oreja_-1 | C01 |  | 1 | R | paintedSteel | 23.955834705599045 | 39.01168450614273 | 48.140663175998725
C01:polin_carga_lateral_1_7890_horquilla_-1_oreja_1 | C01 |  | 1 | R | paintedSteel | 23.955834705599045 | 39.01168450614273 | 48.140663175998725
C01:polin_carga_lateral_1_7890_horquilla_-1_alojamiento | C01 |  | 1 | R | machinedSteel | 39.50599016952947 | 31.625681835165892 | 38.18633693493257
C01:polin_carga_lateral_1_7890_horquilla_1_ménsula | C01 |  | 1 | R | paintedSteel | 80.80295185751311 | 20.86607312800828 | 199.33059775600714
C01:polin_carga_lateral_1_7890_horquilla_1_pie_horquilla | C01 |  | 1 | R | paintedSteel | 50.65340004547761 | 17.261224511862338 | 30.06404927223184
C01:polin_carga_lateral_1_7890_horquilla_1_oreja_-1 | C01 |  | 1 | R | paintedSteel | 23.955834705599045 | 39.01168450614273 | 48.14066317599918
C01:polin_carga_lateral_1_7890_horquilla_1_oreja_1 | C01 |  | 1 | R | paintedSteel | 23.955834705597226 | 39.01168450614273 | 48.14066317599918
C01:polin_carga_lateral_1_7890_horquilla_1_alojamiento | C01 |  | 1 | R | machinedSteel | 39.50599016952765 | 31.625681835165892 | 38.18633693493257
C01:base_artesa_8340 | C01 |  | 1 | O | paintedSteel | 52.04214949188281 | 850 | 26.892951625458863
C01:base_artesa_8340_placa_-1 | C01 |  | 1 | P | paintedSteel | 63.39832669948191 | 52 | 27.100515345879103
C01:base_artesa_8340_ménsula_-1 | C01 |  | 1 | P | paintedSteel | 55.657205892317506 | 28 | 93.88066862179221
C01:base_artesa_8340_perno_-1 | C01 |  | 1 | R | galvanizedSteel | 15.083140340893806 | 10.392304845413264 | 15.083140340893351
C01:base_artesa_8340_placa_1 | C01 |  | 1 | P | paintedSteel | 63.39832669948191 | 52 | 27.100515345879103
C01:base_artesa_8340_ménsula_1 | C01 |  | 1 | P | paintedSteel | 55.657205892317506 | 28 | 93.88066862179221
C01:base_artesa_8340_perno_1 | C01 |  | 1 | R | galvanizedSteel | 15.083140340893806 | 10.392304845413264 | 15.083140340893351
C01:eje_polin_carga_central_8340 | C01 |  | 1 | R | machinedSteel | 17.979710814050122 | 296 | 17.979710814049213
C01:polin_carga_central_8340 | C01 |  | 1 | O | machinedSteel | 50.74273940853891 | 260 | 50.74273940853982
C01:polin_carga_central_8340_horquilla_-1_ménsula | C01 |  | 1 | R | paintedSteel | 33.539349576316454 | 18 | 51.428961209242516
C01:polin_carga_central_8340_horquilla_-1_pie_horquilla | C01 |  | 1 | R | paintedSteel | 48.766251342607575 | 14 | 24.135593638377486
C01:polin_carga_central_8340_horquilla_-1_oreja_-1 | C01 |  | 1 | R | paintedSteel | 24.13559363837885 | 14 | 48.76625134260803
C01:polin_carga_central_8340_horquilla_-1_oreja_1 | C01 |  | 1 | R | paintedSteel | 24.13559363837703 | 14 | 48.766251342607575
C01:polin_carga_central_8340_horquilla_-1_alojamiento | C01 |  | 1 | R | machinedSteel | 37.957167274105814 | 12 | 37.95716727410536
C01:polin_carga_central_8340_horquilla_1_ménsula | C01 |  | 1 | R | paintedSteel | 33.539349576316454 | 18 | 51.428961209242516
C01:polin_carga_central_8340_horquilla_1_pie_horquilla | C01 |  | 1 | R | paintedSteel | 48.766251342607575 | 14 | 24.135593638377486
C01:polin_carga_central_8340_horquilla_1_oreja_-1 | C01 |  | 1 | R | paintedSteel | 24.13559363837885 | 14 | 48.76625134260803
C01:polin_carga_central_8340_horquilla_1_oreja_1 | C01 |  | 1 | R | paintedSteel | 24.13559363837703 | 14 | 48.766251342607575
C01:polin_carga_central_8340_horquilla_1_alojamiento | C01 |  | 1 | R | machinedSteel | 37.957167274105814 | 12 | 37.95716727410536
C01:eje_polin_carga_lateral_-1_8340 | C01 |  | 1 | R | machinedSteel | 63.04915468813488 | 224.12303701907325 | 157.65876760314904
C01:polin_carga_lateral_-1_8340 | C01 |  | 1 | O | machinedSteel | 89.09897651606298 | 213.4468297289141 | 165.27767654529498
C01:polin_carga_lateral_-1_8340_horquilla_-1_ménsula | C01 |  | 1 | R | paintedSteel | 80.80295185751129 | 20.86607312800828 | 199.3305977560076
C01:polin_carga_lateral_-1_8340_horquilla_-1_pie_horquilla | C01 |  | 1 | R | paintedSteel | 50.65340004547761 | 17.261224511862338 | 30.064049272231387
C01:polin_carga_lateral_-1_8340_horquilla_-1_oreja_-1 | C01 |  | 1 | R | paintedSteel | 23.955834705599045 | 39.01168450614273 | 48.140663175999634
C01:polin_carga_lateral_-1_8340_horquilla_-1_oreja_1 | C01 |  | 1 | R | paintedSteel | 23.955834705595407 | 39.01168450614273 | 48.14066317599918
C01:polin_carga_lateral_-1_8340_horquilla_-1_alojamiento | C01 |  | 1 | R | machinedSteel | 39.50599016952765 | 31.625681835165892 | 38.186336934932115
C01:polin_carga_lateral_-1_8340_horquilla_1_ménsula | C01 |  | 1 | R | paintedSteel | 38.20518243503648 | 20.848705071716495 | 66.02146176237147
C01:polin_carga_lateral_-1_8340_horquilla_1_pie_horquilla | C01 |  | 1 | R | paintedSteel | 50.65340004547579 | 17.261224511862338 | 30.064049272231387
C01:polin_carga_lateral_-1_8340_horquilla_1_oreja_-1 | C01 |  | 1 | R | paintedSteel | 23.955834705599045 | 39.01168450614273 | 48.14066317599918
C01:polin_carga_lateral_-1_8340_horquilla_1_oreja_1 | C01 |  | 1 | R | paintedSteel | 23.955834705599045 | 39.01168450614273 | 48.140663175999634
C01:polin_carga_lateral_-1_8340_horquilla_1_alojamiento | C01 |  | 1 | R | machinedSteel | 39.50599016952765 | 31.625681835165892 | 38.18633693493257
C01:eje_polin_carga_lateral_1_8340 | C01 |  | 1 | R | machinedSteel | 63.04915468813488 | 224.12303701907325 | 157.65876760314904
C01:polin_carga_lateral_1_8340 | C01 |  | 1 | O | machinedSteel | 89.09897651606298 | 213.4468297289141 | 165.27767654529498
C01:polin_carga_lateral_1_8340_horquilla_-1_ménsula | C01 |  | 1 | R | paintedSteel | 38.20518243503648 | 20.848705071716495 | 66.02146176237147
C01:polin_carga_lateral_1_8340_horquilla_-1_pie_horquilla | C01 |  | 1 | R | paintedSteel | 50.65340004547579 | 17.261224511862338 | 30.064049272231387
C01:polin_carga_lateral_1_8340_horquilla_-1_oreja_-1 | C01 |  | 1 | R | paintedSteel | 23.955834705599045 | 39.01168450614273 | 48.14066317599918
C01:polin_carga_lateral_1_8340_horquilla_-1_oreja_1 | C01 |  | 1 | R | paintedSteel | 23.955834705599045 | 39.01168450614273 | 48.140663175999634
C01:polin_carga_lateral_1_8340_horquilla_-1_alojamiento | C01 |  | 1 | R | machinedSteel | 39.50599016952765 | 31.625681835165892 | 38.18633693493257
C01:polin_carga_lateral_1_8340_horquilla_1_ménsula | C01 |  | 1 | R | paintedSteel | 80.80295185751129 | 20.86607312800828 | 199.3305977560076
C01:polin_carga_lateral_1_8340_horquilla_1_pie_horquilla | C01 |  | 1 | R | paintedSteel | 50.65340004547761 | 17.261224511862338 | 30.064049272231387
C01:polin_carga_lateral_1_8340_horquilla_1_oreja_-1 | C01 |  | 1 | R | paintedSteel | 23.955834705599045 | 39.01168450614273 | 48.140663175999634
C01:polin_carga_lateral_1_8340_horquilla_1_oreja_1 | C01 |  | 1 | R | paintedSteel | 23.955834705595407 | 39.01168450614273 | 48.14066317599918
C01:polin_carga_lateral_1_8340_horquilla_1_alojamiento | C01 |  | 1 | R | machinedSteel | 39.50599016952765 | 31.625681835165892 | 38.186336934932115
C01:base_artesa_8790 | C01 |  | 1 | O | paintedSteel | 52.04214949188099 | 850 | 26.892951625459318
C01:base_artesa_8790_placa_-1 | C01 |  | 1 | P | paintedSteel | 63.39832669948191 | 52 | 27.100515345879103
C01:base_artesa_8790_ménsula_-1 | C01 |  | 1 | P | paintedSteel | 55.42351358118867 | 28 | 93.14932448280797
C01:base_artesa_8790_perno_-1 | C01 |  | 1 | R | galvanizedSteel | 15.083140340893806 | 10.392304845413264 | 15.083140340893351
C01:base_artesa_8790_placa_1 | C01 |  | 1 | P | paintedSteel | 63.39832669948191 | 52 | 27.100515345879103
C01:base_artesa_8790_ménsula_1 | C01 |  | 1 | P | paintedSteel | 55.42351358118867 | 28 | 93.14932448280797
C01:base_artesa_8790_perno_1 | C01 |  | 1 | R | galvanizedSteel | 15.083140340893806 | 10.392304845413264 | 15.083140340893351
C01:eje_polin_carga_central_8790 | C01 |  | 1 | R | machinedSteel | 17.979710814050122 | 296 | 17.979710814049668
C01:polin_carga_central_8790 | C01 |  | 1 | O | machinedSteel | 50.74273940854073 | 260 | 50.742739408540274
C01:polin_carga_central_8790_horquilla_-1_ménsula | C01 |  | 1 | R | paintedSteel | 33.53934957631827 | 18 | 51.428961209242516
C01:polin_carga_central_8790_horquilla_-1_pie_horquilla | C01 |  | 1 | R | paintedSteel | 48.766251342607575 | 14 | 24.135593638377486
C01:polin_carga_central_8790_horquilla_-1_oreja_-1 | C01 |  | 1 | R | paintedSteel | 24.13559363837703 | 14 | 48.766251342607575
C01:polin_carga_central_8790_horquilla_-1_oreja_1 | C01 |  | 1 | R | paintedSteel | 24.13559363837703 | 14 | 48.76625134260803
C01:polin_carga_central_8790_horquilla_-1_alojamiento | C01 |  | 1 | R | machinedSteel | 37.957167274105814 | 12 | 37.95716727410536
C01:polin_carga_central_8790_horquilla_1_ménsula | C01 |  | 1 | R | paintedSteel | 33.53934957631827 | 18 | 51.428961209242516
C01:polin_carga_central_8790_horquilla_1_pie_horquilla | C01 |  | 1 | R | paintedSteel | 48.766251342607575 | 14 | 24.135593638377486
C01:polin_carga_central_8790_horquilla_1_oreja_-1 | C01 |  | 1 | R | paintedSteel | 24.13559363837703 | 14 | 48.766251342607575
C01:polin_carga_central_8790_horquilla_1_oreja_1 | C01 |  | 1 | R | paintedSteel | 24.13559363837703 | 14 | 48.76625134260803
C01:polin_carga_central_8790_horquilla_1_alojamiento | C01 |  | 1 | R | machinedSteel | 37.957167274105814 | 12 | 37.95716727410536
C01:eje_polin_carga_lateral_-1_8790 | C01 |  | 1 | R | machinedSteel | 63.049154688136696 | 224.12303701907325 | 157.6587676031495
C01:polin_carga_lateral_-1_8790 | C01 |  | 1 | O | machinedSteel | 89.09897651606298 | 213.4468297289141 | 165.27767654529544
C01:polin_carga_lateral_-1_8790_horquilla_-1_ménsula | C01 |  | 1 | R | paintedSteel | 80.80295185751311 | 20.86607312800828 | 199.33059775600668
C01:polin_carga_lateral_-1_8790_horquilla_-1_pie_horquilla | C01 |  | 1 | R | paintedSteel | 50.65340004547761 | 17.261224511862338 | 30.064049272230932
C01:polin_carga_lateral_-1_8790_horquilla_-1_oreja_-1 | C01 |  | 1 | R | paintedSteel | 23.955834705597226 | 39.01168450614273 | 48.14066317599918
C01:polin_carga_lateral_-1_8790_horquilla_-1_oreja_1 | C01 |  | 1 | R | paintedSteel | 23.955834705599045 | 39.01168450614273 | 48.140663175999634
C01:polin_carga_lateral_-1_8790_horquilla_-1_alojamiento | C01 |  | 1 | R | machinedSteel | 39.50599016952947 | 31.625681835165892 | 38.186336934932115
C01:polin_carga_lateral_-1_8790_horquilla_1_ménsula | C01 |  | 1 | R | paintedSteel | 38.205182435038296 | 20.848705071716495 | 66.02146176237193
C01:polin_carga_lateral_-1_8790_horquilla_1_pie_horquilla | C01 |  | 1 | R | paintedSteel | 50.65340004547761 | 17.261224511862338 | 30.064049272230932
C01:polin_carga_lateral_-1_8790_horquilla_1_oreja_-1 | C01 |  | 1 | R | paintedSteel | 23.955834705599045 | 39.01168450614273 | 48.14066317599918
C01:polin_carga_lateral_-1_8790_horquilla_1_oreja_1 | C01 |  | 1 | R | paintedSteel | 23.955834705597226 | 39.01168450614273 | 48.14066317599918
C01:polin_carga_lateral_-1_8790_horquilla_1_alojamiento | C01 |  | 1 | R | machinedSteel | 39.50599016952947 | 31.625681835165892 | 38.186336934932115
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
C01:calce_cojinete_cabeza_1 | C01 |  | 1 | P | paintedSteel | 173.28558028055522 | 50 | 60.503095003291946
C01:capota_soporte_9395_-1 | C01 |  | 1 | P | paintedSteel | 112.10311533538516 | 158.22741199317352 | 308.0022310868976
C01:capota_soporte_9395_1 | C01 |  | 1 | P | paintedSteel | 112.10311533538516 | 158.22741199317352 | 308.0022310868976
C01:capota_soporte_9545_-1 | C01 |  | 1 | P | paintedSteel | 112.10311533538516 | 158.22741199317352 | 308.00223108689806
C01:capota_soporte_9545_1 | C01 |  | 1 | P | paintedSteel | 112.10311533538516 | 158.22741199317352 | 308.00223108689806
mix-C02:R14-panel-1 | mix-C02 | r14-mix-discharge | 1 | P | paintedSteel | 164.66048986730675 | 340 | 337.83583359331055
mix-C02:R14-rubber-1 | mix-C02 | r14-mix-discharge | 1 | P | rubber | 8.185871614026837 | 340 | 46.78542036251838
mix-C02:R14-panel-2 | mix-C02 | r14-mix-discharge | 1 | P | paintedSteel | 600 | 20 | 417.3563109508143
mix-C02:R14-rubber-2 | mix-C02 | r14-mix-discharge | 1 | P | rubber | 281.20881269792517 | 0 | 126.30589772002213
mix-C02:R14-panel-3 | mix-C02 | r14-mix-discharge | 1 | P | paintedSteel | 156.47461825760547 | 340 | 425.0259773585519
mix-C02:R14-rubber-3 | mix-C02 | r14-mix-discharge | 1 | P | rubber | 2.34392082283739 | 340 | 27.669666407737623
mix-C02:R14-inspection-frame-L | mix-C02 | r14-mix-discharge | 1 | P | paintedSteel | 35 | 6 | 180
mix-C02:R14-inspection-frame-R | mix-C02 | r14-mix-discharge | 1 | P | paintedSteel | 35 | 6 | 180
mix-C02:R14-inspection-frame-B | mix-C02 | r14-mix-discharge | 1 | P | paintedSteel | 300 | 6 | 30
mix-C02:R14-inspection-frame-T | mix-C02 | r14-mix-discharge | 1 | P | paintedSteel | 300 | 6 | 30
mix-C02:R14-inspection-cover | mix-C02 | r14-mix-discharge | 1 | P | paintedSteel | 270 | 8 | 150
mix-C02:R14-cover-bolt-16359.52856466806-814.5690945311443 | mix-C02 | r14-mix-discharge | 1 | P | paintedSteel | 10 | 8 | 8.660254037844425
mix-C02:R14-cover-bolt-16359.52856466806-924.5690945311443 | mix-C02 | r14-mix-discharge | 1 | P | paintedSteel | 10 | 8 | 8.660254037844425
mix-C02:R14-cover-bolt-16579.52856466806-814.5690945311443 | mix-C02 | r14-mix-discharge | 1 | P | paintedSteel | 10 | 8 | 8.660254037844425
mix-C02:R14-cover-bolt-16579.52856466806-924.5690945311443 | mix-C02 | r14-mix-discharge | 1 | P | paintedSteel | 10 | 8 | 8.660254037844425
bajante:C01-mix | C01-mix | transferChute | 1 | P | OEM | 309.91857802486084 | 300 | 255.0556223440576
tolva-C01:R18-hood-0 | tolva-C01 | r18-feed-hood | 1 | P | paintedSteel | 800 | 378.5999806342119 | 775.9997803375207
tolva-C01:R18-skirt-0 | tolva-C01 | r18-feed-skirt | 1 | P | rubber | 281.93173412105193 | 3 | 119.31091913891737
tolva-C01:R18-hood-1 | tolva-C01 | r18-feed-hood | 1 | P | paintedSteel | 268.3993820468836 | 1200 | 672.3955571492229
tolva-C01:R18-skirt-1 | tolva-C01 | r18-feed-skirt | 1 | P | rubber | 6.642532991339522 | 450.02428341292165 | 27.399677719836973
tolva-C01:R18-hood-2 | tolva-C01 | r18-feed-hood | 1 | P | paintedSteel | 800 | 378.4772414028283 | 772.8412775736037
tolva-C01:R18-skirt-2 | tolva-C01 | r18-feed-skirt | 1 | P | rubber | 279.37296639840633 | 3 | 127.31862708596236
tolva-C01:R18-hood-3 | tolva-C01 | r18-feed-hood | 1 | P | paintedSteel | 260.83554214200376 | 1200 | 775.5166620835934
tolva-C01:R18-skirt-3 | tolva-C01 | r18-feed-skirt | 1 | P | rubber | 4.083854849104682 | 450.0072257360474 | 19.39196977279198
C01:R18-impact--170-steel | C01 | r18-impact-bed | 1 | P | paintedSteel | 322.12287698883347 | 60 | 136.21307034820552
C01:R18-impact--170-rubber | C01 | r18-impact-bed | 1 | P | rubber | 318.7747346143433 | 60 | 125.73500074354354
C01:R18-impact--170-UHMW | C01 | r18-impact-bed | 1 | P | guard | 316.3397219783501 | 60 | 118.11458648560756
C01:R18-impact--85-steel | C01 | r18-impact-bed | 1 | P | paintedSteel | 322.12287698883347 | 60 | 123.72174675550127
C01:R18-impact--85-rubber | C01 | r18-impact-bed | 1 | P | rubber | 318.7747346143433 | 60 | 113.24367715083929
C01:R18-impact--85-UHMW | C01 | r18-impact-bed | 1 | P | guard | 316.3397219783501 | 60 | 105.62326289290331
C01:R18-impact-0-steel | C01 | r18-impact-bed | 1 | P | paintedSteel | 322.12287698883347 | 60 | 123.72174675550127
C01:R18-impact-0-rubber | C01 | r18-impact-bed | 1 | P | rubber | 318.7747346143433 | 60 | 113.24367715083929
C01:R18-impact-0-UHMW | C01 | r18-impact-bed | 1 | P | guard | 316.3397219783501 | 60 | 105.62326289290331
C01:R18-impact-85-steel | C01 | r18-impact-bed | 1 | P | paintedSteel | 322.12287698883347 | 60 | 123.72174675550127
C01:R18-impact-85-rubber | C01 | r18-impact-bed | 1 | P | rubber | 318.7747346143433 | 60 | 113.24367715083929
C01:R18-impact-85-UHMW | C01 | r18-impact-bed | 1 | P | guard | 316.3397219783501 | 60 | 105.6232628929032
C01:R18-impact-170-steel | C01 | r18-impact-bed | 1 | P | paintedSteel | 324.7862088007182 | 60 | 154.5992274276598
C01:R18-impact-170-rubber | C01 | r18-impact-bed | 1 | P | rubber | 321.43806642622803 | 60 | 144.1211578229977
C01:R18-impact-170-UHMW | C01 | r18-impact-bed | 1 | P | guard | 319.00305379023484 | 60 | 136.50074356506173
C01:R18-impact-cross-235 | C01 | r18-impact-support | 1 | P | OEM | 40.75161664722509 | 900 | 47.23336867465355
C01:R18-impact-post-235--170 | C01 | r18-impact-support | 1 | P | OEM | 145.914994872262 | 30 | 403.1104913171144
C01:R18-impact-post-235--85 | C01 | r18-impact-support | 1 | P | OEM | 145.91499487226156 | 30 | 403.1104913171143
C01:R18-impact-post-235-0 | C01 | r18-impact-support | 1 | P | OEM | 145.91499487226156 | 30 | 403.1104913171143
C01:R18-impact-post-235-85 | C01 | r18-impact-support | 1 | P | OEM | 145.91499487226156 | 30 | 403.1104913171143
C01:R18-impact-post-235-170 | C01 | r18-impact-support | 1 | P | OEM | 151.03701569781015 | 30 | 419.1399442864777
C01:R18-impact-cross-520 | C01 | r18-impact-support | 1 | P | OEM | 40.75161664722464 | 900 | 47.233368674653605
C01:R18-impact-post-520--170 | C01 | r18-impact-support | 1 | P | OEM | 145.7669897418814 | 30 | 402.6473066957574
C01:R18-impact-post-520--85 | C01 | r18-impact-support | 1 | P | OEM | 145.7669897418814 | 30 | 402.6473066957574
C01:R18-impact-post-520-0 | C01 | r18-impact-support | 1 | P | OEM | 145.7669897418814 | 30 | 402.6473066957574
C01:R18-impact-post-520-85 | C01 | r18-impact-support | 1 | P | OEM | 145.7669897418814 | 30 | 402.6473066957574
C01:R18-impact-post-520-170 | C01 | r18-impact-support | 1 | P | OEM | 154.29207316687916 | 30 | 429.3267030658959
