acevedocrisologopablo48-lgtm/planta-briquetadora/r20/BOM_R20.csv

id | owner | component | quantity | sourceClass | material | x | y | z
C03:banda_ida | C03 |  | 1 | P | machinedSteel | 11499.934327325504 | 2500 | 2655.8467390862875
C03:banda_retorno | C03 |  | 1 | P | machinedSteel | 11499.709751054314 | 2500 | 2654.872282571906
C03:tambor_cola | C03 |  | 1 | R | paintedSteel | 199.87546597952314 | 2500 | 199.87546597952064
C03:eje_cola | C03 |  | 1 | R | machinedSteel | 43.39377007875737 | 3140 | 43.39377007875714
C03:cojinete_base_cola_-1 | C03 |  | 1 | R | paintedSteel | 181.01657936827905 | 50 | 64.78514167308992
C03:cojinete_cola_-1 | C03 |  | 1 | R | paintedSteel | 92.70487244097603 | 50 | 92.70487244098103
C03:tensor_cola_-1 | C03 |  | 1 | R | guard | 246.98277266310106 | 50 | 70.76091551232832
C03:tensor_husillo_cola_-1 | C03 |  | 1 | R | machinedSteel | 227.26906610428705 | 14 | 65.29493357421848
C03:cojinete_base_cola_1 | C03 |  | 1 | R | paintedSteel | 181.01657936827905 | 50 | 64.78514167308992
C03:cojinete_cola_1 | C03 |  | 1 | R | paintedSteel | 92.70487244097603 | 50 | 92.70487244098103
C03:tensor_cola_1 | C03 |  | 1 | R | guard | 246.98277266310106 | 50 | 70.76091551232832
C03:tensor_husillo_cola_1 | C03 |  | 1 | R | machinedSteel | 227.26906610428705 | 14 | 65.29493357421848
C03:tambor_cabeza | C03 |  | 1 | R | paintedSteel | 199.87546597953042 | 2500 | 199.8754659795204
C03:eje_cabeza | C03 |  | 1 | R | machinedSteel | 43.39377007875737 | 3140 | 43.39377007875737
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
C03:travesano_bastidor_4800 | C03 |  | 1 | P | paintedSteel | 46.83843006677489 | 3000 | 43.089028850800105
C03:travesano_bastidor_6000 | C03 |  | 1 | P | paintedSteel | 46.83843006677489 | 3000 | 43.089028850800105
C03:travesano_bastidor_7200 | C03 |  | 1 | P | paintedSteel | 46.83843006677489 | 3000 | 43.08902885079988
C03:travesano_bastidor_8400 | C03 |  | 1 | P | paintedSteel | 46.83843006677489 | 3000 | 43.08902885080033
C03:travesano_bastidor_9600 | C03 |  | 1 | P | paintedSteel | 46.83843006677489 | 3000 | 43.08902885080033
C03:travesano_bastidor_10800 | C03 |  | 1 | P | paintedSteel | 46.83843006677489 | 3000 | 43.08902885079988
C03:travesano_bastidor_11800 | C03 |  | 1 | P | paintedSteel | 46.83843006677489 | 3000 | 43.08902885079988
C03:motor | C03 |  | 1 | R | paintedSteel | 707.5069038393194 | 330 | 467.54522601698864
C03:aleta_motor_0 | C03 |  | 1 | R | paintedSteel | 87.83463516589836 | 356.4000000000001 | 349.092911894958
C03:aleta_motor_1 | C03 |  | 1 | R | paintedSteel | 87.83463516589836 | 356.4000000000001 | 349.092911894958
C03:aleta_motor_2 | C03 |  | 1 | R | paintedSteel | 87.83463516589836 | 356.4000000000001 | 349.092911894958
C03:aleta_motor_3 | C03 |  | 1 | R | paintedSteel | 87.83463516589836 | 356.4000000000001 | 349.092911894958
C03:aleta_motor_4 | C03 |  | 1 | R | paintedSteel | 87.83463516590564 | 356.4000000000001 | 349.092911894958
C03:aleta_motor_5 | C03 |  | 1 | R | paintedSteel | 87.83463516589836 | 356.4000000000001 | 349.092911894958
C03:aleta_motor_6 | C03 |  | 1 | R | paintedSteel | 87.83463516590564 | 356.4000000000001 | 349.092911894958
C03:aleta_motor_7 | C03 |  | 1 | R | paintedSteel | 87.83463516589836 | 356.4000000000001 | 349.092911894958
C03:aleta_motor_8 | C03 |  | 1 | R | paintedSteel | 87.83463516590564 | 356.4000000000001 | 349.092911894958
C03:aleta_motor_9 | C03 |  | 1 | R | paintedSteel | 87.83463516589836 | 356.4000000000001 | 349.092911894958
C03:aleta_motor_10 | C03 |  | 1 | R | paintedSteel | 87.83463516589836 | 356.4000000000001 | 349.092911894958
C03:aleta_motor_11 | C03 |  | 1 | R | paintedSteel | 87.83463516589836 | 356.4000000000001 | 349.092911894958
C03:caja_bornes | C03 |  | 1 | R | paintedSteel | 170.70087850220443 | 90 | 90.08875235876394
C03:base_motor | C03 |  | 1 | R | paintedSteel | 680.2351644145674 | 330 | 189.06360512198717
C03:reductor | C03 |  | 1 | R | paintedSteel | 254.17943846945855 | 220 | 302.17177403393
C03:acoplamiento | C03 |  | 1 | R | paintedSteel | 86.1780577016034 | 80 | 93.67686013354842
C03:capota_techo | C03 |  | 1 | R | paintedSteel | 551.3100548331349 | 2600 | 150.12412472393726
C03:viga_portico_350_ala_-1 | C03 | support-crossbeam | 1 | P | paintedSteel | 60 | 3060 | 5
C03:viga_portico_350_ala_1 | C03 | support-crossbeam | 1 | P | paintedSteel | 60 | 3060 | 5
C03:viga_portico_350_alma | C03 | support-crossbeam | 1 | P | paintedSteel | 5 | 3060 | 50
C03:pie_350_-1 | C03 | support-baseplate | 1 | P | paintedSteel | 160 | 160 | 25
C03:pata_350_-1_ala_-1 | C03 | support-column | 1 | P | paintedSteel | 80 | 7 | 497.84173137799587
C03:pata_350_-1_ala_1 | C03 | support-column | 1 | P | paintedSteel | 80 | 7 | 497.84173137799587
C03:pata_350_-1_alma | C03 | support-column | 1 | P | paintedSteel | 7 | 66 | 497.84173137799587
C03:capitel_350_-1 | C03 | support-capital | 1 | P | paintedSteel | 100 | 100 | 8
C03:asiento_350_-1 | C03 | support-seat | 1 | P | paintedSteel | 101.80529429994567 | 100 | 27.21297687877984
C03:anclaje_350_-1_0_vastago | C03 | support-anchor | 1 | P | machinedSteel | 16 | 16 | 48
C03:anclaje_350_-1_0_arandela | C03 | support-washer | 1 | P | machinedSteel | 28 | 28 | 3
C03:anclaje_350_-1_0_tuerca | C03 | support-nut | 1 | P | machinedSteel | 25.599999999998545 | 22.17025033688151 | 12.799999999999997
C03:anclaje_350_-1_1_vastago | C03 | support-anchor | 1 | P | machinedSteel | 16 | 16 | 48
C03:anclaje_350_-1_1_arandela | C03 | support-washer | 1 | P | machinedSteel | 28 | 28 | 3
C03:anclaje_350_-1_1_tuerca | C03 | support-nut | 1 | P | machinedSteel | 25.599999999998545 | 22.17025033688151 | 12.799999999999997
C03:anclaje_350_-1_2_vastago | C03 | support-anchor | 1 | P | machinedSteel | 16 | 16 | 48
C03:anclaje_350_-1_2_arandela | C03 | support-washer | 1 | P | machinedSteel | 28 | 28 | 3
C03:anclaje_350_-1_2_tuerca | C03 | support-nut | 1 | P | machinedSteel | 25.599999999998545 | 22.17025033688151 | 12.799999999999997
C03:anclaje_350_-1_3_vastago | C03 | support-anchor | 1 | P | machinedSteel | 16 | 16 | 48
C03:anclaje_350_-1_3_arandela | C03 | support-washer | 1 | P | machinedSteel | 28 | 28 | 3
C03:anclaje_350_-1_3_tuerca | C03 | support-nut | 1 | P | machinedSteel | 25.599999999998545 | 22.17025033688151 | 12.799999999999997
C03:cartela_350_-1_-1 | C03 | support-gusset | 1 | P | paintedSteel | 6 | 55 | 103
C03:cartela_longitudinal_350_-1_-1 | C03 | support-gusset | 1 | P | paintedSteel | 90 | 6 | 103
C03:cartela_350_-1_1 | C03 | support-gusset | 1 | P | paintedSteel | 6 | 55 | 103
C03:cartela_longitudinal_350_-1_1 | C03 | support-gusset | 1 | P | paintedSteel | 90 | 6 | 103
C03:union_350_-1 | C03 | support-joint | 1 | P | paintedSteel | 84 | 12.800000000000182 | 12.799999999999955
C03:union_tuerca_350_-1 | C03 | support-joint-nut | 1 | P | machinedSteel | 8 | 20.800000000000182 | 18.01332839871634
C03:pie_350_1 | C03 | support-baseplate | 1 | P | paintedSteel | 160 | 160 | 25
C03:pata_350_1_ala_-1 | C03 | support-column | 1 | P | paintedSteel | 80 | 7 | 497.84173137799587
C03:pata_350_1_ala_1 | C03 | support-column | 1 | P | paintedSteel | 80 | 7 | 497.84173137799587
C03:pata_350_1_alma | C03 | support-column | 1 | P | paintedSteel | 7 | 66 | 497.84173137799587
C03:capitel_350_1 | C03 | support-capital | 1 | P | paintedSteel | 100 | 100 | 8
C03:asiento_350_1 | C03 | support-seat | 1 | P | paintedSteel | 101.80529429994567 | 100 | 27.21297687877984
C03:anclaje_350_1_0_vastago | C03 | support-anchor | 1 | P | machinedSteel | 16 | 16 | 48
C03:anclaje_350_1_0_arandela | C03 | support-washer | 1 | P | machinedSteel | 28 | 28 | 3
C03:anclaje_350_1_0_tuerca | C03 | support-nut | 1 | P | machinedSteel | 25.599999999998545 | 22.17025033688151 | 12.799999999999997
C03:anclaje_350_1_1_vastago | C03 | support-anchor | 1 | P | machinedSteel | 16 | 16 | 48
C03:anclaje_350_1_1_arandela | C03 | support-washer | 1 | P | machinedSteel | 28 | 28 | 3
C03:anclaje_350_1_1_tuerca | C03 | support-nut | 1 | P | machinedSteel | 25.599999999998545 | 22.17025033688151 | 12.799999999999997
C03:anclaje_350_1_2_vastago | C03 | support-anchor | 1 | P | machinedSteel | 16 | 16 | 48
C03:anclaje_350_1_2_arandela | C03 | support-washer | 1 | P | machinedSteel | 28 | 28 | 3
C03:anclaje_350_1_2_tuerca | C03 | support-nut | 1 | P | machinedSteel | 25.599999999998545 | 22.17025033688151 | 12.799999999999997
C03:anclaje_350_1_3_vastago | C03 | support-anchor | 1 | P | machinedSteel | 16 | 16 | 48
C03:anclaje_350_1_3_arandela | C03 | support-washer | 1 | P | machinedSteel | 28 | 28 | 3
C03:anclaje_350_1_3_tuerca | C03 | support-nut | 1 | P | machinedSteel | 25.599999999998545 | 22.17025033688151 | 12.799999999999997
C03:cartela_350_1_-1 | C03 | support-gusset | 1 | P | paintedSteel | 6 | 55 | 103
C03:cartela_longitudinal_350_1_-1 | C03 | support-gusset | 1 | P | paintedSteel | 90 | 6 | 103
C03:cartela_350_1_1 | C03 | support-gusset | 1 | P | paintedSteel | 6 | 55 | 103
C03:cartela_longitudinal_350_1_1 | C03 | support-gusset | 1 | P | paintedSteel | 90 | 6 | 103
C03:union_350_1 | C03 | support-joint | 1 | P | paintedSteel | 84 | 12.800000000000182 | 12.799999999999955
C03:union_tuerca_350_1 | C03 | support-joint-nut | 1 | P | machinedSteel | 8 | 20.800000000000182 | 18.01332839871634
C03:viga_portico_2700_ala_-1 | C03 | support-crossbeam | 1 | P | paintedSteel | 60 | 3060 | 5
C03:viga_portico_2700_ala_1 | C03 | support-crossbeam | 1 | P | paintedSteel | 60 | 3060 | 5
C03:viga_portico_2700_alma | C03 | support-crossbeam | 1 | P | paintedSteel | 5 | 3060 | 50
C03:pie_2700_-1 | C03 | support-baseplate | 1 | P | paintedSteel | 160 | 160 | 25
C03:pata_2700_-1_ala_-1 | C03 | support-column | 1 | P | paintedSteel | 80 | 7 | 956.8713669455144
C03:pata_2700_-1_ala_1 | C03 | support-column | 1 | P | paintedSteel | 80 | 7 | 956.8713669455144
C03:pata_2700_-1_alma | C03 | support-column | 1 | P | paintedSteel | 7 | 66 | 956.8713669455144
C03:capitel_2700_-1 | C03 | support-capital | 1 | P | paintedSteel | 100 | 100 | 8
C03:asiento_2700_-1 | C03 | support-seat | 1 | P | paintedSteel | 100 | 100 | 35.04631021211321
C03:anclaje_2700_-1_0_vastago | C03 | support-anchor | 1 | P | machinedSteel | 16 | 16 | 48
C03:anclaje_2700_-1_0_arandela | C03 | support-washer | 1 | P | machinedSteel | 28 | 28 | 3
C03:anclaje_2700_-1_0_tuerca | C03 | support-nut | 1 | P | machinedSteel | 25.599999999998545 | 22.17025033688151 | 12.799999999999997
C03:anclaje_2700_-1_1_vastago | C03 | support-anchor | 1 | P | machinedSteel | 16 | 16 | 48
C03:anclaje_2700_-1_1_arandela | C03 | support-washer | 1 | P | machinedSteel | 28 | 28 | 3
C03:anclaje_2700_-1_1_tuerca | C03 | support-nut | 1 | P | machinedSteel | 25.599999999998545 | 22.17025033688151 | 12.799999999999997
C03:anclaje_2700_-1_2_vastago | C03 | support-anchor | 1 | P | machinedSteel | 16 | 16 | 48
C03:anclaje_2700_-1_2_arandela | C03 | support-washer | 1 | P | machinedSteel | 28 | 28 | 3
C03:anclaje_2700_-1_2_tuerca | C03 | support-nut | 1 | P | machinedSteel | 25.599999999998545 | 22.17025033688151 | 12.799999999999997
C03:anclaje_2700_-1_3_vastago | C03 | support-anchor | 1 | P | machinedSteel | 16 | 16 | 48
C03:anclaje_2700_-1_3_arandela | C03 | support-washer | 1 | P | machinedSteel | 28 | 28 | 3
C03:anclaje_2700_-1_3_tuerca | C03 | support-nut | 1 | P | machinedSteel | 25.599999999998545 | 22.17025033688151 | 12.799999999999997
C03:cartela_2700_-1_-1 | C03 | support-gusset | 1 | P | paintedSteel | 6 | 55 | 103
C03:cartela_longitudinal_2700_-1_-1 | C03 | support-gusset | 1 | P | paintedSteel | 90 | 6 | 103
C03:cartela_2700_-1_1 | C03 | support-gusset | 1 | P | paintedSteel | 6 | 55 | 103
C03:cartela_longitudinal_2700_-1_1 | C03 | support-gusset | 1 | P | paintedSteel | 90 | 6 | 103
C03:union_2700_-1 | C03 | support-joint | 1 | P | paintedSteel | 84 | 12.800000000000182 | 12.799999999999955
C03:union_tuerca_2700_-1 | C03 | support-joint-nut | 1 | P | machinedSteel | 8 | 20.800000000000182 | 18.01332839871634
C03:pie_2700_1 | C03 | support-baseplate | 1 | P | paintedSteel | 160 | 160 | 25
C03:pata_2700_1_ala_-1 | C03 | support-column | 1 | P | paintedSteel | 80 | 7 | 956.8713669455144
C03:pata_2700_1_ala_1 | C03 | support-column | 1 | P | paintedSteel | 80 | 7 | 956.8713669455144
C03:pata_2700_1_alma | C03 | support-column | 1 | P | paintedSteel | 7 | 66 | 956.8713669455144
C03:capitel_2700_1 | C03 | support-capital | 1 | P | paintedSteel | 100 | 100 | 8
C03:asiento_2700_1 | C03 | support-seat | 1 | P | paintedSteel | 100 | 100 | 35.04631021211321
C03:anclaje_2700_1_0_vastago | C03 | support-anchor | 1 | P | machinedSteel | 16 | 16 | 48
C03:anclaje_2700_1_0_arandela | C03 | support-washer | 1 | P | machinedSteel | 28 | 28 | 3
C03:anclaje_2700_1_0_tuerca | C03 | support-nut | 1 | P | machinedSteel | 25.599999999998545 | 22.17025033688151 | 12.799999999999997
C03:anclaje_2700_1_1_vastago | C03 | support-anchor | 1 | P | machinedSteel | 16 | 16 | 48
C03:anclaje_2700_1_1_arandela | C03 | support-washer | 1 | P | machinedSteel | 28 | 28 | 3
C03:anclaje_2700_1_1_tuerca | C03 | support-nut | 1 | P | machinedSteel | 25.599999999998545 | 22.17025033688151 | 12.799999999999997
C03:anclaje_2700_1_2_vastago | C03 | support-anchor | 1 | P | machinedSteel | 16 | 16 | 48
C03:anclaje_2700_1_2_arandela | C03 | support-washer | 1 | P | machinedSteel | 28 | 28 | 3
C03:anclaje_2700_1_2_tuerca | C03 | support-nut | 1 | P | machinedSteel | 25.599999999998545 | 22.17025033688151 | 12.799999999999997
C03:anclaje_2700_1_3_vastago | C03 | support-anchor | 1 | P | machinedSteel | 16 | 16 | 48
C03:anclaje_2700_1_3_arandela | C03 | support-washer | 1 | P | machinedSteel | 28 | 28 | 3
C03:anclaje_2700_1_3_tuerca | C03 | support-nut | 1 | P | machinedSteel | 25.599999999998545 | 22.17025033688151 | 12.799999999999997
C03:cartela_2700_1_-1 | C03 | support-gusset | 1 | P | paintedSteel | 6 | 55 | 103
C03:cartela_longitudinal_2700_1_-1 | C03 | support-gusset | 1 | P | paintedSteel | 90 | 6 | 103
C03:cartela_2700_1_1 | C03 | support-gusset | 1 | P | paintedSteel | 6 | 55 | 103
C03:cartela_longitudinal_2700_1_1 | C03 | support-gusset | 1 | P | paintedSteel | 90 | 6 | 103
C03:union_2700_1 | C03 | support-joint | 1 | P | paintedSteel | 84 | 12.800000000000182 | 12.799999999999955
C03:union_tuerca_2700_1 | C03 | support-joint-nut | 1 | P | machinedSteel | 8 | 20.800000000000182 | 18.01332839871634
C03:viga_portico_5400_ala_-1 | C03 | support-crossbeam | 1 | P | paintedSteel | 60 | 3060 | 5
C03:viga_portico_5400_ala_1 | C03 | support-crossbeam | 1 | P | paintedSteel | 60 | 3060 | 5
C03:viga_portico_5400_alma | C03 | support-crossbeam | 1 | P | paintedSteel | 5 | 3060 | 50
C03:pie_5400_-1 | C03 | support-baseplate | 1 | P | paintedSteel | 160 | 160 | 25
C03:pata_5400_-1_ala_-1 | C03 | support-column | 1 | P | paintedSteel | 80 | 7 | 1563.2272991489046
C03:pata_5400_-1_ala_1 | C03 | support-column | 1 | P | paintedSteel | 80 | 7 | 1563.2272991489046
C03:pata_5400_-1_alma | C03 | support-column | 1 | P | paintedSteel | 7 | 66 | 1563.2272991489046
C03:capitel_5400_-1 | C03 | support-capital | 1 | P | paintedSteel | 100 | 100 | 8
C03:asiento_5400_-1 | C03 | support-seat | 1 | P | paintedSteel | 99.99999999999272 | 100 | 35.046310212112985
C03:anclaje_5400_-1_0_vastago | C03 | support-anchor | 1 | P | machinedSteel | 16 | 16 | 48
C03:anclaje_5400_-1_0_arandela | C03 | support-washer | 1 | P | machinedSteel | 28 | 28 | 3
C03:anclaje_5400_-1_0_tuerca | C03 | support-nut | 1 | P | machinedSteel | 25.599999999998545 | 22.17025033688151 | 12.799999999999997
C03:anclaje_5400_-1_1_vastago | C03 | support-anchor | 1 | P | machinedSteel | 16 | 16 | 48
C03:anclaje_5400_-1_1_arandela | C03 | support-washer | 1 | P | machinedSteel | 28 | 28 | 3
C03:anclaje_5400_-1_1_tuerca | C03 | support-nut | 1 | P | machinedSteel | 25.60000000000582 | 22.17025033688151 | 12.799999999999997
C03:anclaje_5400_-1_2_vastago | C03 | support-anchor | 1 | P | machinedSteel | 16 | 16 | 48
C03:anclaje_5400_-1_2_arandela | C03 | support-washer | 1 | P | machinedSteel | 28 | 28 | 3
C03:anclaje_5400_-1_2_tuerca | C03 | support-nut | 1 | P | machinedSteel | 25.599999999998545 | 22.17025033688151 | 12.799999999999997
C03:anclaje_5400_-1_3_vastago | C03 | support-anchor | 1 | P | machinedSteel | 16 | 16 | 48
C03:anclaje_5400_-1_3_arandela | C03 | support-washer | 1 | P | machinedSteel | 28 | 28 | 3
C03:anclaje_5400_-1_3_tuerca | C03 | support-nut | 1 | P | machinedSteel | 25.60000000000582 | 22.17025033688151 | 12.799999999999997
C03:cartela_5400_-1_-1 | C03 | support-gusset | 1 | P | paintedSteel | 6 | 55 | 103
C03:cartela_longitudinal_5400_-1_-1 | C03 | support-gusset | 1 | P | paintedSteel | 90 | 6 | 103
C03:cartela_5400_-1_1 | C03 | support-gusset | 1 | P | paintedSteel | 6 | 55 | 103
C03:cartela_longitudinal_5400_-1_1 | C03 | support-gusset | 1 | P | paintedSteel | 90 | 6 | 103
C03:union_5400_-1 | C03 | support-joint | 1 | P | paintedSteel | 84 | 12.800000000000182 | 12.800000000000182
C03:union_tuerca_5400_-1 | C03 | support-joint-nut | 1 | P | machinedSteel | 8 | 20.800000000000182 | 18.013328398716112
C03:pie_5400_1 | C03 | support-baseplate | 1 | P | paintedSteel | 160 | 160 | 25
C03:pata_5400_1_ala_-1 | C03 | support-column | 1 | P | paintedSteel | 80 | 7 | 1563.2272991489046
C03:pata_5400_1_ala_1 | C03 | support-column | 1 | P | paintedSteel | 80 | 7 | 1563.2272991489046
C03:pata_5400_1_alma | C03 | support-column | 1 | P | paintedSteel | 7 | 66 | 1563.2272991489046
C03:capitel_5400_1 | C03 | support-capital | 1 | P | paintedSteel | 100 | 100 | 8
C03:asiento_5400_1 | C03 | support-seat | 1 | P | paintedSteel | 99.99999999999272 | 100 | 35.046310212112985
C03:anclaje_5400_1_0_vastago | C03 | support-anchor | 1 | P | machinedSteel | 16 | 16 | 48
C03:anclaje_5400_1_0_arandela | C03 | support-washer | 1 | P | machinedSteel | 28 | 28 | 3
C03:anclaje_5400_1_0_tuerca | C03 | support-nut | 1 | P | machinedSteel | 25.599999999998545 | 22.17025033688151 | 12.799999999999997
C03:anclaje_5400_1_1_vastago | C03 | support-anchor | 1 | P | machinedSteel | 16 | 16 | 48
C03:anclaje_5400_1_1_arandela | C03 | support-washer | 1 | P | machinedSteel | 28 | 28 | 3
C03:anclaje_5400_1_1_tuerca | C03 | support-nut | 1 | P | machinedSteel | 25.60000000000582 | 22.17025033688151 | 12.799999999999997
C03:anclaje_5400_1_2_vastago | C03 | support-anchor | 1 | P | machinedSteel | 16 | 16 | 48
C03:anclaje_5400_1_2_arandela | C03 | support-washer | 1 | P | machinedSteel | 28 | 28 | 3
C03:anclaje_5400_1_2_tuerca | C03 | support-nut | 1 | P | machinedSteel | 25.599999999998545 | 22.17025033688151 | 12.799999999999997
C03:anclaje_5400_1_3_vastago | C03 | support-anchor | 1 | P | machinedSteel | 16 | 16 | 48
C03:anclaje_5400_1_3_arandela | C03 | support-washer | 1 | P | machinedSteel | 28 | 28 | 3
C03:anclaje_5400_1_3_tuerca | C03 | support-nut | 1 | P | machinedSteel | 25.60000000000582 | 22.17025033688151 | 12.799999999999997
C03:cartela_5400_1_-1 | C03 | support-gusset | 1 | P | paintedSteel | 6 | 55 | 103
C03:cartela_longitudinal_5400_1_-1 | C03 | support-gusset | 1 | P | paintedSteel | 90 | 6 | 103
C03:cartela_5400_1_1 | C03 | support-gusset | 1 | P | paintedSteel | 6 | 55 | 103
C03:cartela_longitudinal_5400_1_1 | C03 | support-gusset | 1 | P | paintedSteel | 90 | 6 | 103
C03:union_5400_1 | C03 | support-joint | 1 | P | paintedSteel | 84 | 12.800000000000182 | 12.800000000000182
C03:union_tuerca_5400_1 | C03 | support-joint-nut | 1 | P | machinedSteel | 8 | 20.800000000000182 | 18.013328398716112
C03:viga_portico_8100_ala_-1 | C03 | support-crossbeam | 1 | P | paintedSteel | 60 | 3060 | 5
C03:viga_portico_8100_ala_1 | C03 | support-crossbeam | 1 | P | paintedSteel | 60 | 3060 | 5
C03:viga_portico_8100_alma | C03 | support-crossbeam | 1 | P | paintedSteel | 5 | 3060 | 50
C03:pie_8100_-1 | C03 | support-baseplate | 1 | P | paintedSteel | 160 | 160 | 25
C03:pata_8100_-1_ala_-1 | C03 | support-column | 1 | P | paintedSteel | 80 | 7 | 2169.583231352294
C03:pata_8100_-1_ala_1 | C03 | support-column | 1 | P | paintedSteel | 80 | 7 | 2169.583231352294
C03:pata_8100_-1_alma | C03 | support-column | 1 | P | paintedSteel | 7 | 66 | 2169.583231352294
C03:capitel_8100_-1 | C03 | support-capital | 1 | P | paintedSteel | 100 | 100 | 8
C03:asiento_8100_-1 | C03 | support-seat | 1 | P | paintedSteel | 100 | 100 | 35.046310212112985
C03:anclaje_8100_-1_0_vastago | C03 | support-anchor | 1 | P | machinedSteel | 16 | 16 | 48
C03:anclaje_8100_-1_0_arandela | C03 | support-washer | 1 | P | machinedSteel | 28 | 28 | 3
C03:anclaje_8100_-1_0_tuerca | C03 | support-nut | 1 | P | machinedSteel | 25.60000000000582 | 22.17025033688151 | 12.799999999999997
C03:anclaje_8100_-1_1_vastago | C03 | support-anchor | 1 | P | machinedSteel | 16 | 16 | 48
C03:anclaje_8100_-1_1_arandela | C03 | support-washer | 1 | P | machinedSteel | 28 | 28 | 3
C03:anclaje_8100_-1_1_tuerca | C03 | support-nut | 1 | P | machinedSteel | 25.60000000000582 | 22.17025033688151 | 12.799999999999997
C03:anclaje_8100_-1_2_vastago | C03 | support-anchor | 1 | P | machinedSteel | 16 | 16 | 48
C03:anclaje_8100_-1_2_arandela | C03 | support-washer | 1 | P | machinedSteel | 28 | 28 | 3
C03:anclaje_8100_-1_2_tuerca | C03 | support-nut | 1 | P | machinedSteel | 25.60000000000582 | 22.17025033688151 | 12.799999999999997
C03:anclaje_8100_-1_3_vastago | C03 | support-anchor | 1 | P | machinedSteel | 16 | 16 | 48
C03:anclaje_8100_-1_3_arandela | C03 | support-washer | 1 | P | machinedSteel | 28 | 28 | 3
C03:anclaje_8100_-1_3_tuerca | C03 | support-nut | 1 | P | machinedSteel | 25.60000000000582 | 22.17025033688151 | 12.799999999999997
C03:cartela_8100_-1_-1 | C03 | support-gusset | 1 | P | paintedSteel | 6 | 55 | 103
C03:cartela_longitudinal_8100_-1_-1 | C03 | support-gusset | 1 | P | paintedSteel | 90 | 6 | 103
C03:cartela_8100_-1_1 | C03 | support-gusset | 1 | P | paintedSteel | 6 | 55 | 103
C03:cartela_longitudinal_8100_-1_1 | C03 | support-gusset | 1 | P | paintedSteel | 90 | 6 | 103
C03:union_8100_-1 | C03 | support-joint | 1 | P | paintedSteel | 84 | 12.800000000000182 | 12.800000000000182
C03:union_tuerca_8100_-1 | C03 | support-joint-nut | 1 | P | machinedSteel | 8 | 20.800000000000182 | 18.013328398716112
C03:pie_8100_1 | C03 | support-baseplate | 1 | P | paintedSteel | 160 | 160 | 25
C03:pata_8100_1_ala_-1 | C03 | support-column | 1 | P | paintedSteel | 80 | 7 | 2169.583231352294
C03:pata_8100_1_ala_1 | C03 | support-column | 1 | P | paintedSteel | 80 | 7 | 2169.583231352294
C03:pata_8100_1_alma | C03 | support-column | 1 | P | paintedSteel | 7 | 66 | 2169.583231352294
C03:capitel_8100_1 | C03 | support-capital | 1 | P | paintedSteel | 100 | 100 | 8
C03:asiento_8100_1 | C03 | support-seat | 1 | P | paintedSteel | 100 | 100 | 35.046310212112985
C03:anclaje_8100_1_0_vastago | C03 | support-anchor | 1 | P | machinedSteel | 16 | 16 | 48
C03:anclaje_8100_1_0_arandela | C03 | support-washer | 1 | P | machinedSteel | 28 | 28 | 3
C03:anclaje_8100_1_0_tuerca | C03 | support-nut | 1 | P | machinedSteel | 25.60000000000582 | 22.17025033688151 | 12.799999999999997
C03:anclaje_8100_1_1_vastago | C03 | support-anchor | 1 | P | machinedSteel | 16 | 16 | 48
C03:anclaje_8100_1_1_arandela | C03 | support-washer | 1 | P | machinedSteel | 28 | 28 | 3
C03:anclaje_8100_1_1_tuerca | C03 | support-nut | 1 | P | machinedSteel | 25.60000000000582 | 22.17025033688151 | 12.799999999999997
C03:anclaje_8100_1_2_vastago | C03 | support-anchor | 1 | P | machinedSteel | 16 | 16 | 48
C03:anclaje_8100_1_2_arandela | C03 | support-washer | 1 | P | machinedSteel | 28 | 28 | 3
C03:anclaje_8100_1_2_tuerca | C03 | support-nut | 1 | P | machinedSteel | 25.60000000000582 | 22.17025033688151 | 12.799999999999997
C03:anclaje_8100_1_3_vastago | C03 | support-anchor | 1 | P | machinedSteel | 16 | 16 | 48
C03:anclaje_8100_1_3_arandela | C03 | support-washer | 1 | P | machinedSteel | 28 | 28 | 3
C03:anclaje_8100_1_3_tuerca | C03 | support-nut | 1 | P | machinedSteel | 25.60000000000582 | 22.17025033688151 | 12.799999999999997
C03:cartela_8100_1_-1 | C03 | support-gusset | 1 | P | paintedSteel | 6 | 55 | 103
C03:cartela_longitudinal_8100_1_-1 | C03 | support-gusset | 1 | P | paintedSteel | 90 | 6 | 103
C03:cartela_8100_1_1 | C03 | support-gusset | 1 | P | paintedSteel | 6 | 55 | 103
C03:cartela_longitudinal_8100_1_1 | C03 | support-gusset | 1 | P | paintedSteel | 90 | 6 | 103
C03:union_8100_1 | C03 | support-joint | 1 | P | paintedSteel | 84 | 12.800000000000182 | 12.800000000000182
C03:union_tuerca_8100_1 | C03 | support-joint-nut | 1 | P | machinedSteel | 8 | 20.800000000000182 | 18.013328398716112
C03:viga_portico_10500_ala_-1 | C03 | support-crossbeam | 1 | P | paintedSteel | 60 | 3060 | 5
C03:viga_portico_10500_ala_1 | C03 | support-crossbeam | 1 | P | paintedSteel | 60 | 3060 | 5
C03:viga_portico_10500_alma | C03 | support-crossbeam | 1 | P | paintedSteel | 5 | 3060 | 50
C03:pie_10500_-1 | C03 | support-baseplate | 1 | P | paintedSteel | 160 | 160 | 25
C03:pata_10500_-1_ala_-1 | C03 | support-column | 1 | P | paintedSteel | 80 | 7 | 2708.5662821997516
C03:pata_10500_-1_ala_1 | C03 | support-column | 1 | P | paintedSteel | 80 | 7 | 2708.5662821997516
C03:pata_10500_-1_alma | C03 | support-column | 1 | P | paintedSteel | 7 | 66 | 2708.5662821997516
C03:capitel_10500_-1 | C03 | support-capital | 1 | P | paintedSteel | 100 | 100 | 8
C03:asiento_10500_-1 | C03 | support-seat | 1 | P | paintedSteel | 100 | 100 | 35.046310212112985
C03:anclaje_10500_-1_0_vastago | C03 | support-anchor | 1 | P | machinedSteel | 16 | 16 | 48
C03:anclaje_10500_-1_0_arandela | C03 | support-washer | 1 | P | machinedSteel | 28 | 28 | 3
C03:anclaje_10500_-1_0_tuerca | C03 | support-nut | 1 | P | machinedSteel | 25.60000000000582 | 22.17025033688151 | 12.799999999999997
C03:anclaje_10500_-1_1_vastago | C03 | support-anchor | 1 | P | machinedSteel | 16 | 16 | 48
C03:anclaje_10500_-1_1_arandela | C03 | support-washer | 1 | P | machinedSteel | 28 | 28 | 3
C03:anclaje_10500_-1_1_tuerca | C03 | support-nut | 1 | P | machinedSteel | 25.60000000000582 | 22.17025033688151 | 12.799999999999997
C03:anclaje_10500_-1_2_vastago | C03 | support-anchor | 1 | P | machinedSteel | 16 | 16 | 48
C03:anclaje_10500_-1_2_arandela | C03 | support-washer | 1 | P | machinedSteel | 28 | 28 | 3
C03:anclaje_10500_-1_2_tuerca | C03 | support-nut | 1 | P | machinedSteel | 25.60000000000582 | 22.17025033688151 | 12.799999999999997
C03:anclaje_10500_-1_3_vastago | C03 | support-anchor | 1 | P | machinedSteel | 16 | 16 | 48
C03:anclaje_10500_-1_3_arandela | C03 | support-washer | 1 | P | machinedSteel | 28 | 28 | 3
C03:anclaje_10500_-1_3_tuerca | C03 | support-nut | 1 | P | machinedSteel | 25.60000000000582 | 22.17025033688151 | 12.799999999999997
C03:cartela_10500_-1_-1 | C03 | support-gusset | 1 | P | paintedSteel | 6 | 55 | 103
C03:cartela_longitudinal_10500_-1_-1 | C03 | support-gusset | 1 | P | paintedSteel | 90 | 6 | 103
C03:cartela_10500_-1_1 | C03 | support-gusset | 1 | P | paintedSteel | 6 | 55 | 103
C03:cartela_longitudinal_10500_-1_1 | C03 | support-gusset | 1 | P | paintedSteel | 90 | 6 | 103
C03:union_10500_-1 | C03 | support-joint | 1 | P | paintedSteel | 84 | 12.800000000000182 | 12.800000000000182
C03:union_tuerca_10500_-1 | C03 | support-joint-nut | 1 | P | machinedSteel | 8 | 20.800000000000182 | 18.013328398716112
C03:pie_10500_1 | C03 | support-baseplate | 1 | P | paintedSteel | 160 | 160 | 25
C03:pata_10500_1_ala_-1 | C03 | support-column | 1 | P | paintedSteel | 80 | 7 | 2708.5662821997516
C03:pata_10500_1_ala_1 | C03 | support-column | 1 | P | paintedSteel | 80 | 7 | 2708.5662821997516
C03:pata_10500_1_alma | C03 | support-column | 1 | P | paintedSteel | 7 | 66 | 2708.5662821997516
C03:capitel_10500_1 | C03 | support-capital | 1 | P | paintedSteel | 100 | 100 | 8
C03:asiento_10500_1 | C03 | support-seat | 1 | P | paintedSteel | 100 | 100 | 35.046310212112985
C03:anclaje_10500_1_0_vastago | C03 | support-anchor | 1 | P | machinedSteel | 16 | 16 | 48
C03:anclaje_10500_1_0_arandela | C03 | support-washer | 1 | P | machinedSteel | 28 | 28 | 3
C03:anclaje_10500_1_0_tuerca | C03 | support-nut | 1 | P | machinedSteel | 25.60000000000582 | 22.17025033688151 | 12.799999999999997
C03:anclaje_10500_1_1_vastago | C03 | support-anchor | 1 | P | machinedSteel | 16 | 16 | 48
C03:anclaje_10500_1_1_arandela | C03 | support-washer | 1 | P | machinedSteel | 28 | 28 | 3
C03:anclaje_10500_1_1_tuerca | C03 | support-nut | 1 | P | machinedSteel | 25.60000000000582 | 22.17025033688151 | 12.799999999999997
C03:anclaje_10500_1_2_vastago | C03 | support-anchor | 1 | P | machinedSteel | 16 | 16 | 48
C03:anclaje_10500_1_2_arandela | C03 | support-washer | 1 | P | machinedSteel | 28 | 28 | 3
C03:anclaje_10500_1_2_tuerca | C03 | support-nut | 1 | P | machinedSteel | 25.60000000000582 | 22.17025033688151 | 12.799999999999997
C03:anclaje_10500_1_3_vastago | C03 | support-anchor | 1 | P | machinedSteel | 16 | 16 | 48
C03:anclaje_10500_1_3_arandela | C03 | support-washer | 1 | P | machinedSteel | 28 | 28 | 3
C03:anclaje_10500_1_3_tuerca | C03 | support-nut | 1 | P | machinedSteel | 25.60000000000582 | 22.17025033688151 | 12.799999999999997
C03:cartela_10500_1_-1 | C03 | support-gusset | 1 | P | paintedSteel | 6 | 55 | 103
C03:cartela_longitudinal_10500_1_-1 | C03 | support-gusset | 1 | P | paintedSteel | 90 | 6 | 103
C03:cartela_10500_1_1 | C03 | support-gusset | 1 | P | paintedSteel | 6 | 55 | 103
C03:cartela_longitudinal_10500_1_1 | C03 | support-gusset | 1 | P | paintedSteel | 90 | 6 | 103
C03:union_10500_1 | C03 | support-joint | 1 | P | paintedSteel | 84 | 12.800000000000182 | 12.800000000000182
C03:union_tuerca_10500_1 | C03 | support-joint-nut | 1 | P | machinedSteel | 8 | 20.800000000000182 | 18.013328398716112
C03:viga_portico_11700_ala_-1 | C03 | support-crossbeam | 1 | P | paintedSteel | 60 | 3060 | 5
C03:viga_portico_11700_ala_1 | C03 | support-crossbeam | 1 | P | paintedSteel | 60 | 3060 | 5
C03:viga_portico_11700_alma | C03 | support-crossbeam | 1 | P | paintedSteel | 5 | 3060 | 50
C03:pie_11700_-1 | C03 | support-baseplate | 1 | P | paintedSteel | 160 | 160 | 25
C03:pata_11700_-1_ala_-1 | C03 | support-column | 1 | P | paintedSteel | 80 | 7 | 2978.0578076234806
C03:pata_11700_-1_ala_1 | C03 | support-column | 1 | P | paintedSteel | 80 | 7 | 2978.0578076234806
C03:pata_11700_-1_alma | C03 | support-column | 1 | P | paintedSteel | 7 | 66 | 2978.0578076234806
C03:capitel_11700_-1 | C03 | support-capital | 1 | P | paintedSteel | 100 | 100 | 8
C03:asiento_11700_-1 | C03 | support-seat | 1 | P | paintedSteel | 99.99999999999272 | 100 | 35.046310212112985
C03:anclaje_11700_-1_0_vastago | C03 | support-anchor | 1 | P | machinedSteel | 16 | 16 | 48
C03:anclaje_11700_-1_0_arandela | C03 | support-washer | 1 | P | machinedSteel | 28 | 28 | 3
C03:anclaje_11700_-1_0_tuerca | C03 | support-nut | 1 | P | machinedSteel | 25.60000000000582 | 22.17025033688151 | 12.799999999999997
C03:anclaje_11700_-1_1_vastago | C03 | support-anchor | 1 | P | machinedSteel | 16 | 16 | 48
C03:anclaje_11700_-1_1_arandela | C03 | support-washer | 1 | P | machinedSteel | 28 | 28 | 3
C03:anclaje_11700_-1_1_tuerca | C03 | support-nut | 1 | P | machinedSteel | 25.60000000000582 | 22.17025033688151 | 12.799999999999997
C03:anclaje_11700_-1_2_vastago | C03 | support-anchor | 1 | P | machinedSteel | 16 | 16 | 48
C03:anclaje_11700_-1_2_arandela | C03 | support-washer | 1 | P | machinedSteel | 28 | 28 | 3
C03:anclaje_11700_-1_2_tuerca | C03 | support-nut | 1 | P | machinedSteel | 25.60000000000582 | 22.17025033688151 | 12.799999999999997
C03:anclaje_11700_-1_3_vastago | C03 | support-anchor | 1 | P | machinedSteel | 16 | 16 | 48
C03:anclaje_11700_-1_3_arandela | C03 | support-washer | 1 | P | machinedSteel | 28 | 28 | 3
C03:anclaje_11700_-1_3_tuerca | C03 | support-nut | 1 | P | machinedSteel | 25.60000000000582 | 22.17025033688151 | 12.799999999999997
C03:cartela_11700_-1_-1 | C03 | support-gusset | 1 | P | paintedSteel | 6 | 55 | 103
C03:cartela_longitudinal_11700_-1_-1 | C03 | support-gusset | 1 | P | paintedSteel | 90 | 6 | 103
C03:cartela_11700_-1_1 | C03 | support-gusset | 1 | P | paintedSteel | 6 | 55 | 103
C03:cartela_longitudinal_11700_-1_1 | C03 | support-gusset | 1 | P | paintedSteel | 90 | 6 | 103
C03:union_11700_-1 | C03 | support-joint | 1 | P | paintedSteel | 84 | 12.800000000000182 | 12.800000000000182
C03:union_tuerca_11700_-1 | C03 | support-joint-nut | 1 | P | machinedSteel | 8 | 20.800000000000182 | 18.013328398716112
C03:pie_11700_1 | C03 | support-baseplate | 1 | P | paintedSteel | 160 | 160 | 25
C03:pata_11700_1_ala_-1 | C03 | support-column | 1 | P | paintedSteel | 80 | 7 | 2978.0578076234806
C03:pata_11700_1_ala_1 | C03 | support-column | 1 | P | paintedSteel | 80 | 7 | 2978.0578076234806
C03:pata_11700_1_alma | C03 | support-column | 1 | P | paintedSteel | 7 | 66 | 2978.0578076234806
C03:capitel_11700_1 | C03 | support-capital | 1 | P | paintedSteel | 100 | 100 | 8
C03:asiento_11700_1 | C03 | support-seat | 1 | P | paintedSteel | 99.99999999999272 | 100 | 35.046310212112985
C03:anclaje_11700_1_0_vastago | C03 | support-anchor | 1 | P | machinedSteel | 16 | 16 | 48
C03:anclaje_11700_1_0_arandela | C03 | support-washer | 1 | P | machinedSteel | 28 | 28 | 3
C03:anclaje_11700_1_0_tuerca | C03 | support-nut | 1 | P | machinedSteel | 25.60000000000582 | 22.17025033688151 | 12.799999999999997
C03:anclaje_11700_1_1_vastago | C03 | support-anchor | 1 | P | machinedSteel | 16 | 16 | 48
C03:anclaje_11700_1_1_arandela | C03 | support-washer | 1 | P | machinedSteel | 28 | 28 | 3
C03:anclaje_11700_1_1_tuerca | C03 | support-nut | 1 | P | machinedSteel | 25.60000000000582 | 22.17025033688151 | 12.799999999999997
C03:anclaje_11700_1_2_vastago | C03 | support-anchor | 1 | P | machinedSteel | 16 | 16 | 48
C03:anclaje_11700_1_2_arandela | C03 | support-washer | 1 | P | machinedSteel | 28 | 28 | 3
C03:anclaje_11700_1_2_tuerca | C03 | support-nut | 1 | P | machinedSteel | 25.60000000000582 | 22.17025033688151 | 12.799999999999997
C03:anclaje_11700_1_3_vastago | C03 | support-anchor | 1 | P | machinedSteel | 16 | 16 | 48
C03:anclaje_11700_1_3_arandela | C03 | support-washer | 1 | P | machinedSteel | 28 | 28 | 3
C03:anclaje_11700_1_3_tuerca | C03 | support-nut | 1 | P | machinedSteel | 25.60000000000582 | 22.17025033688151 | 12.799999999999997
C03:cartela_11700_1_-1 | C03 | support-gusset | 1 | P | paintedSteel | 6 | 55 | 103
C03:cartela_longitudinal_11700_1_-1 | C03 | support-gusset | 1 | P | paintedSteel | 90 | 6 | 103
C03:cartela_11700_1_1 | C03 | support-gusset | 1 | P | paintedSteel | 6 | 55 | 103
C03:cartela_longitudinal_11700_1_1 | C03 | support-gusset | 1 | P | paintedSteel | 90 | 6 | 103
C03:union_11700_1 | C03 | support-joint | 1 | P | paintedSteel | 84 | 12.800000000000182 | 12.800000000000182
C03:union_tuerca_11700_1 | C03 | support-joint-nut | 1 | P | machinedSteel | 8 | 20.800000000000182 | 18.013328398716112
C03:puente_carga_350 | C03 |  | 1 | R | paintedSteel | 52.197306184800254 | 3000 | 23.10195274884586
C03:puente_carga_350_placa_-1 | C03 |  | 1 | P | paintedSteel | 64.16182708988708 | 52 | 22.16853347098197
C03:puente_carga_350_ménsula_-1 | C03 |  | 1 | P | paintedSteel | 31.928610685674357 | 28 | 18.43076630816779
C03:puente_carga_350_perno_-1 | C03 |  | 1 | R | galvanizedSteel | 14.3883934268124 | 10.392304845413491 | 14.388393426811831
C03:puente_carga_350_placa_1 | C03 |  | 1 | P | paintedSteel | 64.16182708988708 | 52 | 22.16853347098197
C03:puente_carga_350_ménsula_1 | C03 |  | 1 | P | paintedSteel | 31.928610685674357 | 28 | 18.43076630816779
C03:puente_carga_350_perno_1 | C03 |  | 1 | R | galvanizedSteel | 14.3883934268124 | 10.392304845413491 | 14.388393426811831
C03:eje_polin_carga_350 | C03 |  | 1 | R | machinedSteel | 17.988791938154463 | 2536 | 17.988791938156965
C03:polin_carga_350 | C03 |  | 1 | R | machinedSteel | 63.96014911344537 | 2500 | 63.96014911344673
C03:polin_carga_350_horquilla_-1_ménsula | C03 |  | 1 | R | paintedSteel | 27.573876050337276 | 18 | 39.57195994145275
C03:polin_carga_350_horquilla_-1_pie_horquilla | C03 |  | 1 | R | paintedSteel | 49.01967540216356 | 14 | 20.524226160761373
C03:polin_carga_350_horquilla_-1_oreja_-1 | C03 |  | 1 | R | paintedSteel | 20.524226160763646 | 14 | 49.01967540216299
C03:polin_carga_350_horquilla_-1_oreja_1 | C03 |  | 1 | R | paintedSteel | 20.52422616076001 | 14 | 49.019675402162875
C03:polin_carga_350_horquilla_-1_alojamiento | C03 |  | 1 | R | machinedSteel | 37.976338536107505 | 12 | 37.97633853610887
C03:polin_carga_350_horquilla_1_ménsula | C03 |  | 1 | R | paintedSteel | 27.573876050337276 | 18 | 39.57195994145275
C03:polin_carga_350_horquilla_1_pie_horquilla | C03 |  | 1 | R | paintedSteel | 49.01967540216356 | 14 | 20.524226160761373
C03:polin_carga_350_horquilla_1_oreja_-1 | C03 |  | 1 | R | paintedSteel | 20.524226160763646 | 14 | 49.01967540216299
C03:polin_carga_350_horquilla_1_oreja_1 | C03 |  | 1 | R | paintedSteel | 20.52422616076001 | 14 | 49.019675402162875
C03:polin_carga_350_horquilla_1_alojamiento | C03 |  | 1 | R | machinedSteel | 37.976338536107505 | 12 | 37.97633853610887
C03:puente_carga_1330 | C03 |  | 1 | R | paintedSteel | 52.197306184800254 | 3000 | 23.101952748846088
C03:puente_carga_1330_placa_-1 | C03 |  | 1 | P | paintedSteel | 64.16182708988708 | 52 | 22.168533470982084
C03:puente_carga_1330_ménsula_-1 | C03 |  | 1 | P | paintedSteel | 31.92861068567072 | 28 | 18.430766308167904
C03:puente_carga_1330_perno_-1 | C03 |  | 1 | R | galvanizedSteel | 14.3883934268124 | 10.392304845413491 | 14.388393426811945
C03:puente_carga_1330_placa_1 | C03 |  | 1 | P | paintedSteel | 64.16182708988708 | 52 | 22.168533470982084
C03:puente_carga_1330_ménsula_1 | C03 |  | 1 | P | paintedSteel | 31.92861068567072 | 28 | 18.430766308167904
C03:puente_carga_1330_perno_1 | C03 |  | 1 | R | galvanizedSteel | 14.3883934268124 | 10.392304845413491 | 14.388393426811945
C03:eje_polin_carga_1330 | C03 |  | 1 | R | machinedSteel | 17.988791938154463 | 2536 | 17.988791938156965
C03:polin_carga_1330 | C03 |  | 1 | R | machinedSteel | 63.960149113449006 | 2500 | 63.960149113446505
C03:polin_carga_1330_horquilla_-1_ménsula | C03 |  | 1 | R | paintedSteel | 27.573876050337276 | 18 | 39.57195994145286
C03:polin_carga_1330_horquilla_-1_pie_horquilla | C03 |  | 1 | R | paintedSteel | 49.01967540216356 | 14 | 20.524226160761373
C03:polin_carga_1330_horquilla_-1_oreja_-1 | C03 |  | 1 | R | paintedSteel | 20.524226160763646 | 14 | 49.019675402162875
C03:polin_carga_1330_horquilla_-1_oreja_1 | C03 |  | 1 | R | paintedSteel | 20.524226160763646 | 14 | 49.01967540216265
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
C03:polin_carga_3290_horquilla_-1_pie_horquilla | C03 |  | 1 | R | paintedSteel | 49.01967540216356 | 14 | 20.524226160761373
C03:polin_carga_3290_horquilla_-1_oreja_-1 | C03 |  | 1 | R | paintedSteel | 20.52422616076001 | 14 | 49.0196754021631
C03:polin_carga_3290_horquilla_-1_oreja_1 | C03 |  | 1 | R | paintedSteel | 20.524226160763646 | 14 | 49.01967540216265
C03:polin_carga_3290_horquilla_-1_alojamiento | C03 |  | 1 | R | machinedSteel | 37.976338536107505 | 12 | 37.97633853610887
C03:polin_carga_3290_horquilla_1_ménsula | C03 |  | 1 | R | paintedSteel | 27.573876050337276 | 18 | 39.57195994145263
C03:polin_carga_3290_horquilla_1_pie_horquilla | C03 |  | 1 | R | paintedSteel | 49.01967540216356 | 14 | 20.524226160761373
C03:polin_carga_3290_horquilla_1_oreja_-1 | C03 |  | 1 | R | paintedSteel | 20.52422616076001 | 14 | 49.0196754021631
C03:polin_carga_3290_horquilla_1_oreja_1 | C03 |  | 1 | R | paintedSteel | 20.524226160763646 | 14 | 49.01967540216265
C03:polin_carga_3290_horquilla_1_alojamiento | C03 |  | 1 | R | machinedSteel | 37.976338536107505 | 12 | 37.97633853610887
C03:puente_carga_4270 | C03 |  | 1 | R | paintedSteel | 52.19730618480389 | 3000 | 23.101952748846088
C03:puente_carga_4270_placa_-1 | C03 |  | 1 | P | paintedSteel | 64.16182708989072 | 52 | 22.168533470981856
C03:puente_carga_4270_ménsula_-1 | C03 |  | 1 | P | paintedSteel | 31.928610685674357 | 28 | 18.430766308167904
C03:puente_carga_4270_perno_-1 | C03 |  | 1 | R | galvanizedSteel | 14.3883934268124 | 10.392304845413491 | 14.388393426812172
C03:puente_carga_4270_placa_1 | C03 |  | 1 | P | paintedSteel | 64.16182708989072 | 52 | 22.168533470981856
C03:puente_carga_4270_ménsula_1 | C03 |  | 1 | P | paintedSteel | 31.928610685674357 | 28 | 18.430766308167904
C03:puente_carga_4270_perno_1 | C03 |  | 1 | R | galvanizedSteel | 14.3883934268124 | 10.392304845413491 | 14.388393426812172
C03:eje_polin_carga_4270 | C03 |  | 1 | R | machinedSteel | 17.9887919381581 | 2536 | 17.988791938156965
C03:polin_carga_4270 | C03 |  | 1 | R | machinedSteel | 63.96014911344537 | 2500 | 63.96014911344673
C03:polin_carga_4270_horquilla_-1_ménsula | C03 |  | 1 | R | paintedSteel | 27.573876050340914 | 18 | 39.57195994145263
C03:polin_carga_4270_horquilla_-1_pie_horquilla | C03 |  | 1 | R | paintedSteel | 49.01967540215992 | 14 | 20.524226160761145
C03:polin_carga_4270_horquilla_-1_oreja_-1 | C03 |  | 1 | R | paintedSteel | 20.52422616076001 | 14 | 49.019675402162875
C03:polin_carga_4270_horquilla_-1_oreja_1 | C03 |  | 1 | R | paintedSteel | 20.524226160763646 | 14 | 49.019675402162875
C03:polin_carga_4270_horquilla_-1_alojamiento | C03 |  | 1 | R | machinedSteel | 37.976338536107505 | 12 | 37.97633853610887
C03:polin_carga_4270_horquilla_1_ménsula | C03 |  | 1 | R | paintedSteel | 27.573876050340914 | 18 | 39.57195994145263
C03:polin_carga_4270_horquilla_1_pie_horquilla | C03 |  | 1 | R | paintedSteel | 49.01967540215992 | 14 | 20.524226160761145
C03:polin_carga_4270_horquilla_1_oreja_-1 | C03 |  | 1 | R | paintedSteel | 20.52422616076001 | 14 | 49.019675402162875
C03:polin_carga_4270_horquilla_1_oreja_1 | C03 |  | 1 | R | paintedSteel | 20.524226160763646 | 14 | 49.019675402162875
C03:polin_carga_4270_horquilla_1_alojamiento | C03 |  | 1 | R | machinedSteel | 37.976338536107505 | 12 | 37.97633853610887
C03:puente_carga_5250 | C03 |  | 1 | R | paintedSteel | 52.19730618480389 | 3000 | 23.101952748846088
C03:puente_carga_5250_placa_-1 | C03 |  | 1 | P | paintedSteel | 64.16182708989072 | 52 | 22.168533470982084
C03:puente_carga_5250_ménsula_-1 | C03 |  | 1 | P | paintedSteel | 31.928610685674357 | 28 | 18.430766308167904
C03:puente_carga_5250_perno_-1 | C03 |  | 1 | R | galvanizedSteel | 14.388393426808761 | 10.392304845413491 | 14.388393426812172
C03:puente_carga_5250_placa_1 | C03 |  | 1 | P | paintedSteel | 64.16182708989072 | 52 | 22.168533470982084
C03:puente_carga_5250_ménsula_1 | C03 |  | 1 | P | paintedSteel | 31.928610685674357 | 28 | 18.430766308167904
C03:puente_carga_5250_perno_1 | C03 |  | 1 | R | galvanizedSteel | 14.388393426808761 | 10.392304845413491 | 14.388393426812172
C03:eje_polin_carga_5250 | C03 |  | 1 | R | machinedSteel | 17.9887919381581 | 2536 | 17.988791938156282
C03:polin_carga_5250 | C03 |  | 1 | R | machinedSteel | 63.96014911344537 | 2500 | 63.96014911344628
C03:polin_carga_5250_horquilla_-1_ménsula | C03 |  | 1 | R | paintedSteel | 27.573876050340914 | 18 | 39.57195994145263
C03:polin_carga_5250_horquilla_-1_pie_horquilla | C03 |  | 1 | R | paintedSteel | 49.01967540215992 | 14 | 20.524226160761373
C03:polin_carga_5250_horquilla_-1_oreja_-1 | C03 |  | 1 | R | paintedSteel | 20.524226160763646 | 14 | 49.0196754021631
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
C03:polin_carga_7210_horquilla_-1_ménsula | C03 |  | 1 | R | paintedSteel | 27.573876050337276 | 18 | 39.57195994145286
C03:polin_carga_7210_horquilla_-1_pie_horquilla | C03 |  | 1 | R | paintedSteel | 49.01967540215992 | 14 | 20.524226160761827
C03:polin_carga_7210_horquilla_-1_oreja_-1 | C03 |  | 1 | R | paintedSteel | 20.524226160763646 | 14 | 49.01967540216265
C03:polin_carga_7210_horquilla_-1_oreja_1 | C03 |  | 1 | R | paintedSteel | 20.524226160763646 | 14 | 49.01967540216219
C03:polin_carga_7210_horquilla_-1_alojamiento | C03 |  | 1 | R | machinedSteel | 37.97633853610023 | 12 | 37.976338536109324
C03:polin_carga_7210_horquilla_1_ménsula | C03 |  | 1 | R | paintedSteel | 27.573876050337276 | 18 | 39.57195994145286
C03:polin_carga_7210_horquilla_1_pie_horquilla | C03 |  | 1 | R | paintedSteel | 49.01967540215992 | 14 | 20.524226160761827
C03:polin_carga_7210_horquilla_1_oreja_-1 | C03 |  | 1 | R | paintedSteel | 20.524226160763646 | 14 | 49.01967540216265
C03:polin_carga_7210_horquilla_1_oreja_1 | C03 |  | 1 | R | paintedSteel | 20.524226160763646 | 14 | 49.01967540216219
C03:polin_carga_7210_horquilla_1_alojamiento | C03 |  | 1 | R | machinedSteel | 37.97633853610023 | 12 | 37.976338536109324
C03:puente_carga_8190 | C03 |  | 1 | R | paintedSteel | 52.19730618480389 | 3000 | 23.101952748845633
C03:puente_carga_8190_placa_-1 | C03 |  | 1 | P | paintedSteel | 64.16182708989072 | 52 | 22.16853347098231
C03:puente_carga_8190_ménsula_-1 | C03 |  | 1 | P | paintedSteel | 31.928610685674357 | 28 | 18.43076630816813
C03:puente_carga_8190_perno_-1 | C03 |  | 1 | R | galvanizedSteel | 14.388393426808761 | 10.392304845413491 | 14.388393426811945
C03:puente_carga_8190_placa_1 | C03 |  | 1 | P | paintedSteel | 64.16182708989072 | 52 | 22.16853347098231
C03:puente_carga_8190_ménsula_1 | C03 |  | 1 | P | paintedSteel | 31.928610685674357 | 28 | 18.43076630816813
C03:puente_carga_8190_perno_1 | C03 |  | 1 | R | galvanizedSteel | 14.388393426808761 | 10.392304845413491 | 14.388393426811945
C03:eje_polin_carga_8190 | C03 |  | 1 | R | machinedSteel | 17.9887919381581 | 2536 | 17.988791938156737
C03:polin_carga_8190 | C03 |  | 1 | R | machinedSteel | 63.96014911344537 | 2500 | 63.96014911344719
C03:polin_carga_8190_horquilla_-1_ménsula | C03 |  | 1 | R | paintedSteel | 27.573876050337276 | 18 | 39.571959941452405
C03:polin_carga_8190_horquilla_-1_pie_horquilla | C03 |  | 1 | R | paintedSteel | 49.01967540215992 | 14 | 20.524226160761373
C03:polin_carga_8190_horquilla_-1_oreja_-1 | C03 |  | 1 | R | paintedSteel | 20.52422616075637 | 14 | 49.01967540216265
C03:polin_carga_8190_horquilla_-1_oreja_1 | C03 |  | 1 | R | paintedSteel | 20.524226160763646 | 14 | 49.0196754021631
C03:polin_carga_8190_horquilla_-1_alojamiento | C03 |  | 1 | R | machinedSteel | 37.976338536107505 | 12 | 37.97633853610887
C03:polin_carga_8190_horquilla_1_ménsula | C03 |  | 1 | R | paintedSteel | 27.573876050337276 | 18 | 39.571959941452405
C03:polin_carga_8190_horquilla_1_pie_horquilla | C03 |  | 1 | R | paintedSteel | 49.01967540215992 | 14 | 20.524226160761373
C03:polin_carga_8190_horquilla_1_oreja_-1 | C03 |  | 1 | R | paintedSteel | 20.52422616075637 | 14 | 49.01967540216265
C03:polin_carga_8190_horquilla_1_oreja_1 | C03 |  | 1 | R | paintedSteel | 20.524226160763646 | 14 | 49.0196754021631
C03:polin_carga_8190_horquilla_1_alojamiento | C03 |  | 1 | R | machinedSteel | 37.976338536107505 | 12 | 37.97633853610887
C03:puente_carga_9170 | C03 |  | 1 | R | paintedSteel | 52.19730618480389 | 3000 | 23.101952748845633
C03:puente_carga_9170_placa_-1 | C03 |  | 1 | P | paintedSteel | 64.16182708989072 | 52 | 22.16853347098231
C03:puente_carga_9170_ménsula_-1 | C03 |  | 1 | P | paintedSteel | 31.928610685674357 | 28 | 18.430766308167676
C03:puente_carga_9170_perno_-1 | C03 |  | 1 | R | galvanizedSteel | 14.388393426816037 | 10.392304845413491 | 14.38839342681149
C03:puente_carga_9170_placa_1 | C03 |  | 1 | P | paintedSteel | 64.16182708989072 | 52 | 22.16853347098231
C03:puente_carga_9170_ménsula_1 | C03 |  | 1 | P | paintedSteel | 31.928610685674357 | 28 | 18.430766308167676
C03:puente_carga_9170_perno_1 | C03 |  | 1 | R | galvanizedSteel | 14.388393426816037 | 10.392304845413491 | 14.38839342681149
C03:eje_polin_carga_9170 | C03 |  | 1 | R | machinedSteel | 17.9887919381581 | 2536 | 17.988791938156737
C03:polin_carga_9170 | C03 |  | 1 | R | machinedSteel | 63.960149113452644 | 2500 | 63.96014911344719
C03:polin_carga_9170_horquilla_-1_ménsula | C03 |  | 1 | R | paintedSteel | 27.573876050337276 | 18 | 39.57195994145286
C03:polin_carga_9170_horquilla_-1_pie_horquilla | C03 |  | 1 | R | paintedSteel | 49.01967540215992 | 14 | 20.524226160761827
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
C03:plataforma_motor | C03 |  | 1 | P | paintedSteel | 908.4903210863995 | 360 | 218.60049734720178
C03:plataforma_anclaje_0 | C03 |  | 1 | P | paintedSteel | 74.94924414227717 | 44 | 44.95403441448707
C03:plataforma_montante_0 | C03 |  | 1 | P | paintedSteel | 63.7784264704751 | 28 | 164.63731918016856
C03:plataforma_brazo_0 | C03 |  | 1 | P | paintedSteel | 42.12232837185729 | 380 | 22.625442048794866
C03:plataforma_diagonal_0 | C03 |  | 1 | P | paintedSteel | 55.51272110917489 | 277.23531035803626 | 152.79375066700823
C03:plataforma_anclaje_1 | C03 |  | 1 | P | paintedSteel | 74.94924414227717 | 44 | 44.95403441448752
C03:plataforma_montante_1 | C03 |  | 1 | P | paintedSteel | 63.7784264704751 | 28 | 164.63731918016856
C03:plataforma_brazo_1 | C03 |  | 1 | P | paintedSteel | 42.12232837185729 | 380 | 22.62544204879532
C03:plataforma_diagonal_1 | C03 |  | 1 | P | paintedSteel | 55.51272110917489 | 277.23531035803626 | 152.79375066700777
C03:pedestal_reductor | C03 |  | 1 | P | paintedSteel | 210.38706558810372 | 220 | 112.1527537295924
C03:eje_salida_reductor | C03 |  | 1 | R | machinedSteel | 31.980074556726322 | 95 | 31.980074556723594
C03:prolongacion_eje_cabeza | C03 |  | 1 | R | machinedSteel | 43.972602515495964 | 305 | 43.9726025154946
C03:piñon_reductor | C03 |  | 1 | R | machinedSteel | 119.9454315313269 | 18 | 119.94543153132963
C03:piñon_tambor | C03 |  | 1 | R | machinedSteel | 199.90905255221878 | 18 | 199.90905255221696
C03:cadena_ramal_-1 | C03 |  | 1 | R | machinedSteel | 1146.0693731608408 | 10 | 137.29031321279672
C03:cadena_ramal_1 | C03 |  | 1 | R | machinedSteel | 1152.0024372816042 | 10 | 57.62385131830479
C03:guarda_cadena | C03 |  | 1 | R | guard | 1166.6155396663307 | 8 | 300.92680615813924
C03:guarda_cadena_montante | C03 |  | 1 | P | paintedSteel | 47.56116418592865 | 8 | 126.29858972138118
C03:guarda_cadena_brazo | C03 |  | 1 | P | paintedSteel | 41.67317582949181 | 42 | 20.676529020032376
C03:guarda_cadena_cabeza | C03 |  | 1 | P | paintedSteel | 28.852938283256663 | 403 | 25.103537067285743
C03:guarda_cadena_union_cabeza | C03 |  | 1 | P | paintedSteel | 44.529098382467055 | 20 | 39.546201476995975
C03:calce_cojinete_cola_-1 | C03 |  | 1 | P | paintedSteel | 176.74963021573785 | 50 | 46.27046789984672
C03:calce_cojinete_cola_1 | C03 |  | 1 | P | paintedSteel | 176.74963021573785 | 50 | 46.27046789984672
C03:calce_cojinete_cabeza_-1 | C03 |  | 1 | P | paintedSteel | 176.74963021573785 | 50 | 46.27046789984706
C03:calce_cojinete_cabeza_1 | C03 |  | 1 | P | paintedSteel | 176.74963021573785 | 50 | 46.27046789984706
C03:capota_soporte_11700_-1 | C03 |  | 1 | P | paintedSteel | 70.10441581407213 | 205.41923503254202 | 240.1304841449446
C03:capota_soporte_11700_1 | C03 |  | 1 | P | paintedSteel | 70.10441581407213 | 205.41923503254202 | 240.1304841449446
C03:capota_soporte_11850_-1 | C03 |  | 1 | P | paintedSteel | 70.10441581406485 | 205.41923503254202 | 240.1304841449446
C03:capota_soporte_11850_1 | C03 |  | 1 | P | paintedSteel | 70.10441581406485 | 205.41923503254202 | 240.1304841449446
secador:R20-panel--1-0 | secador | r20-dryer-body | 1 | R | paintedSteel | 1000 | 75 | 2925
secador:R20-panel--1-1000 | secador | r20-dryer-body | 1 | R | paintedSteel | 1000 | 75 | 2925
secador:R20-panel--1-2000 | secador | r20-dryer-body | 1 | R | paintedSteel | 1000 | 75 | 2925
secador:R20-panel--1-3000 | secador | r20-dryer-body | 1 | R | paintedSteel | 1000 | 75 | 2925
secador:R20-panel--1-4000 | secador | r20-dryer-body | 1 | R | paintedSteel | 1000 | 75 | 2925
secador:R20-panel--1-5000 | secador | r20-dryer-body | 1 | R | paintedSteel | 200 | 75 | 2925
secador:R20-panel--1-5200-sill | secador | r20-dryer-body | 1 | R | paintedSteel | 600 | 75 | 75
secador:R20-panel--1-5200-head | secador | r20-dryer-body | 1 | R | paintedSteel | 600 | 75 | 2515
secador:R20-panel--1-5800 | secador | r20-dryer-body | 1 | R | paintedSteel | 175 | 75 | 2925
secador:R20-panel--1-5975 | secador | r20-dryer-body | 1 | R | paintedSteel | 25 | 75 | 2925
secador:R20-panel--1-6000 | secador | r20-dryer-body | 1 | R | paintedSteel | 425 | 75 | 2925
secador:R20-panel--1-6425 | secador | r20-dryer-body | 1 | R | paintedSteel | 575 | 75 | 2925
secador:R20-panel--1-7000 | secador | r20-dryer-body | 1 | R | paintedSteel | 1000 | 75 | 2925
secador:R20-panel--1-8000 | secador | r20-dryer-body | 1 | R | paintedSteel | 1000 | 75 | 2925
secador:R20-panel--1-9000 | secador | r20-dryer-body | 1 | R | paintedSteel | 775 | 75 | 2925
secador:R20-panel--1-9775 | secador | r20-dryer-body | 1 | R | paintedSteel | 225 | 75 | 2925
secador:R20-panel--1-10000 | secador | r20-dryer-body | 1 | R | paintedSteel | 225 | 75 | 2925
secador:R20-panel--1-10225 | secador | r20-dryer-body | 1 | R | paintedSteel | 775 | 75 | 2925
secador:R20-panel--1-11000 | secador | r20-dryer-body | 1 | R | paintedSteel | 1000 | 75 | 2925
secador:R20-panel--1-12000 | secador | r20-dryer-body | 1 | R | paintedSteel | 1000 | 75 | 2925
secador:R20-panel--1-13000 | secador | r20-dryer-body | 1 | R | paintedSteel | 575 | 75 | 2925
secador:R20-panel--1-13575 | secador | r20-dryer-body | 1 | R | paintedSteel | 425 | 75 | 2925
secador:R20-panel--1-14000 | secador | r20-dryer-body | 1 | R | paintedSteel | 25 | 75 | 2925
secador:R20-panel--1-14025 | secador | r20-dryer-body | 1 | R | paintedSteel | 475 | 75 | 2925
secador:R20-panel--1-14500-sill | secador | r20-dryer-body | 1 | R | paintedSteel | 500 | 75 | 75
secador:R20-panel--1-14500-head | secador | r20-dryer-body | 1 | R | paintedSteel | 500 | 75 | 2515
secador:R20-panel--1-15000-sill | secador | r20-dryer-body | 1 | R | paintedSteel | 100 | 75 | 75
secador:R20-panel--1-15000-head | secador | r20-dryer-body | 1 | R | paintedSteel | 100 | 75 | 2515
secador:R20-panel--1-15100 | secador | r20-dryer-body | 1 | R | paintedSteel | 900 | 75 | 2925
secador:R20-panel--1-16000 | secador | r20-dryer-body | 1 | R | paintedSteel | 1000 | 75 | 2925
secador:R20-panel--1-17000 | secador | r20-dryer-body | 1 | R | paintedSteel | 375 | 75 | 2925
secador:R20-panel--1-17375 | secador | r20-dryer-body | 1 | R | paintedSteel | 450 | 75 | 2925
secador:R20-panel--1-17825 | secador | r20-dryer-body | 1 | R | paintedSteel | 175 | 75 | 2925
secador:R20-panel--1-18000 | secador | r20-dryer-body | 1 | R | paintedSteel | 1000 | 75 | 2925
secador:R20-panel--1-19000 | secador | r20-dryer-body | 1 | R | paintedSteel | 1000 | 75 | 2925
secador:R20-panel-joint--1-1000 | secador | r20-dryer-body | 1 | R | paintedSteel | 6 | 3 | 2865
secador:R20-panel-joint--1-2000 | secador | r20-dryer-body | 1 | R | paintedSteel | 6 | 3 | 2865
secador:R20-panel-joint--1-3000 | secador | r20-dryer-body | 1 | R | paintedSteel | 6 | 3 | 2865
secador:R20-panel-joint--1-4000 | secador | r20-dryer-body | 1 | R | paintedSteel | 6 | 3 | 2865
secador:R20-panel-joint--1-5000 | secador | r20-dryer-body | 1 | R | paintedSteel | 6 | 3 | 2865
secador:R20-panel-joint--1-6000 | secador | r20-dryer-body | 1 | R | paintedSteel | 6 | 3 | 2865
secador:R20-panel-joint--1-7000 | secador | r20-dryer-body | 1 | R | paintedSteel | 6 | 3 | 2865
secador:R20-panel-joint--1-8000 | secador | r20-dryer-body | 1 | R | paintedSteel | 6 | 3 | 2865
secador:R20-panel-joint--1-9000 | secador | r20-dryer-body | 1 | R | paintedSteel | 6 | 3 | 2865
secador:R20-panel-joint--1-10000 | secador | r20-dryer-body | 1 | R | paintedSteel | 6 | 3 | 2865
secador:R20-panel-joint--1-11000 | secador | r20-dryer-body | 1 | R | paintedSteel | 6 | 3 | 2865
secador:R20-panel-joint--1-12000 | secador | r20-dryer-body | 1 | R | paintedSteel | 6 | 3 | 2865
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
secador:R20-roof-joint-14750 | secador | r20-dryer-body | 1 | R | paintedSteel | 4 | 2760 | 3
secador:R20-roof-15750 | secador | r20-dryer-body | 1 | R | paintedSteel | 1000 | 2800 | 75
secador:R20-roof-joint-15750 | secador | r20-dryer-body | 1 | R | paintedSteel | 4 | 2760 | 3
secador:R20-roof-16750 | secador | r20-dryer-body | 1 | R | paintedSteel | 1000 | 2800 | 75
secador:R20-roof-joint-16750 | secador | r20-dryer-body | 1 | R | paintedSteel | 4 | 2760 | 3
secador:R20-roof-17750 | secador | r20-dryer-body | 1 | R | paintedSteel | 1000 | 2800 | 75
secador:R20-roof-joint-17750 | secador | r20-dryer-body | 1 | R | paintedSteel | 4 | 2760 | 3
secador:R20-roof-18750 | secador | r20-dryer-body | 1 | R | paintedSteel | 1000 | 2800 | 75
secador:R20-roof-joint-18750 | secador | r20-dryer-body | 1 | R | paintedSteel | 4 | 2760 | 3
secador:R20-roof-19750 | secador | r20-dryer-body | 1 | R | paintedSteel | 250 | 2800 | 75
secador:R20-roof-joint-19750 | secador | r20-dryer-body | 1 | R | paintedSteel | 4 | 2760 | 3
secador:R20-entry-lower-panel | secador | r20-dryer-body | 1 | R | paintedSteel | 75 | 2800 | 2750
secador:R20-entry-cheek--1400 | secador | r20-dryer-body | 1 | R | paintedSteel | 75 | 150 | 250
secador:R20-entry-cheek-1250 | secador | r20-dryer-body | 1 | R | paintedSteel | 75 | 150 | 250
secador:R20-outlet-head-bottom | secador | r20-dryer-body | 1 | R | paintedSteel | 75 | 2800 | 900
secador:R20-outlet-head-upper | secador | r20-dryer-body | 1 | R | paintedSteel | 75 | 2800 | 1575
secador:R20-outlet-head-cheek--1400 | secador | r20-dryer-body | 1 | R | paintedSteel | 75 | 150 | 450
secador:R20-outlet-head-cheek-1250 | secador | r20-dryer-body | 1 | R | paintedSteel | 75 | 150 | 450
secador:R20-inspection-door-seal | secador | r20-dryer-inspection | 1 | P | paintedSteel | 5 | 870 | 1090
secador:R20-inspection-door | secador | r20-dryer-inspection | 1 | P | paintedSteel | 8 | 850 | 1070
secador:R20-inspection-hinge-1870 | secador | r20-dryer-inspection | 1 | P | paintedSteel | 26 | 26 | 115
secador:R20-inspection-hinge-leaf-1870 | secador | r20-dryer-inspection | 1 | P | paintedSteel | 18 | 65 | 70
secador:R20-inspection-hinge-2500 | secador | r20-dryer-inspection | 1 | P | paintedSteel | 26 | 26 | 115
secador:R20-inspection-hinge-leaf-2500 | secador | r20-dryer-inspection | 1 | P | paintedSteel | 18 | 65 | 70
secador:R20-inspection-handle-spindle | secador | r20-dryer-inspection | 1 | P | paintedSteel | 30 | 24 | 24
secador:R20-inspection-handle | secador | r20-dryer-inspection | 1 | P | paintedSteel | 14 | 28 | 100
secador:R20-foot-65--1295 | secador | r20-dryer-frame | 1 | R | galvanizedSteel | 120 | 160 | 20
secador:R20-RHS100x60x5-column-65--1295 | secador | r20-dryer-frame | 1 | R | galvanizedSteel | 100 | 60 | 2905
secador:R20-foot-anchor-65--1295--38 | secador | r20-dryer-fastener | 1 | R | machinedSteel | 14 | 12.124355652982103 | 10
secador:R20-foot-anchor-65--1295-38 | secador | r20-dryer-fastener | 1 | R | machinedSteel | 14 | 12.124355652982103 | 10
secador:R20-foot-65-1295 | secador | r20-dryer-frame | 1 | R | galvanizedSteel | 120 | 160 | 20
secador:R20-RHS100x60x5-column-65-1295 | secador | r20-dryer-frame | 1 | R | galvanizedSteel | 100 | 60 | 2905
secador:R20-foot-anchor-65-1295--38 | secador | r20-dryer-fastener | 1 | R | machinedSteel | 14 | 12.124355652982103 | 10
secador:R20-foot-anchor-65-1295-38 | secador | r20-dryer-fastener | 1 | R | machinedSteel | 14 | 12.124355652982103 | 10
secador:R20-RHS60x40x3-floor-cross-65 | secador | r20-dryer-frame | 1 | R | galvanizedSteel | 40 | 2530 | 60
secador:R20-L63x5-seat-65--1325-1366.5 | secador | r20-dryer-frame | 1 | R | galvanizedSteel | 130 | 63 | 63
secador:R20-L63x5-seat-65-1262-1366.5 | secador | r20-dryer-frame | 1 | R | galvanizedSteel | 130 | 63 | 63
secador:R20-L63x5-seat-65--1325-1926.5 | secador | r20-dryer-frame | 1 | R | galvanizedSteel | 130 | 63 | 63
secador:R20-L63x5-seat-65-1262-1926.5 | secador | r20-dryer-frame | 1 | R | galvanizedSteel | 130 | 63 | 63
secador:R20-L63x5-seat-65--1325-2486.5 | secador | r20-dryer-frame | 1 | R | galvanizedSteel | 130 | 63 | 63
secador:R20-L63x5-seat-65-1262-2486.5 | secador | r20-dryer-frame | 1 | R | galvanizedSteel | 130 | 63 | 63
secador:R20-foot-3000--1295 | secador | r20-dryer-frame | 1 | R | galvanizedSteel | 120 | 160 | 20
secador:R20-RHS100x60x5-column-3000--1295 | secador | r20-dryer-frame | 1 | R | galvanizedSteel | 100 | 60 | 2905
secador:R20-foot-anchor-3000--1295--38 | secador | r20-dryer-fastener | 1 | R | machinedSteel | 14 | 12.124355652982103 | 10
secador:R20-foot-anchor-3000--1295-38 | secador | r20-dryer-fastener | 1 | R | machinedSteel | 14 | 12.124355652982103 | 10
secador:R20-foot-3000-1295 | secador | r20-dryer-frame | 1 | R | galvanizedSteel | 120 | 160 | 20
secador:R20-RHS100x60x5-column-3000-1295 | secador | r20-dryer-frame | 1 | R | galvanizedSteel | 100 | 60 | 2905
secador:R20-foot-anchor-3000-1295--38 | secador | r20-dryer-fastener | 1 | R | machinedSteel | 14 | 12.124355652982103 | 10
secador:R20-foot-anchor-3000-1295-38 | secador | r20-dryer-fastener | 1 | R | machinedSteel | 14 | 12.124355652982103 | 10
secador:R20-RHS60x40x3-floor-cross-3000 | secador | r20-dryer-frame | 1 | R | galvanizedSteel | 40 | 2530 | 60
secador:R20-RHS60x40x3-roof-cross-3000 | secador | r20-dryer-frame | 1 | R | galvanizedSteel | 40 | 2530 | 60
secador:R20-L63x5-seat-3000--1325-1366.5 | secador | r20-dryer-frame | 1 | R | galvanizedSteel | 130 | 63 | 63
secador:R20-L63x5-seat-3000-1262-1366.5 | secador | r20-dryer-frame | 1 | R | galvanizedSteel | 130 | 63 | 63
secador:R20-L63x5-seat-3000--1325-1926.5 | secador | r20-dryer-frame | 1 | R | galvanizedSteel | 130 | 63 | 63
secador:R20-L63x5-seat-3000-1262-1926.5 | secador | r20-dryer-frame | 1 | R | galvanizedSteel | 130 | 63 | 63
secador:R20-L63x5-seat-3000--1325-2486.5 | secador | r20-dryer-frame | 1 | R | galvanizedSteel | 130 | 63 | 63
secador:R20-L63x5-seat-3000-1262-2486.5 | secador | r20-dryer-frame | 1 | R | galvanizedSteel | 130 | 63 | 63
secador:R20-foot-6000--1295 | secador | r20-dryer-frame | 1 | R | galvanizedSteel | 120 | 160 | 20
secador:R20-RHS100x60x5-column-6000--1295 | secador | r20-dryer-frame | 1 | R | galvanizedSteel | 100 | 60 | 2905
secador:R20-foot-anchor-6000--1295--38 | secador | r20-dryer-fastener | 1 | R | machinedSteel | 14 | 12.124355652982103 | 10
secador:R20-foot-anchor-6000--1295-38 | secador | r20-dryer-fastener | 1 | R | machinedSteel | 14 | 12.124355652982103 | 10
secador:R20-foot-6000-1295 | secador | r20-dryer-frame | 1 | R | galvanizedSteel | 120 | 160 | 20
secador:R20-RHS100x60x5-column-6000-1295 | secador | r20-dryer-frame | 1 | R | galvanizedSteel | 100 | 60 | 2905
secador:R20-foot-anchor-6000-1295--38 | secador | r20-dryer-fastener | 1 | R | machinedSteel | 14 | 12.124355652982103 | 10
secador:R20-foot-anchor-6000-1295-38 | secador | r20-dryer-fastener | 1 | R | machinedSteel | 14 | 12.124355652982103 | 10
secador:R20-RHS60x40x3-floor-cross-6000 | secador | r20-dryer-frame | 1 | R | galvanizedSteel | 40 | 2530 | 60
secador:R20-RHS60x40x3-roof-cross-6000 | secador | r20-dryer-frame | 1 | R | galvanizedSteel | 40 | 2530 | 60
secador:R20-L63x5-seat-6000--1325-1366.5 | secador | r20-dryer-frame | 1 | R | galvanizedSteel | 130 | 63 | 63
secador:R20-L63x5-seat-6000-1262-1366.5 | secador | r20-dryer-frame | 1 | R | galvanizedSteel | 130 | 63 | 63
secador:R20-L63x5-seat-6000--1325-1926.5 | secador | r20-dryer-frame | 1 | R | galvanizedSteel | 130 | 63 | 63
secador:R20-L63x5-seat-6000-1262-1926.5 | secador | r20-dryer-frame | 1 | R | galvanizedSteel | 130 | 63 | 63
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
secador:R20-L63x5-seat-18000-1262-1926.5 | secador | r20-dryer-frame | 1 | R | galvanizedSteel | 130 | 63 | 63
secador:R20-L63x5-seat-18000--1325-2486.5 | secador | r20-dryer-frame | 1 | R | galvanizedSteel | 130 | 63 | 63
secador:R20-L63x5-seat-18000-1262-2486.5 | secador | r20-dryer-frame | 1 | R | galvanizedSteel | 130 | 63 | 63
secador:R20-foot-19935--1295 | secador | r20-dryer-frame | 1 | R | galvanizedSteel | 120 | 160 | 20
secador:R20-RHS100x60x5-column-19935--1295 | secador | r20-dryer-frame | 1 | R | galvanizedSteel | 100 | 60 | 2905
secador:R20-foot-anchor-19935--1295--38 | secador | r20-dryer-fastener | 1 | R | machinedSteel | 14 | 12.124355652982103 | 10
secador:R20-foot-anchor-19935--1295-38 | secador | r20-dryer-fastener | 1 | R | machinedSteel | 14 | 12.124355652982103 | 10
secador:R20-foot-19935-1295 | secador | r20-dryer-frame | 1 | R | galvanizedSteel | 120 | 160 | 20
secador:R20-RHS100x60x5-column-19935-1295 | secador | r20-dryer-frame | 1 | R | galvanizedSteel | 100 | 60 | 2905
secador:R20-foot-anchor-19935-1295--38 | secador | r20-dryer-fastener | 1 | R | machinedSteel | 14 | 12.124355652982103 | 10
secador:R20-foot-anchor-19935-1295-38 | secador | r20-dryer-fastener | 1 | R | machinedSteel | 14 | 12.124355652982103 | 10
secador:R20-RHS60x40x3-floor-cross-19935 | secador | r20-dryer-frame | 1 | R | galvanizedSteel | 40 | 2530 | 60
secador:R20-RHS60x40x3-roof-cross-19935 | secador | r20-dryer-frame | 1 | R | galvanizedSteel | 40 | 2530 | 60
secador:R20-L63x5-seat-19935--1325-1366.5 | secador | r20-dryer-frame | 1 | R | galvanizedSteel | 130 | 63 | 63
secador:R20-L63x5-seat-19935-1262-1366.5 | secador | r20-dryer-frame | 1 | R | galvanizedSteel | 130 | 63 | 63
secador:R20-L63x5-seat-19935--1325-1926.5 | secador | r20-dryer-frame | 1 | R | galvanizedSteel | 130 | 63 | 63
secador:R20-L63x5-seat-19935-1262-1926.5 | secador | r20-dryer-frame | 1 | R | galvanizedSteel | 130 | 63 | 63
secador:R20-L63x5-seat-19935--1325-2486.5 | secador | r20-dryer-frame | 1 | R | galvanizedSteel | 130 | 63 | 63
secador:R20-L63x5-seat-19935-1262-2486.5 | secador | r20-dryer-frame | 1 | R | galvanizedSteel | 130 | 63 | 63
secador:R20-RHS100x60x5-longitudinal--1325-20 | secador | r20-dryer-frame | 1 | R | galvanizedSteel | 20000 | 60 | 100
secador:R20-RHS100x60x5-longitudinal--1325-2825 | secador | r20-dryer-frame | 1 | R | galvanizedSteel | 20000 | 60 | 100
secador:R20-RHS100x60x5-longitudinal-1265-20 | secador | r20-dryer-frame | 1 | R | galvanizedSteel | 20000 | 60 | 100
secador:R20-RHS100x60x5-longitudinal-1265-2825 | secador | r20-dryer-frame | 1 | R | galvanizedSteel | 20000 | 60 | 100
secador:R20-corner-cover-0--1400 | secador | r20-dryer-body | 1 | R | paintedSteel | 75 | 60 | 3000
secador:R20-corner-cover-0-1340 | secador | r20-dryer-body | 1 | R | paintedSteel | 75 | 60 | 3000
secador:R20-corner-cover-19925--1400 | secador | r20-dryer-body | 1 | R | paintedSteel | 75 | 60 | 3000
secador:R20-corner-cover-19925-1340 | secador | r20-dryer-body | 1 | R | paintedSteel | 75 | 60 | 3000
secador:R20-entry-port-sill-RHS100x60x5 | secador | r20-dryer-frame | 1 | R | galvanizedSteel | 100 | 2500 | 100
secador:R20-entry-port-jamb--1325 | secador | r20-dryer-frame | 1 | R | galvanizedSteel | 100 | 75 | 275
secador:R20-entry-port-jamb-1250 | secador | r20-dryer-frame | 1 | R | galvanizedSteel | 100 | 75 | 275
secador:R20-outlet-port-RHS100x60x5-800 | secador | r20-dryer-frame | 1 | R | galvanizedSteel | 100 | 2500 | 100
secador:R20-outlet-port-RHS100x60x5-1350 | secador | r20-dryer-frame | 1 | R | galvanizedSteel | 100 | 2500 | 100
secador:R20-outlet-port-jamb--1325 | secador | r20-dryer-frame | 1 | R | galvanizedSteel | 100 | 75 | 650
secador:R20-outlet-port-jamb-1250 | secador | r20-dryer-frame | 1 | R | galvanizedSteel | 100 | 75 | 650
secador:R20-fan-1-base-rail-1740 | secador | r20-dryer-fan | 1 | R | galvanizedSteel | 1490 | 100 | 100
secador:R20-fan-1-base-rail-2500 | secador | r20-dryer-fan | 1 | R | galvanizedSteel | 1490 | 100 | 100
secador:R20-fan-1-foot-5760 | secador | r20-dryer-fan | 1 | R | galvanizedSteel | 160 | 980 | 35
secador:R20-fan-1-cross-5760 | secador | r20-dryer-fan | 1 | R | galvanizedSteel | 80 | 860 | 80
secador:R20-fan-1-foot-7050 | secador | r20-dryer-fan | 1 | R | galvanizedSteel | 160 | 980 | 35
secador:R20-fan-1-cross-7050 | secador | r20-dryer-fan | 1 | R | galvanizedSteel | 80 | 860 | 80
secador:R20-fan-1-volute | secador | r20-dryer-fan | 1 | R | paintedSteel | 871.0244140625 | 470 | 965.7537841796875
secador:R20-fan-1-side-cover | secador | r20-dryer-fan | 1 | R | paintedSteel | 871.0244140625 | 6 | 965.7537841796875
secador:R20-fan-1-intake-flange | secador | r20-dryer-fan | 1 | R | machinedSteel | 556 | 25 | 556
secador:R20-fan-1-bearing-ring | secador | r20-dryer-fan | 1 | R | machinedSteel | 272 | 20 | 272
secador:R20-fan-1-shaft | secador | r20-dryer-fan | 1 | R | machinedSteel | 72 | 175 | 72
secador:R20-fan-1-volute-leg--240 | secador | r20-dryer-fan | 1 | R | galvanizedSteel | 70 | 70 | 480
secador:R20-fan-1-volute-seat--240 | secador | r20-dryer-fan | 1 | R | galvanizedSteel | 160 | 470 | 16
secador:R20-fan-1-volute-leg-240 | secador | r20-dryer-fan | 1 | R | galvanizedSteel | 70 | 70 | 480
secador:R20-fan-1-volute-seat-240 | secador | r20-dryer-fan | 1 | R | galvanizedSteel | 160 | 470 | 16
secador:R20-fan-1-body-duct | secador | r20-dryer-fan | 1 | R | paintedSteel | 450 | 390 | 390
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
