acevedocrisologopablo48-lgtm/planta-briquetadora/r19/BOM_R19.csv

id | owner | qty | kind | designation | material | sourceClass | sizeX | sizeY | sizeZ | modes | scope | lengthMm | unitMassKg | note | widthMm | heightMm | thicknessMm | holes
tolva:r11-cuerpo-0--1 | tolva | 1 | body | tolva:r11-cuerpo-0--1 | galvanizedSteel | R | 8 | 3450 | 900 | PROVISIONAL|SECADOR | Pieza modelada; conservar suministro OEM cuando corresponda
tolva:r11-coronacion-0--1 | tolva | 1 | body | tolva:r11-coronacion-0--1 | paintedSteel | R | 6 | 3450 | 1000 | PROVISIONAL|SECADOR | Pieza modelada; conservar suministro OEM cuando corresponda
tolva:r11-cono-0--1 | tolva | 1 | body | tolva:r11-cono-0--1 | galvanizedSteel | R | 1329.1349527922714 | 3450 | 806.8485155621995 | PROVISIONAL|SECADOR | Pieza modelada; conservar suministro OEM cuando corresponda
tolva:r11-rim-0--1 | tolva | 1 | body | tolva:r11-rim-0--1 | paintedSteel | R | 40 | 3450 | 30 | PROVISIONAL|SECADOR | Pieza modelada; conservar suministro OEM cuando corresponda
tolva:r11-rigidizador-0--1--1150 | tolva | 1 | support | tolva:r11-rigidizador-0--1--1150 | paintedSteel | P | 35 | 35 | 970 | PROVISIONAL|SECADOR | Pieza modelada; conservar suministro OEM cuando corresponda
tolva:r11-perno-coronacion-0--1--1150-3375 | tolva | 1 | body | tolva:r11-perno-coronacion-0--1--1150-3375 | machinedSteel | R | 12 | 28 | 24.248711305964207 | PROVISIONAL|SECADOR | Pieza modelada; conservar suministro OEM cuando corresponda
tolva:r11-perno-coronacion-0--1--1150-3525 | tolva | 1 | body | tolva:r11-perno-coronacion-0--1--1150-3525 | machinedSteel | R | 12 | 28 | 24.248711305964207 | PROVISIONAL|SECADOR | Pieza modelada; conservar suministro OEM cuando corresponda
tolva:r11-rigidizador-0--1-0 | tolva | 1 | support | tolva:r11-rigidizador-0--1-0 | paintedSteel | P | 35 | 35 | 970 | PROVISIONAL|SECADOR | Pieza modelada; conservar suministro OEM cuando corresponda
tolva:r11-perno-coronacion-0--1-0-3375 | tolva | 1 | body | tolva:r11-perno-coronacion-0--1-0-3375 | machinedSteel | R | 12 | 28 | 24.248711305964207 | PROVISIONAL|SECADOR | Pieza modelada; conservar suministro OEM cuando corresponda
tolva:r11-perno-coronacion-0--1-0-3525 | tolva | 1 | body | tolva:r11-perno-coronacion-0--1-0-3525 | machinedSteel | R | 12 | 28 | 24.248711305964207 | PROVISIONAL|SECADOR | Pieza modelada; conservar suministro OEM cuando corresponda
tolva:r11-rigidizador-0--1-1150 | tolva | 1 | support | tolva:r11-rigidizador-0--1-1150 | paintedSteel | P | 35 | 35 | 970 | PROVISIONAL|SECADOR | Pieza modelada; conservar suministro OEM cuando corresponda
tolva:r11-perno-coronacion-0--1-1150-3375 | tolva | 1 | body | tolva:r11-perno-coronacion-0--1-1150-3375 | machinedSteel | R | 12 | 28 | 24.248711305964207 | PROVISIONAL|SECADOR | Pieza modelada; conservar suministro OEM cuando corresponda
tolva:r11-perno-coronacion-0--1-1150-3525 | tolva | 1 | body | tolva:r11-perno-coronacion-0--1-1150-3525 | machinedSteel | R | 12 | 28 | 24.248711305964207 | PROVISIONAL|SECADOR | Pieza modelada; conservar suministro OEM cuando corresponda
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
