acevedocrisologopablo48-lgtm/planta-briquetadora/(list of files, cad)

Other CAD files:
r17/TALLER_R17.dxf
r18/PLANTA_R18.dwg
r19/PLANTA_R19.dwg
r20/PLANTA_R20.dwg
r21/PLANTA_R21_PROVISIONAL.dwg
r22/PLANTA_R22.dxf
r23/PLANTA_R23.dxf
r24/PLANTA_R24.dxf
r25/PLANTA_R25.dxf
r18/TALLER_R18.dxf
r19/PLANTA_R19_SECADOR.dwg
r20/PLANTA_R20_PROVISIONAL.dwg
r21/PLANTA_R21.dwg
r22/PLANTA_R22_PROVISIONAL.dwg
r18/TALLER_R18.dwg
r22/PLANTA_R22.dwg
