acevedocrisologopablo48-lgtm/planta-briquetadora/r33/PLANTA_R33.pdf

# SESUVECA / PLANTA BRIQUETADORA

## DISPOSICION GENERAL / APOYOS H / SEPARACION Y RETORNO

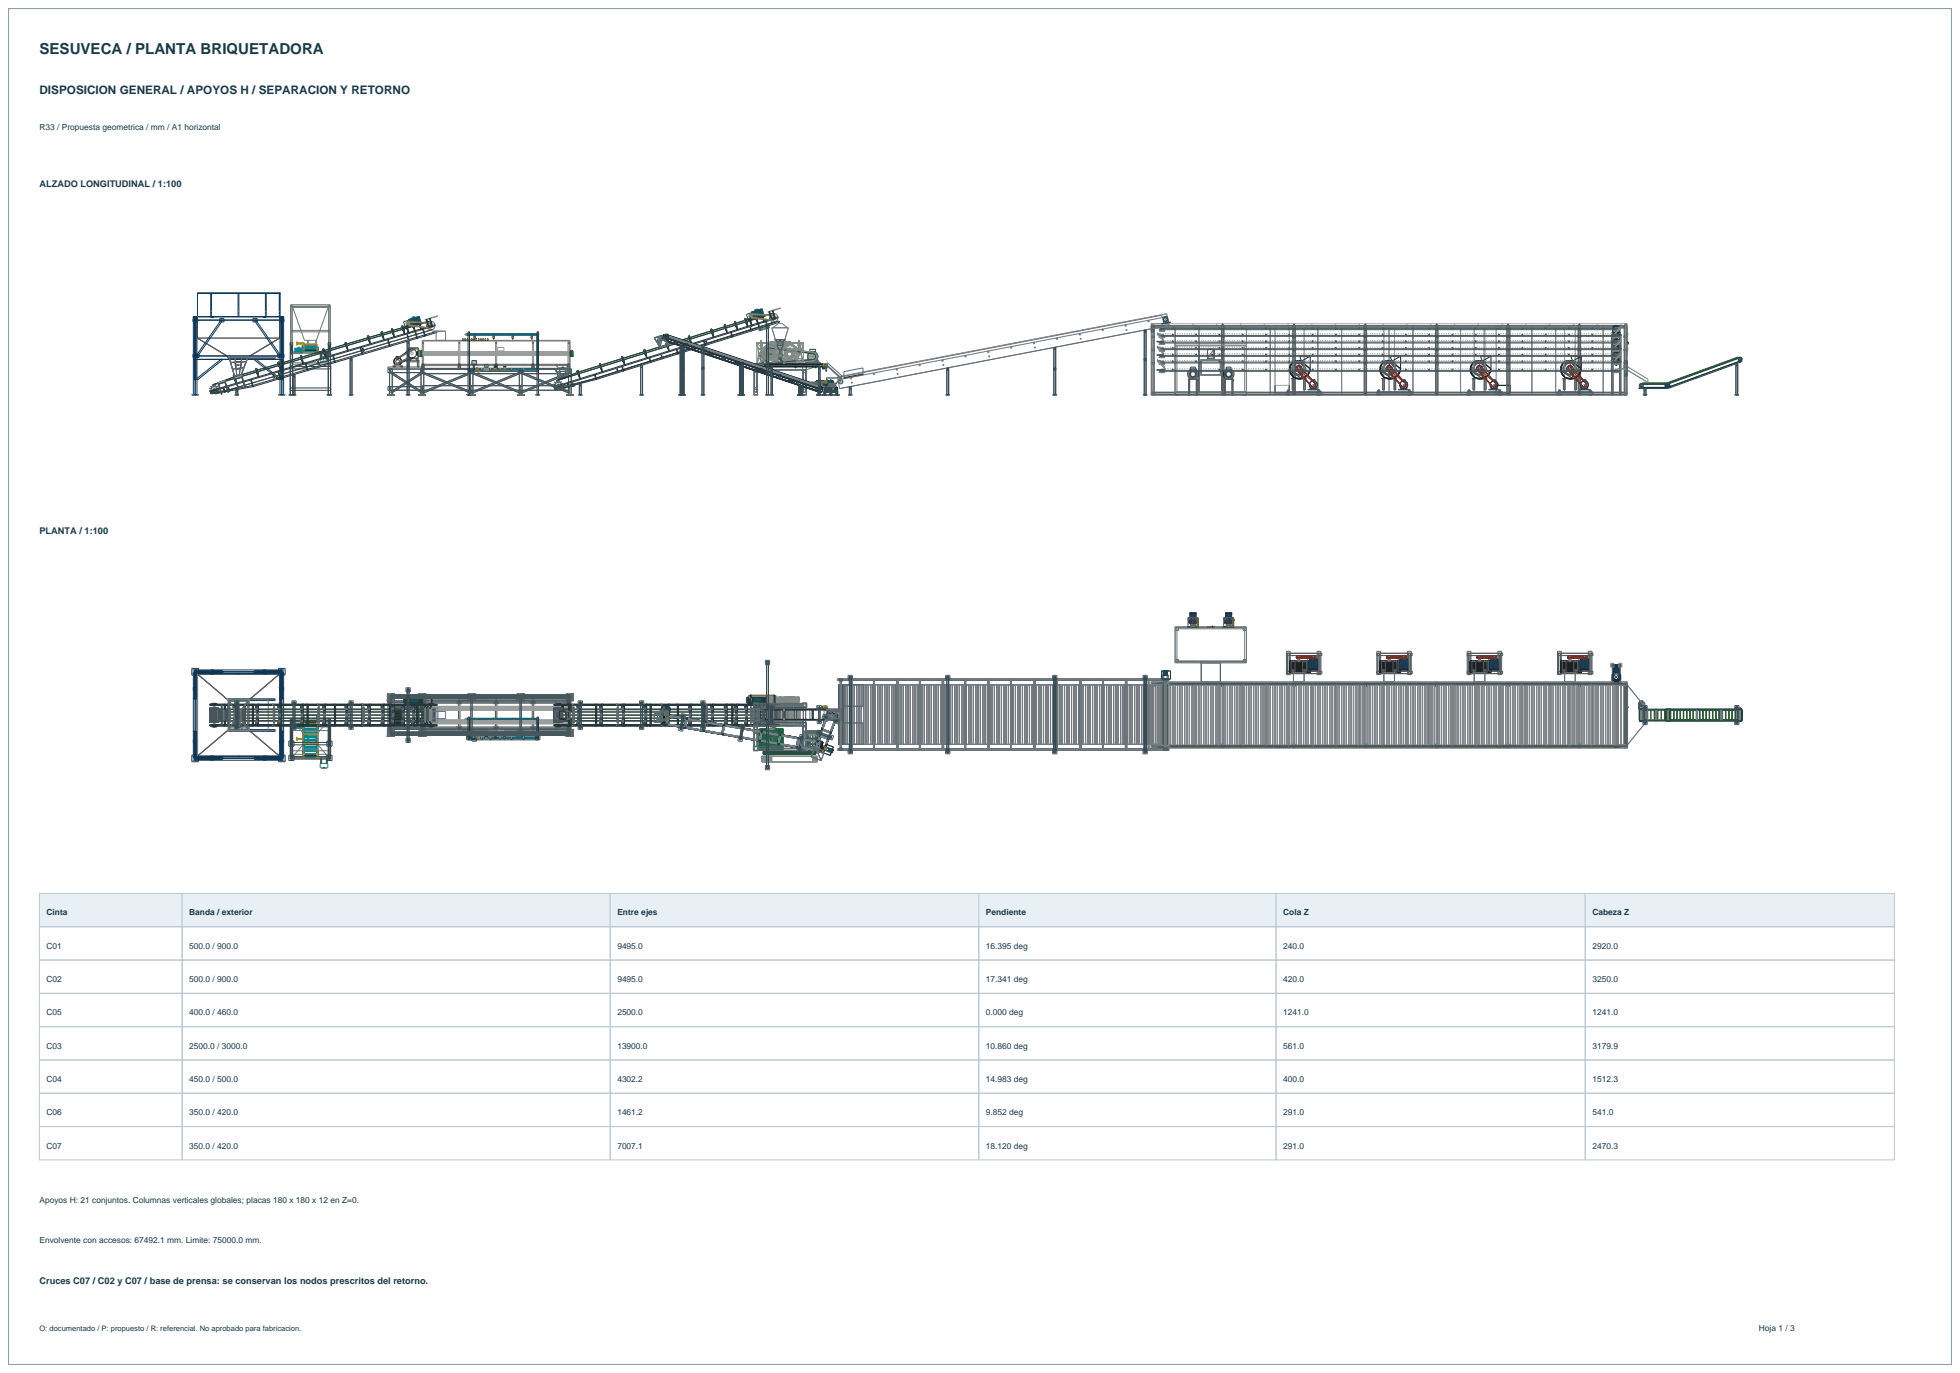
[picture p89: page 1]

R33 / Propuesta geometrica / mm / A1 horizontal

Apoyos H: 21 conjuntos. Columnas verticales globales; placas 180 x 180 x 12 en Z=0.

Envolvente con accesos: 67492.1 mm. Limite: 75000.0 mm.

Cruces C07 / C02 y C07 / base de prensa: se conservan los nodos prescritos del retorno.

## GRIZZLY Y BANDEJA RECEPTORA EN COLA DE C03

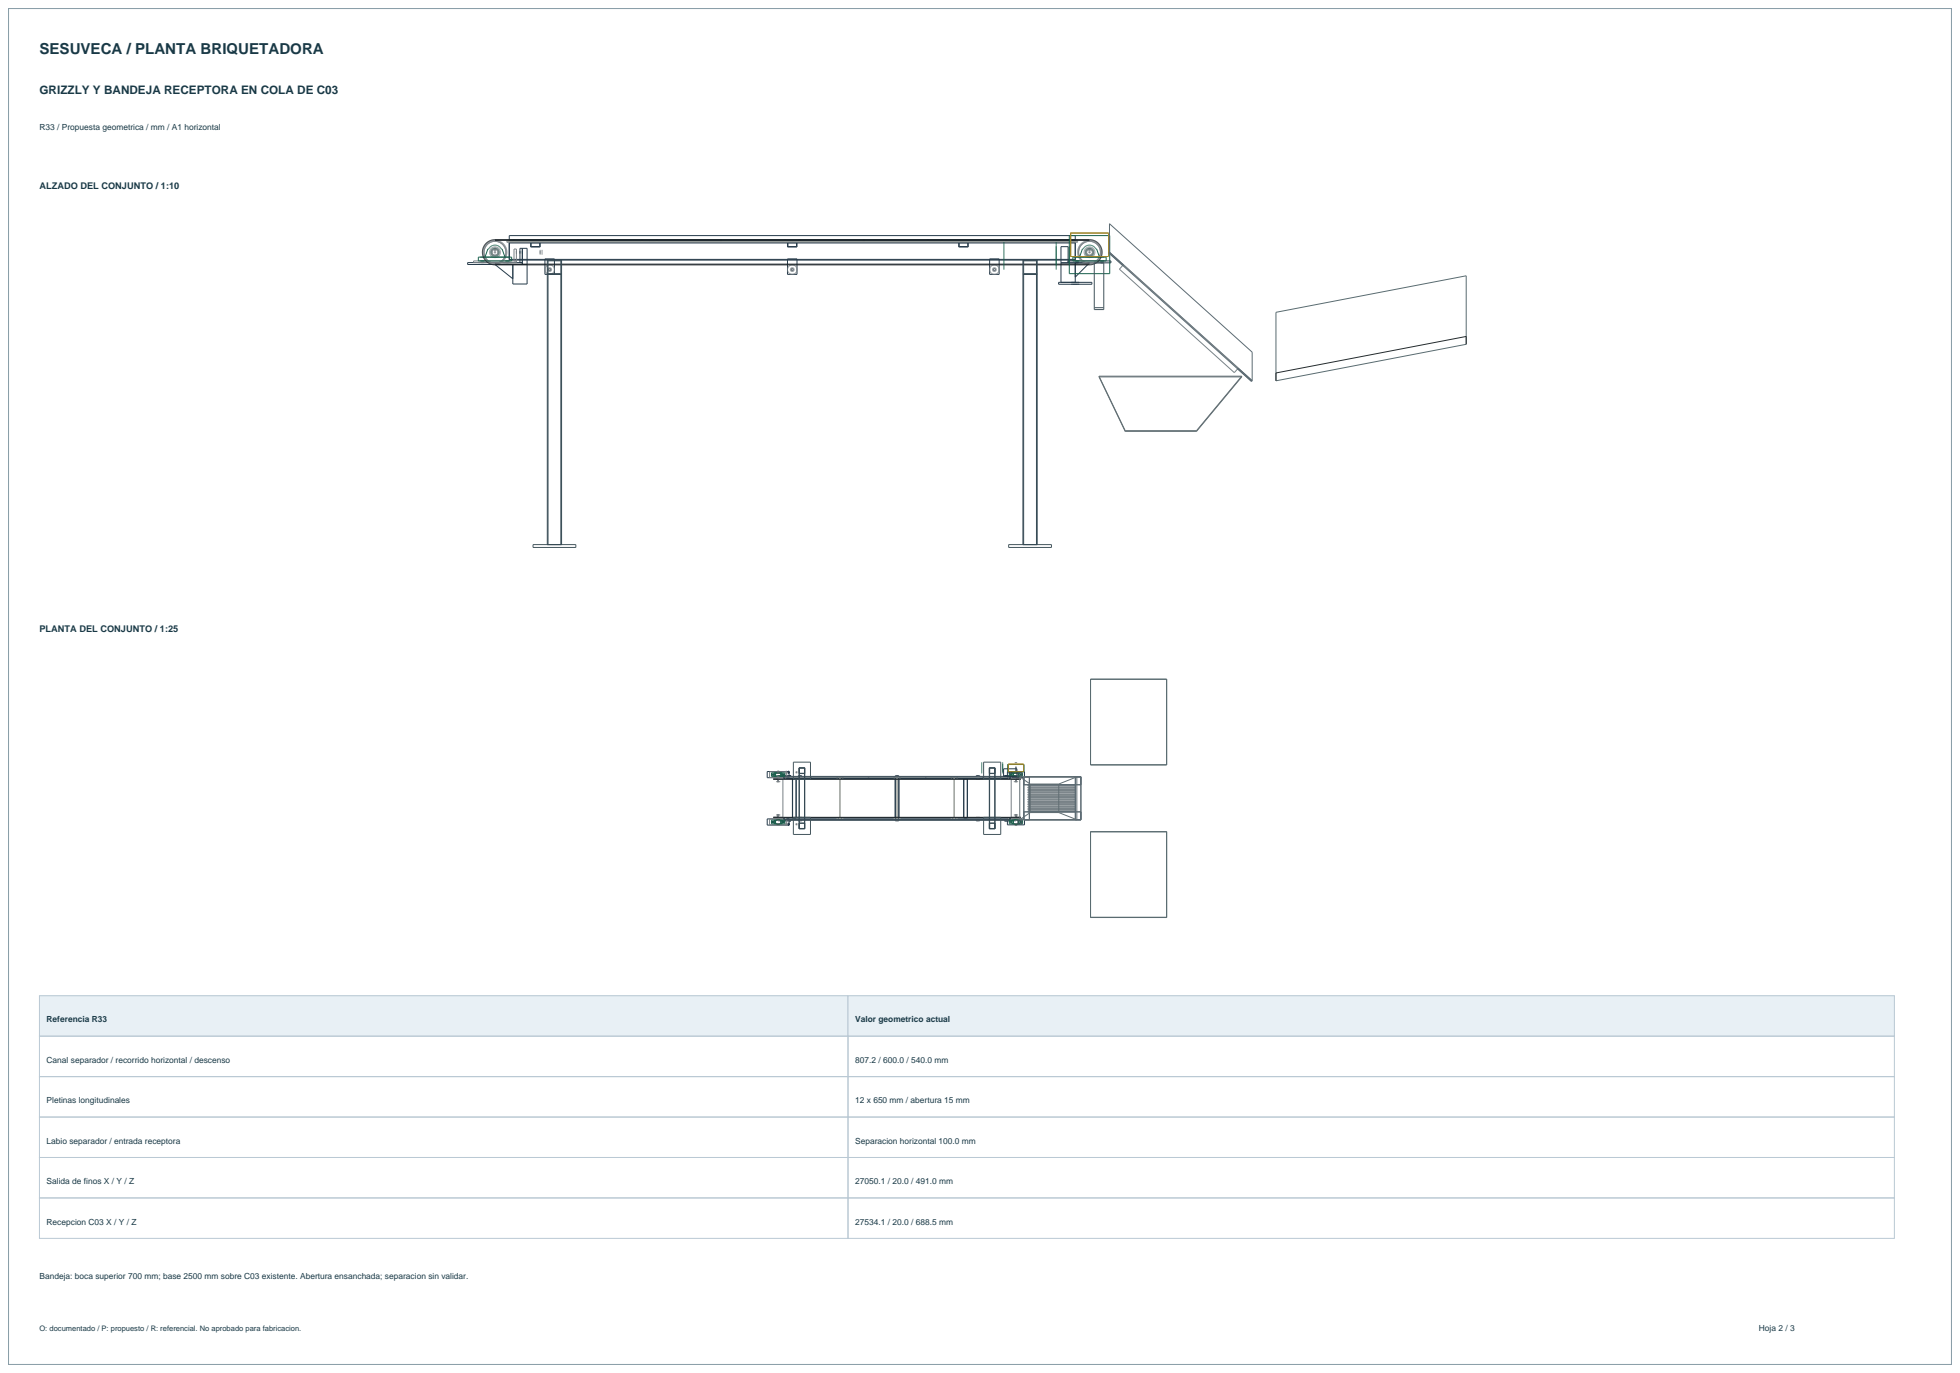
[picture p90: page 2]

R33 / Propuesta geometrica / mm / A1 horizontal

Bandeja: boca superior 700 mm; base 2500 mm sobre C03 existente. Abertura ensanchada; separacion sin validar.

## FINOS C06 / C07 / RETORNO AL CENTRO DE C02

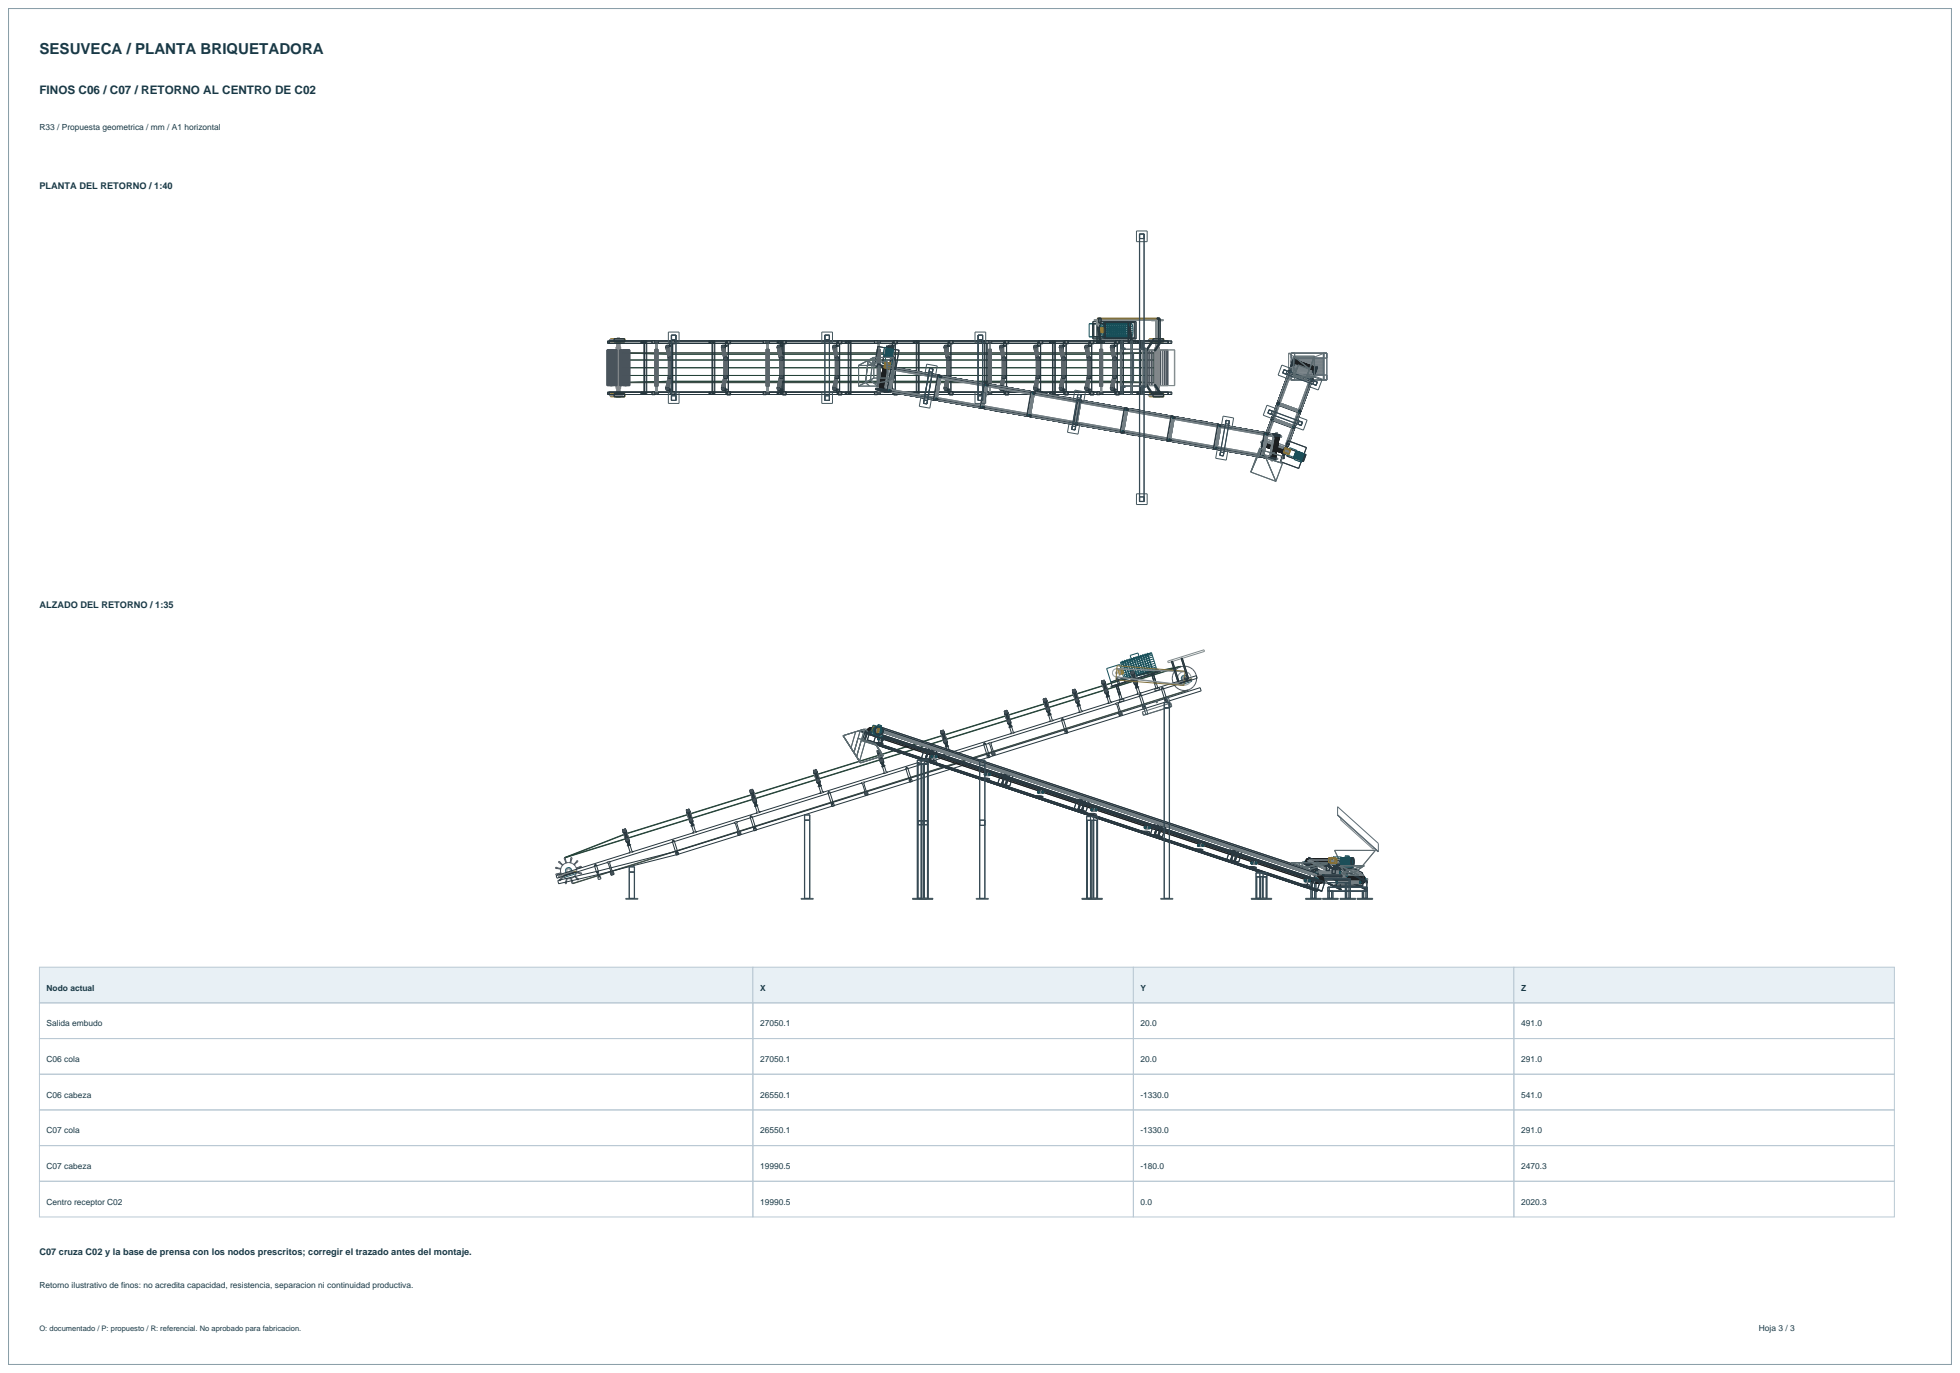
[picture p91: page 3]

R33 / Propuesta geometrica / mm / A1 horizontal

C07 cruza C02 y la base de prensa con los nodos prescritos; corregir el trazado antes del montaje.

Retorno ilustrativo de finos: no acredita capacidad, resistencia, separacion ni continuidad productiva.
