acevedocrisologopablo48-lgtm/planta-briquetadora/r25/PLANTA_R25.pdf

SESUVECA | PLANTA BRIQUETADORA

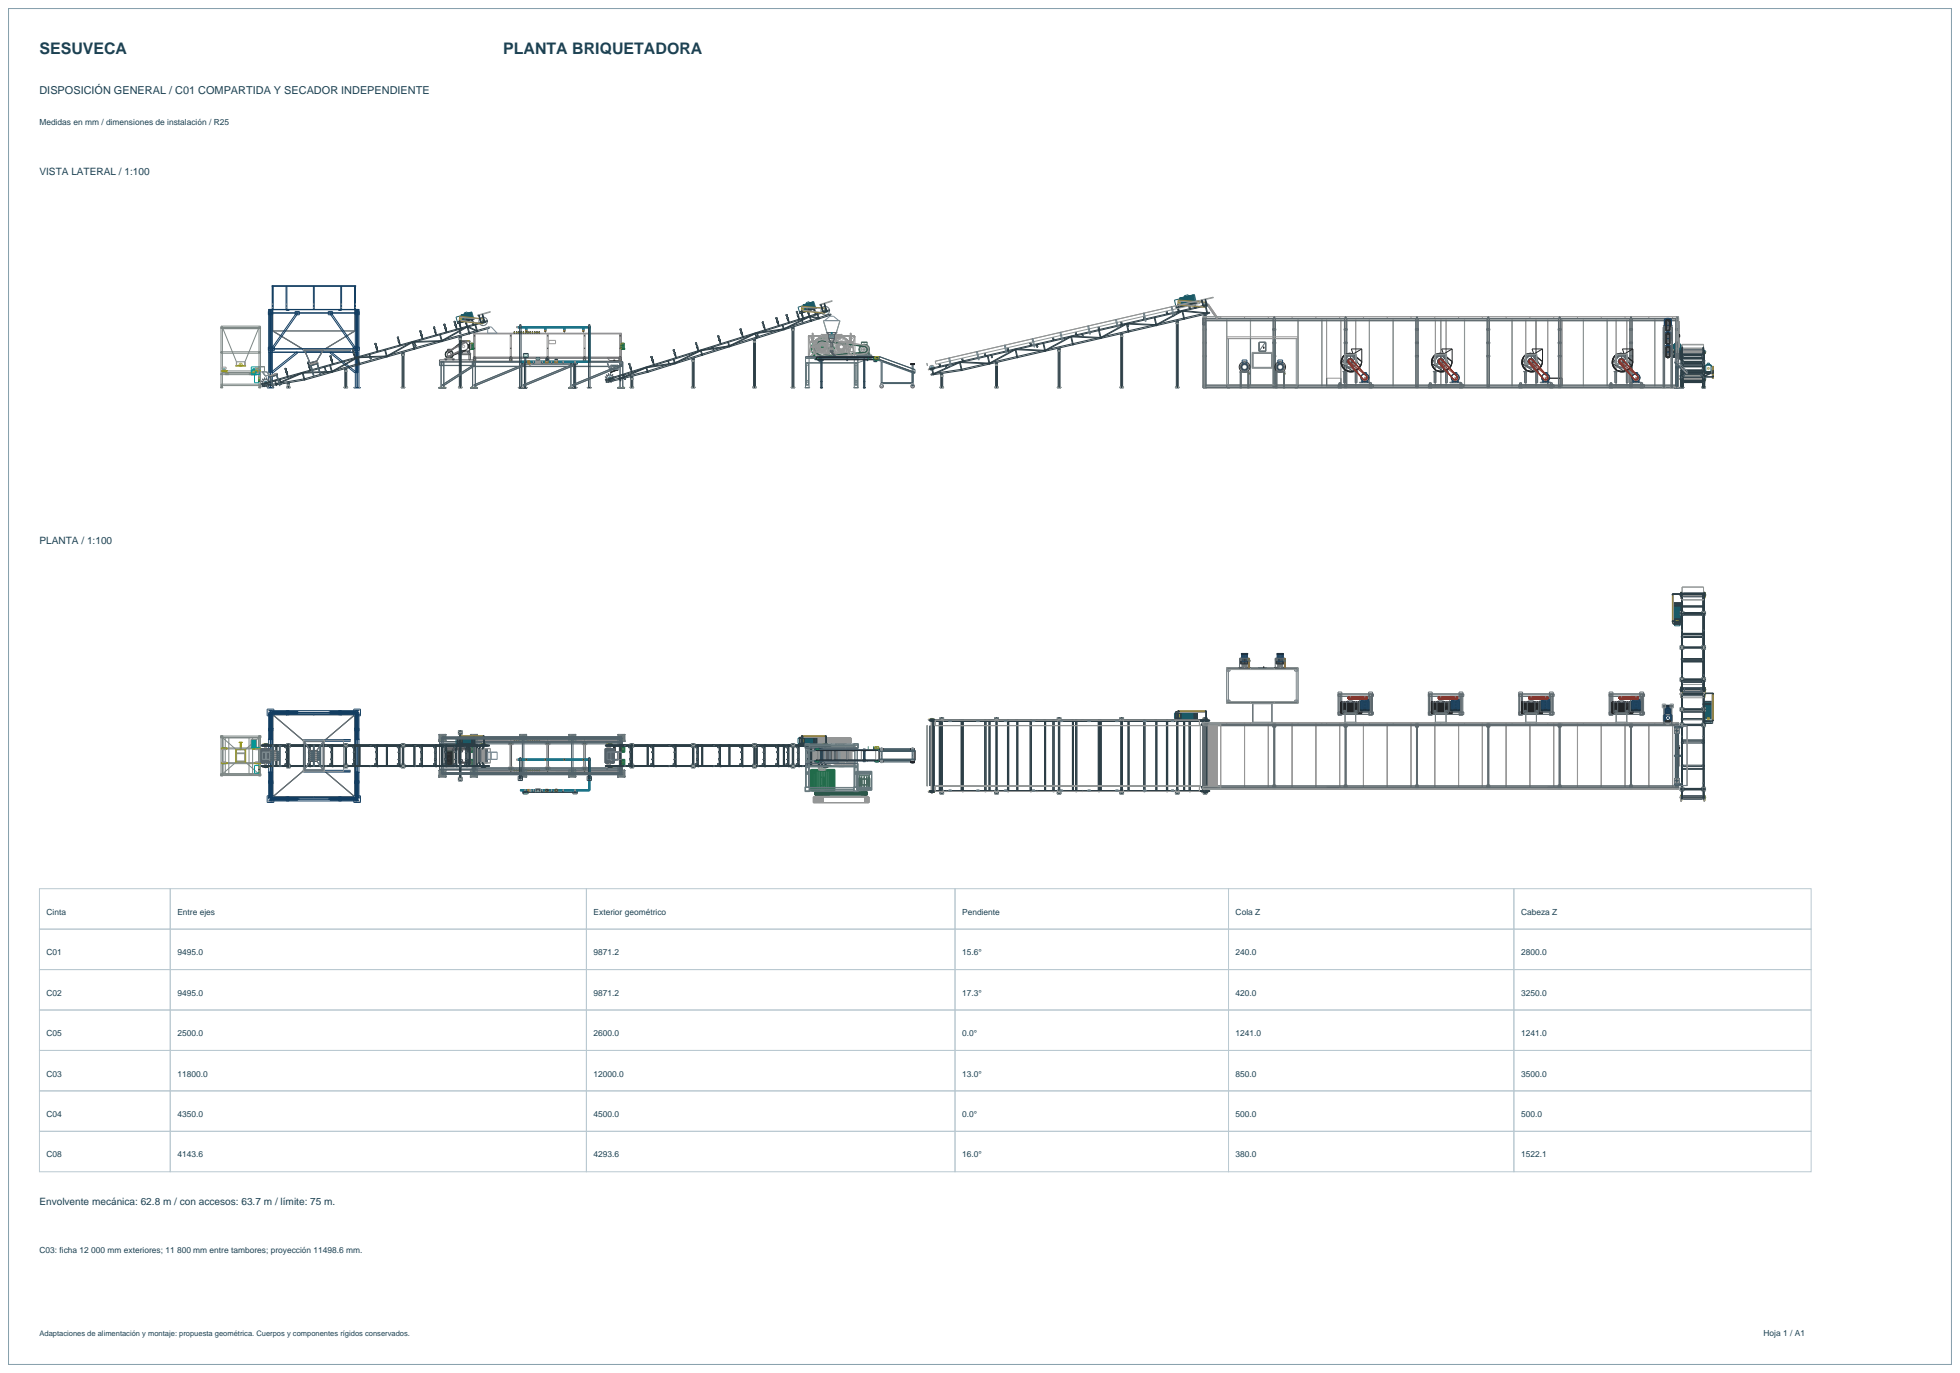
[picture p92: page 1]

DISPOSICIÓN GENERAL / C01 COMPARTIDA Y SECADOR INDEPENDIENTE

Medidas en mm / dimensiones de instalación / R25

Envolvente mecánica: 62.8 m / con accesos: 63.7 m / límite: 75 m.

C03: ficha 12 000 mm exteriores; 11 800 mm entre tambores; proyección 11498.6 mm.

CONJUNTOS MODIFICADOS / ALTURAS DESDE EL PISO

Medidas en mm / dimensiones de instalación / R25

Adaptaciones de alimentación y montaje: propuesta geométrica. Cuerpos y componentes rígidos conservados. | Hoja 2 / A1

BRIQUETADORA Y COLECTORA / LATERAL / 1:20

2330

2830

2500

COLECTORA PLANA / PLANTA / 1:10

B400

Tambores Ø100 / banda plana de 3 mm.

Superficie de carga: 1294.0 mm.

Labio de recepción: 1302.0 mm / separación: 8 mm.

Sólidos del conjunto de taller; soportes independientes.

MEZCLADORA / FRENTE / 1:20

Mezcladora: cuerpo 6200 × 1300 × 1200 mm.

Bancada mezcladora: 1100 mm; entrada directa.

Se retiran la tolva añadida y sus apoyos.

Dosificador: bancada 0 mm / altura total 2600 mm.

Aglomerante sobre C01 antes del carbón.

Agua conectada al cuerpo de mezcla.

BAJANTE MÓVIL / SECADOR INDEPENDIENTE

Medidas en mm / dimensiones de instalación / R25

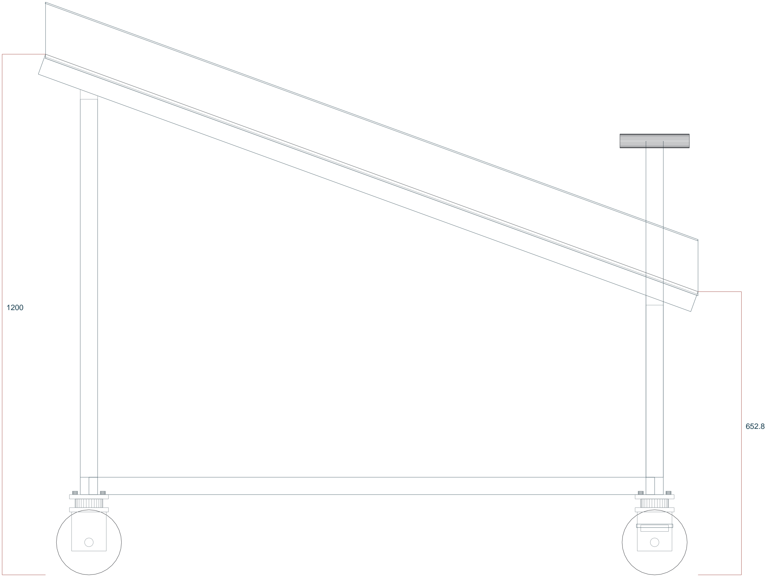
[picture p93: figure]
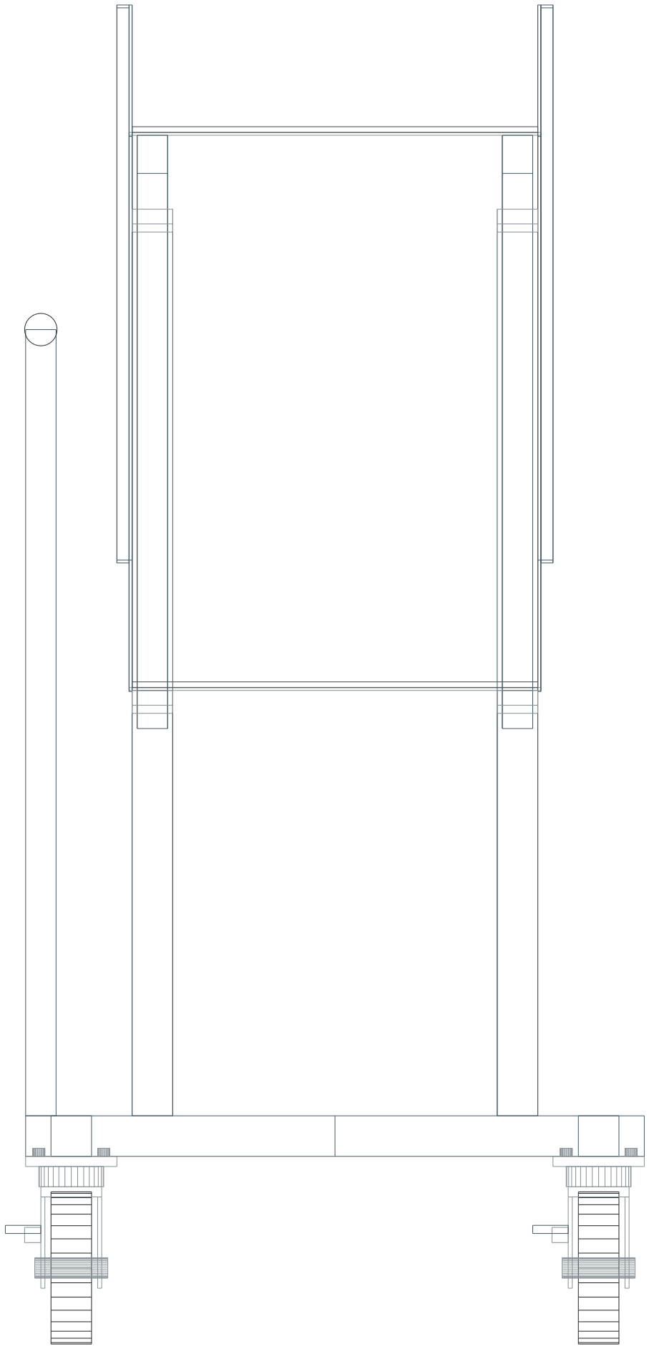
[picture p94: figure]

Adaptaciones de alimentación y montaje: propuesta geométrica. Cuerpos y componentes rígidos conservados. | Hoja 3 / A1

LATERAL / 1:5

FRENTE / 1:5

Canal útil:400 mm / longitud1600 mm / plano20 grados.

Chapa 3 mm + revestimiento UHMW 6 mm.

Cuatro ruedas de 150 mm; dos con freno.

El conjunto se retira o desplaza independientemente.

No existe unión directa entre C05 y el alimentador del secador.

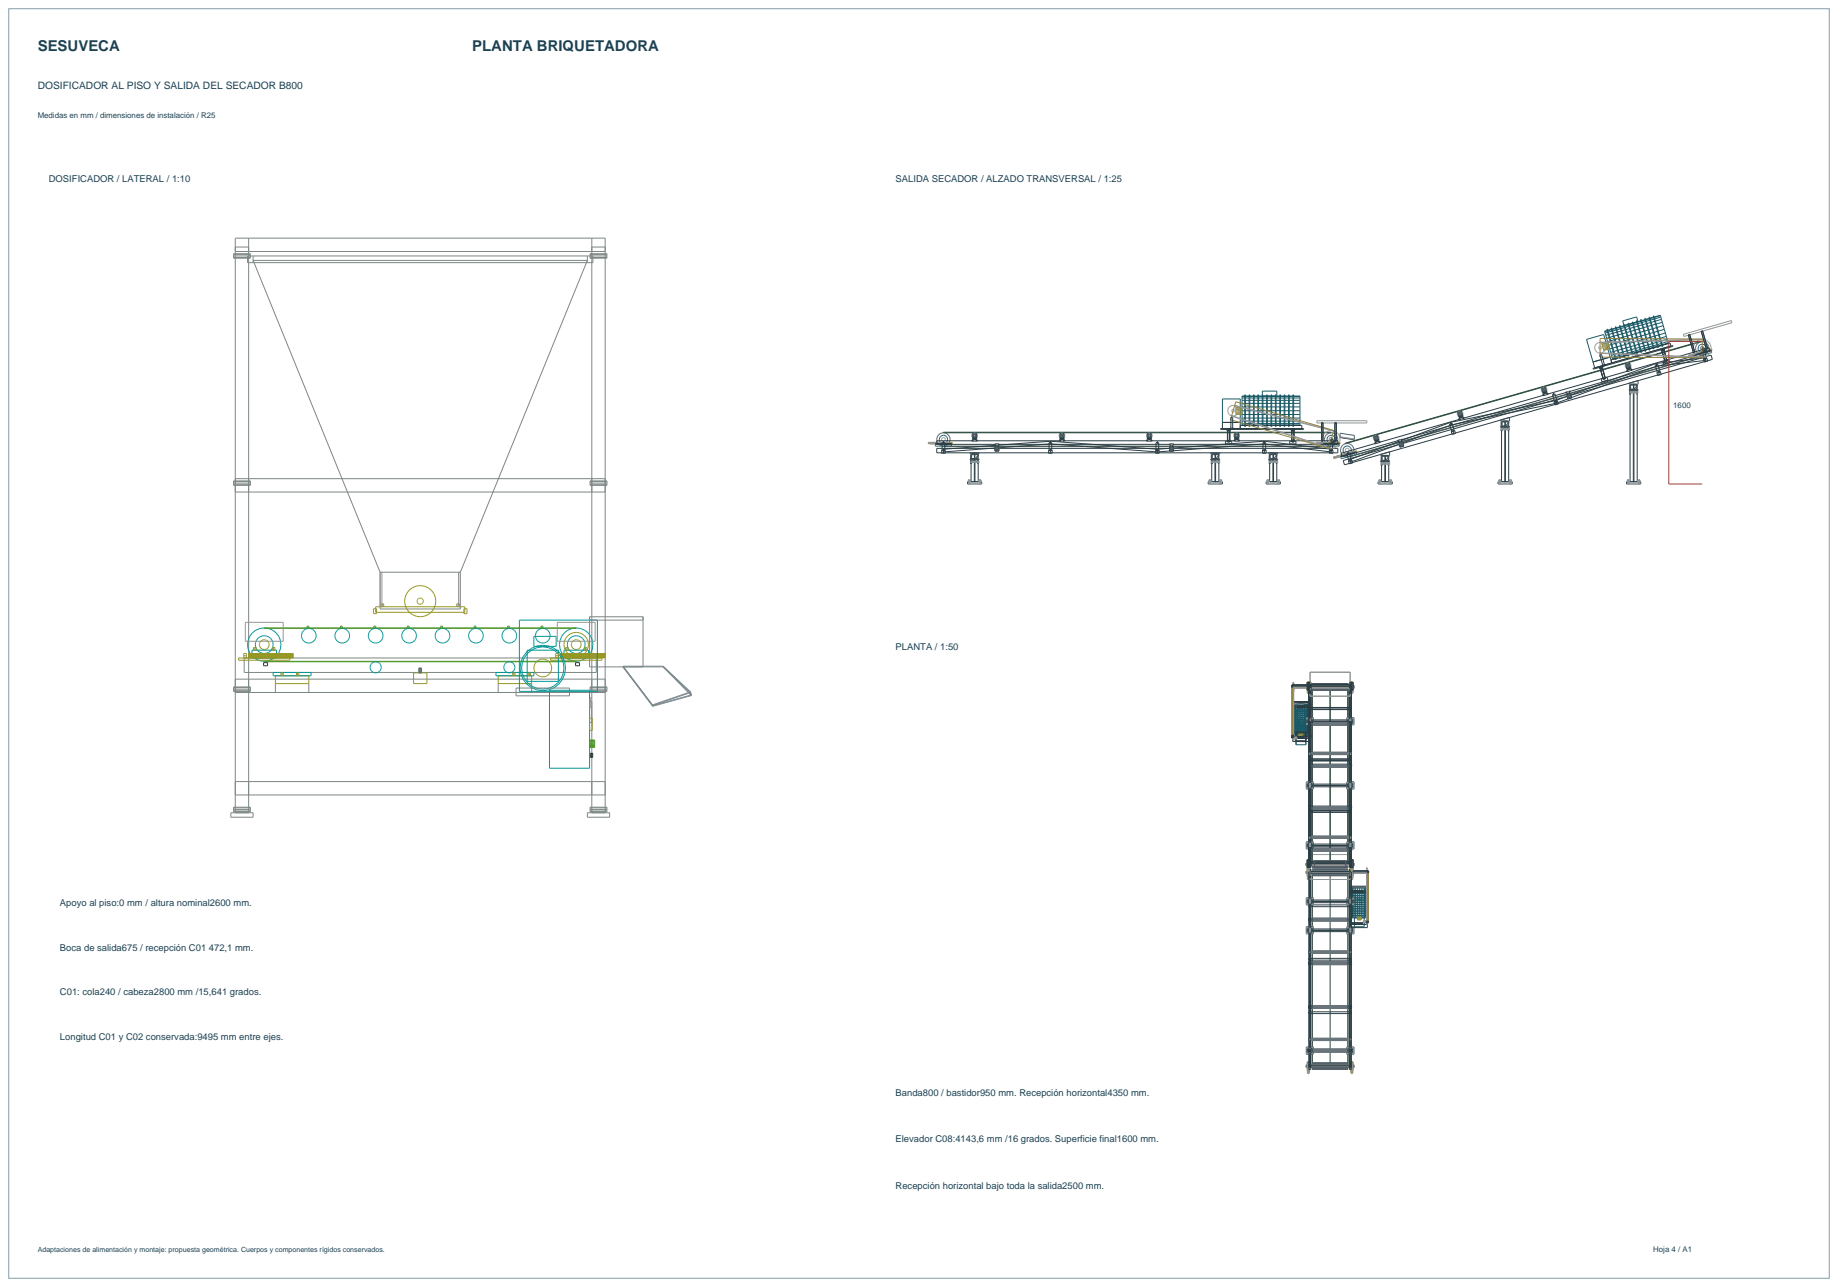
[picture p95: page 4]

DOSIFICADOR AL PISO Y SALIDA DEL SECADOR B800

Medidas en mm / dimensiones de instalación / R25

SALIDA SECADOR / ALZADO TRANSVERSAL / 1:25

Apoyo al piso:0 mm / altura nominal2600 mm.

Boca de salida675 / recepción C01 472,1 mm.

Longitud C01 y C02 conservada:9495 mm entre ejes.

Elevador C08:4143,6 mm /16 grados. Superficie final1600 mm.

Recepción horizontal bajo toda la salida2500 mm.
