acevedocrisologopablo48-lgtm/planta-briquetadora/r23/PLANTA_R23.pdf

SESUVECA | PLANTA BRIQUETADORA

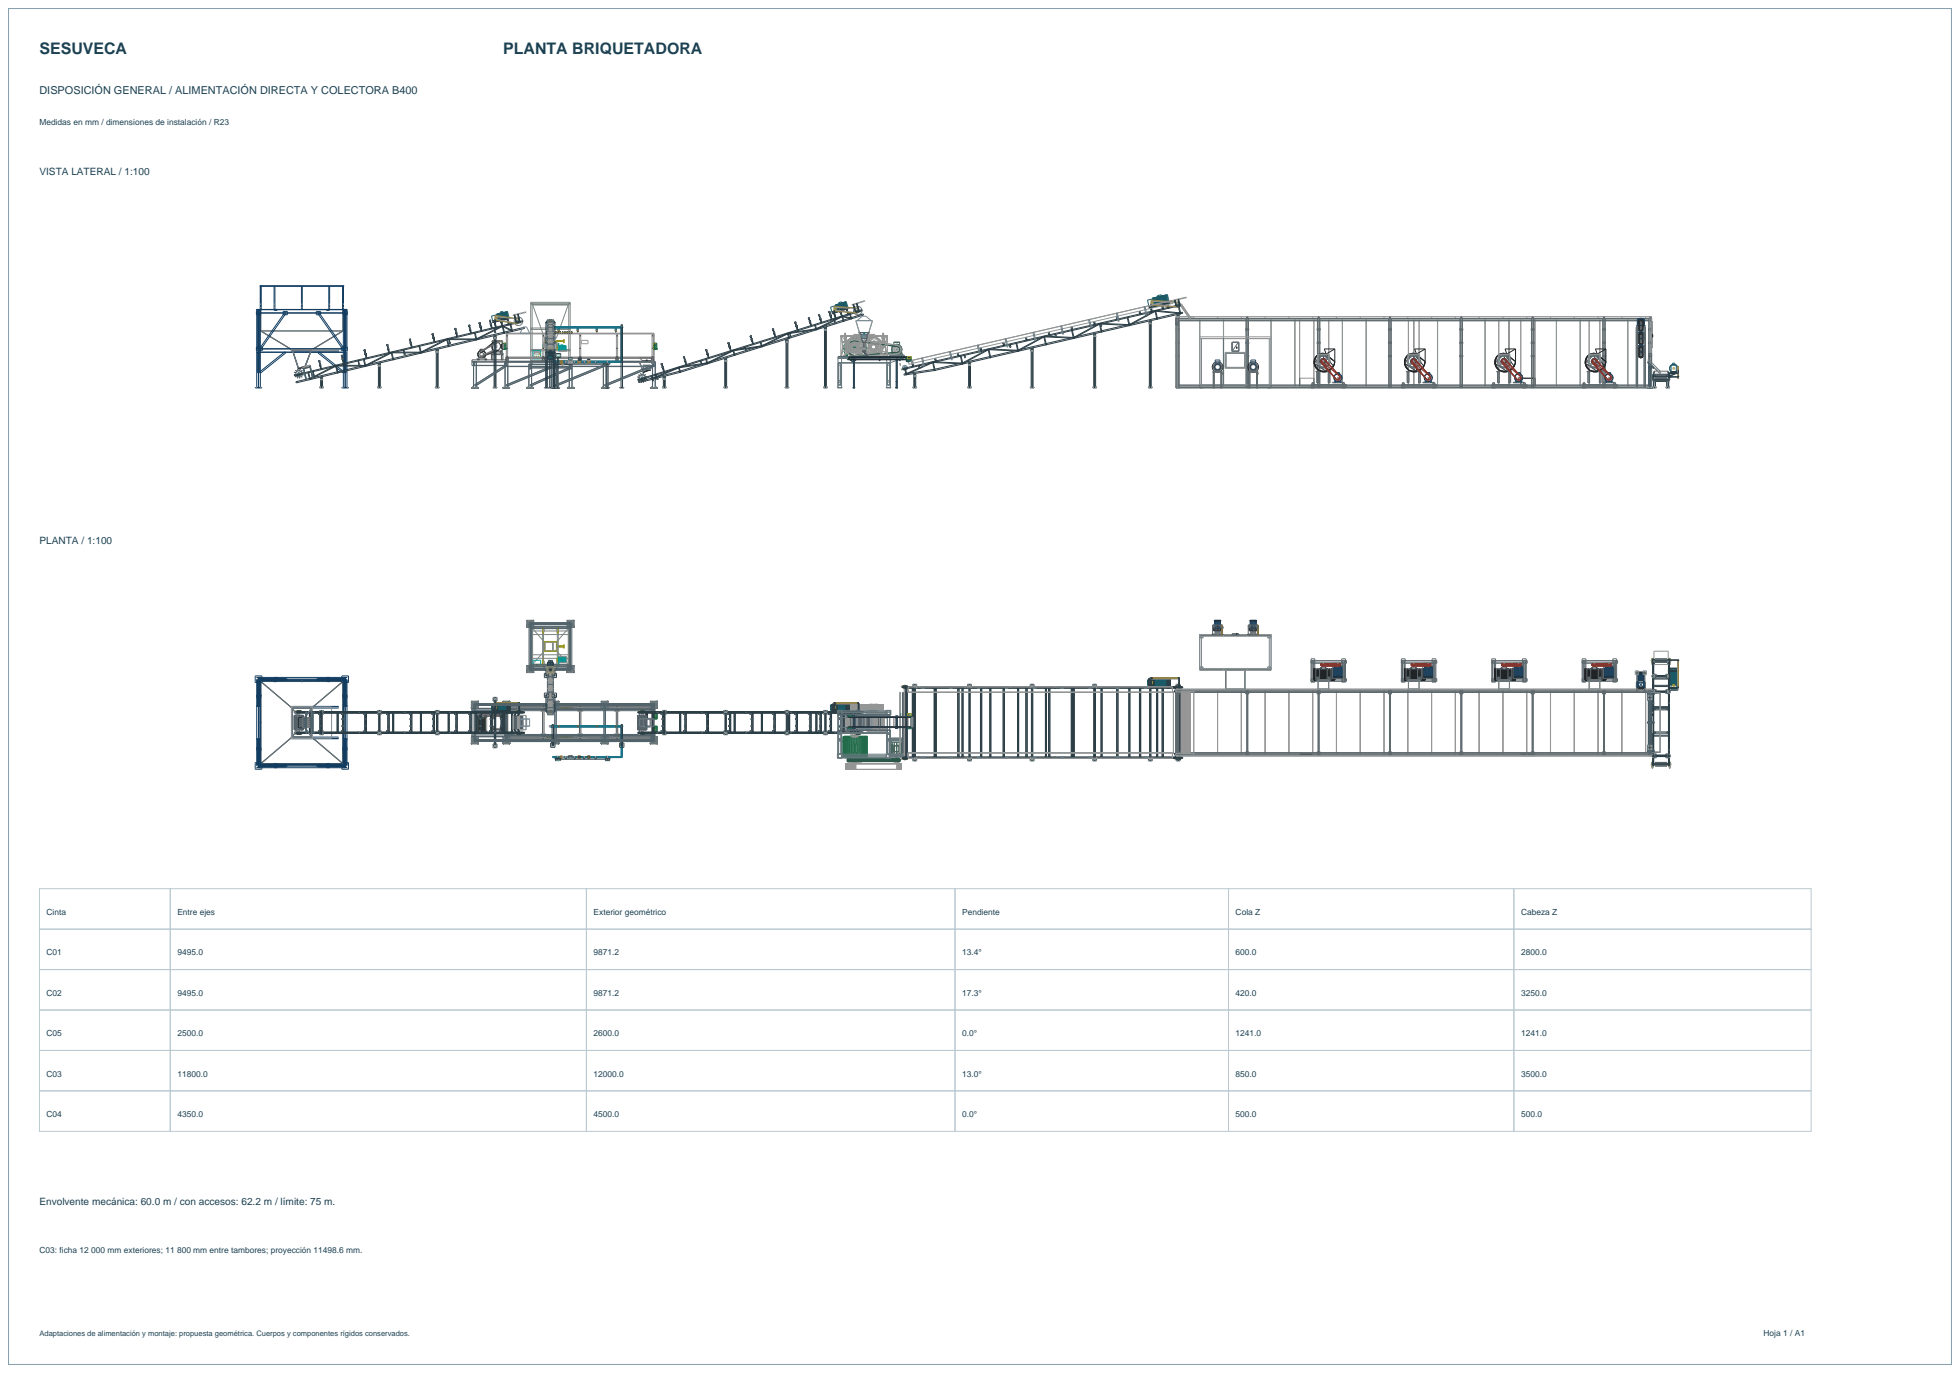
[picture p96: page 1]

DISPOSICIÓN GENERAL / ALIMENTACIÓN DIRECTA Y COLECTORA B400

Medidas en mm / dimensiones de instalación / R23

Envolvente mecánica: 60.0 m / con accesos: 62.2 m / límite: 75 m.

C03: ficha 12 000 mm exteriores; 11 800 mm entre tambores; proyección 11498.6 mm.

SESUVECA | PLANTA BRIQUETADORA

CONJUNTOS MODIFICADOS / ALTURAS DESDE EL PISO

Medidas en mm / dimensiones de instalación / R23

Adaptaciones de alimentación y montaje: propuesta geométrica. Cuerpos y componentes rígidos conservados. | Hoja 2 / A1

BRIQUETADORA Y COLECTORA / LATERAL / 1:20

2330

2830

2500

COLECTORA PLANA / PLANTA / 1:10

B400

Tambores Ø100 / banda plana de 3 mm.

Superficie de carga: 1294.0 mm.

Labio de recepción: 1302.0 mm / separación: 8 mm.

Sólidos del conjunto de taller; soportes independientes.

MEZCLADORA Y DOSIFICADOR / FRENTE / 1:20

Mezcladora: cuerpo 6200 × 1300 × 1200 mm.

Bancada mezcladora: 1100 mm; entrada directa.

Se retiran la tolva añadida y sus apoyos.

Dosificador: bancada 1000 mm / altura total 3600 mm.

Sinfín existente reajustado; apoyos fuera del tanque.

Agua y aglomerante conectados al cuerpo de mezcla.
