acevedocrisologopablo48-lgtm/planta-briquetadora/r19/DOSSIER_R19.pdf

# PLANTA BRIQUETADORA · R19

## 01 · RUTA PROVISIONAL CON RETIRO CONTINUO

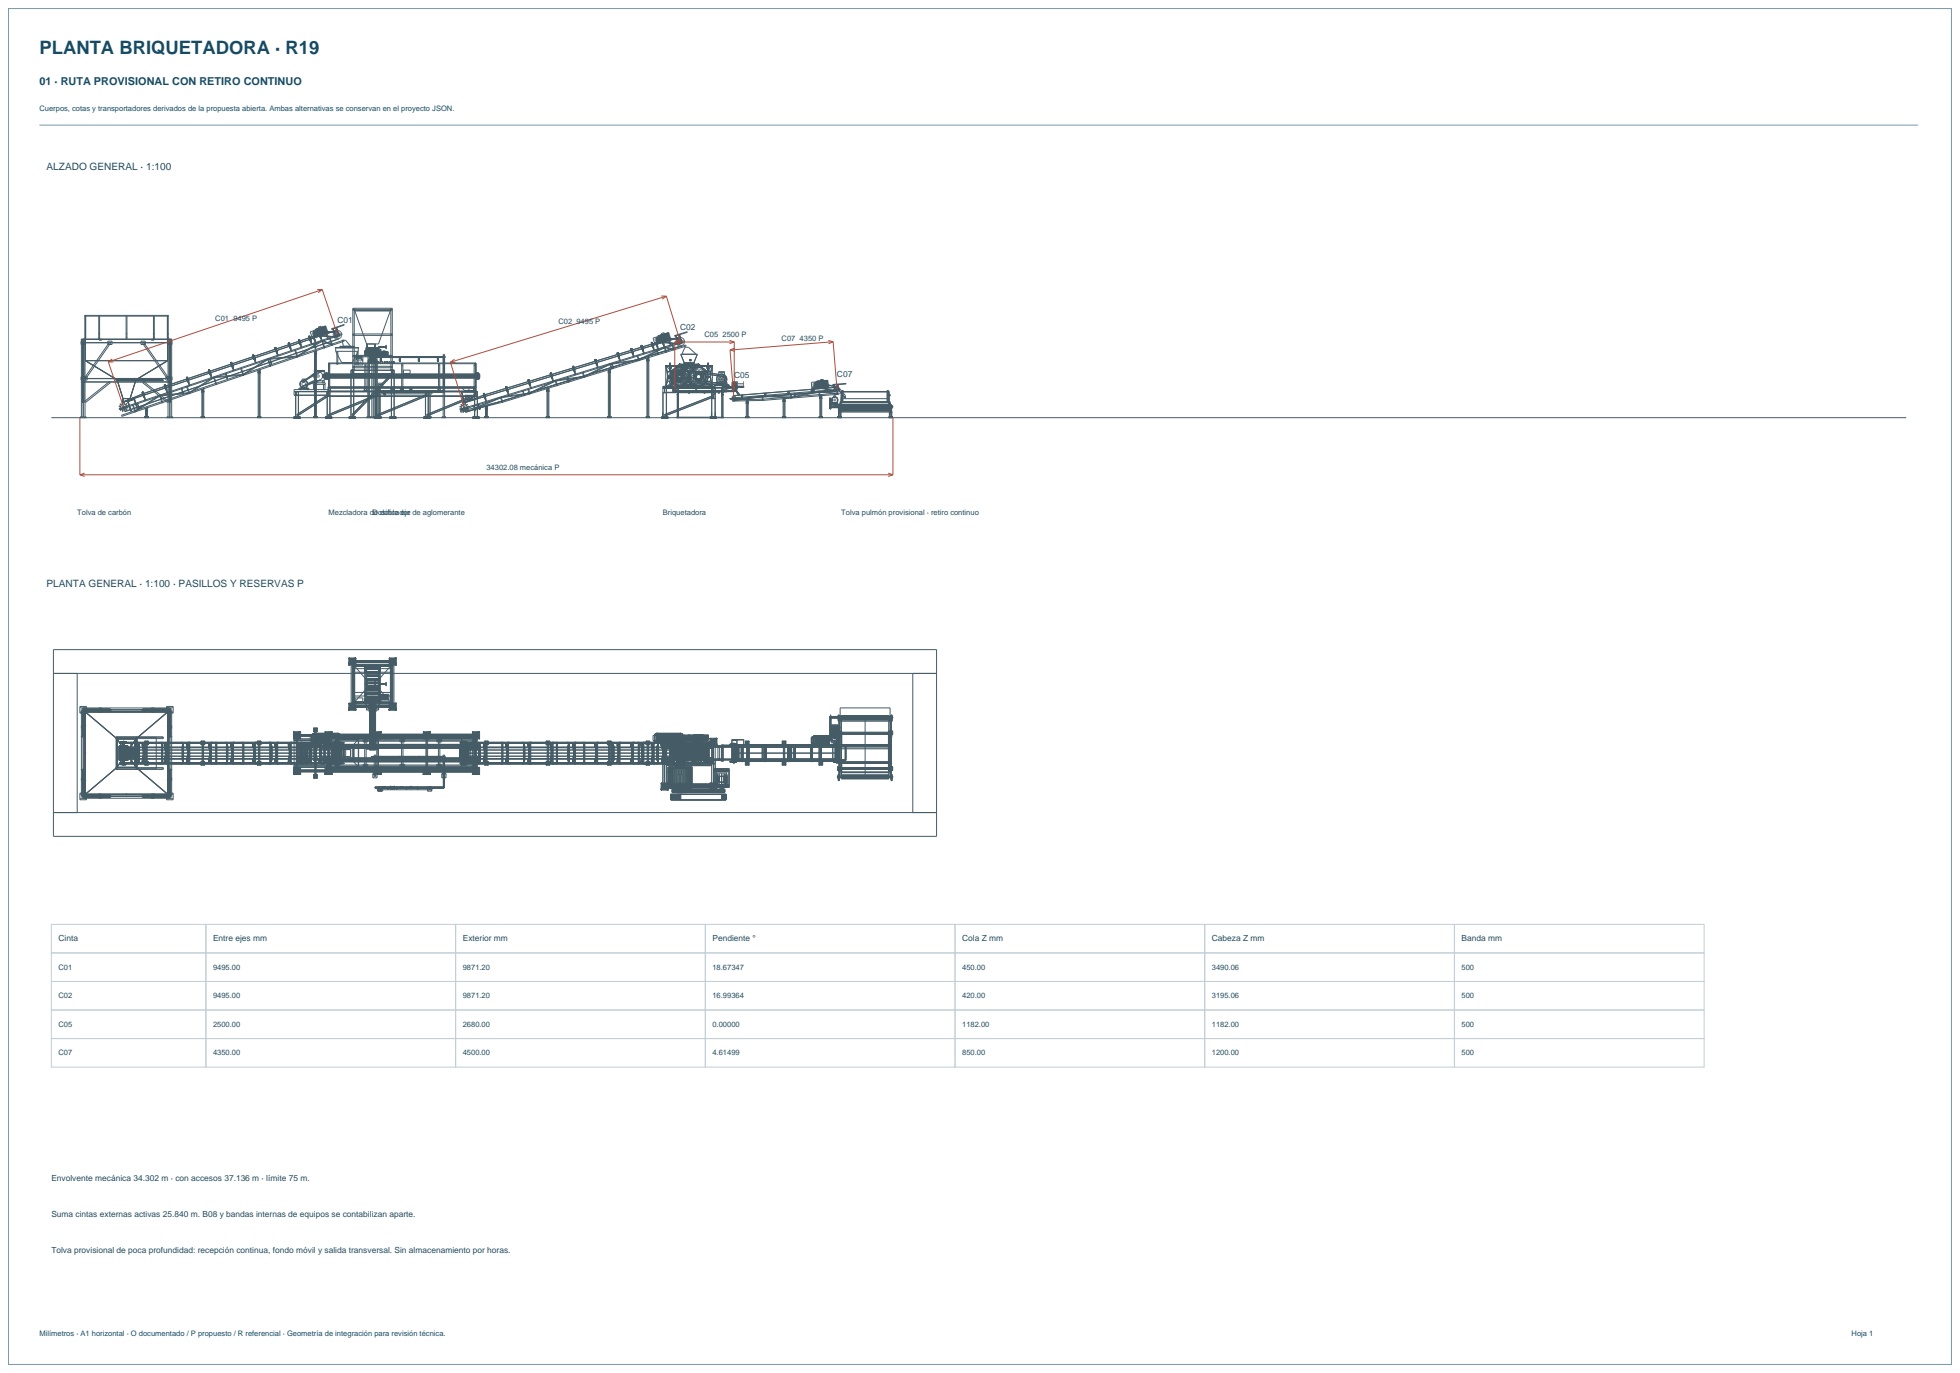
[picture p97: page 1]

Cuerpos, cotas y transportadores derivados de la propuesta abierta. Ambas alternativas se conservan en el proyecto JSON.

PLANTA GENERAL · 1:100 · PASILLOS Y RESERVAS P

Envolvente mecánica 34.302 m · con accesos 37.136 m · límite 75 m.

Suma cintas externas activas 25.840 m. B08 y bandas internas de equipos se contabilizan aparte.

Tolva provisional de poca profundidad: recepción continua, fondo móvil y salida transversal. Sin almacenamiento por horas.

## 02 · ALTERNATIVA CON SECADOR DE MALLAS

## ALZADO GENERAL · 1:100

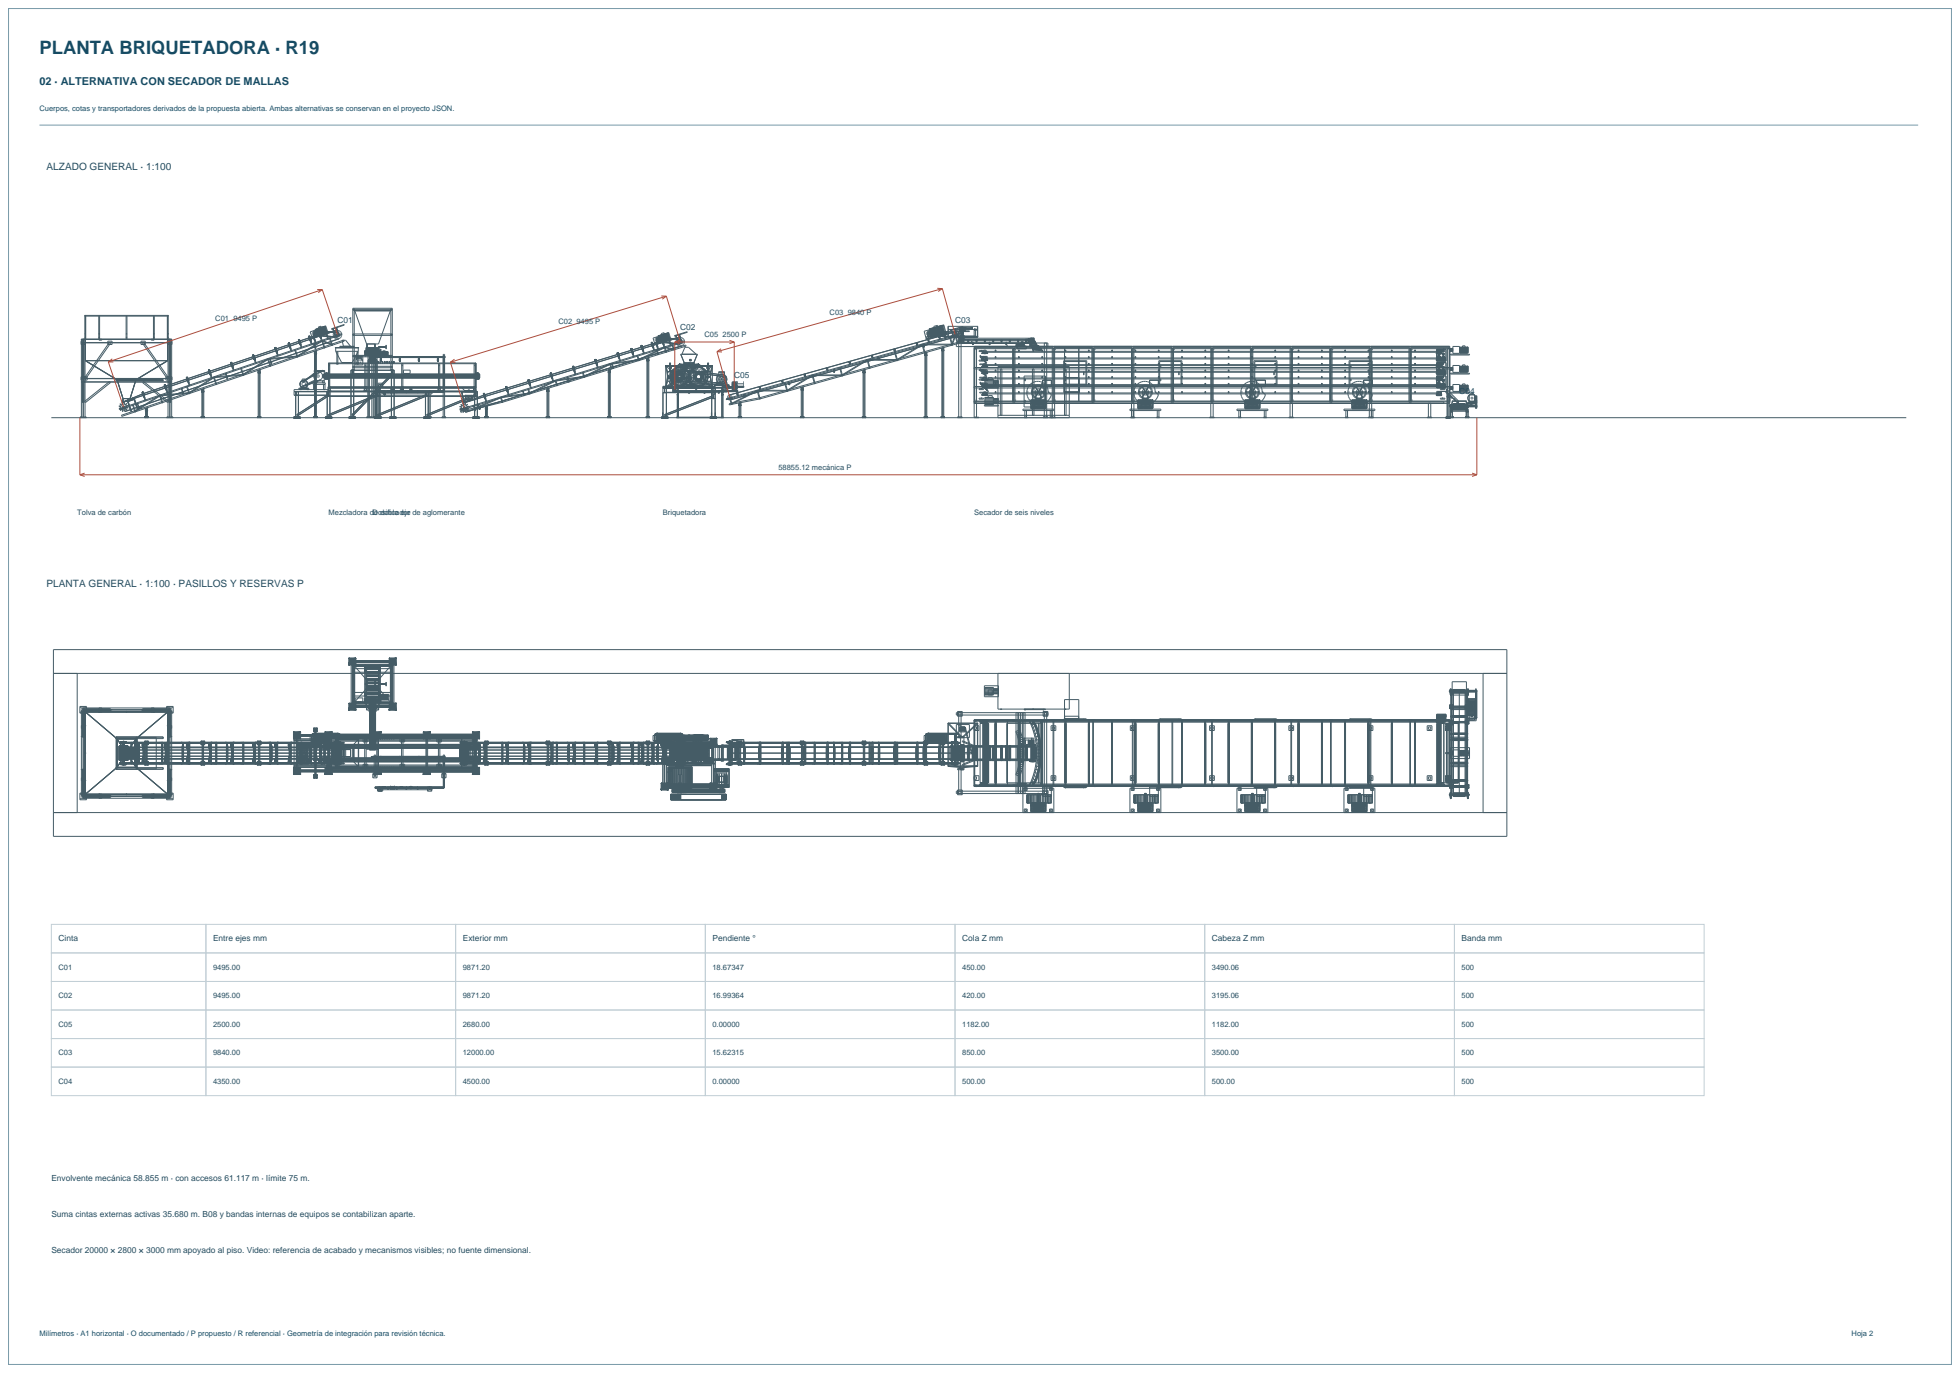
[picture p98: page 2]
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

PLANTA GENERAL · 1:100 · PASILLOS Y RESERVAS P

Envolvente mecánica 58.855 m · con accesos 61.117 m · límite 75 m.

Suma cintas externas activas 35.680 m. B08 y bandas internas de equipos se contabilizan aparte.

Secador 20000 × 2800 × 3000 mm apoyado al piso. Video: referencia de acabado y mecanismos visibles; no fuente dimensional.

## 03 · TOLVA PROVISIONAL Y FONDO MÓVIL B08

Recepción con retiro continuo confirmado por el usuario · conjunto nuevo P · volumen geométrico, sin capacidad productiva certificada.

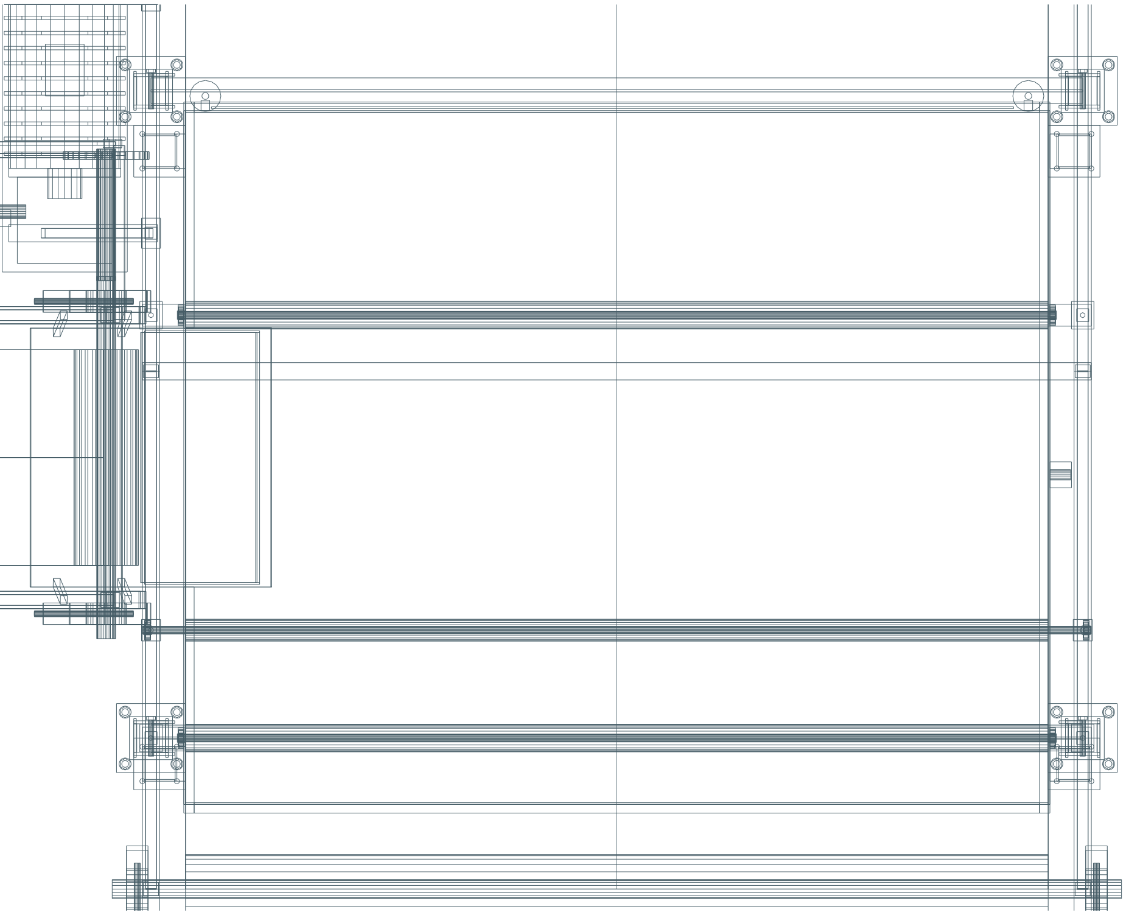
[picture p99: figure]
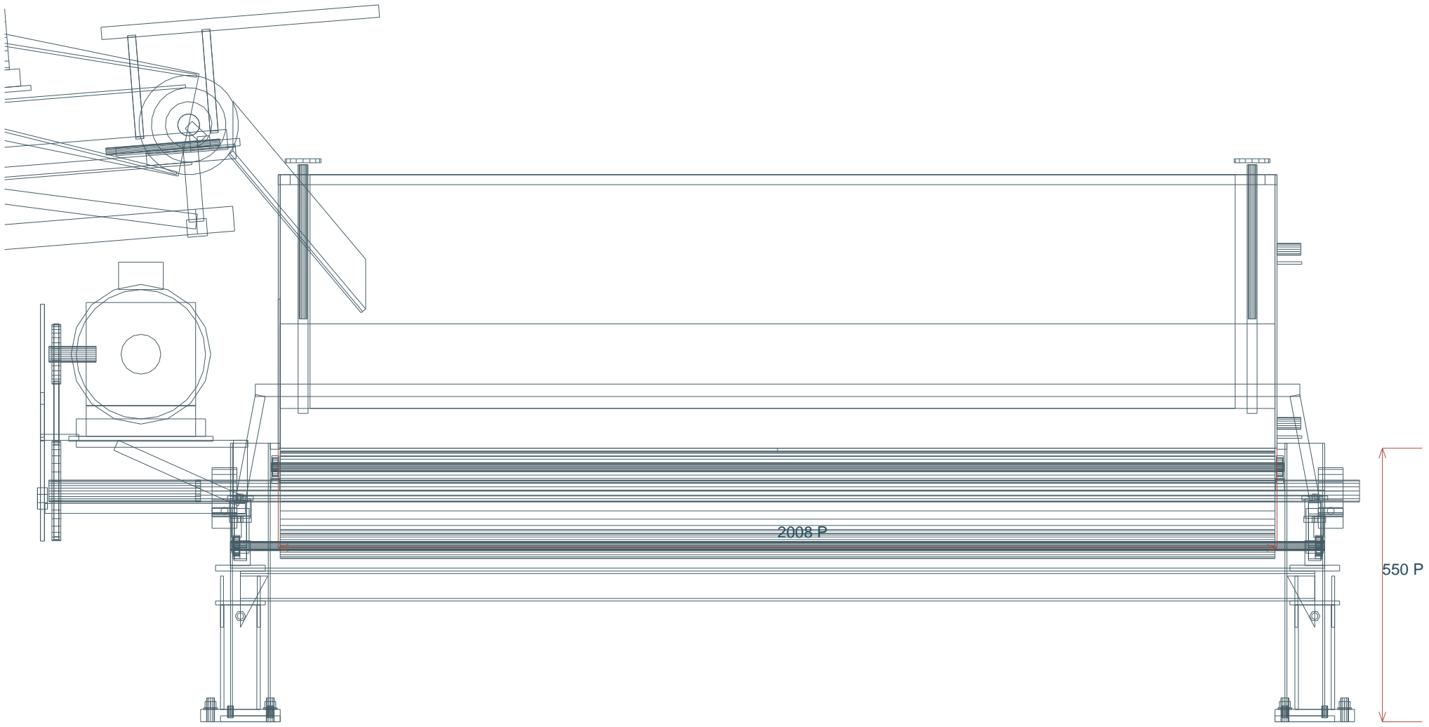
[picture p100: figure]

Milímetros · A1 horizontal · O documentado / P propuesto / R referencial · Geometría de integración para revisión técnica. | Hoja 3

## ALZADO LOCAL · 1:10

## PLANTA LOCAL · 1:10

## FRENTE DE RECEPCIÓN · 1:10

Parámetro | Geometría R19 P
Hueco útil | 2000 × 1600 mm
Envolvente de carcasa | 2008 × 1608 × 1100 mm
Altura máxima representada | 1248.00 mm NPT
Fondo móvil / cama | 550 / 800.00 mm NPT
Cama nominal / máxima | 250 / 400 mm
Volumen de cama actual | 0.80 m³
Guía UHMWPE / respaldo | 8 mm / acero 4 mm
Entrada y salida de guía | 59.64 / 30 mm libres

Guillotina de salida regulable · sensores L y HH · accionamiento y bastidor propios · retirada transversal Y+.

La posición representada de la guía acompaña la cama de estudio; ajuste P antes de montaje. No se supone regulación automática.

## DETALLE · C05-C07 · SUPERFICIES Y GUÍA REVESTIDA

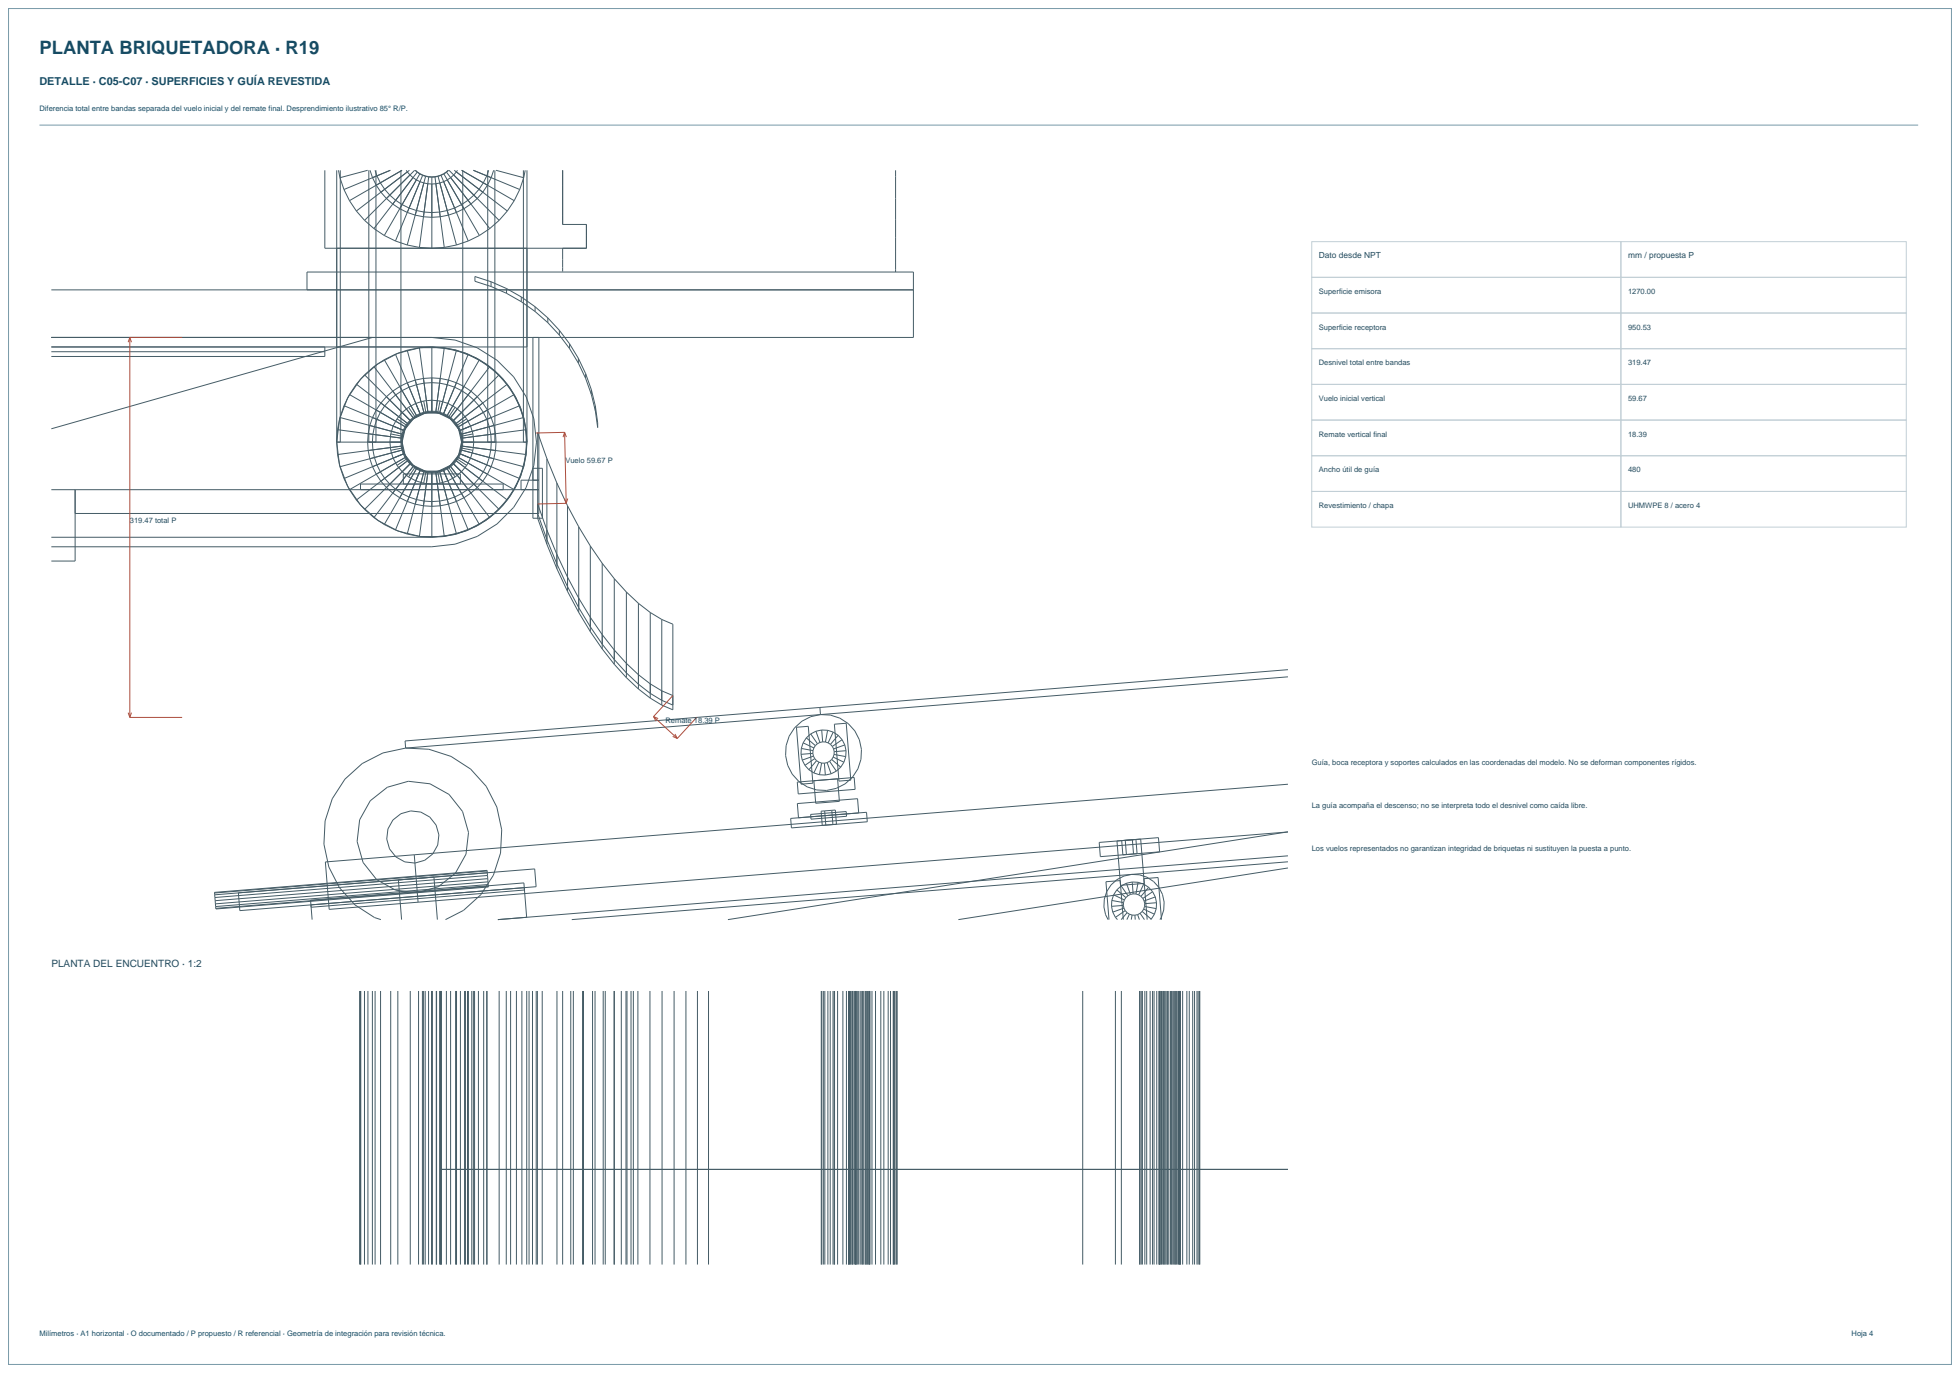
[picture p101: page 4]

Diferencia total entre bandas separada del vuelo inicial y del remate final. Desprendimiento ilustrativo 85° R/P.

Guía, boca receptora y soportes calculados en las coordenadas del modelo. No se deforman componentes rígidos.

La guía acompaña el descenso; no se interpreta todo el desnivel como caída libre.

Los vuelos representados no garantizan integridad de briquetas ni sustituyen la puesta a punto.

## DETALLE · C05-C03 · SUPERFICIES Y GUÍA REVESTIDA

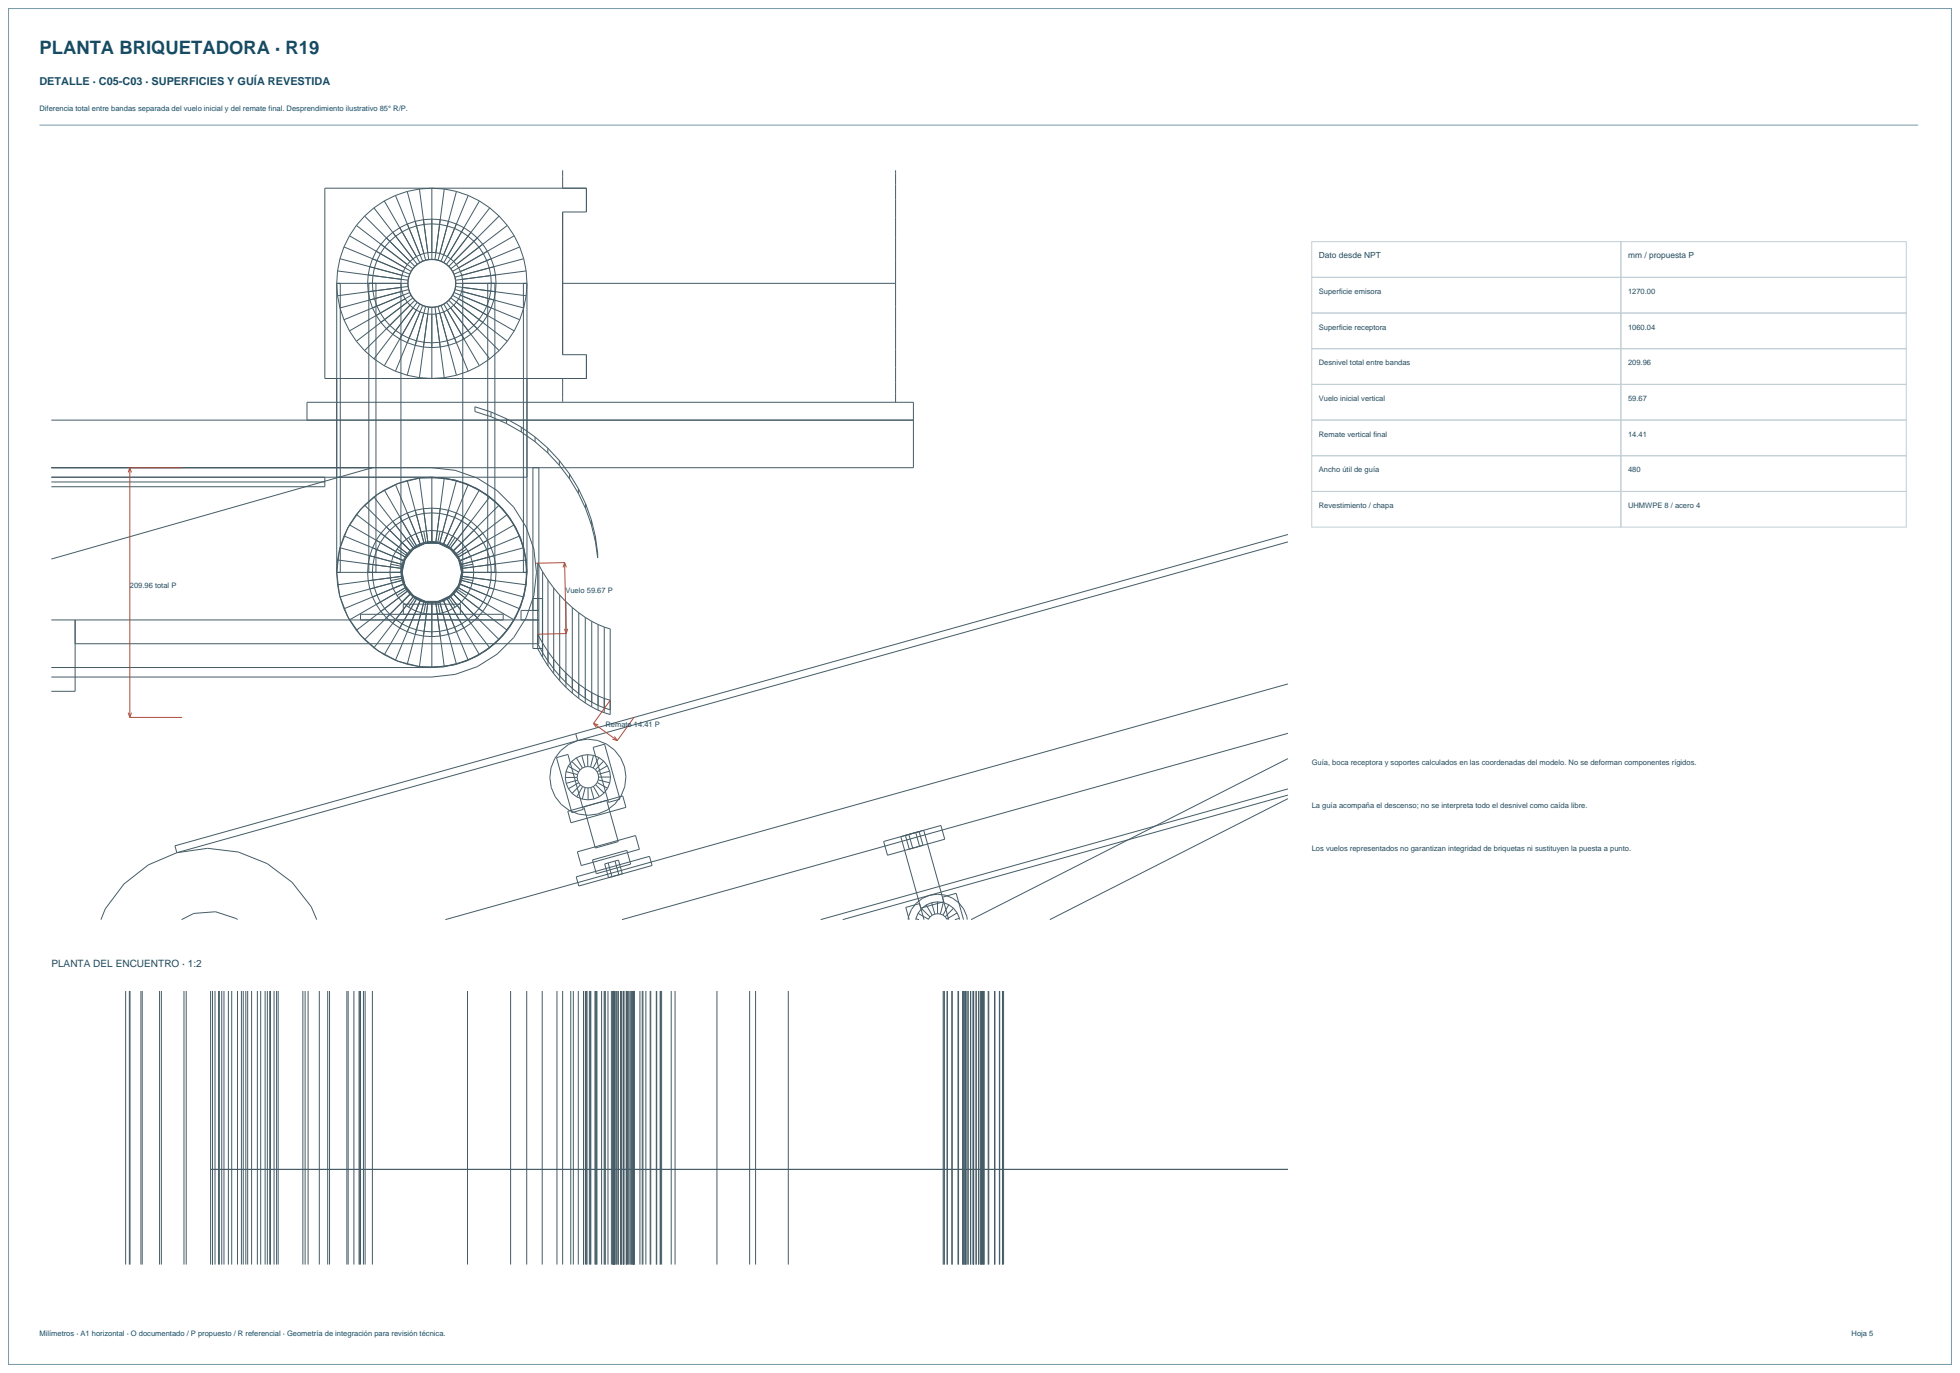
[picture p102: page 5]
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

Guía, boca receptora y soportes calculados en las coordenadas del modelo. No se deforman componentes rígidos.

La guía acompaña el descenso; no se interpreta todo el desnivel como caída libre.

Los vuelos representados no garantizan integridad de briquetas ni sustituyen la puesta a punto.

## DETALLE · C03-traverse · SUPERFICIES Y GUÍA REVESTIDA

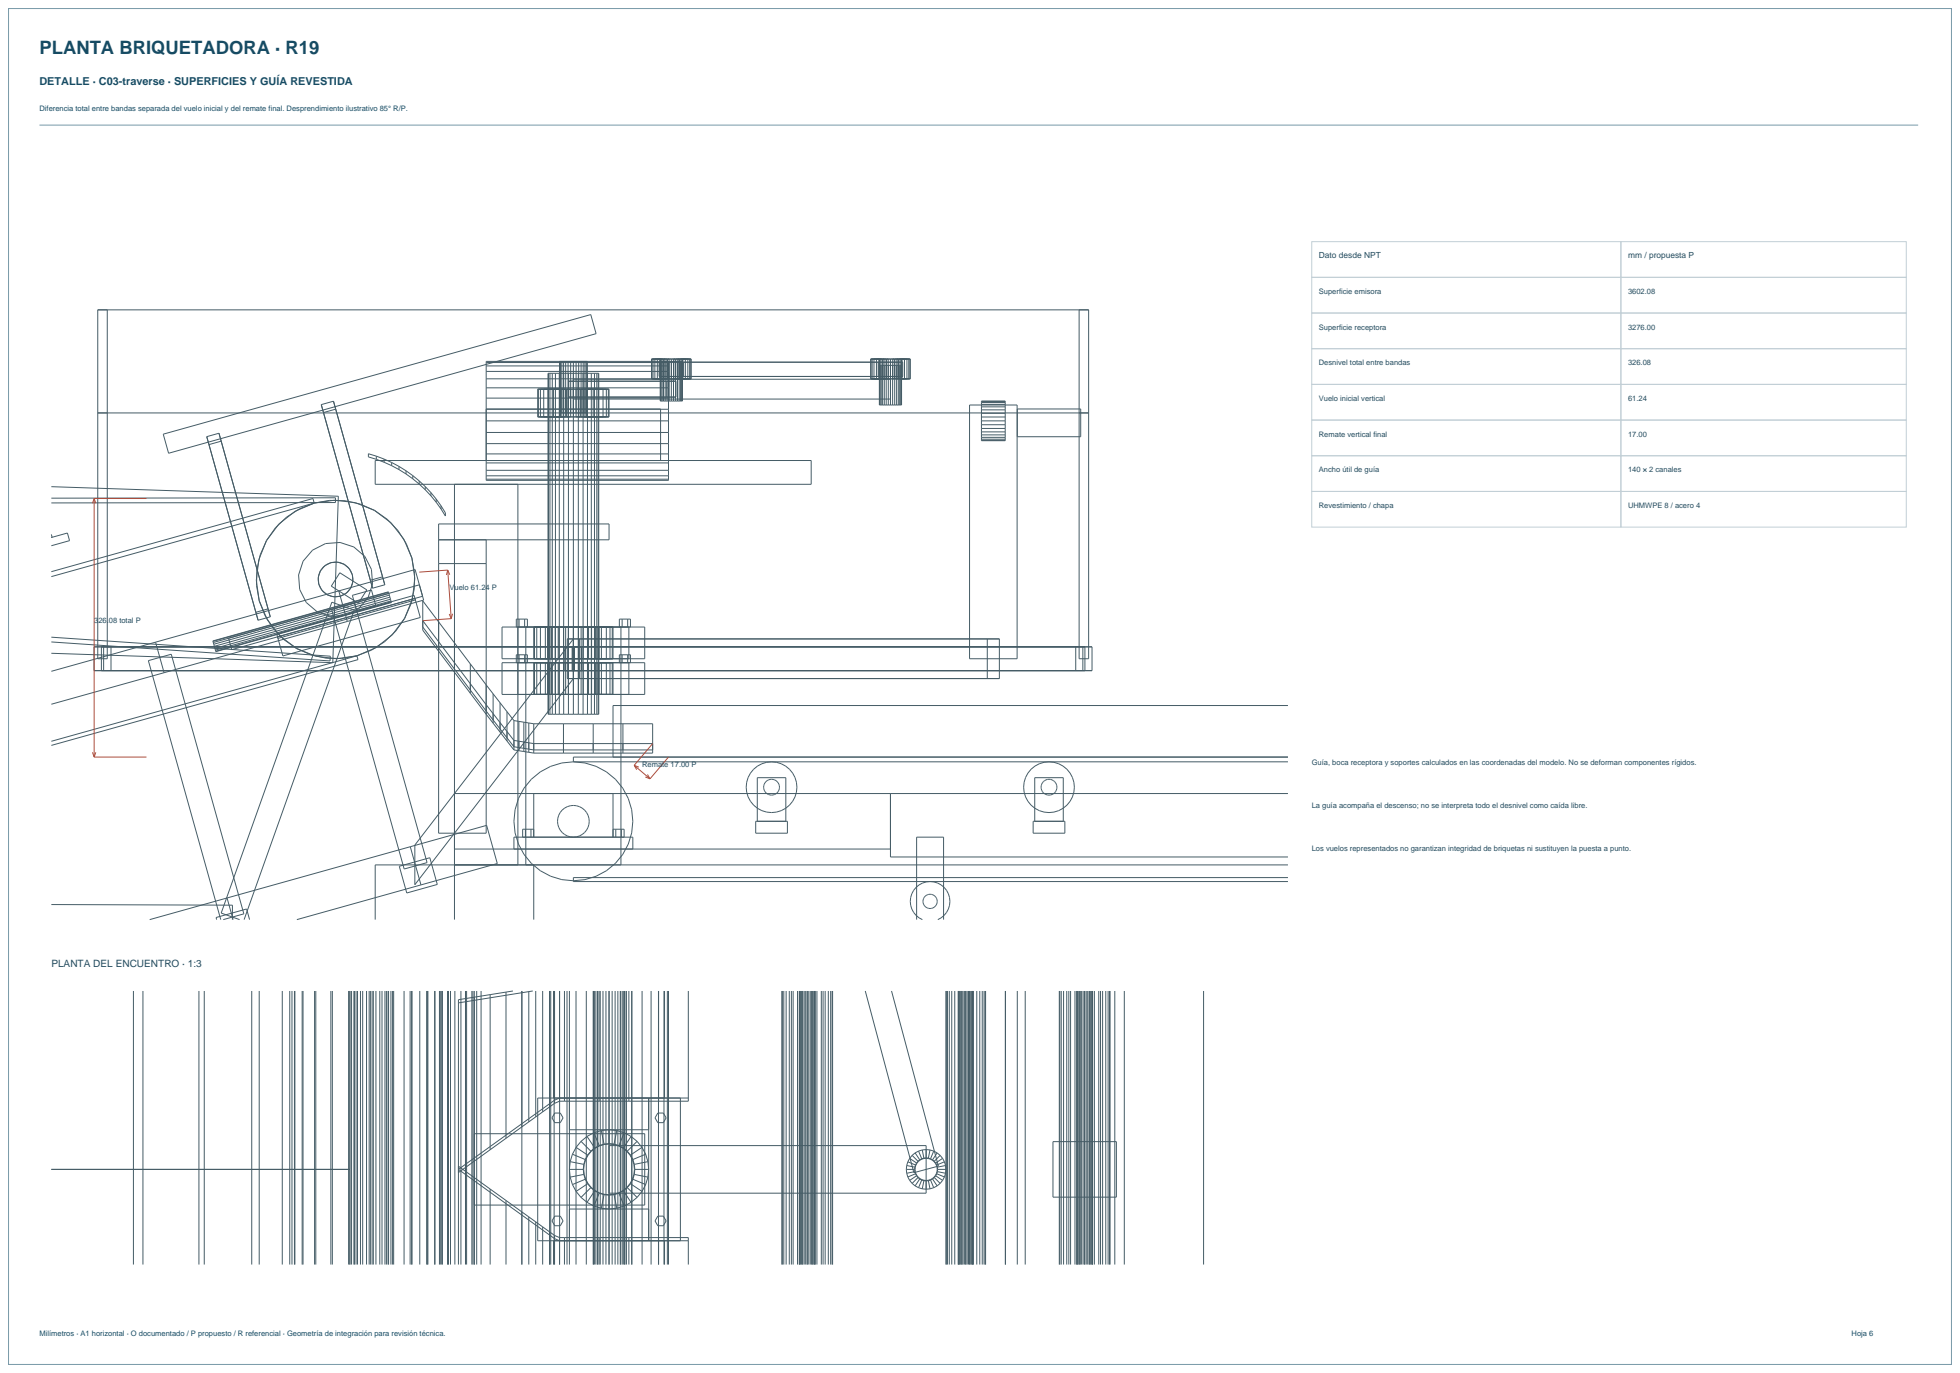
[picture p103: page 6]
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

Guía, boca receptora y soportes calculados en las coordenadas del modelo. No se deforman componentes rígidos.

La guía acompaña el descenso; no se interpreta todo el desnivel como caída libre.

Los vuelos representados no garantizan integridad de briquetas ni sustituyen la puesta a punto.

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

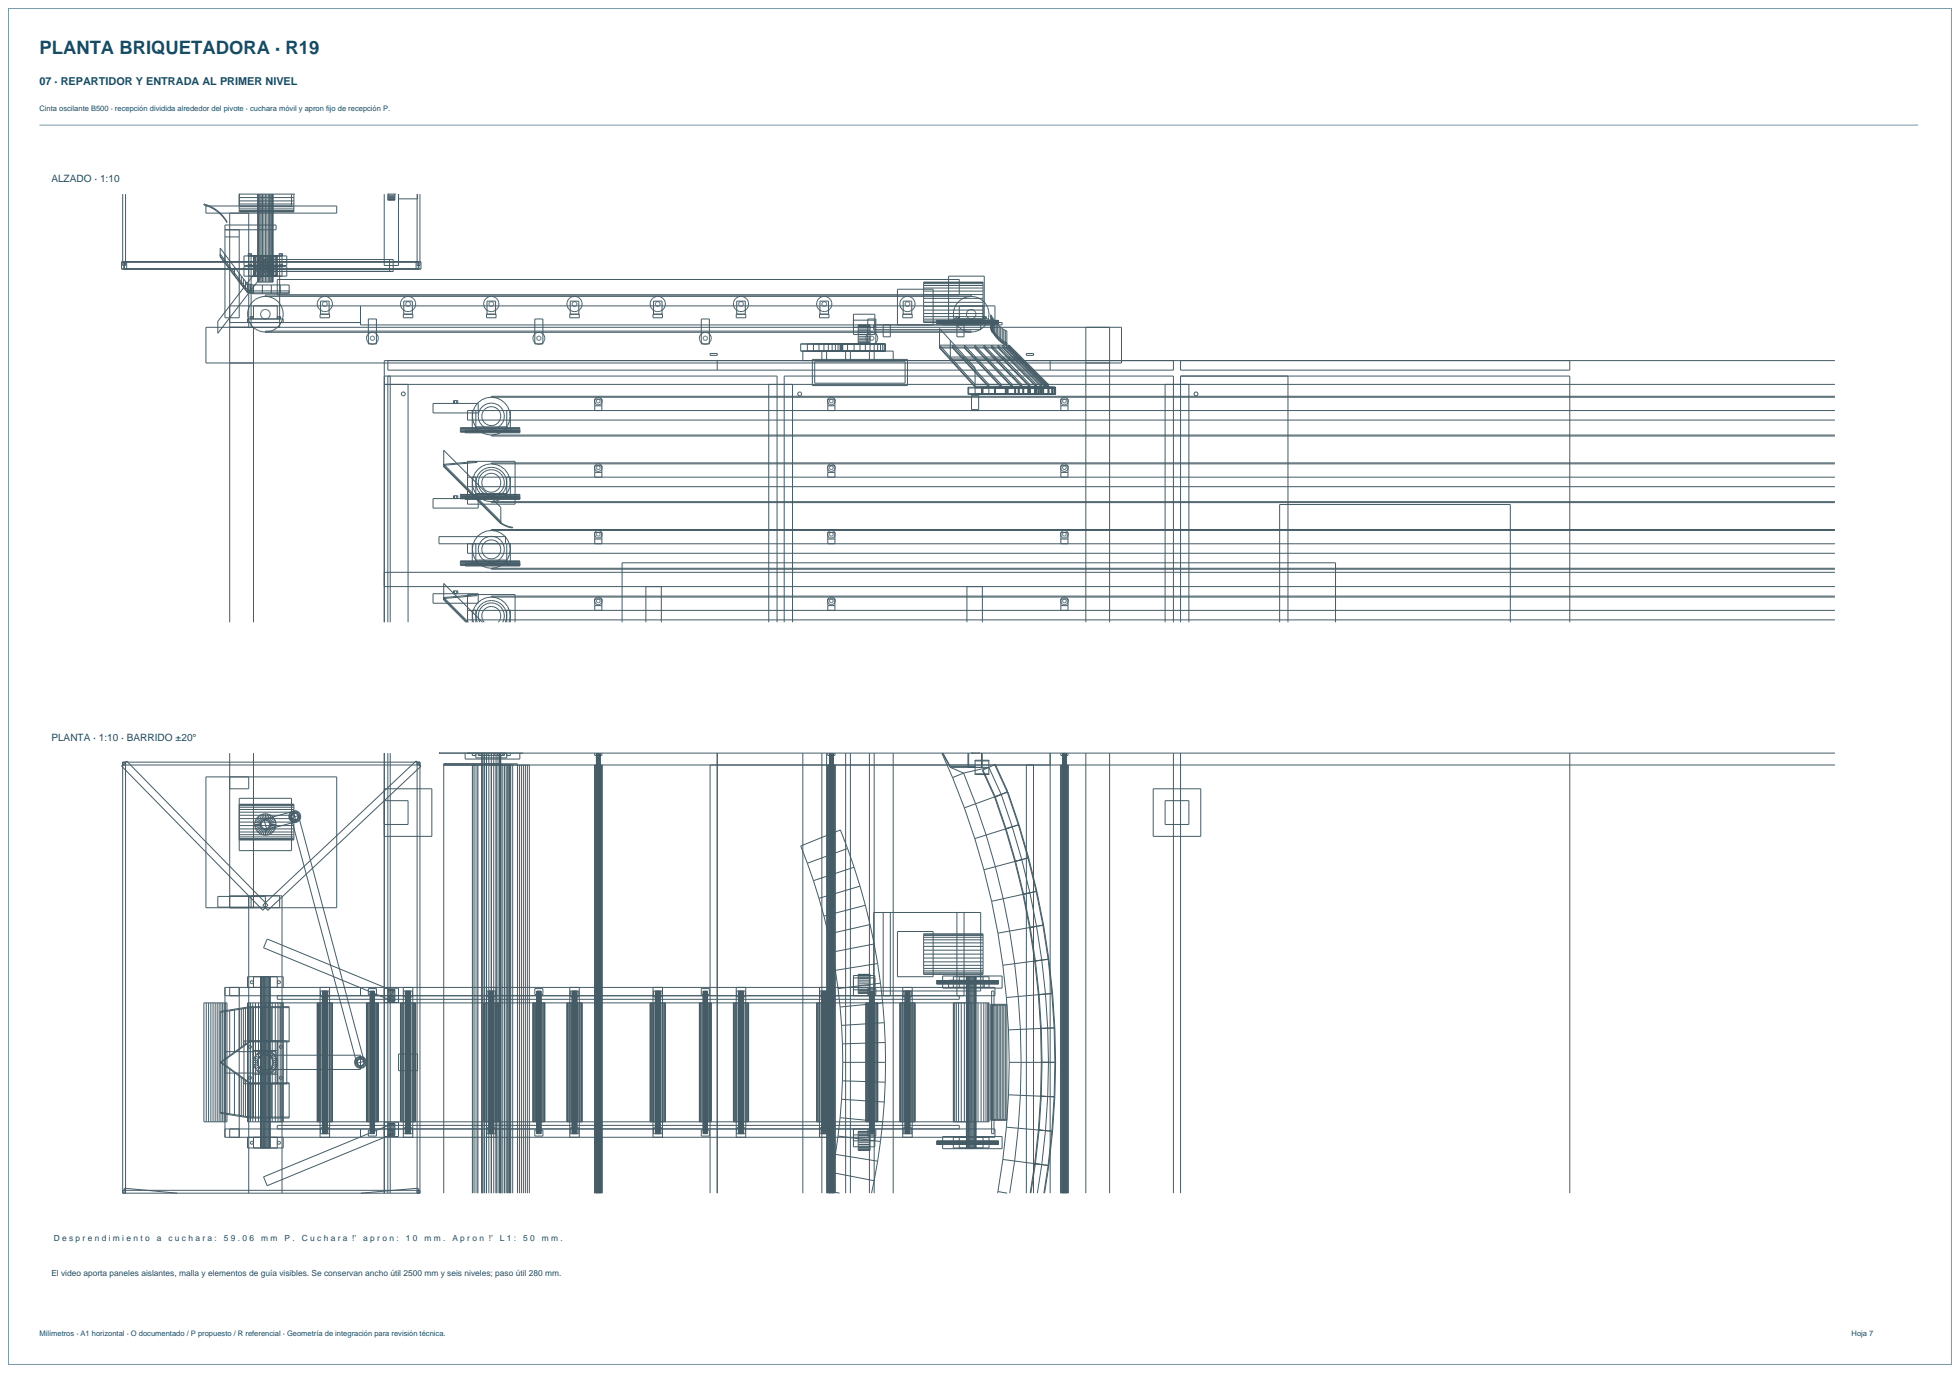
[picture p104: page 7]

## 08 · RESUMEN DE CAMBIOS Y CONDICIONES DE USO

R18 preservada · proyecto v2 · modos independientes y reversibles · consulta del dossier con ambas rutas.

Milímetros · A1 horizontal · O documentado / P propuesto / R referencial · Geometría de integración para revisión técnica. | Hoja 8
Elemento | R18 | R19
Ruta provisional | No incluida | C05 !’ C07 !’ pulmón B08
Colectora de prensa | C05 a +1270 mm de superficie | Conservada a +1270 mm
Transferencias de banda | Desniveles sin guía completa | Guías curvas revestidas y remates próximos
C07 provisional | No incluida | 4350 mm entre ejes / 4.61499°
Tolva provisional | No incluida | Hueco 2 × 1,6 m / cama nominal 0,25 m
Retirada | Ruta al futuro secador | Continua, con fondo móvil B08
Secador | 20 × 2,8 × 3 m / al piso | Dimensiones conservadas; acabado del video
Tolva / prensa / secador | Alturas fijas | Alturas fijas conservadas
Animación | Recorrido del secador | Ruta activa y superficies guiadas
Persistencia | Propuestas y revisiones anteriores | Conservadas, R19 se abre como referencia nueva

La alternativa provisional no representa almacenamiento prolongado ni capacidad de curado de briquetas.

La cama y los vuelos son geometría P/R. Velocidades de animación ilustrativas: no simulación productiva.

Caudal, potencia final del fondo móvil, carga bajo tolva y resistencia de las briquetas no se declaran validados.

Se conservan las cantidades y clasificaciones OEM; nuevas piezas P se separan en BOM por modo.

DXF incluye cotas DIMENSION nativas desde caras, centros y superficies reales; DWG se genera desde ese DXF.

Las revisiones anteriores y los borradores no se sobrescriben. El proyecto JSON contiene ambas alternativas.
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
