acevedocrisologopablo48-lgtm/planta-briquetadora/entregas/R43/accesos/PLANOS_ACCESOS_R43.pdf

# ACCESOS DE MANTENIMIENTO

## PLANTA 1:150

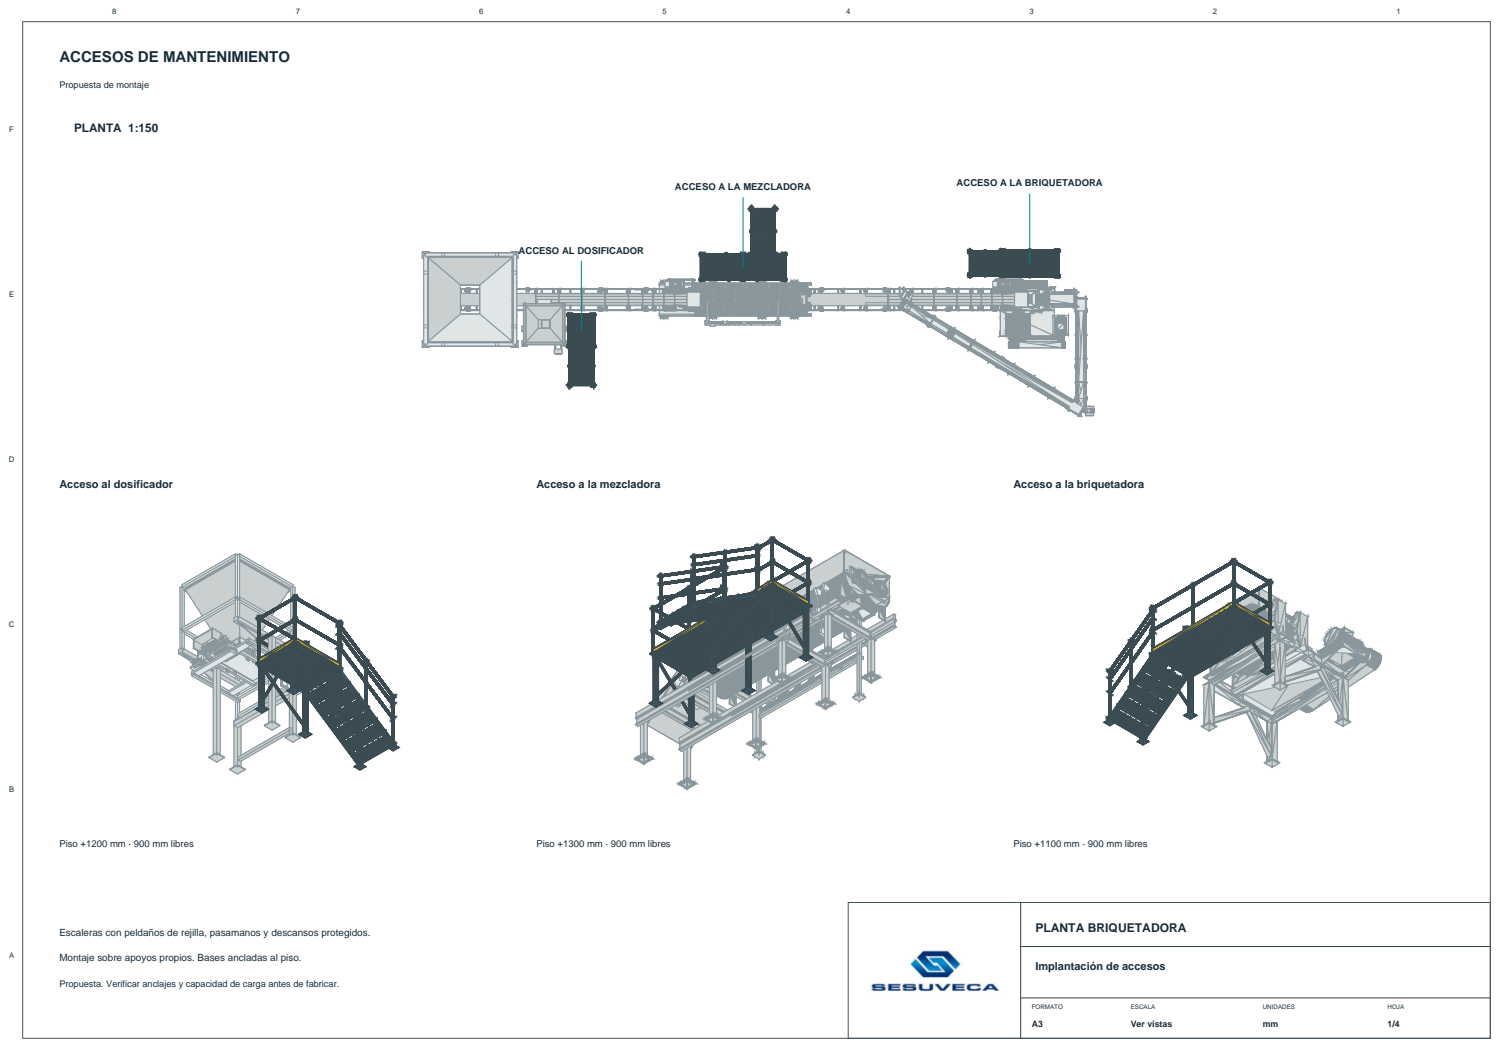
[picture p105: page 1]
PLANTA BRIQUETADORA; FORMATO; ESCALA; Ver vistas; UNIDADES; HOJA; ACCESO A LA MEZCLADORA; ACCESO A LA BRIQUETADORA

Propuesta de montaje

ACCESO AL DOSIFICADOR

Acceso al dosificador

Acceso a la mezcladora

Acceso a la briquetadora

Piso +1200 mm · 900 mm libres

Piso +1300 mm · 900 mm libres

Piso +1100 mm · 900 mm libres

Escaleras con peldaños de rejilla, pasamanos y descansos protegidos.

Montaje sobre apoyos propios. Bases ancladas al piso.

Implantación de accesos

Propuesta. Verificar anclajes y capacidad de carga antes de fabricar.

## PLANTA 1:50

## MONTAJE 1:40

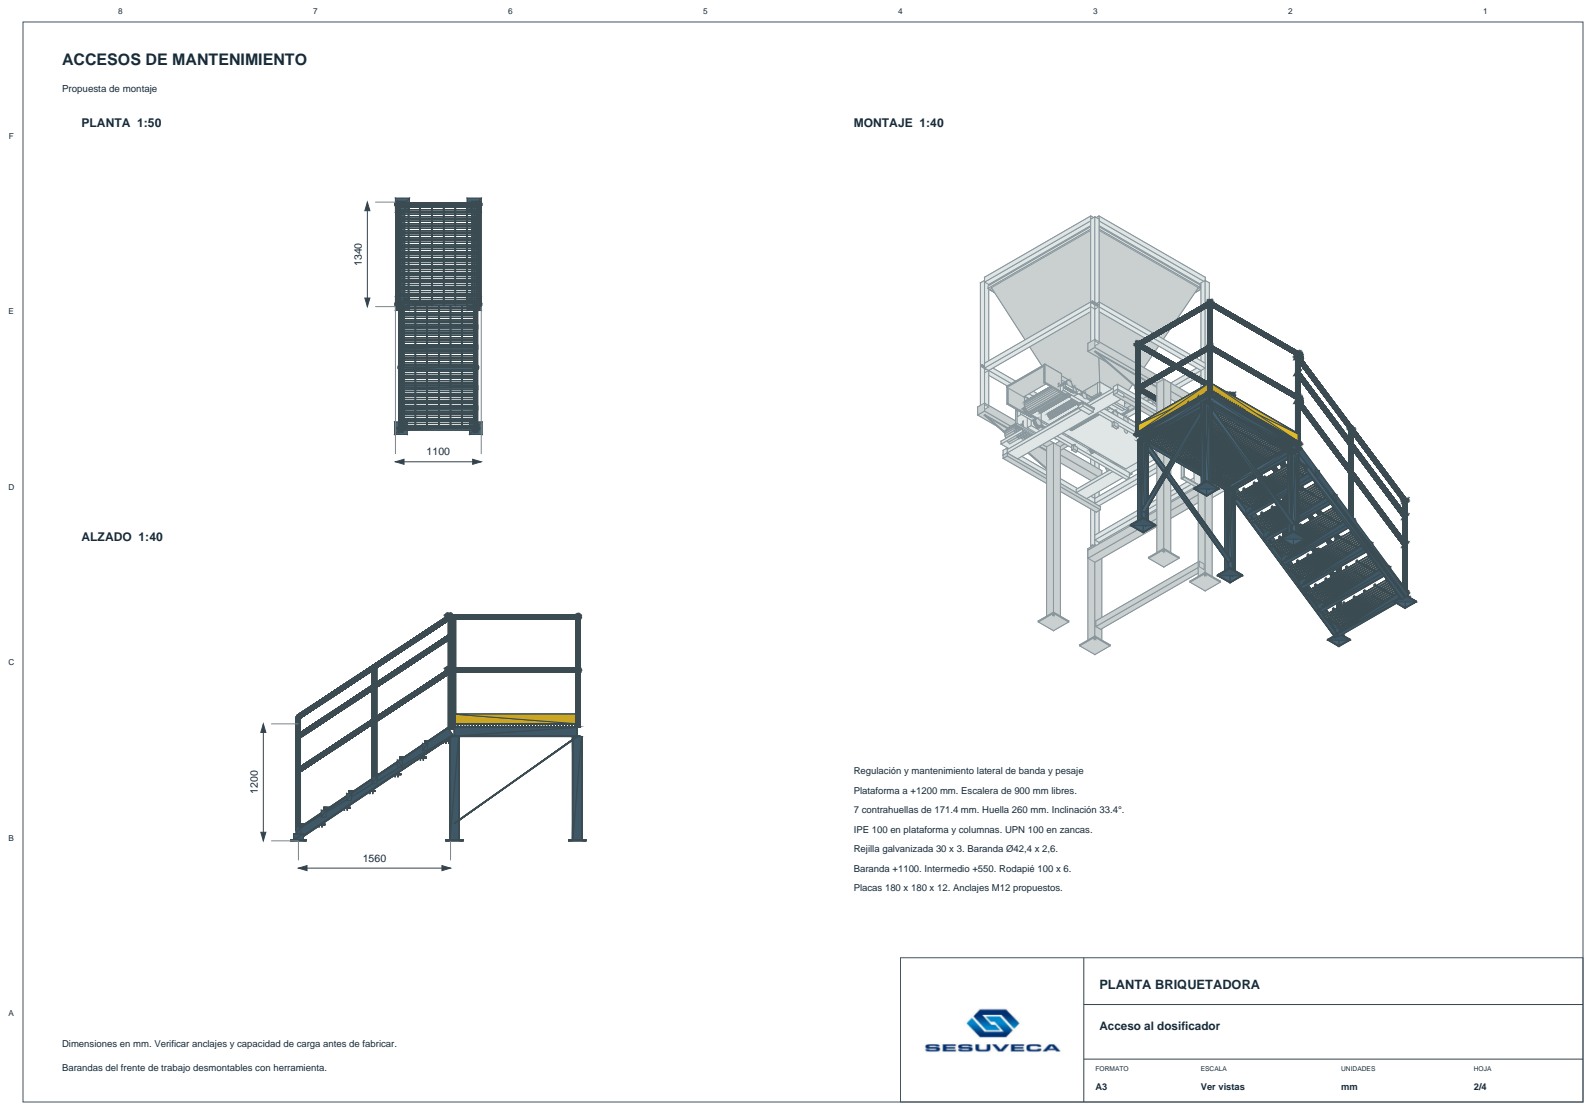
[picture p106: page 2]
PLANTA BRIQUETADORA; ALZADO 1:40

Propuesta de montaje

Regulación y mantenimiento lateral de banda y pesaje
Plataforma a +1200 mm. Escalera de 900 mm libres.
7 contrahuellas de 171.4 mm. Huella 260 mm. Inclinación 33.4°.
IPE 100 en plataforma y columnas. UPN 100 en zancas.
Rejilla galvanizada 30 x 3. Baranda Ø42,4 x 2,6.
Baranda +1100. Intermedio +550. Rodapié 100 x 6.
Placas 180 x 180 x 12. Anclajes M12 propuestos.

Acceso al dosificador

Dimensiones en mm. Verificar anclajes y capacidad de carga antes de fabricar.

Barandas del frente de trabajo desmontables con herramienta.

## PLANTA 1:50

## MONTAJE 1:40

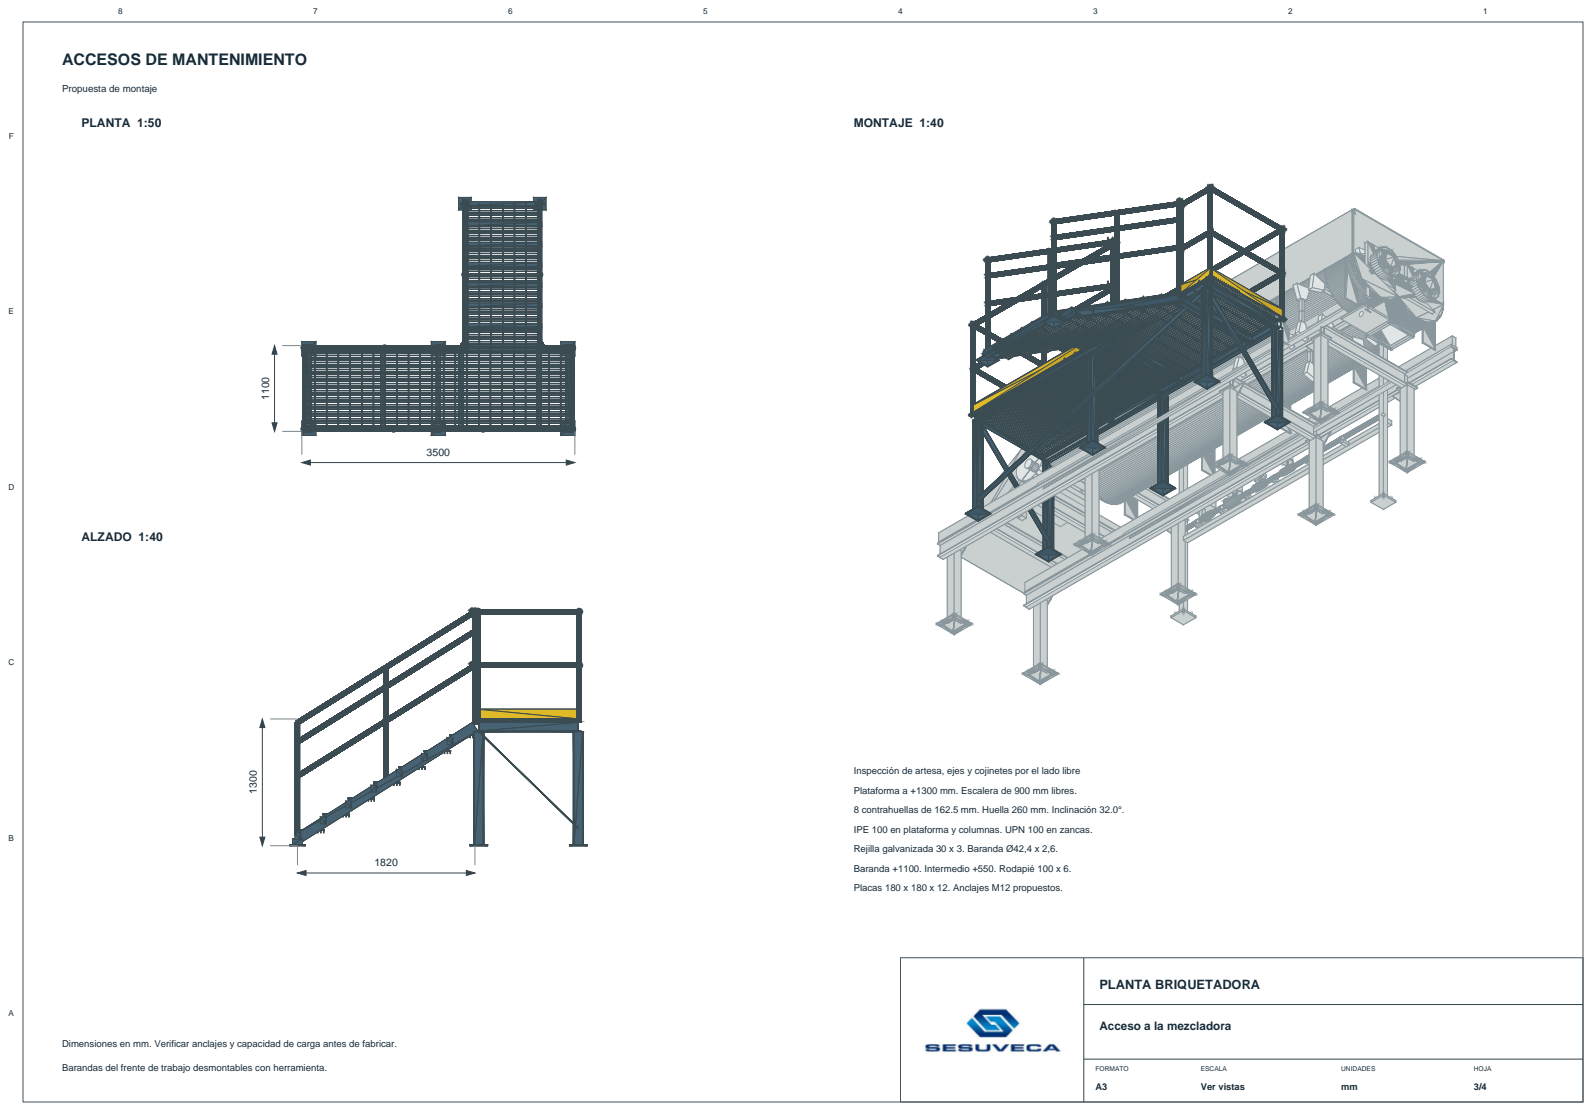
[picture p107: page 3]
PLANTA BRIQUETADORA; ALZADO 1:40

Propuesta de montaje

Inspección de artesa, ejes y cojinetes por el lado libre
Plataforma a +1300 mm. Escalera de 900 mm libres.
8 contrahuellas de 162.5 mm. Huella 260 mm. Inclinación 32.0°.
IPE 100 en plataforma y columnas. UPN 100 en zancas.
Rejilla galvanizada 30 x 3. Baranda Ø42,4 x 2,6.
Baranda +1100. Intermedio +550. Rodapié 100 x 6.
Placas 180 x 180 x 12. Anclajes M12 propuestos.

Acceso a la mezcladora

## PLANTA 1:25

## MONTAJE 1:40

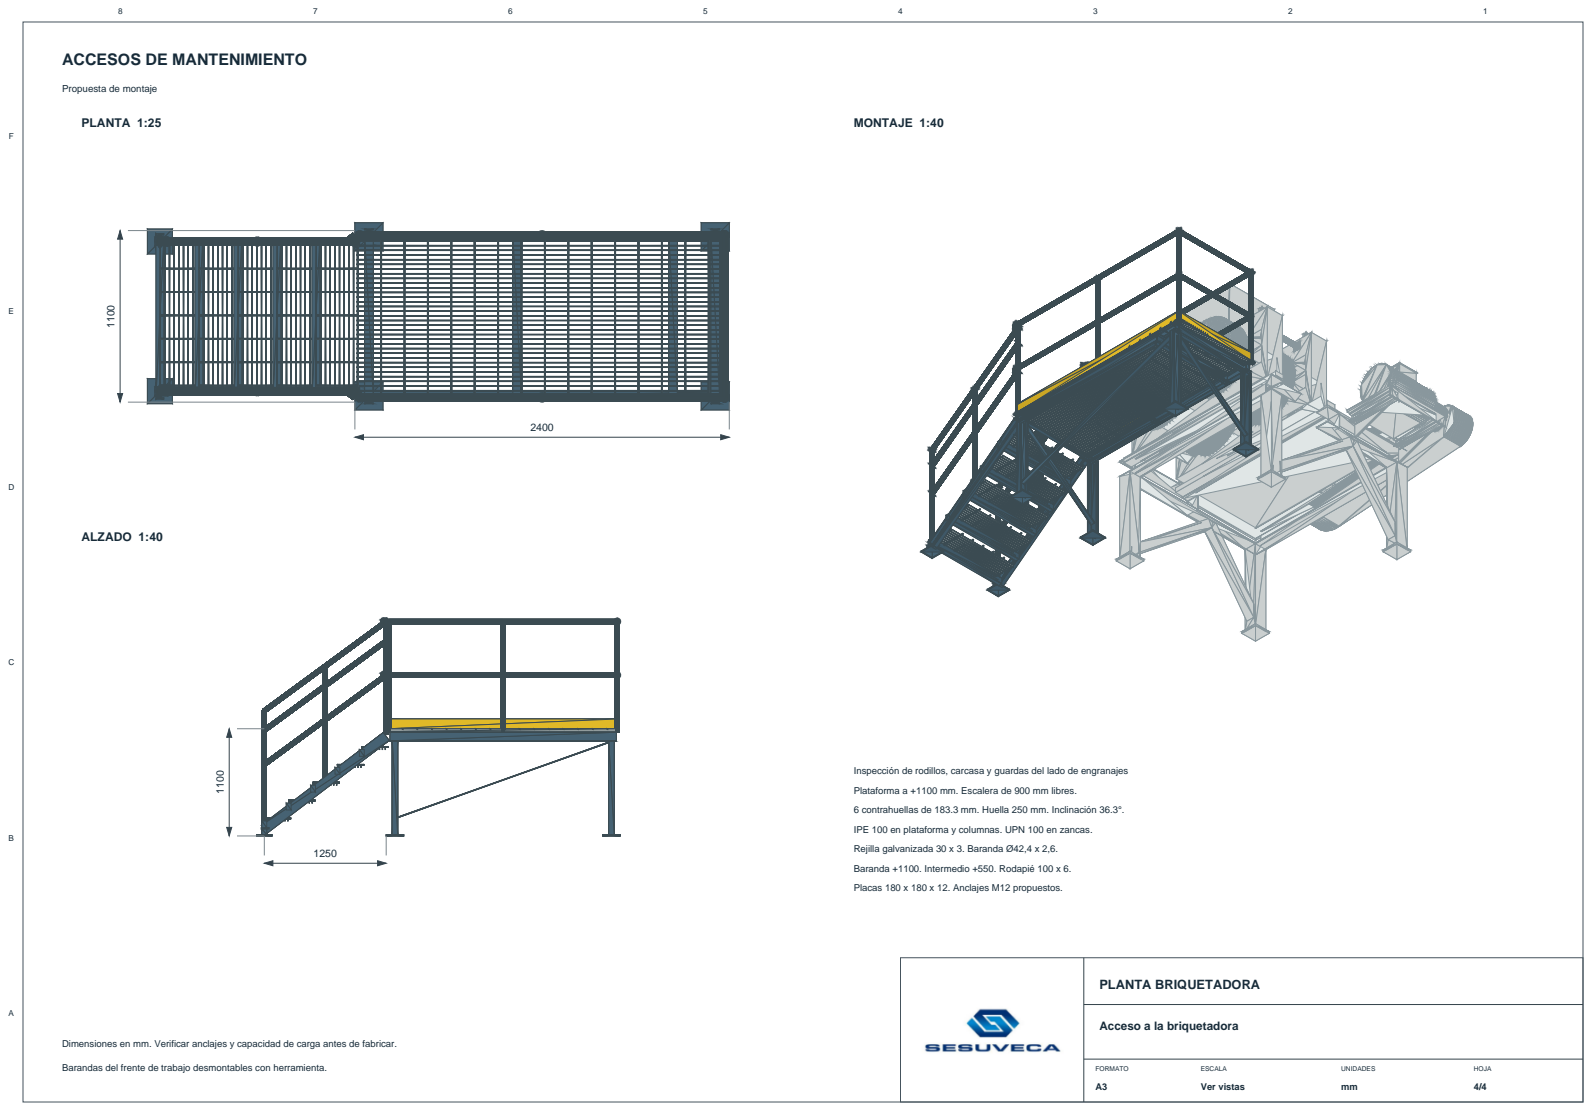
[picture p108: page 4]
PLANTA BRIQUETADORA; ALZADO 1:40

Propuesta de montaje

Inspección de rodillos, carcasa y guardas del lado de engranajes
Plataforma a +1100 mm. Escalera de 900 mm libres.
6 contrahuellas de 183.3 mm. Huella 250 mm. Inclinación 36.3°.
IPE 100 en plataforma y columnas. UPN 100 en zancas.
Rejilla galvanizada 30 x 3. Baranda Ø42,4 x 2,6.
Baranda +1100. Intermedio +550. Rodapié 100 x 6.
Placas 180 x 180 x 12. Anclajes M12 propuestos.

Acceso a la briquetadora
