acevedocrisologopablo48-lgtm/planta-briquetadora/entregas/R43/accesos/PLANOS_NATIVOS_ACCESOS.pdf

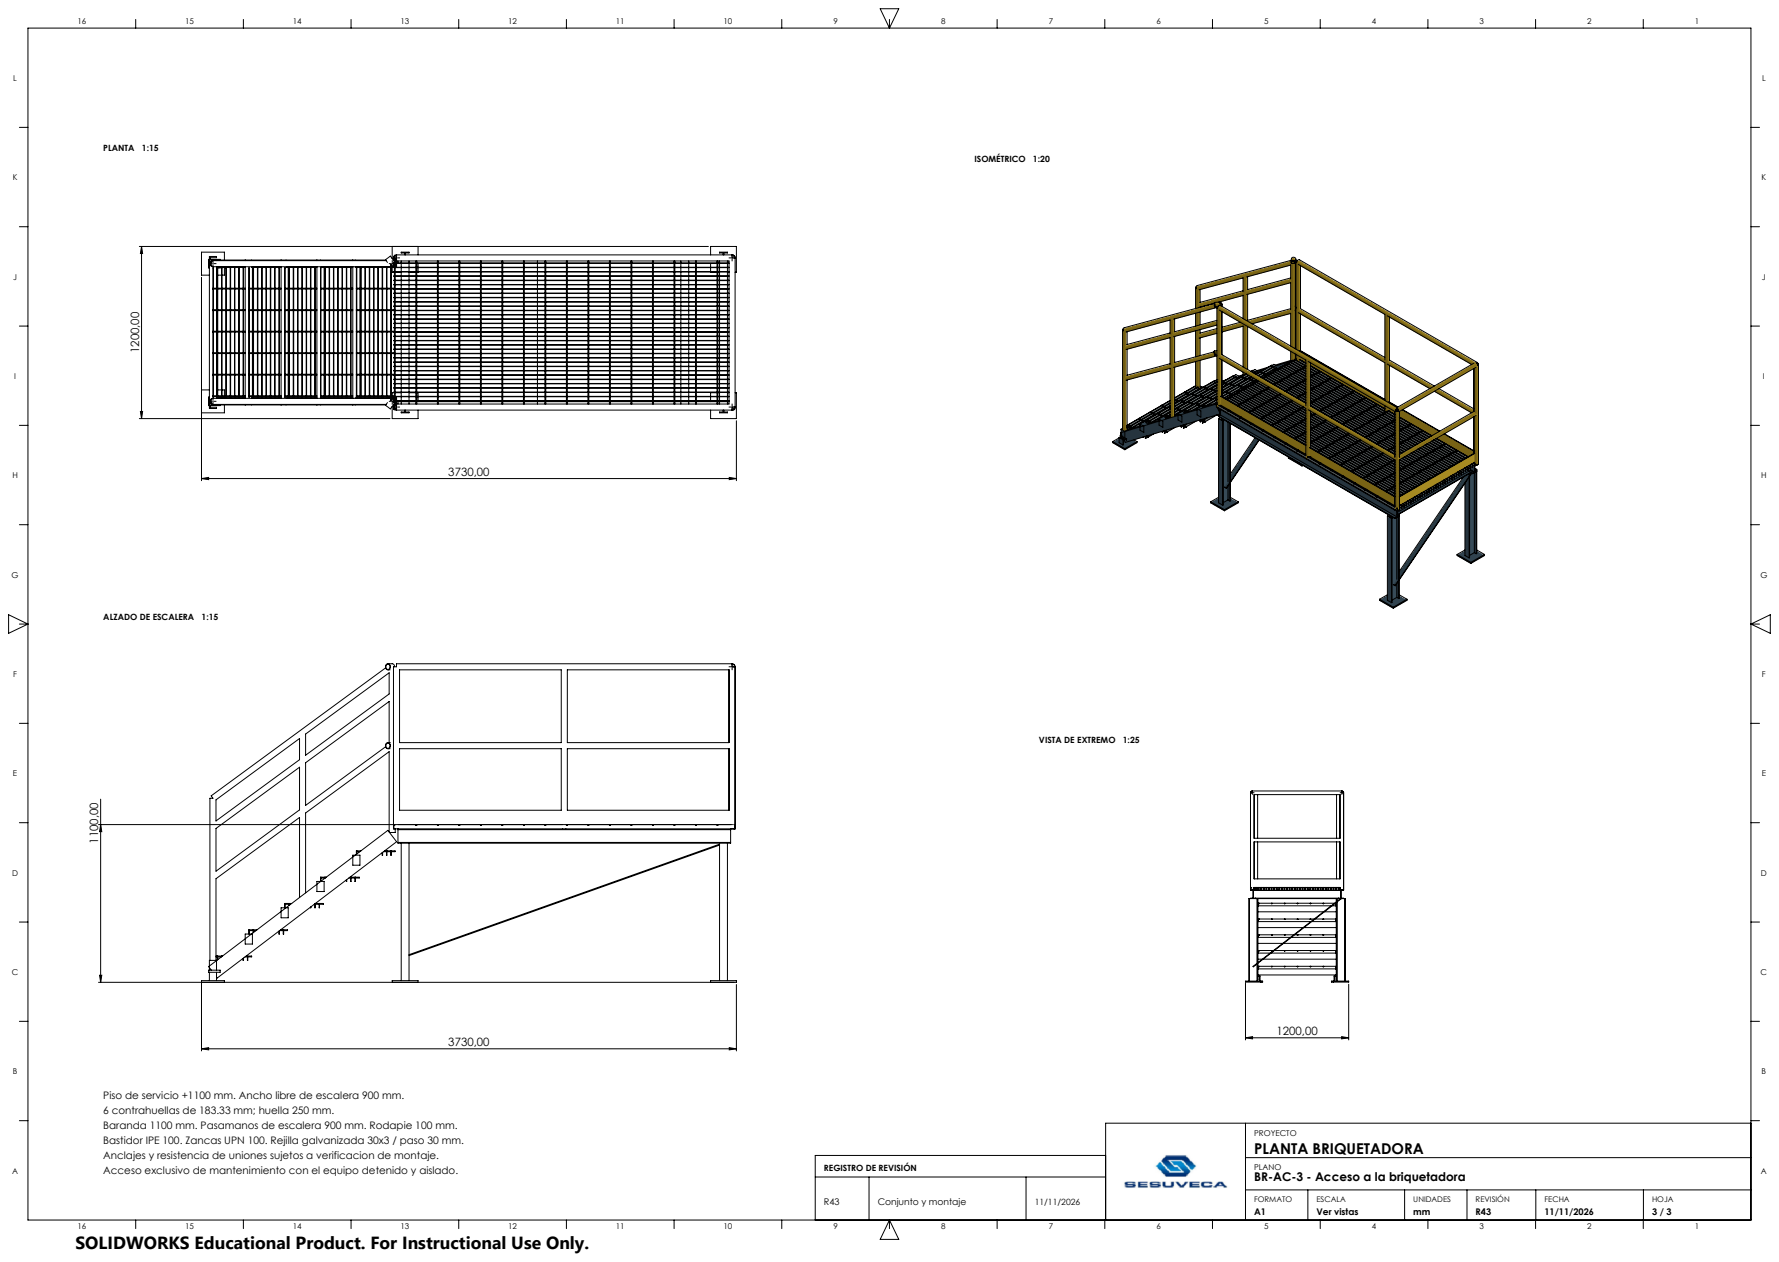
[picture p109: page 1]
PLANTA 1:15; ISOMÉTRICO 1:20; PLANO; FORMATO A1; ESCALA Ver vistas; UNIDADES mm; REVISIÓN R43; FECHA 11/11/2026; HOJA 3 / 3; Conjunto y montaje

ALZADO DE ESCALERA 1:15

VISTA DE EXTREMO 1:25

Piso de servicio +1100 mm. Ancho libre de escalera 900 mm.
6 contrahuellas de 183.33 mm; huella 250 mm.
Baranda 1100 mm. Pasamanos de escalera 900 mm. Rodapie 100 mm.
Bastidor IPE 100. Zancas UPN 100. Rejilla galvanizada 30x3 / paso 30 mm.
Anclajes y resistencia de uniones sujetos a verificacion de montaje.
Acceso exclusivo de mantenimiento con el equipo detenido y aislado.

PROYECTO
PLANTA BRIQUETADORA
BR-AC-3 - Acceso a la briquetadora

REGISTRO DE REVISIÓN

SOLIDWORKS Educational Product. For Instructional Use Only.

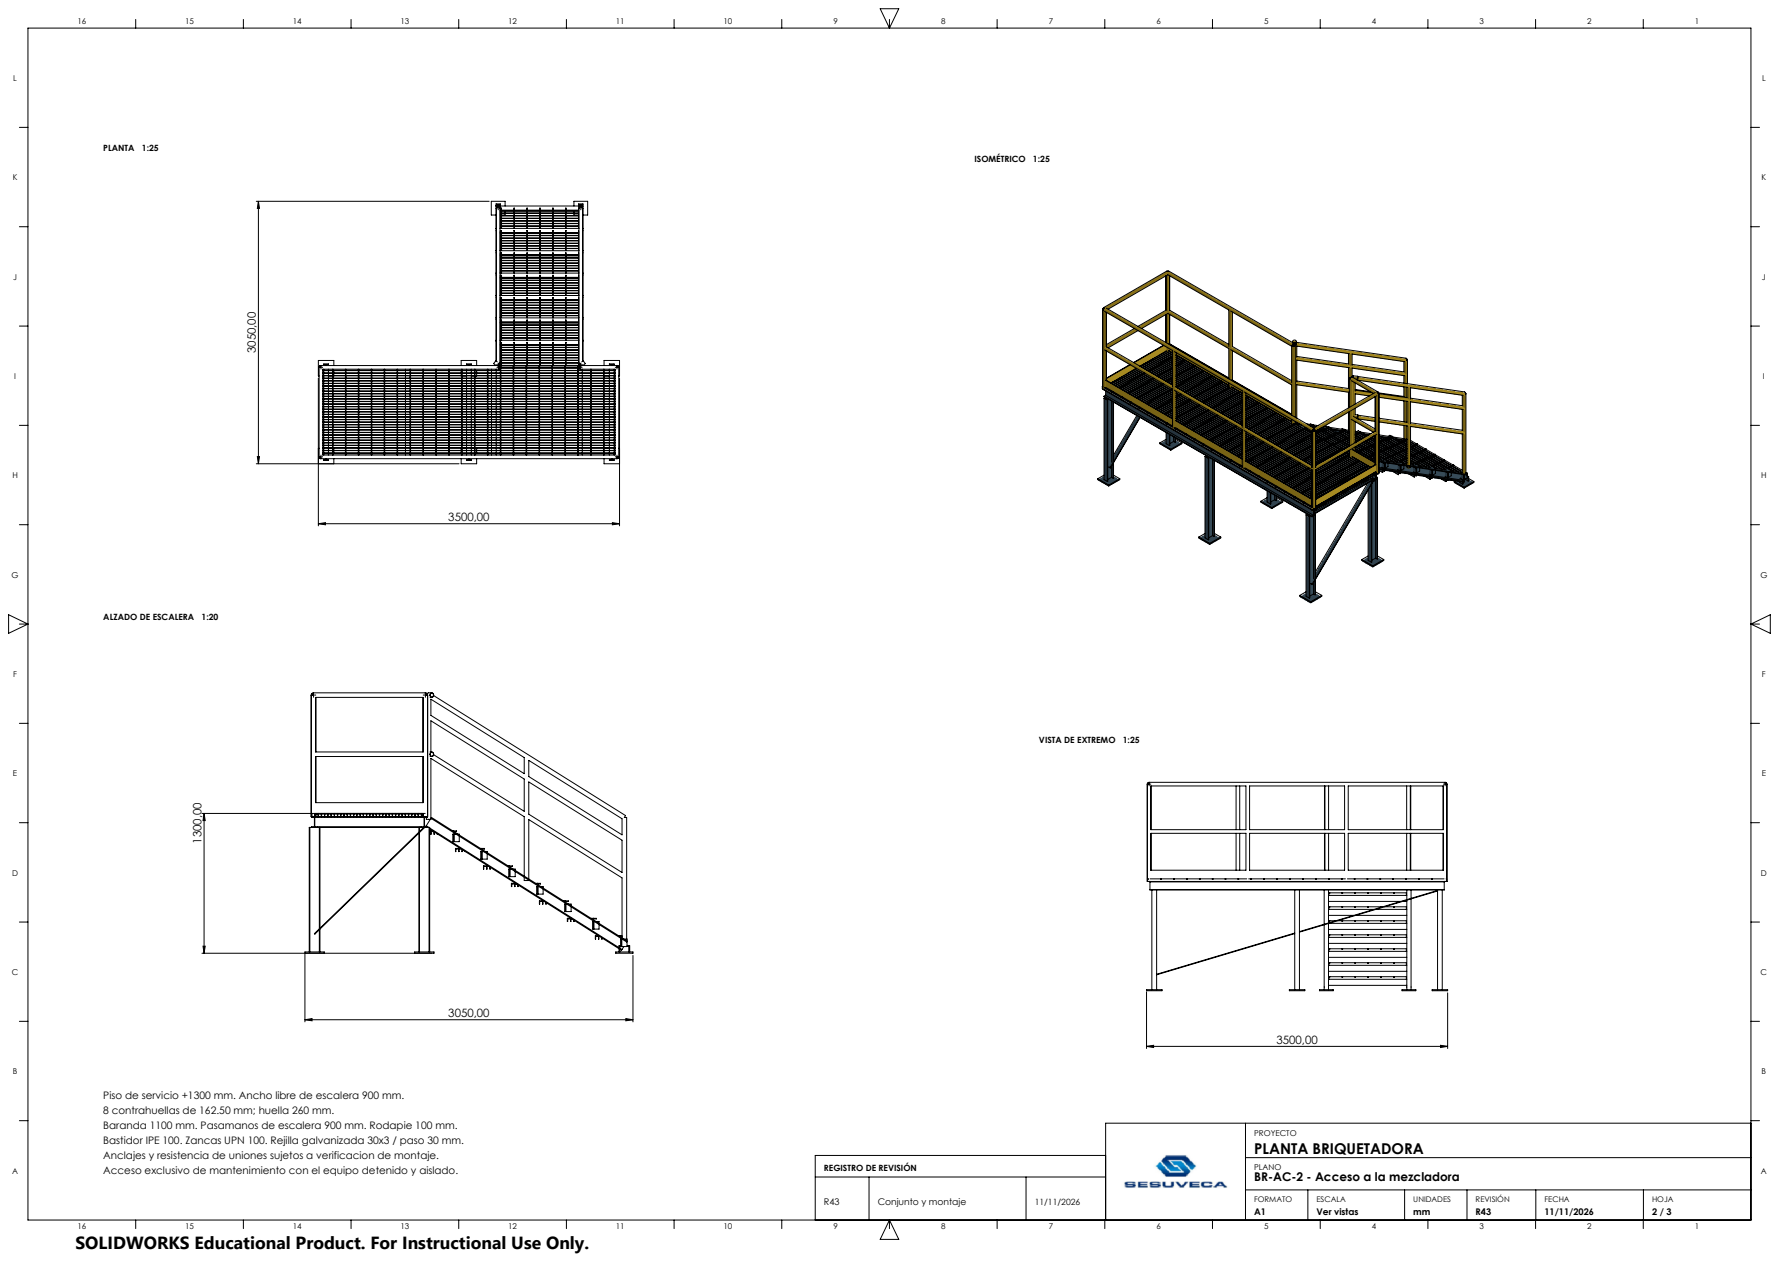
[picture p110: page 2]
PLANTA 1:25; ISOMÉTRICO 1:25

ALZADO DE ESCALERA 1:20

VISTA DE EXTREMO 1:25

Piso de servicio +1300 mm. Ancho libre de escalera 900 mm.
8 contrahuellas de 162.50 mm; huella 260 mm.
Baranda 1100 mm. Pasamanos de escalera 900 mm. Rodapie 100 mm.
Bastidor IPE 100. Zancas UPN 100. Rejilla galvanizada 30x3 / paso 30 mm.
Anclajes y resistencia de uniones sujetos a verificacion de montaje.

PROYECTO
PLANTA BRIQUETADORA
BR-AC-2 - Acceso a la mezcladora

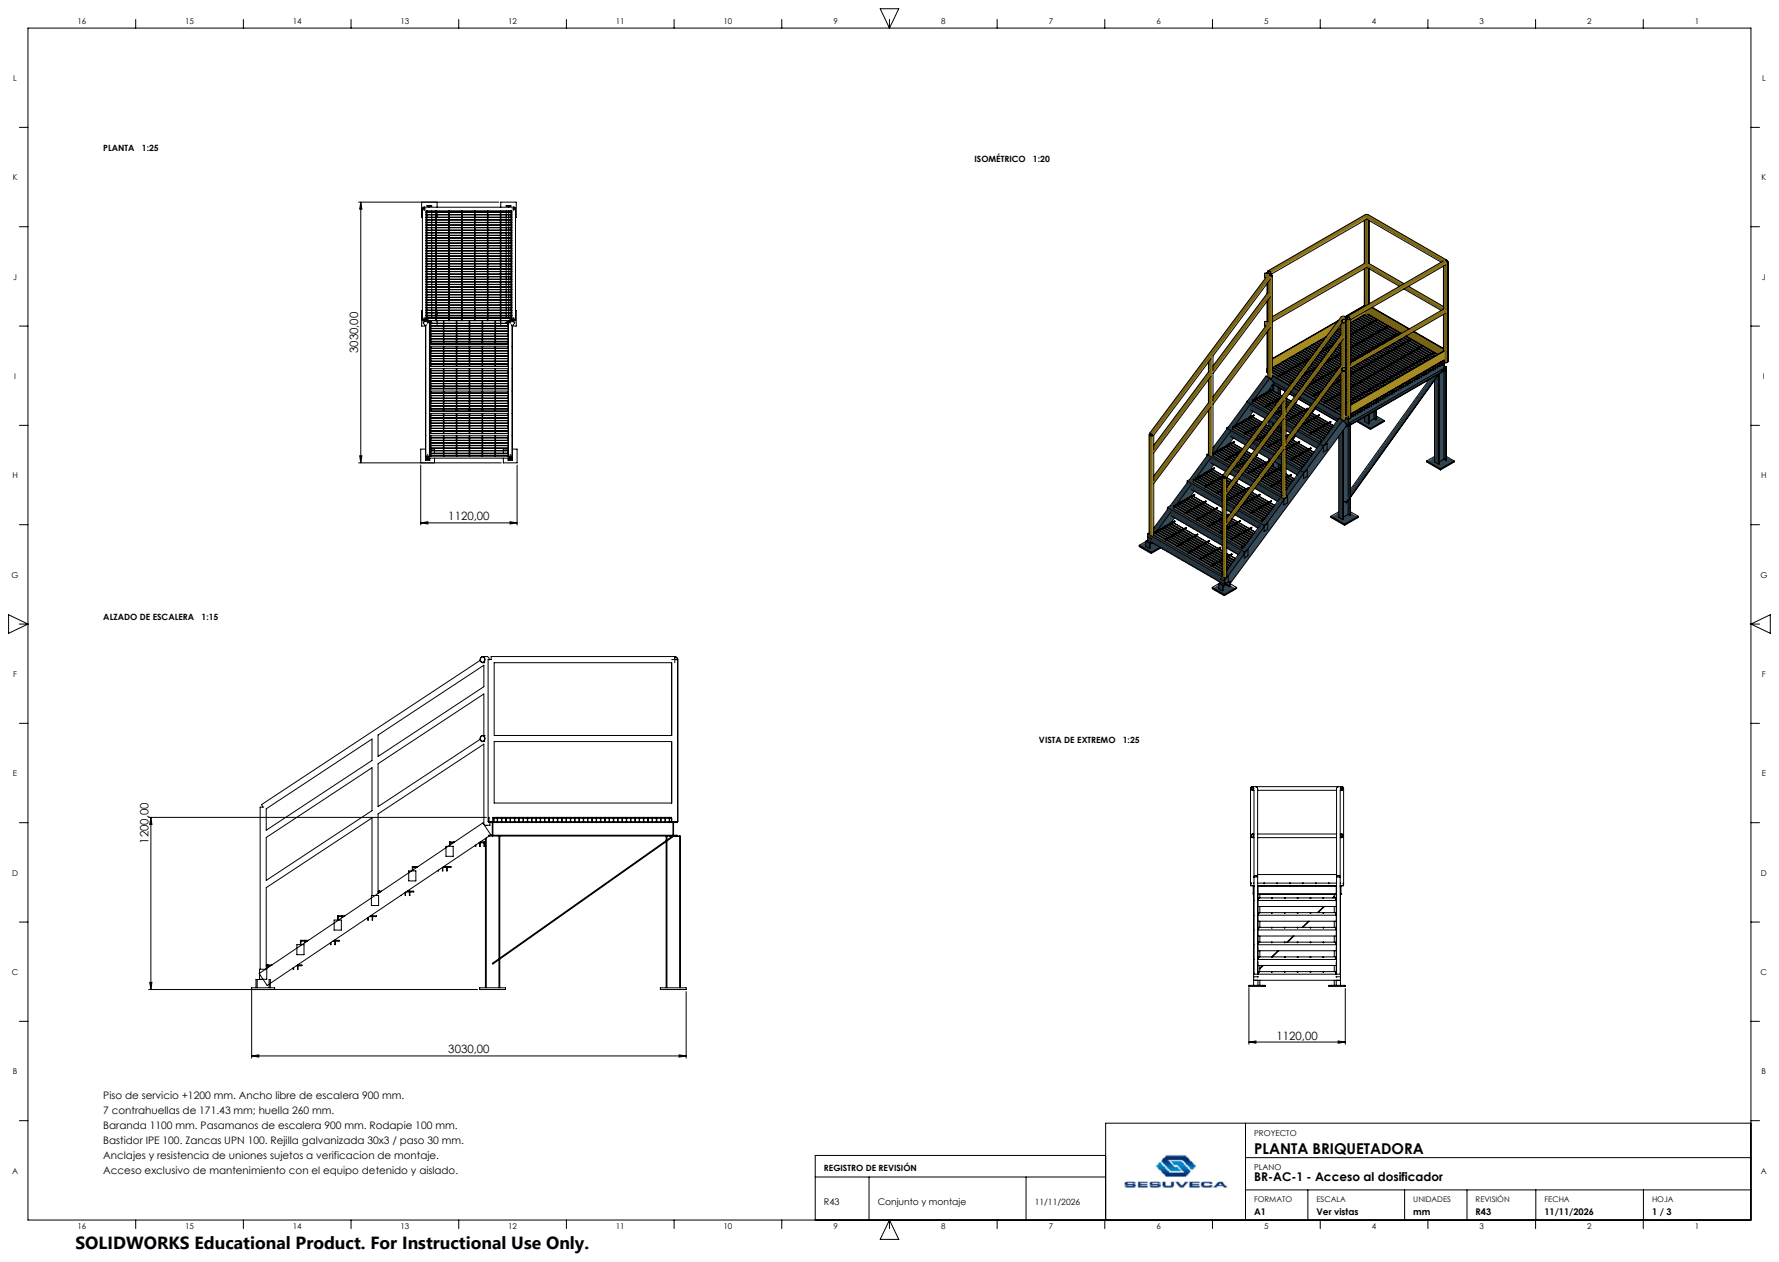
[picture p111: page 3]
PLANTA 1:25; ISOMÉTRICO 1:20

ALZADO DE ESCALERA 1:15

VISTA DE EXTREMO 1:25

Piso de servicio +1200 mm. Ancho libre de escalera 900 mm.
7 contrahuellas de 171.43 mm; huella 260 mm.
Baranda 1100 mm. Pasamanos de escalera 900 mm. Rodapie 100 mm.
Bastidor IPE 100. Zancas UPN 100. Rejilla galvanizada 30x3 / paso 30 mm.
Anclajes y resistencia de uniones sujetos a verificacion de montaje.

PROYECTO
PLANTA BRIQUETADORA
BR-AC-1 - Acceso al dosificador
