acevedocrisologopablo48-lgtm/planta-briquetadora/r20/DOSSIER_R20.pdf

# PLANTA BRIQUETADORA · SECADOR R20

## 01 · CARCASA OEM CERRADA, EQUIPO AL PISO Y AUXILIARES

Reconstrucción desde ficha y video del equipo. Medidas en mm. O documentado / P propuesto / R reconstruido.

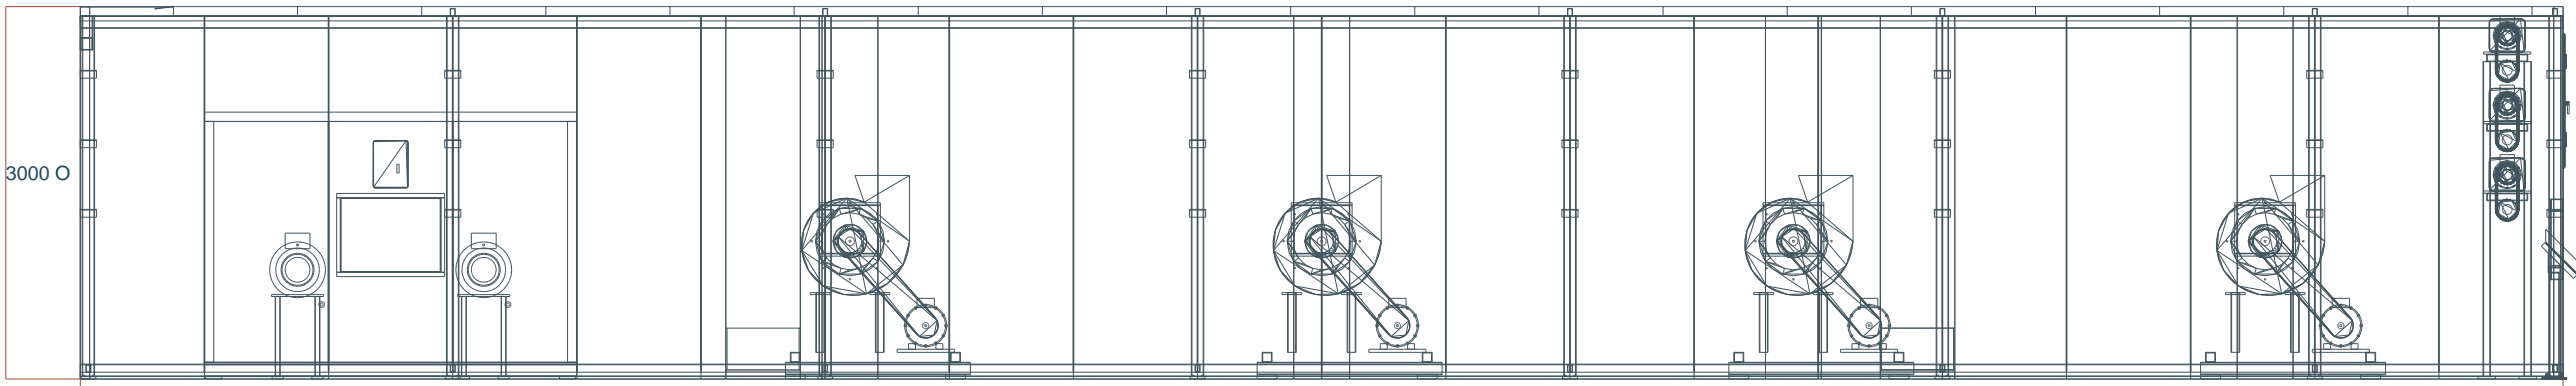
[picture p112: figure]

A1 horizontal · Fuentes: el secador.pdf y video(13).mp4 · Geometría para revisión; no aprobación de fabricación. | Hoja 1

## VISTA LATERAL · 1:50 · INTERIOR OCULTO

20000 O

## PLANTA · 1:50 · VENTILADORES Y CALENTADOR LATERALES

## FRENTE DE ENTRADA · 1:20

2800 O

Dato de ficha | Valor documentado O
Cuerpo | 20000 ×2800 ×3000
Transporte | 6 niveles / útil2500
Aislamiento | 75mm / lana mineral
Ventiladores | 4 ×15kW / soplado lateral
Accionamientos | 3 ×2,2kW
Calentador | 3000 ×1500 ×2150

Paneles lisos, juntas estrechas y dos registros bajos según foto; no se reproduce como textura permanente la película con rombos.

La carcasa se reconstruye completa. No se elevan el cuerpo ni sus patas; las cotas de bocas y apoyos de integración siguen siendo P/R.

## 02 · INTERIOR DE SEIS NIVELES Y TRANSMISIÓN EXTERIOR

Reconstrucción desde ficha y video del equipo. Medidas en mm. O documentado / P propuesto / R reconstruido.

A1 horizontal · Fuentes: el secador.pdf y video(13).mp4 · Geometría para revisión; no aprobación de fabricación. | Hoja 2

## BANDAS, RETORNOS, EJES Y TRANSFERENCIAS · 1:50

L1 +2850
L2 +2570
L3 +2290
L4 +2010
L5 +1730
L6 +1450

## EXTREMO DE BANDAS Y CADENAS · 1:10

Elemento | Ficha / reconstrucción
Banda útil | 2500mm O / inoxidable304 O
Malla fina | Abertura2mm O / hilo1mm O
Barras transversales | Paso100mm O / Ø12,7 R
Ejes de transporte | Ø80mm O
Base y pilares | RHS100×60×5 O
Travesaños | RHS60×40×3 O
Transferencias | Alternadas / paso280 y chutas P

Seis pisos conservados. Paso útil280mm y recorrido alternado son la solución de integración de planta; no se atribuyen al video como cotas.

Las cadenas y motorreductores se muestran en el extremo mecánico. El ensacado del video no pertenece al secador y se excluye.

La malla se representa mediante superficie visual y detalle ampliado, evitando modelar millones de hilos.

## 03 · ALIMENTADOR PROPIO Y ACOPLE DIRECTO AL NIVEL SUPERIOR

## ALIMENTADOR PROPIO · 1:25

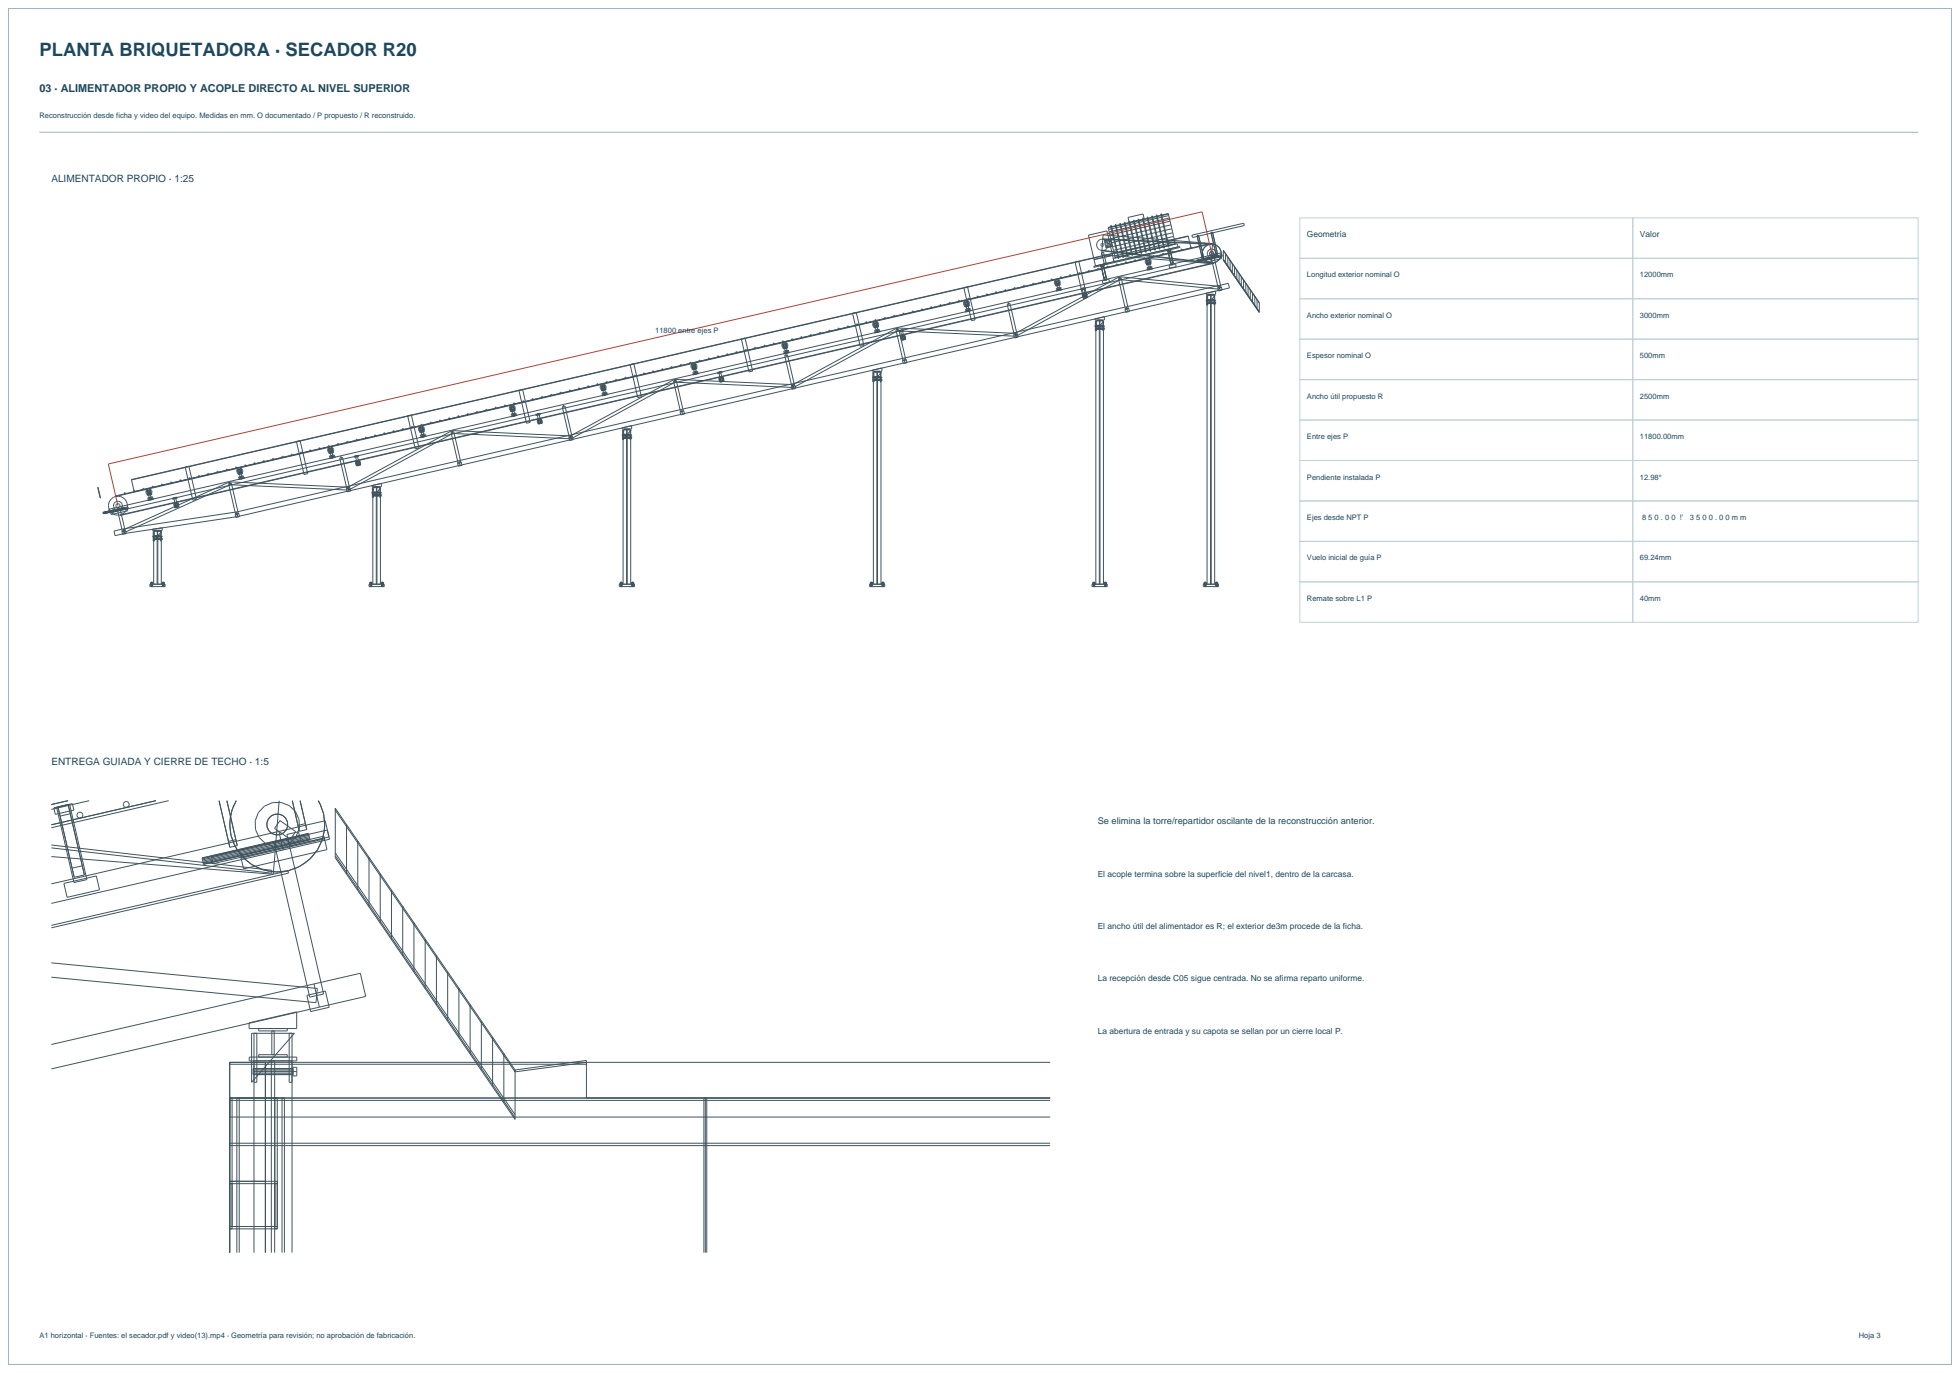
[picture p113: page 3]

Reconstrucción desde ficha y video del equipo. Medidas en mm. O documentado / P propuesto / R reconstruido.

ENTREGA GUIADA Y CIERRE DE TECHO · 1:5

Se elimina la torre/repartidor oscilante de la reconstrucción anterior.

El acople termina sobre la superficie del nivel1, dentro de la carcasa.

El ancho útil del alimentador es R; el exterior de3m procede de la ficha.

La recepción desde C05 sigue centrada. No se afirma reparto uniforme.

La abertura de entrada y su capota se sellan por un cierre local P.

## 04 · INTEGRACIÓN EN LA PLANTA Y COMPARACIÓN

## DISPOSICIÓN CON SECADOR · 1:100

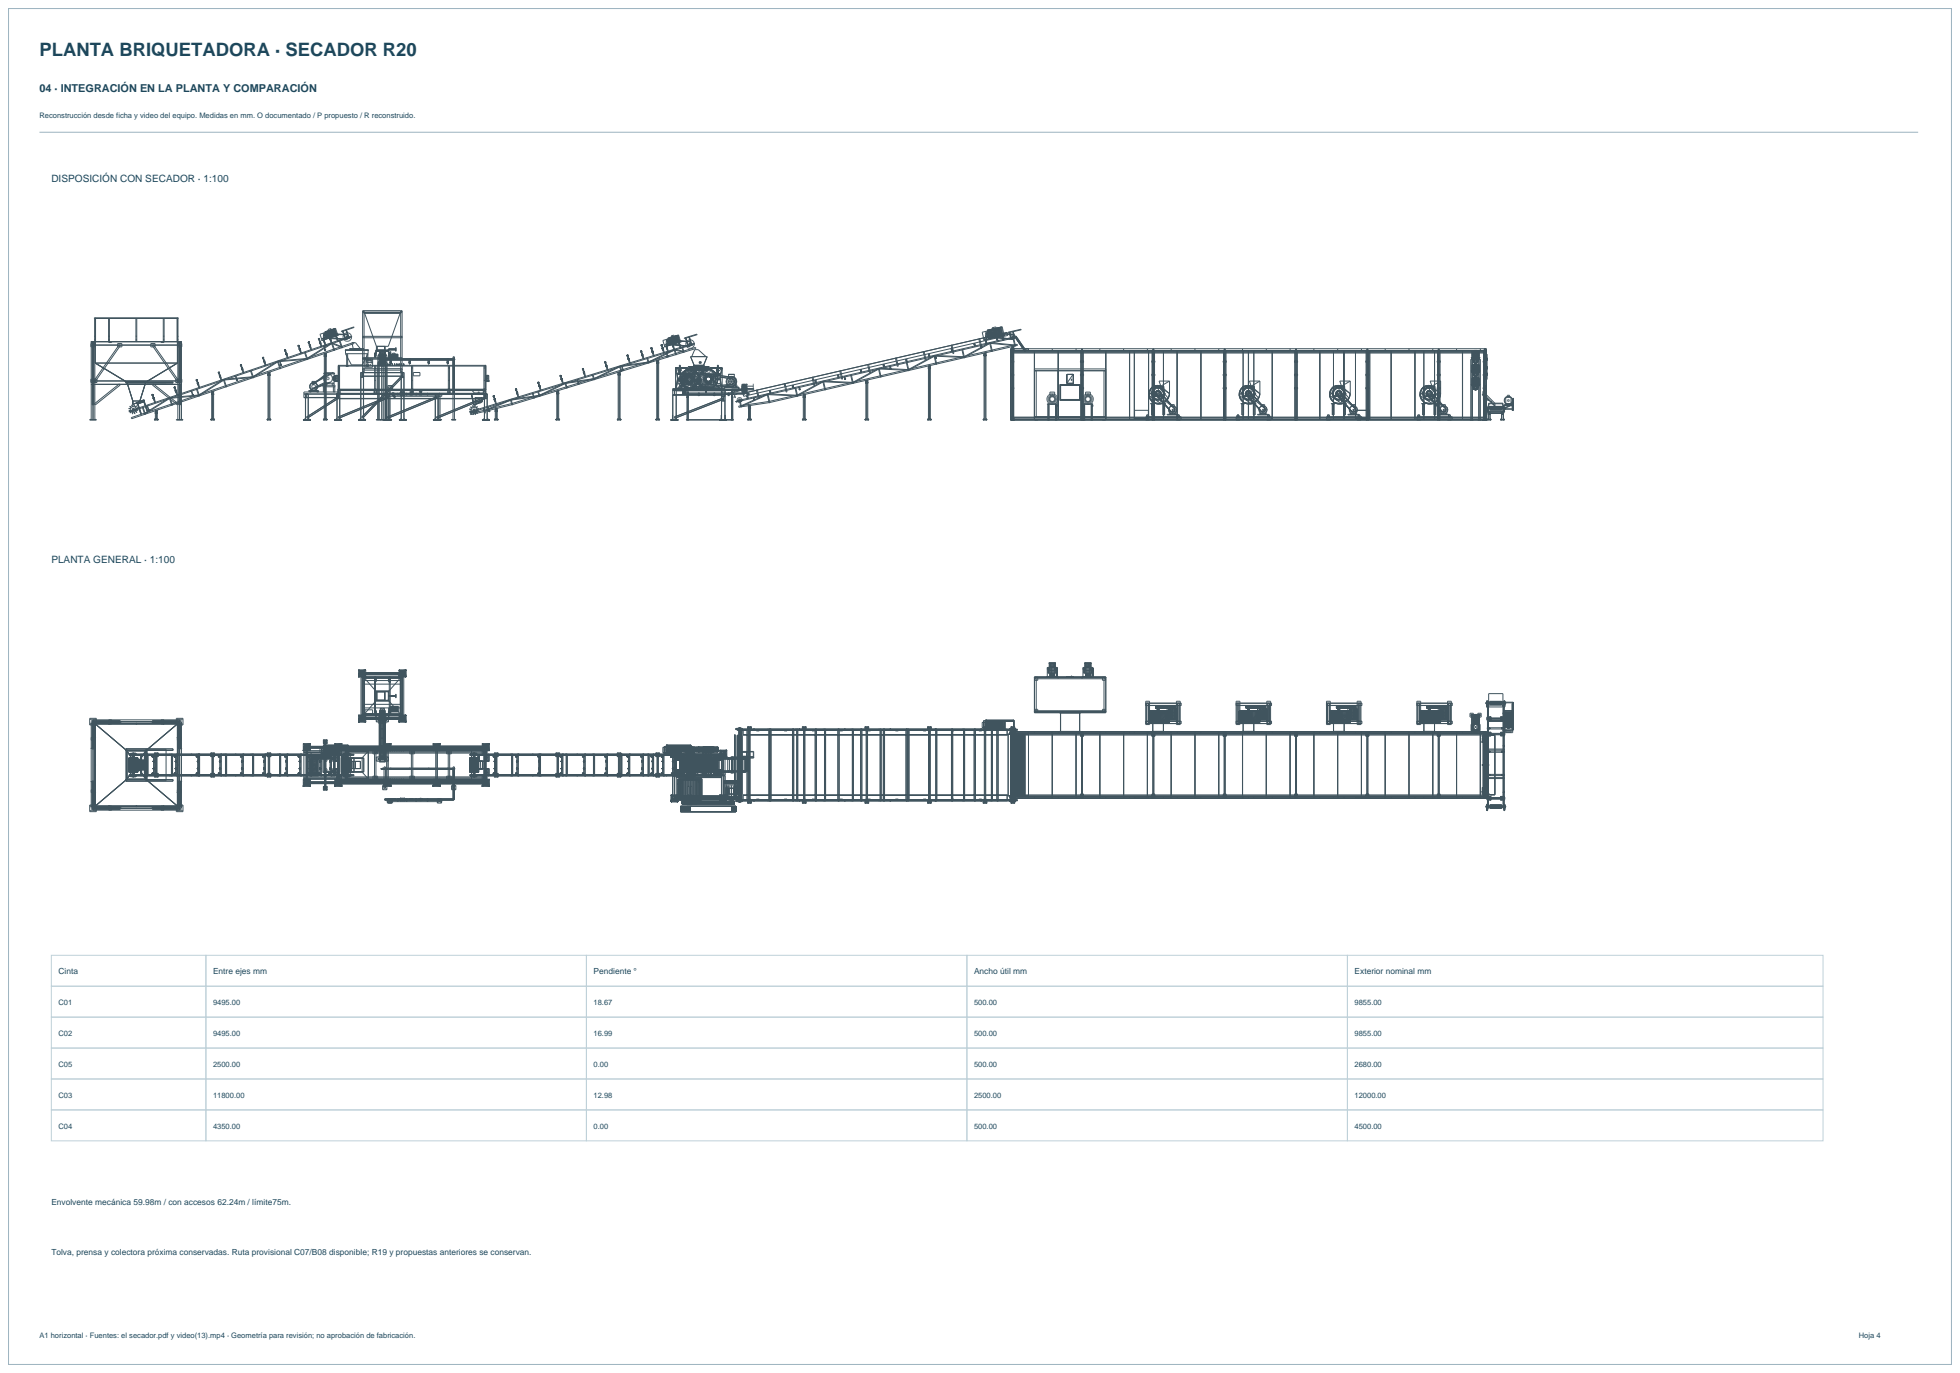
[picture p114: page 4]

Reconstrucción desde ficha y video del equipo. Medidas en mm. O documentado / P propuesto / R reconstruido.

Envolvente mecánica 59.98m / con accesos 62.24m / límite75m.

Tolva, prensa y colectora próxima conservadas. Ruta provisional C07/B08 disponible; R19 y propuestas anteriores se conservan.
