acevedocrisologopablo48-lgtm/planta-briquetadora/(commit log)

2026-10-05 Improve mixer, conveyor supports and interference-free R5 arrangement
2026-10-06 Publicar R6: estaciones mecánicas completas y acabado CAD industrial
2026-10-06 Stop downstream flow when either C01 feed is invalid
2026-10-07 R8: alternativas de aglomerante, consignas y simulación completa
2026-10-17 Publicar R10: precisión de briquetadora y agua medida
2026-10-17 R10 final: exportación legible y notas de agua completas
2026-10-18 Mejorar inspección aislada del túnel de recepción R13
2026-10-18 Publicar R15: interior de seis niveles, recepción amortiguada y biela-manivela
2026-10-18 Cerrar carpeta tecnica R16: BOM, planos y control disponibles en plataforma
2026-10-18 R17: refuerzos, despieces, BOM y control funcional
2026-10-19 R22: recuperar base original y adaptar paso local de C05
2026-10-30 R24: bloques de cotas nativas para exportacion DXF
2026-10-31 R26: propuesta independiente de recepcion suave y operacion coordinada
2026-11-03 R27: dosificador lateral, tolva abierta y retorno de finos
2026-11-03 R28: compactar alimentacion y redisenar retorno de finos
2026-11-04 R31: apoyos de patas abiertas para seis cintas
2026-11-10 R33 H frames, grizzly and prescribed fines return proposal
2026-11-10 Persist linked dimensions on R33 transfer assemblies
2026-11-10 Keep Pages artifact below size limit while preserving original CAD files
2026-11-10 Publish R36 photo-based mixer and proposed support frame
2026-11-10 Enable material simulation on the R36 reference
2026-11-10 Publish R37 GX-20x6 dryer and corrected conveyor transfer
2026-11-10 Publish R38 compact conveyor and machine supports
2026-11-10 Publish R39 conveyor transfer and support corrections
2026-11-10 R41 transportadores de retorno modulares y polines de carga y retorno
2026-11-11 Actualiza la descarga de planos con cajetin A0 e isometria
2026-11-11 R42 carga independiente de briquetas al minidumper
2026-11-11 Ajusta la guia de carga para librar el borde de la caja
2026-11-11 R43: cargadora a 16 grados y planos de soportes por cinta
2026-11-11 Separa plano general y planos de cintas R43
2026-11-11 Completa acotado y detalles constructivos de cintas R43
2026-11-12 Incorpora accesos de mantenimiento verificados en SolidWorks y descargas R43
2026-11-12 Conserva referencias de acotado de conjuntos anteriores
2026-11-13 Amplia acceso de mezcladora hasta motor con respaldo SolidWorks
2026-11-13 R45 soporte fijo de big bag con Manitou y escalera compartida
